rsef899/12_Cypress_LineFollowingRobot/Robert/Hardware_Task1.cydsn/Hardware_Task1_timing.html

# Static Timing Analysis

Project : | Hardware_Task1
Build Time : | 08/04/23 16:27:02
Device : | CY8C5888LTI-LP097
Temperature : | -40C - 85/125C
VDDA : | 5.00
VDDABUF : | 5.00
VDDD : | 5.00
VDDIO0 : | 5.00
VDDIO1 : | 5.00
VDDIO2 : | 5.00
VDDIO3 : | 5.00
VUSB : | 5.00
Voltage : | 5.0

Expand All | Collapse All | Show All Paths | Hide All Paths

+ Timing Violation Section

Note: If your design will only ever run at typical room temperatures, selecting the narrower temperature range in the system DWR for your application helps the tool to find timing-compliant routing solutions.

Violation | Source Clock | Destination Clock | Slack(ns)
Async
| ClockBlock/dclk_glb_ff_3 | ADC_IntClock

+ Clock Summary Section

Clock | Domain | Nominal Frequency | Required Frequency | Maximum Frequency | Violation
ADC_IntClock(routed) | ADC_IntClock(routed) | 2.857 MHz | 2.857 MHz | N/A
ClockBlock/dclk_glb_ff_2 | ClockBlock/dclk_glb_ff_2 | UNKNOWN | UNKNOWN | N/A
ClockBlock/dclk_glb_ff_3 | ClockBlock/dclk_glb_ff_3 | UNKNOWN | UNKNOWN | N/A
CyILO | CyILO | 100.000 kHz | 100.000 kHz | N/A
CyIMO | CyIMO | 24.000 MHz | 24.000 MHz | N/A
CyMASTER_CLK | CyMASTER_CLK | 60.000 MHz | 60.000 MHz | N/A
CyBUS_CLK | CyMASTER_CLK | 60.000 MHz | 60.000 MHz | 65.087 MHz
Clock_QENC | CyMASTER_CLK | 12.000 MHz | 12.000 MHz | 30.466 MHz
ADC_IntClock | CyMASTER_CLK | 2.857 MHz | 2.857 MHz | 24.925 MHz
Clock_PWM | CyMASTER_CLK | 1.000 MHz | 1.000 MHz | N/A
UART_IntClock | CyMASTER_CLK | 461.538 kHz | 461.538 kHz | 52.260 MHz
Clock2 | CyMASTER_CLK | 500.000 kHz | 500.000 kHz | N/A
CyPLL_OUT | CyPLL_OUT | 60.000 MHz | 60.000 MHz | N/A

+ Register to Register Section

+ Setup Subsection

+ Source Clock : ADC_IntClock : Positive edge(Required Frequency 2.85714 MHz)

+ Destination Clock : ADC_IntClock : Positive edge(Required Frequency 2.85714 MHz)

Path Delay Requirement : 350ns(2.85714 MHz)

Source | Destination | FMax | Delay (ns) | Slack (ns) | Violation
\ADC:AMuxHw_2_Decoder_old_id_0\/q | \ADC:AMuxHw_2_Decoder_one_hot_7\/main_0 | 24.925 MHz | 40.121 | 309.879

Type | Location | Fanout | Instance/Net | Source | Dest | Delay (ns)
macrocell74 | U(1,5) | 1 | \ADC:AMuxHw_2_Decoder_old_id_0\ | \ADC:AMuxHw_2_Decoder_old_id_0\/clock_0 | \ADC:AMuxHw_2_Decoder_old_id_0\/q | 1.250
Route | | 1 | \ADC:AMuxHw_2_Decoder_old_id_0\ | \ADC:AMuxHw_2_Decoder_old_id_0\/q | \ADC:AMuxHw_2_Decoder_is_active_split\/main_10 | 10.051
macrocell46 | U(1,1) | 1 | \ADC:AMuxHw_2_Decoder_is_active_split\ | \ADC:AMuxHw_2_Decoder_is_active_split\/main_10 | \ADC:AMuxHw_2_Decoder_is_active_split\/q | 3.350
Route | | 1 | \ADC:AMuxHw_2_Decoder_is_active_split\ | \ADC:AMuxHw_2_Decoder_is_active_split\/q | \ADC:AMuxHw_2_Decoder_is_active\/main_8 | 4.399
macrocell18 | U(1,4) | 1 | \ADC:AMuxHw_2_Decoder_is_active\ | \ADC:AMuxHw_2_Decoder_is_active\/main_8 | \ADC:AMuxHw_2_Decoder_is_active\/q | 3.350
Route | | 1 | \ADC:AMuxHw_2_Decoder_is_active\ | \ADC:AMuxHw_2_Decoder_is_active\/q | \ADC:AMuxHw_2_Decoder_one_hot_7\/main_0 | 14.211
macrocell82 | U(3,1) | 1 | \ADC:AMuxHw_2_Decoder_one_hot_7\ | | SETUP | 3.510
Clock | | | | | Skew | 0.000
\ADC:AMuxHw_2_Decoder_old_id_0\/q | \ADC:AMuxHw_2_Decoder_one_hot_17\/main_0 | 24.925 MHz | 40.121 | 309.879

Type | Location | Fanout | Instance/Net | Source | Dest | Delay (ns)
macrocell74 | U(1,5) | 1 | \ADC:AMuxHw_2_Decoder_old_id_0\ | \ADC:AMuxHw_2_Decoder_old_id_0\/clock_0 | \ADC:AMuxHw_2_Decoder_old_id_0\/q | 1.250
Route | | 1 | \ADC:AMuxHw_2_Decoder_old_id_0\ | \ADC:AMuxHw_2_Decoder_old_id_0\/q | \ADC:AMuxHw_2_Decoder_is_active_split\/main_10 | 10.051
macrocell46 | U(1,1) | 1 | \ADC:AMuxHw_2_Decoder_is_active_split\ | \ADC:AMuxHw_2_Decoder_is_active_split\/main_10 | \ADC:AMuxHw_2_Decoder_is_active_split\/q | 3.350
Route | | 1 | \ADC:AMuxHw_2_Decoder_is_active_split\ | \ADC:AMuxHw_2_Decoder_is_active_split\/q | \ADC:AMuxHw_2_Decoder_is_active\/main_8 | 4.399
macrocell18 | U(1,4) | 1 | \ADC:AMuxHw_2_Decoder_is_active\ | \ADC:AMuxHw_2_Decoder_is_active\/main_8 | \ADC:AMuxHw_2_Decoder_is_active\/q | 3.350
Route | | 1 | \ADC:AMuxHw_2_Decoder_is_active\ | \ADC:AMuxHw_2_Decoder_is_active\/q | \ADC:AMuxHw_2_Decoder_one_hot_17\/main_0 | 14.211
macrocell92 | U(3,1) | 1 | \ADC:AMuxHw_2_Decoder_one_hot_17\ | | SETUP | 3.510
Clock | | | | | Skew | 0.000
\ADC:AMuxHw_2_Decoder_old_id_0\/q | \ADC:AMuxHw_2_Decoder_one_hot_32\/main_0 | 24.925 MHz | 40.121 | 309.879

Type | Location | Fanout | Instance/Net | Source | Dest | Delay (ns)
macrocell74 | U(1,5) | 1 | \ADC:AMuxHw_2_Decoder_old_id_0\ | \ADC:AMuxHw_2_Decoder_old_id_0\/clock_0 | \ADC:AMuxHw_2_Decoder_old_id_0\/q | 1.250
Route | | 1 | \ADC:AMuxHw_2_Decoder_old_id_0\ | \ADC:AMuxHw_2_Decoder_old_id_0\/q | \ADC:AMuxHw_2_Decoder_is_active_split\/main_10 | 10.051
macrocell46 | U(1,1) | 1 | \ADC:AMuxHw_2_Decoder_is_active_split\ | \ADC:AMuxHw_2_Decoder_is_active_split\/main_10 | \ADC:AMuxHw_2_Decoder_is_active_split\/q | 3.350
Route | | 1 | \ADC:AMuxHw_2_Decoder_is_active_split\ | \ADC:AMuxHw_2_Decoder_is_active_split\/q | \ADC:AMuxHw_2_Decoder_is_active\/main_8 | 4.399
macrocell18 | U(1,4) | 1 | \ADC:AMuxHw_2_Decoder_is_active\ | \ADC:AMuxHw_2_Decoder_is_active\/main_8 | \ADC:AMuxHw_2_Decoder_is_active\/q | 3.350
Route | | 1 | \ADC:AMuxHw_2_Decoder_is_active\ | \ADC:AMuxHw_2_Decoder_is_active\/q | \ADC:AMuxHw_2_Decoder_one_hot_32\/main_0 | 14.211
macrocell107 | U(3,1) | 1 | \ADC:AMuxHw_2_Decoder_one_hot_32\ | | SETUP | 3.510
Clock | | | | | Skew | 0.000
\ADC:AMuxHw_2_Decoder_old_id_0\/q | \ADC:AMuxHw_2_Decoder_one_hot_4\/main_0 | 24.936 MHz | 40.102 | 309.898

Type | Location | Fanout | Instance/Net | Source | Dest | Delay (ns)
macrocell74 | U(1,5) | 1 | \ADC:AMuxHw_2_Decoder_old_id_0\ | \ADC:AMuxHw_2_Decoder_old_id_0\/clock_0 | \ADC:AMuxHw_2_Decoder_old_id_0\/q | 1.250
Route | | 1 | \ADC:AMuxHw_2_Decoder_old_id_0\ | \ADC:AMuxHw_2_Decoder_old_id_0\/q | \ADC:AMuxHw_2_Decoder_is_active_split\/main_10 | 10.051
macrocell46 | U(1,1) | 1 | \ADC:AMuxHw_2_Decoder_is_active_split\ | \ADC:AMuxHw_2_Decoder_is_active_split\/main_10 | \ADC:AMuxHw_2_Decoder_is_active_split\/q | 3.350
Route | | 1 | \ADC:AMuxHw_2_Decoder_is_active_split\ | \ADC:AMuxHw_2_Decoder_is_active_split\/q | \ADC:AMuxHw_2_Decoder_is_active\/main_8 | 4.399
macrocell18 | U(1,4) | 1 | \ADC:AMuxHw_2_Decoder_is_active\ | \ADC:AMuxHw_2_Decoder_is_active\/main_8 | \ADC:AMuxHw_2_Decoder_is_active\/q | 3.350
Route | | 1 | \ADC:AMuxHw_2_Decoder_is_active\ | \ADC:AMuxHw_2_Decoder_is_active\/q | \ADC:AMuxHw_2_Decoder_one_hot_4\/main_0 | 14.192
macrocell79 | U(3,1) | 1 | \ADC:AMuxHw_2_Decoder_one_hot_4\ | | SETUP | 3.510
Clock | | | | | Skew | 0.000
\ADC:AMuxHw_2_Decoder_old_id_0\/q | \ADC:AMuxHw_2_Decoder_one_hot_13\/main_0 | 24.936 MHz | 40.102 | 309.898

Type | Location | Fanout | Instance/Net | Source | Dest | Delay (ns)
macrocell74 | U(1,5) | 1 | \ADC:AMuxHw_2_Decoder_old_id_0\ | \ADC:AMuxHw_2_Decoder_old_id_0\/clock_0 | \ADC:AMuxHw_2_Decoder_old_id_0\/q | 1.250
Route | | 1 | \ADC:AMuxHw_2_Decoder_old_id_0\ | \ADC:AMuxHw_2_Decoder_old_id_0\/q | \ADC:AMuxHw_2_Decoder_is_active_split\/main_10 | 10.051
macrocell46 | U(1,1) | 1 | \ADC:AMuxHw_2_Decoder_is_active_split\ | \ADC:AMuxHw_2_Decoder_is_active_split\/main_10 | \ADC:AMuxHw_2_Decoder_is_active_split\/q | 3.350
Route | | 1 | \ADC:AMuxHw_2_Decoder_is_active_split\ | \ADC:AMuxHw_2_Decoder_is_active_split\/q | \ADC:AMuxHw_2_Decoder_is_active\/main_8 | 4.399
macrocell18 | U(1,4) | 1 | \ADC:AMuxHw_2_Decoder_is_active\ | \ADC:AMuxHw_2_Decoder_is_active\/main_8 | \ADC:AMuxHw_2_Decoder_is_active\/q | 3.350
Route | | 1 | \ADC:AMuxHw_2_Decoder_is_active\ | \ADC:AMuxHw_2_Decoder_is_active\/q | \ADC:AMuxHw_2_Decoder_one_hot_13\/main_0 | 14.192
macrocell88 | U(3,1) | 1 | \ADC:AMuxHw_2_Decoder_one_hot_13\ | | SETUP | 3.510
Clock | | | | | Skew | 0.000
\ADC:AMuxHw_2_Decoder_old_id_0\/q | \ADC:AMuxHw_2_Decoder_one_hot_28\/main_0 | 24.936 MHz | 40.102 | 309.898

Type | Location | Fanout | Instance/Net | Source | Dest | Delay (ns)
macrocell74 | U(1,5) | 1 | \ADC:AMuxHw_2_Decoder_old_id_0\ | \ADC:AMuxHw_2_Decoder_old_id_0\/clock_0 | \ADC:AMuxHw_2_Decoder_old_id_0\/q | 1.250
Route | | 1 | \ADC:AMuxHw_2_Decoder_old_id_0\ | \ADC:AMuxHw_2_Decoder_old_id_0\/q | \ADC:AMuxHw_2_Decoder_is_active_split\/main_10 | 10.051
macrocell46 | U(1,1) | 1 | \ADC:AMuxHw_2_Decoder_is_active_split\ | \ADC:AMuxHw_2_Decoder_is_active_split\/main_10 | \ADC:AMuxHw_2_Decoder_is_active_split\/q | 3.350
Route | | 1 | \ADC:AMuxHw_2_Decoder_is_active_split\ | \ADC:AMuxHw_2_Decoder_is_active_split\/q | \ADC:AMuxHw_2_Decoder_is_active\/main_8 | 4.399
macrocell18 | U(1,4) | 1 | \ADC:AMuxHw_2_Decoder_is_active\ | \ADC:AMuxHw_2_Decoder_is_active\/main_8 | \ADC:AMuxHw_2_Decoder_is_active\/q | 3.350
Route | | 1 | \ADC:AMuxHw_2_Decoder_is_active\ | \ADC:AMuxHw_2_Decoder_is_active\/q | \ADC:AMuxHw_2_Decoder_one_hot_28\/main_0 | 14.192
macrocell103 | U(3,1) | 1 | \ADC:AMuxHw_2_Decoder_one_hot_28\ | | SETUP | 3.510
Clock | | | | | Skew | 0.000
\ADC:AMuxHw_2_Decoder_old_id_0\/q | \ADC:AMuxHw_2_Decoder_one_hot_38\/main_0 | 24.936 MHz | 40.102 | 309.898

Type | Location | Fanout | Instance/Net | Source | Dest | Delay (ns)
macrocell74 | U(1,5) | 1 | \ADC:AMuxHw_2_Decoder_old_id_0\ | \ADC:AMuxHw_2_Decoder_old_id_0\/clock_0 | \ADC:AMuxHw_2_Decoder_old_id_0\/q | 1.250
Route | | 1 | \ADC:AMuxHw_2_Decoder_old_id_0\ | \ADC:AMuxHw_2_Decoder_old_id_0\/q | \ADC:AMuxHw_2_Decoder_is_active_split\/main_10 | 10.051
macrocell46 | U(1,1) | 1 | \ADC:AMuxHw_2_Decoder_is_active_split\ | \ADC:AMuxHw_2_Decoder_is_active_split\/main_10 | \ADC:AMuxHw_2_Decoder_is_active_split\/q | 3.350
Route | | 1 | \ADC:AMuxHw_2_Decoder_is_active_split\ | \ADC:AMuxHw_2_Decoder_is_active_split\/q | \ADC:AMuxHw_2_Decoder_is_active\/main_8 | 4.399
macrocell18 | U(1,4) | 1 | \ADC:AMuxHw_2_Decoder_is_active\ | \ADC:AMuxHw_2_Decoder_is_active\/main_8 | \ADC:AMuxHw_2_Decoder_is_active\/q | 3.350
Route | | 1 | \ADC:AMuxHw_2_Decoder_is_active\ | \ADC:AMuxHw_2_Decoder_is_active\/q | \ADC:AMuxHw_2_Decoder_one_hot_38\/main_0 | 14.192
macrocell113 | U(3,1) | 1 | \ADC:AMuxHw_2_Decoder_one_hot_38\ | | SETUP | 3.510
Clock | | | | | Skew | 0.000
\ADC:AMuxHw_2_Decoder_old_id_3\/q | \ADC:AMuxHw_2_Decoder_one_hot_7\/main_0 | 25.515 MHz | 39.193 | 310.807

Type | Location | Fanout | Instance/Net | Source | Dest | Delay (ns)
macrocell71 | U(1,4) | 1 | \ADC:AMuxHw_2_Decoder_old_id_3\ | \ADC:AMuxHw_2_Decoder_old_id_3\/clock_0 | \ADC:AMuxHw_2_Decoder_old_id_3\/q | 1.250
Route | | 1 | \ADC:AMuxHw_2_Decoder_old_id_3\ | \ADC:AMuxHw_2_Decoder_old_id_3\/q | \ADC:AMuxHw_2_Decoder_is_active_split\/main_4 | 9.123
macrocell46 | U(1,1) | 1 | \ADC:AMuxHw_2_Decoder_is_active_split\ | \ADC:AMuxHw_2_Decoder_is_active_split\/main_4 | \ADC:AMuxHw_2_Decoder_is_active_split\/q | 3.350
Route | | 1 | \ADC:AMuxHw_2_Decoder_is_active_split\ | \ADC:AMuxHw_2_Decoder_is_active_split\/q | \ADC:AMuxHw_2_Decoder_is_active\/main_8 | 4.399
macrocell18 | U(1,4) | 1 | \ADC:AMuxHw_2_Decoder_is_active\ | \ADC:AMuxHw_2_Decoder_is_active\/main_8 | \ADC:AMuxHw_2_Decoder_is_active\/q | 3.350
Route | | 1 | \ADC:AMuxHw_2_Decoder_is_active\ | \ADC:AMuxHw_2_Decoder_is_active\/q | \ADC:AMuxHw_2_Decoder_one_hot_7\/main_0 | 14.211
macrocell82 | U(3,1) | 1 | \ADC:AMuxHw_2_Decoder_one_hot_7\ | | SETUP | 3.510
Clock | | | | | Skew | 0.000
\ADC:AMuxHw_2_Decoder_old_id_3\/q | \ADC:AMuxHw_2_Decoder_one_hot_17\/main_0 | 25.515 MHz | 39.193 | 310.807

Type | Location | Fanout | Instance/Net | Source | Dest | Delay (ns)
macrocell71 | U(1,4) | 1 | \ADC:AMuxHw_2_Decoder_old_id_3\ | \ADC:AMuxHw_2_Decoder_old_id_3\/clock_0 | \ADC:AMuxHw_2_Decoder_old_id_3\/q | 1.250
Route | | 1 | \ADC:AMuxHw_2_Decoder_old_id_3\ | \ADC:AMuxHw_2_Decoder_old_id_3\/q | \ADC:AMuxHw_2_Decoder_is_active_split\/main_4 | 9.123
macrocell46 | U(1,1) | 1 | \ADC:AMuxHw_2_Decoder_is_active_split\ | \ADC:AMuxHw_2_Decoder_is_active_split\/main_4 | \ADC:AMuxHw_2_Decoder_is_active_split\/q | 3.350
Route | | 1 | \ADC:AMuxHw_2_Decoder_is_active_split\ | \ADC:AMuxHw_2_Decoder_is_active_split\/q | \ADC:AMuxHw_2_Decoder_is_active\/main_8 | 4.399
macrocell18 | U(1,4) | 1 | \ADC:AMuxHw_2_Decoder_is_active\ | \ADC:AMuxHw_2_Decoder_is_active\/main_8 | \ADC:AMuxHw_2_Decoder_is_active\/q | 3.350
Route | | 1 | \ADC:AMuxHw_2_Decoder_is_active\ | \ADC:AMuxHw_2_Decoder_is_active\/q | \ADC:AMuxHw_2_Decoder_one_hot_17\/main_0 | 14.211
macrocell92 | U(3,1) | 1 | \ADC:AMuxHw_2_Decoder_one_hot_17\ | | SETUP | 3.510
Clock | | | | | Skew | 0.000
\ADC:AMuxHw_2_Decoder_old_id_3\/q | \ADC:AMuxHw_2_Decoder_one_hot_32\/main_0 | 25.515 MHz | 39.193 | 310.807

Type | Location | Fanout | Instance/Net | Source | Dest | Delay (ns)
macrocell71 | U(1,4) | 1 | \ADC:AMuxHw_2_Decoder_old_id_3\ | \ADC:AMuxHw_2_Decoder_old_id_3\/clock_0 | \ADC:AMuxHw_2_Decoder_old_id_3\/q | 1.250
Route | | 1 | \ADC:AMuxHw_2_Decoder_old_id_3\ | \ADC:AMuxHw_2_Decoder_old_id_3\/q | \ADC:AMuxHw_2_Decoder_is_active_split\/main_4 | 9.123
macrocell46 | U(1,1) | 1 | \ADC:AMuxHw_2_Decoder_is_active_split\ | \ADC:AMuxHw_2_Decoder_is_active_split\/main_4 | \ADC:AMuxHw_2_Decoder_is_active_split\/q | 3.350
Route | | 1 | \ADC:AMuxHw_2_Decoder_is_active_split\ | \ADC:AMuxHw_2_Decoder_is_active_split\/q | \ADC:AMuxHw_2_Decoder_is_active\/main_8 | 4.399
macrocell18 | U(1,4) | 1 | \ADC:AMuxHw_2_Decoder_is_active\ | \ADC:AMuxHw_2_Decoder_is_active\/main_8 | \ADC:AMuxHw_2_Decoder_is_active\/q | 3.350
Route | | 1 | \ADC:AMuxHw_2_Decoder_is_active\ | \ADC:AMuxHw_2_Decoder_is_active\/q | \ADC:AMuxHw_2_Decoder_one_hot_32\/main_0 | 14.211
macrocell107 | U(3,1) | 1 | \ADC:AMuxHw_2_Decoder_one_hot_32\ | | SETUP | 3.510
Clock | | | | | Skew | 0.000

+ Destination Clock : CyBUS_CLK : Positive edge(Required Frequency 60 MHz)

Path Delay Requirement : 16.6667ns(60 MHz)

Affects clock : CyMASTER_CLK

Source | Destination | FMax | Delay (ns) | Slack (ns) | Violation
Net_1497/q | \ADC:bSAR_SEQ:bus_clk_nrq_reg\/main_2 | 126.088 MHz | 7.931 | 8.736

Type | Location | Fanout | Instance/Net | Source | Dest | Delay (ns)
macrocell139 | U(2,2) | 1 | Net_1497 | Net_1497/clock_0 | Net_1497/q | 1.250
Route | | 1 | Net_1497 | Net_1497/q | \ADC:bSAR_SEQ:bus_clk_nrq_reg\/main_2 | 3.171
macrocell140 | U(2,2) | 1 | \ADC:bSAR_SEQ:bus_clk_nrq_reg\ | | SETUP | 3.510
Clock | | | | | Skew | 0.000

+ Source Clock : Clock_QENC : Positive edge(Required Frequency 12 MHz)

+ Destination Clock : Clock_QENC : Positive edge(Required Frequency 12 MHz)

Path Delay Requirement : 83.3333ns(12 MHz)

Source | Destination | FMax | Delay (ns) | Slack (ns) | Violation
\QuadDec_M1:Cnt16:CounterUDB:sC16:counterdp:u0\/z0 | \QuadDec_M1:Cnt16:CounterUDB:sC16:counterdp:u1\/ci | 30.466 MHz | 32.824 | 50.509

Type | Location | Fanout | Instance/Net | Source | Dest | Delay (ns)
datapathcell1 | U(3,1) | 1 | \QuadDec_M1:Cnt16:CounterUDB:sC16:counterdp:u0\ | \QuadDec_M1:Cnt16:CounterUDB:sC16:counterdp:u0\/clock | \QuadDec_M1:Cnt16:CounterUDB:sC16:counterdp:u0\/z0 | 0.760
Route | | 1 | \QuadDec_M1:Cnt16:CounterUDB:sC16:counterdp:u0.z0__sig\ | \QuadDec_M1:Cnt16:CounterUDB:sC16:counterdp:u0\/z0 | \QuadDec_M1:Cnt16:CounterUDB:sC16:counterdp:u1\/z0i | 0.000
datapathcell2 | U(2,1) | 1 | \QuadDec_M1:Cnt16:CounterUDB:sC16:counterdp:u1\ | \QuadDec_M1:Cnt16:CounterUDB:sC16:counterdp:u1\/z0i | \QuadDec_M1:Cnt16:CounterUDB:sC16:counterdp:u1\/z0_comb | 2.740
Route | | 1 | \QuadDec_M1:Cnt16:CounterUDB:status_1\ | \QuadDec_M1:Cnt16:CounterUDB:sC16:counterdp:u1\/z0_comb | \QuadDec_M1:Cnt16:CounterUDB:reload\/main_1 | 8.972
macrocell2 | U(1,0) | 1 | \QuadDec_M1:Cnt16:CounterUDB:reload\ | \QuadDec_M1:Cnt16:CounterUDB:reload\/main_1 | \QuadDec_M1:Cnt16:CounterUDB:reload\/q | 3.350
Route | | 1 | \QuadDec_M1:Cnt16:CounterUDB:reload\ | \QuadDec_M1:Cnt16:CounterUDB:reload\/q | \QuadDec_M1:Cnt16:CounterUDB:sC16:counterdp:u0\/cs_addr_0 | 7.642
datapathcell1 | U(3,1) | 1 | \QuadDec_M1:Cnt16:CounterUDB:sC16:counterdp:u0\ | \QuadDec_M1:Cnt16:CounterUDB:sC16:counterdp:u0\/cs_addr_0 | \QuadDec_M1:Cnt16:CounterUDB:sC16:counterdp:u0\/co_msb | 5.130
Route | | 1 | \QuadDec_M1:Cnt16:CounterUDB:sC16:counterdp:u0.co_msb__sig\ | \QuadDec_M1:Cnt16:CounterUDB:sC16:counterdp:u0\/co_msb | \QuadDec_M1:Cnt16:CounterUDB:sC16:counterdp:u1\/ci | 0.000
datapathcell2 | U(2,1) | 1 | \QuadDec_M1:Cnt16:CounterUDB:sC16:counterdp:u1\ | | SETUP | 4.230
Clock | | | | | Skew | 0.000
\QuadDec_M1:Cnt16:CounterUDB:sC16:counterdp:u1\/z0_comb | \QuadDec_M1:Cnt16:CounterUDB:sC16:counterdp:u1\/ci | 31.632 MHz | 31.614 | 51.719

Type | Location | Fanout | Instance/Net | Source | Dest | Delay (ns)
datapathcell2 | U(2,1) | 1 | \QuadDec_M1:Cnt16:CounterUDB:sC16:counterdp:u1\ | \QuadDec_M1:Cnt16:CounterUDB:sC16:counterdp:u1\/clock | \QuadDec_M1:Cnt16:CounterUDB:sC16:counterdp:u1\/z0_comb | 2.290
Route | | 1 | \QuadDec_M1:Cnt16:CounterUDB:status_1\ | \QuadDec_M1:Cnt16:CounterUDB:sC16:counterdp:u1\/z0_comb | \QuadDec_M1:Cnt16:CounterUDB:reload\/main_1 | 8.972
macrocell2 | U(1,0) | 1 | \QuadDec_M1:Cnt16:CounterUDB:reload\ | \QuadDec_M1:Cnt16:CounterUDB:reload\/main_1 | \QuadDec_M1:Cnt16:CounterUDB:reload\/q | 3.350
Route | | 1 | \QuadDec_M1:Cnt16:CounterUDB:reload\ | \QuadDec_M1:Cnt16:CounterUDB:reload\/q | \QuadDec_M1:Cnt16:CounterUDB:sC16:counterdp:u0\/cs_addr_0 | 7.642
datapathcell1 | U(3,1) | 1 | \QuadDec_M1:Cnt16:CounterUDB:sC16:counterdp:u0\ | \QuadDec_M1:Cnt16:CounterUDB:sC16:counterdp:u0\/cs_addr_0 | \QuadDec_M1:Cnt16:CounterUDB:sC16:counterdp:u0\/co_msb | 5.130
Route | | 1 | \QuadDec_M1:Cnt16:CounterUDB:sC16:counterdp:u0.co_msb__sig\ | \QuadDec_M1:Cnt16:CounterUDB:sC16:counterdp:u0\/co_msb | \QuadDec_M1:Cnt16:CounterUDB:sC16:counterdp:u1\/ci | 0.000
datapathcell2 | U(2,1) | 1 | \QuadDec_M1:Cnt16:CounterUDB:sC16:counterdp:u1\ | | SETUP | 4.230
Clock | | | | | Skew | 0.000
\QuadDec_M1:Net_1260\/q | \QuadDec_M1:Cnt16:CounterUDB:sC16:counterdp:u1\/ci | 32.602 MHz | 30.673 | 52.660

Type | Location | Fanout | Instance/Net | Source | Dest | Delay (ns)
macrocell51 | U(2,0) | 1 | \QuadDec_M1:Net_1260\ | \QuadDec_M1:Net_1260\/clock_0 | \QuadDec_M1:Net_1260\/q | 1.250
Route | | 1 | \QuadDec_M1:Net_1260\ | \QuadDec_M1:Net_1260\/q | \QuadDec_M1:Cnt16:CounterUDB:reload\/main_0 | 9.071
macrocell2 | U(1,0) | 1 | \QuadDec_M1:Cnt16:CounterUDB:reload\ | \QuadDec_M1:Cnt16:CounterUDB:reload\/main_0 | \QuadDec_M1:Cnt16:CounterUDB:reload\/q | 3.350
Route | | 1 | \QuadDec_M1:Cnt16:CounterUDB:reload\ | \QuadDec_M1:Cnt16:CounterUDB:reload\/q | \QuadDec_M1:Cnt16:CounterUDB:sC16:counterdp:u0\/cs_addr_0 | 7.642
datapathcell1 | U(3,1) | 1 | \QuadDec_M1:Cnt16:CounterUDB:sC16:counterdp:u0\ | \QuadDec_M1:Cnt16:CounterUDB:sC16:counterdp:u0\/cs_addr_0 | \QuadDec_M1:Cnt16:CounterUDB:sC16:counterdp:u0\/co_msb | 5.130
Route | | 1 | \QuadDec_M1:Cnt16:CounterUDB:sC16:counterdp:u0.co_msb__sig\ | \QuadDec_M1:Cnt16:CounterUDB:sC16:counterdp:u0\/co_msb | \QuadDec_M1:Cnt16:CounterUDB:sC16:counterdp:u1\/ci | 0.000
datapathcell2 | U(2,1) | 1 | \QuadDec_M1:Cnt16:CounterUDB:sC16:counterdp:u1\ | | SETUP | 4.230
Clock | | | | | Skew | 0.000
\QuadDec_M1:Cnt16:CounterUDB:sC16:counterdp:u0\/ff0 | \QuadDec_M1:Cnt16:CounterUDB:sC16:counterdp:u1\/ci | 32.638 MHz | 30.639 | 52.694

Type | Location | Fanout | Instance/Net | Source | Dest | Delay (ns)
datapathcell1 | U(3,1) | 1 | \QuadDec_M1:Cnt16:CounterUDB:sC16:counterdp:u0\ | \QuadDec_M1:Cnt16:CounterUDB:sC16:counterdp:u0\/clock | \QuadDec_M1:Cnt16:CounterUDB:sC16:counterdp:u0\/ff0 | 0.670
Route | | 1 | \QuadDec_M1:Cnt16:CounterUDB:sC16:counterdp:u0.ff0__sig\ | \QuadDec_M1:Cnt16:CounterUDB:sC16:counterdp:u0\/ff0 | \QuadDec_M1:Cnt16:CounterUDB:sC16:counterdp:u1\/ff0i | 0.000
datapathcell2 | U(2,1) | 1 | \QuadDec_M1:Cnt16:CounterUDB:sC16:counterdp:u1\ | \QuadDec_M1:Cnt16:CounterUDB:sC16:counterdp:u1\/ff0i | \QuadDec_M1:Cnt16:CounterUDB:sC16:counterdp:u1\/f0_comb | 2.720
Route | | 1 | \QuadDec_M1:Cnt16:CounterUDB:overflow\ | \QuadDec_M1:Cnt16:CounterUDB:sC16:counterdp:u1\/f0_comb | \QuadDec_M1:Cnt16:CounterUDB:reload\/main_2 | 6.897
macrocell2 | U(1,0) | 1 | \QuadDec_M1:Cnt16:CounterUDB:reload\ | \QuadDec_M1:Cnt16:CounterUDB:reload\/main_2 | \QuadDec_M1:Cnt16:CounterUDB:reload\/q | 3.350
Route | | 1 | \QuadDec_M1:Cnt16:CounterUDB:reload\ | \QuadDec_M1:Cnt16:CounterUDB:reload\/q | \QuadDec_M1:Cnt16:CounterUDB:sC16:counterdp:u0\/cs_addr_0 | 7.642
datapathcell1 | U(3,1) | 1 | \QuadDec_M1:Cnt16:CounterUDB:sC16:counterdp:u0\ | \QuadDec_M1:Cnt16:CounterUDB:sC16:counterdp:u0\/cs_addr_0 | \QuadDec_M1:Cnt16:CounterUDB:sC16:counterdp:u0\/co_msb | 5.130
Route | | 1 | \QuadDec_M1:Cnt16:CounterUDB:sC16:counterdp:u0.co_msb__sig\ | \QuadDec_M1:Cnt16:CounterUDB:sC16:counterdp:u0\/co_msb | \QuadDec_M1:Cnt16:CounterUDB:sC16:counterdp:u1\/ci | 0.000
datapathcell2 | U(2,1) | 1 | \QuadDec_M1:Cnt16:CounterUDB:sC16:counterdp:u1\ | | SETUP | 4.230
Clock | | | | | Skew | 0.000
\QuadDec_M1:Cnt16:CounterUDB:sC16:counterdp:u0\/z0 | \QuadDec_M1:Cnt16:CounterUDB:sC16:counterdp:u1\/cs_addr_0 | 33.241 MHz | 30.083 | 53.250

Type | Location | Fanout | Instance/Net | Source | Dest | Delay (ns)
datapathcell1 | U(3,1) | 1 | \QuadDec_M1:Cnt16:CounterUDB:sC16:counterdp:u0\ | \QuadDec_M1:Cnt16:CounterUDB:sC16:counterdp:u0\/clock | \QuadDec_M1:Cnt16:CounterUDB:sC16:counterdp:u0\/z0 | 0.760
Route | | 1 | \QuadDec_M1:Cnt16:CounterUDB:sC16:counterdp:u0.z0__sig\ | \QuadDec_M1:Cnt16:CounterUDB:sC16:counterdp:u0\/z0 | \QuadDec_M1:Cnt16:CounterUDB:sC16:counterdp:u1\/z0i | 0.000
datapathcell2 | U(2,1) | 1 | \QuadDec_M1:Cnt16:CounterUDB:sC16:counterdp:u1\ | \QuadDec_M1:Cnt16:CounterUDB:sC16:counterdp:u1\/z0i | \QuadDec_M1:Cnt16:CounterUDB:sC16:counterdp:u1\/z0_comb | 2.740
Route | | 1 | \QuadDec_M1:Cnt16:CounterUDB:status_1\ | \QuadDec_M1:Cnt16:CounterUDB:sC16:counterdp:u1\/z0_comb | \QuadDec_M1:Cnt16:CounterUDB:reload\/main_1 | 8.972
macrocell2 | U(1,0) | 1 | \QuadDec_M1:Cnt16:CounterUDB:reload\ | \QuadDec_M1:Cnt16:CounterUDB:reload\/main_1 | \QuadDec_M1:Cnt16:CounterUDB:reload\/q | 3.350
Route | | 1 | \QuadDec_M1:Cnt16:CounterUDB:reload\ | \QuadDec_M1:Cnt16:CounterUDB:reload\/q | \QuadDec_M1:Cnt16:CounterUDB:sC16:counterdp:u1\/cs_addr_0 | 8.201
datapathcell2 | U(2,1) | 1 | \QuadDec_M1:Cnt16:CounterUDB:sC16:counterdp:u1\ | | SETUP | 6.060
Clock | | | | | Skew | 0.000
\QuadDec_M1:Cnt16:CounterUDB:sC16:counterdp:u0\/z0 | \QuadDec_M1:Cnt16:CounterUDB:sC16:counterdp:u0\/cs_addr_0 | 33.871 MHz | 29.524 | 53.809

Type | Location | Fanout | Instance/Net | Source | Dest | Delay (ns)
datapathcell1 | U(3,1) | 1 | \QuadDec_M1:Cnt16:CounterUDB:sC16:counterdp:u0\ | \QuadDec_M1:Cnt16:CounterUDB:sC16:counterdp:u0\/clock | \QuadDec_M1:Cnt16:CounterUDB:sC16:counterdp:u0\/z0 | 0.760
Route | | 1 | \QuadDec_M1:Cnt16:CounterUDB:sC16:counterdp:u0.z0__sig\ | \QuadDec_M1:Cnt16:CounterUDB:sC16:counterdp:u0\/z0 | \QuadDec_M1:Cnt16:CounterUDB:sC16:counterdp:u1\/z0i | 0.000
datapathcell2 | U(2,1) | 1 | \QuadDec_M1:Cnt16:CounterUDB:sC16:counterdp:u1\ | \QuadDec_M1:Cnt16:CounterUDB:sC16:counterdp:u1\/z0i | \QuadDec_M1:Cnt16:CounterUDB:sC16:counterdp:u1\/z0_comb | 2.740
Route | | 1 | \QuadDec_M1:Cnt16:CounterUDB:status_1\ | \QuadDec_M1:Cnt16:CounterUDB:sC16:counterdp:u1\/z0_comb | \QuadDec_M1:Cnt16:CounterUDB:reload\/main_1 | 8.972
macrocell2 | U(1,0) | 1 | \QuadDec_M1:Cnt16:CounterUDB:reload\ | \QuadDec_M1:Cnt16:CounterUDB:reload\/main_1 | \QuadDec_M1:Cnt16:CounterUDB:reload\/q | 3.350
Route | | 1 | \QuadDec_M1:Cnt16:CounterUDB:reload\ | \QuadDec_M1:Cnt16:CounterUDB:reload\/q | \QuadDec_M1:Cnt16:CounterUDB:sC16:counterdp:u0\/cs_addr_0 | 7.642
datapathcell1 | U(3,1) | 1 | \QuadDec_M1:Cnt16:CounterUDB:sC16:counterdp:u0\ | | SETUP | 6.060
Clock | | | | | Skew | 0.000
\QuadDec_M1:Cnt16:CounterUDB:sC16:counterdp:u1\/f0_comb | \QuadDec_M1:Cnt16:CounterUDB:sC16:counterdp:u1\/ci | 33.957 MHz | 29.449 | 53.884

Type | Location | Fanout | Instance/Net | Source | Dest | Delay (ns)
datapathcell2 | U(2,1) | 1 | \QuadDec_M1:Cnt16:CounterUDB:sC16:counterdp:u1\ | \QuadDec_M1:Cnt16:CounterUDB:sC16:counterdp:u1\/clock | \QuadDec_M1:Cnt16:CounterUDB:sC16:counterdp:u1\/f0_comb | 2.200
Route | | 1 | \QuadDec_M1:Cnt16:CounterUDB:overflow\ | \QuadDec_M1:Cnt16:CounterUDB:sC16:counterdp:u1\/f0_comb | \QuadDec_M1:Cnt16:CounterUDB:reload\/main_2 | 6.897
macrocell2 | U(1,0) | 1 | \QuadDec_M1:Cnt16:CounterUDB:reload\ | \QuadDec_M1:Cnt16:CounterUDB:reload\/main_2 | \QuadDec_M1:Cnt16:CounterUDB:reload\/q | 3.350
Route | | 1 | \QuadDec_M1:Cnt16:CounterUDB:reload\ | \QuadDec_M1:Cnt16:CounterUDB:reload\/q | \QuadDec_M1:Cnt16:CounterUDB:sC16:counterdp:u0\/cs_addr_0 | 7.642
datapathcell1 | U(3,1) | 1 | \QuadDec_M1:Cnt16:CounterUDB:sC16:counterdp:u0\ | \QuadDec_M1:Cnt16:CounterUDB:sC16:counterdp:u0\/cs_addr_0 | \QuadDec_M1:Cnt16:CounterUDB:sC16:counterdp:u0\/co_msb | 5.130
Route | | 1 | \QuadDec_M1:Cnt16:CounterUDB:sC16:counterdp:u0.co_msb__sig\ | \QuadDec_M1:Cnt16:CounterUDB:sC16:counterdp:u0\/co_msb | \QuadDec_M1:Cnt16:CounterUDB:sC16:counterdp:u1\/ci | 0.000
datapathcell2 | U(2,1) | 1 | \QuadDec_M1:Cnt16:CounterUDB:sC16:counterdp:u1\ | | SETUP | 4.230
Clock | | | | | Skew | 0.000
\QuadDec_M1:Cnt16:CounterUDB:sC16:counterdp:u1\/z0_comb | \QuadDec_M1:Cnt16:CounterUDB:sC16:counterdp:u1\/cs_addr_0 | 34.634 MHz | 28.873 | 54.460

Type | Location | Fanout | Instance/Net | Source | Dest | Delay (ns)
datapathcell2 | U(2,1) | 1 | \QuadDec_M1:Cnt16:CounterUDB:sC16:counterdp:u1\ | \QuadDec_M1:Cnt16:CounterUDB:sC16:counterdp:u1\/clock | \QuadDec_M1:Cnt16:CounterUDB:sC16:counterdp:u1\/z0_comb | 2.290
Route | | 1 | \QuadDec_M1:Cnt16:CounterUDB:status_1\ | \QuadDec_M1:Cnt16:CounterUDB:sC16:counterdp:u1\/z0_comb | \QuadDec_M1:Cnt16:CounterUDB:reload\/main_1 | 8.972
macrocell2 | U(1,0) | 1 | \QuadDec_M1:Cnt16:CounterUDB:reload\ | \QuadDec_M1:Cnt16:CounterUDB:reload\/main_1 | \QuadDec_M1:Cnt16:CounterUDB:reload\/q | 3.350
Route | | 1 | \QuadDec_M1:Cnt16:CounterUDB:reload\ | \QuadDec_M1:Cnt16:CounterUDB:reload\/q | \QuadDec_M1:Cnt16:CounterUDB:sC16:counterdp:u1\/cs_addr_0 | 8.201
datapathcell2 | U(2,1) | 1 | \QuadDec_M1:Cnt16:CounterUDB:sC16:counterdp:u1\ | | SETUP | 6.060
Clock | | | | | Skew | 0.000
\QuadDec_M1:Cnt16:CounterUDB:sC16:counterdp:u1\/z0_comb | \QuadDec_M1:Cnt16:CounterUDB:sC16:counterdp:u0\/cs_addr_0 | 35.318 MHz | 28.314 | 55.019

Type | Location | Fanout | Instance/Net | Source | Dest | Delay (ns)
datapathcell2 | U(2,1) | 1 | \QuadDec_M1:Cnt16:CounterUDB:sC16:counterdp:u1\ | \QuadDec_M1:Cnt16:CounterUDB:sC16:counterdp:u1\/clock | \QuadDec_M1:Cnt16:CounterUDB:sC16:counterdp:u1\/z0_comb | 2.290
Route | | 1 | \QuadDec_M1:Cnt16:CounterUDB:status_1\ | \QuadDec_M1:Cnt16:CounterUDB:sC16:counterdp:u1\/z0_comb | \QuadDec_M1:Cnt16:CounterUDB:reload\/main_1 | 8.972
macrocell2 | U(1,0) | 1 | \QuadDec_M1:Cnt16:CounterUDB:reload\ | \QuadDec_M1:Cnt16:CounterUDB:reload\/main_1 | \QuadDec_M1:Cnt16:CounterUDB:reload\/q | 3.350
Route | | 1 | \QuadDec_M1:Cnt16:CounterUDB:reload\ | \QuadDec_M1:Cnt16:CounterUDB:reload\/q | \QuadDec_M1:Cnt16:CounterUDB:sC16:counterdp:u0\/cs_addr_0 | 7.642
datapathcell1 | U(3,1) | 1 | \QuadDec_M1:Cnt16:CounterUDB:sC16:counterdp:u0\ | | SETUP | 6.060
Clock | | | | | Skew | 0.000
\QuadDec_M1:Net_1260\/q | \QuadDec_M1:Cnt16:CounterUDB:sC16:counterdp:u1\/cs_addr_0 | 35.801 MHz | 27.932 | 55.401

Type | Location | Fanout | Instance/Net | Source | Dest | Delay (ns)
macrocell51 | U(2,0) | 1 | \QuadDec_M1:Net_1260\ | \QuadDec_M1:Net_1260\/clock_0 | \QuadDec_M1:Net_1260\/q | 1.250
Route | | 1 | \QuadDec_M1:Net_1260\ | \QuadDec_M1:Net_1260\/q | \QuadDec_M1:Cnt16:CounterUDB:reload\/main_0 | 9.071
macrocell2 | U(1,0) | 1 | \QuadDec_M1:Cnt16:CounterUDB:reload\ | \QuadDec_M1:Cnt16:CounterUDB:reload\/main_0 | \QuadDec_M1:Cnt16:CounterUDB:reload\/q | 3.350
Route | | 1 | \QuadDec_M1:Cnt16:CounterUDB:reload\ | \QuadDec_M1:Cnt16:CounterUDB:reload\/q | \QuadDec_M1:Cnt16:CounterUDB:sC16:counterdp:u1\/cs_addr_0 | 8.201
datapathcell2 | U(2,1) | 1 | \QuadDec_M1:Cnt16:CounterUDB:sC16:counterdp:u1\ | | SETUP | 6.060
Clock | | | | | Skew | 0.000

+ Source Clock : CyBUS_CLK : Positive edge(Required Frequency 60 MHz)

+ Destination Clock : ADC_IntClock : Positive edge(Required Frequency 2.85714 MHz)

Path Delay Requirement : 16.6667ns(60 MHz)

Affects clock : CyMASTER_CLK

Source | Destination | FMax | Delay (ns) | Slack (ns) | Violation
\ADC:bSAR_SEQ:bus_clk_nrq_reg\/q | Net_1497/main_0 | 135.630 MHz | 7.373 | 9.294

Type | Location | Fanout | Instance/Net | Source | Dest | Delay (ns)
macrocell140 | U(2,2) | 1 | \ADC:bSAR_SEQ:bus_clk_nrq_reg\ | \ADC:bSAR_SEQ:bus_clk_nrq_reg\/clock_0 | \ADC:bSAR_SEQ:bus_clk_nrq_reg\/q | 1.250
Route | | 1 | \ADC:bSAR_SEQ:bus_clk_nrq_reg\ | \ADC:bSAR_SEQ:bus_clk_nrq_reg\/q | Net_1497/main_0 | 2.613
macrocell139 | U(2,2) | 1 | Net_1497 | | SETUP | 3.510
Clock | | | | | Skew | 0.000
\ADC:bSAR_SEQ:bus_clk_nrq_reg\/q | \ADC:bSAR_SEQ:nrq_reg\/main_0 | 135.630 MHz | 7.373 | 9.294

Type | Location | Fanout | Instance/Net | Source | Dest | Delay (ns)
macrocell140 | U(2,2) | 1 | \ADC:bSAR_SEQ:bus_clk_nrq_reg\ | \ADC:bSAR_SEQ:bus_clk_nrq_reg\/clock_0 | \ADC:bSAR_SEQ:bus_clk_nrq_reg\/q | 1.250
Route | | 1 | \ADC:bSAR_SEQ:bus_clk_nrq_reg\ | \ADC:bSAR_SEQ:bus_clk_nrq_reg\/q | \ADC:bSAR_SEQ:nrq_reg\/main_0 | 2.613
macrocell141 | U(2,2) | 1 | \ADC:bSAR_SEQ:nrq_reg\ | | SETUP | 3.510
Clock | | | | | Skew | 0.000

+ Destination Clock : Clock_QENC : Positive edge(Required Frequency 12 MHz)

Path Delay Requirement : 16.6667ns(60 MHz)

Affects clock : CyMASTER_CLK

Source | Destination | FMax | Delay (ns) | Slack (ns) | Violation
M2_QA(0)_SYNC/out | \QuadDec_M2:bQuadDec:quad_A_delayed_0\/main_0 | 146.071 MHz | 6.846 | 9.821

Type | Location | Fanout | Instance/Net | Source | Dest | Delay (ns)
synccell | U(3,3) | 1 | M2_QA(0)_SYNC | M2_QA(0)_SYNC/clock | M2_QA(0)_SYNC/out | 1.020
Route | | 1 | Net_729_SYNCOUT | M2_QA(0)_SYNC/out | \QuadDec_M2:bQuadDec:quad_A_delayed_0\/main_0 | 2.316
macrocell35 | U(3,3) | 1 | \QuadDec_M2:bQuadDec:quad_A_delayed_0\ | | SETUP | 3.510
Clock | | | | | Skew | 0.000
M2_QB(0)_SYNC/out | \QuadDec_M2:bQuadDec:quad_B_delayed_0\/main_0 | 146.263 MHz | 6.837 | 9.830

Type | Location | Fanout | Instance/Net | Source | Dest | Delay (ns)
synccell | U(0,1) | 1 | M2_QB(0)_SYNC | M2_QB(0)_SYNC/clock | M2_QB(0)_SYNC/out | 1.020
Route | | 1 | Net_730_SYNCOUT | M2_QB(0)_SYNC/out | \QuadDec_M2:bQuadDec:quad_B_delayed_0\/main_0 | 2.307
macrocell38 | U(0,1) | 1 | \QuadDec_M2:bQuadDec:quad_B_delayed_0\ | | SETUP | 3.510
Clock | | | | | Skew | 0.000
M1_QB(0)_SYNC/out | \QuadDec_M1:bQuadDec:quad_B_delayed_0\/main_0 | 146.263 MHz | 6.837 | 9.830

Type | Location | Fanout | Instance/Net | Source | Dest | Delay (ns)
synccell | U(3,3) | 1 | M1_QB(0)_SYNC | M1_QB(0)_SYNC/clock | M1_QB(0)_SYNC/out | 1.020
Route | | 1 | Net_725_SYNCOUT | M1_QB(0)_SYNC/out | \QuadDec_M1:bQuadDec:quad_B_delayed_0\/main_0 | 2.307
macrocell32 | U(3,3) | 1 | \QuadDec_M1:bQuadDec:quad_B_delayed_0\ | | SETUP | 3.510
Clock | | | | | Skew | 0.000
M1_QA(0)_SYNC/out | \QuadDec_M1:bQuadDec:quad_A_delayed_0\/main_0 | 147.667 MHz | 6.772 | 9.895

Type | Location | Fanout | Instance/Net | Source | Dest | Delay (ns)
synccell | U(0,0) | 1 | M1_QA(0)_SYNC | M1_QA(0)_SYNC/clock | M1_QA(0)_SYNC/out | 1.020
Route | | 1 | Net_724_SYNCOUT | M1_QA(0)_SYNC/out | \QuadDec_M1:bQuadDec:quad_A_delayed_0\/main_0 | 2.242
macrocell29 | U(1,0) | 1 | \QuadDec_M1:bQuadDec:quad_A_delayed_0\ | | SETUP | 3.510
Clock | | | | | Skew | 0.000

+ Destination Clock : CyBUS_CLK : Positive edge(Required Frequency 60 MHz)

Path Delay Requirement : 16.6667ns(60 MHz)

Source | Destination | FMax | Delay (ns) | Slack (ns) | Violation
\ADC:Sync:genblk1[0]:INST\/out | \ADC:bSAR_SEQ:bus_clk_nrq_reg\/main_1 | 92.790 MHz | 10.777 | 5.890

Type | Location | Fanout | Instance/Net | Source | Dest | Delay (ns)
synccell | U(1,2) | 1 | \ADC:Sync:genblk1[0]:INST\ | \ADC:Sync:genblk1[0]:INST\/clock | \ADC:Sync:genblk1[0]:INST\/out | 1.020
Route | | 1 | \ADC:Net_3935\ | \ADC:Sync:genblk1[0]:INST\/out | \ADC:bSAR_SEQ:bus_clk_nrq_reg\/main_1 | 6.247
macrocell140 | U(2,2) | 1 | \ADC:bSAR_SEQ:bus_clk_nrq_reg\ | | SETUP | 3.510
Clock | | | | | Skew | 0.000
\ADC:bSAR_SEQ:bus_clk_nrq_reg\/q | \ADC:bSAR_SEQ:bus_clk_nrq_reg\/main_0 | 135.667 MHz | 7.371 | 9.296

Type | Location | Fanout | Instance/Net | Source | Dest | Delay (ns)
macrocell140 | U(2,2) | 1 | \ADC:bSAR_SEQ:bus_clk_nrq_reg\ | \ADC:bSAR_SEQ:bus_clk_nrq_reg\/clock_0 | \ADC:bSAR_SEQ:bus_clk_nrq_reg\/q | 1.250
macrocell140 | U(2,2) | 1 | \ADC:bSAR_SEQ:bus_clk_nrq_reg\ | \ADC:bSAR_SEQ:bus_clk_nrq_reg\/q | \ADC:bSAR_SEQ:bus_clk_nrq_reg\/main_0 | 2.611
macrocell140 | U(2,2) | 1 | \ADC:bSAR_SEQ:bus_clk_nrq_reg\ | | SETUP | 3.510
Clock | | | | | Skew | 0.000

+ Destination Clock : UART_IntClock : Positive edge(Required Frequency 461.538 kHz)

Path Delay Requirement : 16.6667ns(60 MHz)

Affects clock : CyMASTER_CLK

Source | Destination | FMax | Delay (ns) | Slack (ns) | Violation
\RF_BT_SELECT:Sync:ctrl_reg\/control_0 | \UART:BUART:rx_state_0\/main_3 | 65.087 MHz | 15.364 | 1.303

Type | Location | Fanout | Instance/Net | Source | Dest | Delay (ns)
controlcell5 | U(0,2) | 1 | \RF_BT_SELECT:Sync:ctrl_reg\ | \RF_BT_SELECT:Sync:ctrl_reg\/busclk | \RF_BT_SELECT:Sync:ctrl_reg\/control_0 | 2.050
Route | | 1 | Net_3437 | \RF_BT_SELECT:Sync:ctrl_reg\/control_0 | \UART:BUART:rx_postpoll\/main_2 | 3.216
macrocell25 | U(0,3) | 1 | \UART:BUART:rx_postpoll\ | \UART:BUART:rx_postpoll\/main_2 | \UART:BUART:rx_postpoll\/q | 3.350
Route | | 1 | \UART:BUART:rx_postpoll\ | \UART:BUART:rx_postpoll\/q | \UART:BUART:rx_state_0\/main_3 | 3.238
macrocell153 | U(0,4) | 1 | \UART:BUART:rx_state_0\ | | SETUP | 3.510
Clock | | | | | Skew | 0.000
\RF_BT_SELECT:Sync:ctrl_reg\/control_0 | \UART:BUART:rx_status_3\/main_3 | 65.087 MHz | 15.364 | 1.303

Type | Location | Fanout | Instance/Net | Source | Dest | Delay (ns)
controlcell5 | U(0,2) | 1 | \RF_BT_SELECT:Sync:ctrl_reg\ | \RF_BT_SELECT:Sync:ctrl_reg\/busclk | \RF_BT_SELECT:Sync:ctrl_reg\/control_0 | 2.050
Route | | 1 | Net_3437 | \RF_BT_SELECT:Sync:ctrl_reg\/control_0 | \UART:BUART:rx_postpoll\/main_2 | 3.216
macrocell25 | U(0,3) | 1 | \UART:BUART:rx_postpoll\ | \UART:BUART:rx_postpoll\/main_2 | \UART:BUART:rx_postpoll\/q | 3.350
Route | | 1 | \UART:BUART:rx_postpoll\ | \UART:BUART:rx_postpoll\/q | \UART:BUART:rx_status_3\/main_3 | 3.238
macrocell162 | U(0,4) | 1 | \UART:BUART:rx_status_3\ | | SETUP | 3.510
Clock | | | | | Skew | 0.000
\RF_BT_SELECT:Sync:ctrl_reg\/control_0 | \UART:BUART:sRX:RxShifter:u0\/route_si | 65.240 MHz | 15.328 | 1.339

Type | Location | Fanout | Instance/Net | Source | Dest | Delay (ns)
controlcell5 | U(0,2) | 1 | \RF_BT_SELECT:Sync:ctrl_reg\ | \RF_BT_SELECT:Sync:ctrl_reg\/busclk | \RF_BT_SELECT:Sync:ctrl_reg\/control_0 | 2.050
Route | | 1 | Net_3437 | \RF_BT_SELECT:Sync:ctrl_reg\/control_0 | \UART:BUART:rx_postpoll\/main_2 | 3.216
macrocell25 | U(0,3) | 1 | \UART:BUART:rx_postpoll\ | \UART:BUART:rx_postpoll\/main_2 | \UART:BUART:rx_postpoll\/q | 3.350
Route | | 1 | \UART:BUART:rx_postpoll\ | \UART:BUART:rx_postpoll\/q | \UART:BUART:sRX:RxShifter:u0\/route_si | 3.242
datapathcell7 | U(1,2) | 1 | \UART:BUART:sRX:RxShifter:u0\ | | SETUP | 3.470
Clock | | | | | Skew | 0.000
Rx_2(0)_SYNC/out | \UART:BUART:rx_state_0\/main_3 | 71.296 MHz | 14.026 | 2.641

Type | Location | Fanout | Instance/Net | Source | Dest | Delay (ns)
synccell | U(0,2) | 1 | Rx_2(0)_SYNC | Rx_2(0)_SYNC/clock | Rx_2(0)_SYNC/out | 1.020
Route | | 1 | Net_3405_SYNCOUT | Rx_2(0)_SYNC/out | \UART:BUART:rx_postpoll\/main_4 | 2.908
macrocell25 | U(0,3) | 1 | \UART:BUART:rx_postpoll\ | \UART:BUART:rx_postpoll\/main_4 | \UART:BUART:rx_postpoll\/q | 3.350
Route | | 1 | \UART:BUART:rx_postpoll\ | \UART:BUART:rx_postpoll\/q | \UART:BUART:rx_state_0\/main_3 | 3.238
macrocell153 | U(0,4) | 1 | \UART:BUART:rx_state_0\ | | SETUP | 3.510
Clock | | | | | Skew | 0.000
Rx_2(0)_SYNC/out | \UART:BUART:rx_status_3\/main_3 | 71.296 MHz | 14.026 | 2.641

Type | Location | Fanout | Instance/Net | Source | Dest | Delay (ns)
synccell | U(0,2) | 1 | Rx_2(0)_SYNC | Rx_2(0)_SYNC/clock | Rx_2(0)_SYNC/out | 1.020
Route | | 1 | Net_3405_SYNCOUT | Rx_2(0)_SYNC/out | \UART:BUART:rx_postpoll\/main_4 | 2.908
macrocell25 | U(0,3) | 1 | \UART:BUART:rx_postpoll\ | \UART:BUART:rx_postpoll\/main_4 | \UART:BUART:rx_postpoll\/q | 3.350
Route | | 1 | \UART:BUART:rx_postpoll\ | \UART:BUART:rx_postpoll\/q | \UART:BUART:rx_status_3\/main_3 | 3.238
macrocell162 | U(0,4) | 1 | \UART:BUART:rx_status_3\ | | SETUP | 3.510
Clock | | | | | Skew | 0.000
Rx_1(0)_SYNC/out | \UART:BUART:rx_state_0\/main_3 | 71.383 MHz | 14.009 | 2.658

Type | Location | Fanout | Instance/Net | Source | Dest | Delay (ns)
synccell | U(0,2) | 1 | Rx_1(0)_SYNC | Rx_1(0)_SYNC/clock | Rx_1(0)_SYNC/out | 1.020
Route | | 1 | Net_3438_SYNCOUT | Rx_1(0)_SYNC/out | \UART:BUART:rx_postpoll\/main_3 | 2.891
macrocell25 | U(0,3) | 1 | \UART:BUART:rx_postpoll\ | \UART:BUART:rx_postpoll\/main_3 | \UART:BUART:rx_postpoll\/q | 3.350
Route | | 1 | \UART:BUART:rx_postpoll\ | \UART:BUART:rx_postpoll\/q | \UART:BUART:rx_state_0\/main_3 | 3.238
macrocell153 | U(0,4) | 1 | \UART:BUART:rx_state_0\ | | SETUP | 3.510
Clock | | | | | Skew | 0.000
Rx_1(0)_SYNC/out | \UART:BUART:rx_status_3\/main_3 | 71.383 MHz | 14.009 | 2.658

Type | Location | Fanout | Instance/Net | Source | Dest | Delay (ns)
synccell | U(0,2) | 1 | Rx_1(0)_SYNC | Rx_1(0)_SYNC/clock | Rx_1(0)_SYNC/out | 1.020
Route | | 1 | Net_3438_SYNCOUT | Rx_1(0)_SYNC/out | \UART:BUART:rx_postpoll\/main_3 | 2.891
macrocell25 | U(0,3) | 1 | \UART:BUART:rx_postpoll\ | \UART:BUART:rx_postpoll\/main_3 | \UART:BUART:rx_postpoll\/q | 3.350
Route | | 1 | \UART:BUART:rx_postpoll\ | \UART:BUART:rx_postpoll\/q | \UART:BUART:rx_status_3\/main_3 | 3.238
macrocell162 | U(0,4) | 1 | \UART:BUART:rx_status_3\ | | SETUP | 3.510
Clock | | | | | Skew | 0.000
Rx_2(0)_SYNC/out | \UART:BUART:sRX:RxShifter:u0\/route_si | 71.480 MHz | 13.990 | 2.677

Type | Location | Fanout | Instance/Net | Source | Dest | Delay (ns)
synccell | U(0,2) | 1 | Rx_2(0)_SYNC | Rx_2(0)_SYNC/clock | Rx_2(0)_SYNC/out | 1.020
Route | | 1 | Net_3405_SYNCOUT | Rx_2(0)_SYNC/out | \UART:BUART:rx_postpoll\/main_4 | 2.908
macrocell25 | U(0,3) | 1 | \UART:BUART:rx_postpoll\ | \UART:BUART:rx_postpoll\/main_4 | \UART:BUART:rx_postpoll\/q | 3.350
Route | | 1 | \UART:BUART:rx_postpoll\ | \UART:BUART:rx_postpoll\/q | \UART:BUART:sRX:RxShifter:u0\/route_si | 3.242
datapathcell7 | U(1,2) | 1 | \UART:BUART:sRX:RxShifter:u0\ | | SETUP | 3.470
Clock | | | | | Skew | 0.000
Rx_1(0)_SYNC/out | \UART:BUART:sRX:RxShifter:u0\/route_si | 71.567 MHz | 13.973 | 2.694

Type | Location | Fanout | Instance/Net | Source | Dest | Delay (ns)
synccell | U(0,2) | 1 | Rx_1(0)_SYNC | Rx_1(0)_SYNC/clock | Rx_1(0)_SYNC/out | 1.020
Route | | 1 | Net_3438_SYNCOUT | Rx_1(0)_SYNC/out | \UART:BUART:rx_postpoll\/main_3 | 2.891
macrocell25 | U(0,3) | 1 | \UART:BUART:rx_postpoll\ | \UART:BUART:rx_postpoll\/main_3 | \UART:BUART:rx_postpoll\/q | 3.350
Route | | 1 | \UART:BUART:rx_postpoll\ | \UART:BUART:rx_postpoll\/q | \UART:BUART:sRX:RxShifter:u0\/route_si | 3.242
datapathcell7 | U(1,2) | 1 | \UART:BUART:sRX:RxShifter:u0\ | | SETUP | 3.470
Clock | | | | | Skew | 0.000
Rx_1(0)_SYNC/out | \UART:BUART:rx_last\/main_1 | 88.191 MHz | 11.339 | 5.328

Type | Location | Fanout | Instance/Net | Source | Dest | Delay (ns)
synccell | U(0,2) | 1 | Rx_1(0)_SYNC | Rx_1(0)_SYNC/clock | Rx_1(0)_SYNC/out | 1.020
Route | | 1 | Net_3438_SYNCOUT | Rx_1(0)_SYNC/out | \UART:BUART:rx_last\/main_1 | 6.809
macrocell163 | U(0,4) | 1 | \UART:BUART:rx_last\ | | SETUP | 3.510
Clock | | | | | Skew | 0.000

+ Source Clock : UART_IntClock : Positive edge(Required Frequency 461.538 kHz)

+ Destination Clock : UART_IntClock : Positive edge(Required Frequency 461.538 kHz)

Path Delay Requirement : 2166.67ns(461.538 kHz)

Source | Destination | FMax | Delay (ns) | Slack (ns) | Violation
\UART:BUART:rx_load_fifo\/q | \UART:BUART:sRX:RxSts\/status_4 | 52.260 MHz | 19.135 | 2147.532

Type | Location | Fanout | Instance/Net | Source | Dest | Delay (ns)
macrocell154 | U(0,5) | 1 | \UART:BUART:rx_load_fifo\ | \UART:BUART:rx_load_fifo\/clock_0 | \UART:BUART:rx_load_fifo\/q | 1.250
Route | | 1 | \UART:BUART:rx_load_fifo\ | \UART:BUART:rx_load_fifo\/q | \UART:BUART:rx_status_4\/main_0 | 10.356
macrocell26 | U(2,2) | 1 | \UART:BUART:rx_status_4\ | \UART:BUART:rx_status_4\/main_0 | \UART:BUART:rx_status_4\/q | 3.350
Route | | 1 | \UART:BUART:rx_status_4\ | \UART:BUART:rx_status_4\/q | \UART:BUART:sRX:RxSts\/status_4 | 3.679
statusicell6 | U(3,4) | 1 | \UART:BUART:sRX:RxSts\ | | SETUP | 0.500
Clock | | | | | Skew | 0.000
\UART:BUART:tx_state_1\/q | \UART:BUART:sTX:sCLOCK:TxBitClkGen\/cs_addr_0 | 52.826 MHz | 18.930 | 2147.737

Type | Location | Fanout | Instance/Net | Source | Dest | Delay (ns)
macrocell148 | U(0,2) | 1 | \UART:BUART:tx_state_1\ | \UART:BUART:tx_state_1\/clock_0 | \UART:BUART:tx_state_1\/q | 1.250
Route | | 1 | \UART:BUART:tx_state_1\ | \UART:BUART:tx_state_1\/q | \UART:BUART:counter_load_not\/main_0 | 5.227
macrocell21 | U(0,3) | 1 | \UART:BUART:counter_load_not\ | \UART:BUART:counter_load_not\/main_0 | \UART:BUART:counter_load_not\/q | 3.350
Route | | 1 | \UART:BUART:counter_load_not\ | \UART:BUART:counter_load_not\/q | \UART:BUART:sTX:sCLOCK:TxBitClkGen\/cs_addr_0 | 2.913
datapathcell6 | U(0,2) | 1 | \UART:BUART:sTX:sCLOCK:TxBitClkGen\ | | SETUP | 6.190
Clock | | | | | Skew | 0.000
\UART:BUART:rx_load_fifo\/q | \UART:BUART:sRX:RxShifter:u0\/f0_load | 53.387 MHz | 18.731 | 2147.936

Type | Location | Fanout | Instance/Net | Source | Dest | Delay (ns)
macrocell154 | U(0,5) | 1 | \UART:BUART:rx_load_fifo\ | \UART:BUART:rx_load_fifo\/clock_0 | \UART:BUART:rx_load_fifo\/q | 1.250
Route | | 1 | \UART:BUART:rx_load_fifo\ | \UART:BUART:rx_load_fifo\/q | \UART:BUART:sRX:RxShifter:u0\/f0_load | 14.351
datapathcell7 | U(1,2) | 1 | \UART:BUART:sRX:RxShifter:u0\ | | SETUP | 3.130
Clock | | | | | Skew | 0.000
\UART:BUART:tx_state_2\/q | \UART:BUART:sTX:sCLOCK:TxBitClkGen\/cs_addr_0 | 56.139 MHz | 17.813 | 2148.854

Type | Location | Fanout | Instance/Net | Source | Dest | Delay (ns)
macrocell150 | U(0,2) | 1 | \UART:BUART:tx_state_2\ | \UART:BUART:tx_state_2\/clock_0 | \UART:BUART:tx_state_2\/q | 1.250
Route | | 1 | \UART:BUART:tx_state_2\ | \UART:BUART:tx_state_2\/q | \UART:BUART:counter_load_not\/main_3 | 4.110
macrocell21 | U(0,3) | 1 | \UART:BUART:counter_load_not\ | \UART:BUART:counter_load_not\/main_3 | \UART:BUART:counter_load_not\/q | 3.350
Route | | 1 | \UART:BUART:counter_load_not\ | \UART:BUART:counter_load_not\/q | \UART:BUART:sTX:sCLOCK:TxBitClkGen\/cs_addr_0 | 2.913
datapathcell6 | U(0,2) | 1 | \UART:BUART:sTX:sCLOCK:TxBitClkGen\ | | SETUP | 6.190
Clock | | | | | Skew | 0.000
\UART:BUART:sRX:RxShifter:u0\/f0_blk_stat_comb | \UART:BUART:sRX:RxSts\/status_4 | 57.710 MHz | 17.328 | 2149.339

Type | Location | Fanout | Instance/Net | Source | Dest | Delay (ns)
datapathcell7 | U(1,2) | 1 | \UART:BUART:sRX:RxShifter:u0\ | \UART:BUART:sRX:RxShifter:u0\/clock | \UART:BUART:sRX:RxShifter:u0\/f0_blk_stat_comb | 3.580
Route | | 1 | \UART:BUART:rx_fifofull\ | \UART:BUART:sRX:RxShifter:u0\/f0_blk_stat_comb | \UART:BUART:rx_status_4\/main_1 | 6.219
macrocell26 | U(2,2) | 1 | \UART:BUART:rx_status_4\ | \UART:BUART:rx_status_4\/main_1 | \UART:BUART:rx_status_4\/q | 3.350
Route | | 1 | \UART:BUART:rx_status_4\ | \UART:BUART:rx_status_4\/q | \UART:BUART:sRX:RxSts\/status_4 | 3.679
statusicell6 | U(3,4) | 1 | \UART:BUART:sRX:RxSts\ | | SETUP | 0.500
Clock | | | | | Skew | 0.000
\UART:BUART:tx_state_0\/q | \UART:BUART:sTX:sCLOCK:TxBitClkGen\/cs_addr_0 | 58.123 MHz | 17.205 | 2149.462

Type | Location | Fanout | Instance/Net | Source | Dest | Delay (ns)
macrocell149 | U(0,2) | 1 | \UART:BUART:tx_state_0\ | \UART:BUART:tx_state_0\/clock_0 | \UART:BUART:tx_state_0\/q | 1.250
Route | | 1 | \UART:BUART:tx_state_0\ | \UART:BUART:tx_state_0\/q | \UART:BUART:counter_load_not\/main_1 | 3.502
macrocell21 | U(0,3) | 1 | \UART:BUART:counter_load_not\ | \UART:BUART:counter_load_not\/main_1 | \UART:BUART:counter_load_not\/q | 3.350
Route | | 1 | \UART:BUART:counter_load_not\ | \UART:BUART:counter_load_not\/q | \UART:BUART:sTX:sCLOCK:TxBitClkGen\/cs_addr_0 | 2.913
datapathcell6 | U(0,2) | 1 | \UART:BUART:sTX:sCLOCK:TxBitClkGen\ | | SETUP | 6.190
Clock | | | | | Skew | 0.000
\UART:BUART:sTX:sCLOCK:TxBitClkGen\/ce0_reg | \UART:BUART:sTX:sCLOCK:TxBitClkGen\/cs_addr_0 | 59.168 MHz | 16.901 | 2149.766

Type | Location | Fanout | Instance/Net | Source | Dest | Delay (ns)
datapathcell6 | U(0,2) | 1 | \UART:BUART:sTX:sCLOCK:TxBitClkGen\ | \UART:BUART:sTX:sCLOCK:TxBitClkGen\/clock | \UART:BUART:sTX:sCLOCK:TxBitClkGen\/ce0_reg | 0.190
Route | | 1 | \UART:BUART:tx_bitclk_enable_pre\ | \UART:BUART:sTX:sCLOCK:TxBitClkGen\/ce0_reg | \UART:BUART:counter_load_not\/main_2 | 4.258
macrocell21 | U(0,3) | 1 | \UART:BUART:counter_load_not\ | \UART:BUART:counter_load_not\/main_2 | \UART:BUART:counter_load_not\/q | 3.350
Route | | 1 | \UART:BUART:counter_load_not\ | \UART:BUART:counter_load_not\/q | \UART:BUART:sTX:sCLOCK:TxBitClkGen\/cs_addr_0 | 2.913
datapathcell6 | U(0,2) | 1 | \UART:BUART:sTX:sCLOCK:TxBitClkGen\ | | SETUP | 6.190
Clock | | | | | Skew | 0.000
\UART:BUART:rx_state_2\/q | \UART:BUART:sRX:RxBitCounter\/load | 62.937 MHz | 15.889 | 2150.778

Type | Location | Fanout | Instance/Net | Source | Dest | Delay (ns)
macrocell156 | U(0,5) | 1 | \UART:BUART:rx_state_2\ | \UART:BUART:rx_state_2\/clock_0 | \UART:BUART:rx_state_2\/q | 1.250
Route | | 1 | \UART:BUART:rx_state_2\ | \UART:BUART:rx_state_2\/q | \UART:BUART:rx_counter_load\/main_3 | 3.613
macrocell24 | U(0,5) | 1 | \UART:BUART:rx_counter_load\ | \UART:BUART:rx_counter_load\/main_3 | \UART:BUART:rx_counter_load\/q | 3.350
Route | | 1 | \UART:BUART:rx_counter_load\ | \UART:BUART:rx_counter_load\/q | \UART:BUART:sRX:RxBitCounter\/load | 2.316
count7cell | U(0,5) | 1 | \UART:BUART:sRX:RxBitCounter\ | | SETUP | 5.360
Clock | | | | | Skew | 0.000
\UART:BUART:rx_state_0\/q | \UART:BUART:sRX:RxBitCounter\/load | 63.179 MHz | 15.828 | 2150.839

Type | Location | Fanout | Instance/Net | Source | Dest | Delay (ns)
macrocell153 | U(0,4) | 1 | \UART:BUART:rx_state_0\ | \UART:BUART:rx_state_0\/clock_0 | \UART:BUART:rx_state_0\/q | 1.250
Route | | 1 | \UART:BUART:rx_state_0\ | \UART:BUART:rx_state_0\/q | \UART:BUART:rx_counter_load\/main_1 | 3.552
macrocell24 | U(0,5) | 1 | \UART:BUART:rx_counter_load\ | \UART:BUART:rx_counter_load\/main_1 | \UART:BUART:rx_counter_load\/q | 3.350
Route | | 1 | \UART:BUART:rx_counter_load\ | \UART:BUART:rx_counter_load\/q | \UART:BUART:sRX:RxBitCounter\/load | 2.316
count7cell | U(0,5) | 1 | \UART:BUART:sRX:RxBitCounter\ | | SETUP | 5.360
Clock | | | | | Skew | 0.000
\UART:BUART:rx_bitclk_enable\/q | \UART:BUART:sRX:RxShifter:u0\/cs_addr_0 | 65.428 MHz | 15.284 | 2151.383

Type | Location | Fanout | Instance/Net | Source | Dest | Delay (ns)
macrocell157 | U(0,5) | 1 | \UART:BUART:rx_bitclk_enable\ | \UART:BUART:rx_bitclk_enable\/clock_0 | \UART:BUART:rx_bitclk_enable\/q | 1.250
Route | | 1 | \UART:BUART:rx_bitclk_enable\ | \UART:BUART:rx_bitclk_enable\/q | \UART:BUART:sRX:RxShifter:u0\/cs_addr_0 | 8.024
datapathcell7 | U(1,2) | 1 | \UART:BUART:sRX:RxShifter:u0\ | | SETUP | 6.010
Clock | | | | | Skew | 0.000

+ Hold Subsection

+ Source Clock : ADC_IntClock : Positive edge

+ Destination Clock : ADC_IntClock : Positive edge

Source | Destination | Slack (ns) | Violation
\ADC:bSAR_SEQ:ChannelCounter\/count_1 | \ADC:AMuxHw_2_Decoder_old_id_1\/main_0 | 3.425

Type | Location | Fanout | Instance/Net | Source | Dest | Delay (ns)
count7cell | U(1,1) | 1 | \ADC:bSAR_SEQ:ChannelCounter\ | \ADC:bSAR_SEQ:ChannelCounter\/clock | \ADC:bSAR_SEQ:ChannelCounter\/count_1 | 0.620
Route | | 1 | \ADC:ch_addr_1\ | \ADC:bSAR_SEQ:ChannelCounter\/count_1 | \ADC:AMuxHw_2_Decoder_old_id_1\/main_0 | 2.805
macrocell73 | U(1,1) | 1 | \ADC:AMuxHw_2_Decoder_old_id_1\ | | HOLD | 0.000
Clock | | | | | Skew | 0.000
\ADC:bSAR_SEQ:nrq_reg\/q | Net_1497/main_1 | 3.553

Type | Location | Fanout | Instance/Net | Source | Dest | Delay (ns)
macrocell141 | U(2,2) | 1 | \ADC:bSAR_SEQ:nrq_reg\ | \ADC:bSAR_SEQ:nrq_reg\/clock_0 | \ADC:bSAR_SEQ:nrq_reg\/q | 1.250
Route | | 1 | \ADC:bSAR_SEQ:nrq_reg\ | \ADC:bSAR_SEQ:nrq_reg\/q | Net_1497/main_1 | 2.303
macrocell139 | U(2,2) | 1 | Net_1497 | | HOLD | 0.000
Clock | | | | | Skew | 0.000
\ADC:bSAR_SEQ:soc_reg\/q | \ADC:bSAR_SEQ:soc_in\/main_0 | 3.554

Type | Location | Fanout | Instance/Net | Source | Dest | Delay (ns)
macrocell144 | U(2,1) | 1 | \ADC:bSAR_SEQ:soc_reg\ | \ADC:bSAR_SEQ:soc_reg\/clock_0 | \ADC:bSAR_SEQ:soc_reg\/q | 1.250
Route | | 1 | \ADC:bSAR_SEQ:soc_reg\ | \ADC:bSAR_SEQ:soc_reg\/q | \ADC:bSAR_SEQ:soc_in\/main_0 | 2.304
macrocell142 | U(2,1) | 1 | \ADC:bSAR_SEQ:soc_in\ | | HOLD | 0.000
Clock | | | | | Skew | 0.000
\ADC:bSAR_SEQ:state_1\/q | \ADC:soc_out\/main_4 | 3.561

Type | Location | Fanout | Instance/Net | Source | Dest | Delay (ns)
macrocell145 | U(2,1) | 1 | \ADC:bSAR_SEQ:state_1\ | \ADC:bSAR_SEQ:state_1\/clock_0 | \ADC:bSAR_SEQ:state_1\/q | 1.250
Route | | 1 | \ADC:bSAR_SEQ:state_1\ | \ADC:bSAR_SEQ:state_1\/q | \ADC:soc_out\/main_4 | 2.311
macrocell143 | U(2,1) | 1 | \ADC:soc_out\ | | HOLD | 0.000
Clock | | | | | Skew | 0.000
\ADC:bSAR_SEQ:state_1\/q | \ADC:bSAR_SEQ:state_1\/main_3 | 3.561

Type | Location | Fanout | Instance/Net | Source | Dest | Delay (ns)
macrocell145 | U(2,1) | 1 | \ADC:bSAR_SEQ:state_1\ | \ADC:bSAR_SEQ:state_1\/clock_0 | \ADC:bSAR_SEQ:state_1\/q | 1.250
macrocell145 | U(2,1) | 1 | \ADC:bSAR_SEQ:state_1\ | \ADC:bSAR_SEQ:state_1\/q | \ADC:bSAR_SEQ:state_1\/main_3 | 2.311
macrocell145 | U(2,1) | 1 | \ADC:bSAR_SEQ:state_1\ | | HOLD | 0.000
Clock | | | | | Skew | 0.000
\ADC:bSAR_SEQ:soc_in\/q | \ADC:soc_out\/main_3 | 3.571

Type | Location | Fanout | Instance/Net | Source | Dest | Delay (ns)
macrocell142 | U(2,1) | 1 | \ADC:bSAR_SEQ:soc_in\ | \ADC:bSAR_SEQ:soc_in\/clock_0 | \ADC:bSAR_SEQ:soc_in\/q | 1.250
Route | | 1 | \ADC:bSAR_SEQ:soc_in\ | \ADC:bSAR_SEQ:soc_in\/q | \ADC:soc_out\/main_3 | 2.321
macrocell143 | U(2,1) | 1 | \ADC:soc_out\ | | HOLD | 0.000
Clock | | | | | Skew | 0.000
\ADC:AMuxHw_2_Decoder_old_id_0\/q | \ADC:AMuxHw_2_Decoder_one_hot_1\/main_6 | 4.449

Type | Location | Fanout | Instance/Net | Source | Dest | Delay (ns)
macrocell74 | U(1,5) | 1 | \ADC:AMuxHw_2_Decoder_old_id_0\ | \ADC:AMuxHw_2_Decoder_old_id_0\/clock_0 | \ADC:AMuxHw_2_Decoder_old_id_0\/q | 1.250
Route | | 1 | \ADC:AMuxHw_2_Decoder_old_id_0\ | \ADC:AMuxHw_2_Decoder_old_id_0\/q | \ADC:AMuxHw_2_Decoder_one_hot_1\/main_6 | 3.199
macrocell76 | U(1,5) | 1 | \ADC:AMuxHw_2_Decoder_one_hot_1\ | | HOLD | 0.000
Clock | | | | | Skew | 0.000
\ADC:AMuxHw_2_Decoder_old_id_0\/q | \ADC:AMuxHw_2_Decoder_one_hot_19\/main_6 | 4.449

Type | Location | Fanout | Instance/Net | Source | Dest | Delay (ns)
macrocell74 | U(1,5) | 1 | \ADC:AMuxHw_2_Decoder_old_id_0\ | \ADC:AMuxHw_2_Decoder_old_id_0\/clock_0 | \ADC:AMuxHw_2_Decoder_old_id_0\/q | 1.250
Route | | 1 | \ADC:AMuxHw_2_Decoder_old_id_0\ | \ADC:AMuxHw_2_Decoder_old_id_0\/q | \ADC:AMuxHw_2_Decoder_one_hot_19\/main_6 | 3.199
macrocell94 | U(1,5) | 1 | \ADC:AMuxHw_2_Decoder_one_hot_19\ | | HOLD | 0.000
Clock | | | | | Skew | 0.000
\ADC:AMuxHw_2_Decoder_old_id_0\/q | \ADC:AMuxHw_2_Decoder_one_hot_27\/main_6 | 4.449

Type | Location | Fanout | Instance/Net | Source | Dest | Delay (ns)
macrocell74 | U(1,5) | 1 | \ADC:AMuxHw_2_Decoder_old_id_0\ | \ADC:AMuxHw_2_Decoder_old_id_0\/clock_0 | \ADC:AMuxHw_2_Decoder_old_id_0\/q | 1.250
Route | | 1 | \ADC:AMuxHw_2_Decoder_old_id_0\ | \ADC:AMuxHw_2_Decoder_old_id_0\/q | \ADC:AMuxHw_2_Decoder_one_hot_27\/main_6 | 3.199
macrocell102 | U(1,5) | 1 | \ADC:AMuxHw_2_Decoder_one_hot_27\ | | HOLD | 0.000
Clock | | | | | Skew | 0.000
\ADC:AMuxHw_2_Decoder_old_id_0\/q | \ADC:AMuxHw_2_Decoder_one_hot_57\/main_6 | 4.449

Type | Location | Fanout | Instance/Net | Source | Dest | Delay (ns)
macrocell74 | U(1,5) | 1 | \ADC:AMuxHw_2_Decoder_old_id_0\ | \ADC:AMuxHw_2_Decoder_old_id_0\/clock_0 | \ADC:AMuxHw_2_Decoder_old_id_0\/q | 1.250
Route | | 1 | \ADC:AMuxHw_2_Decoder_old_id_0\ | \ADC:AMuxHw_2_Decoder_old_id_0\/q | \ADC:AMuxHw_2_Decoder_one_hot_57\/main_6 | 3.199
macrocell132 | U(1,5) | 1 | \ADC:AMuxHw_2_Decoder_one_hot_57\ | | HOLD | 0.000
Clock | | | | | Skew | 0.000

+ Destination Clock : CyBUS_CLK : Positive edge

Source | Destination | Slack (ns) | Violation
Net_1497/q | \ADC:bSAR_SEQ:bus_clk_nrq_reg\/main_2 | 4.421

Type | Location | Fanout | Instance/Net | Source | Dest | Delay (ns)
macrocell139 | U(2,2) | 1 | Net_1497 | Net_1497/clock_0 | Net_1497/q | 1.250
Route | | 1 | Net_1497 | Net_1497/q | \ADC:bSAR_SEQ:bus_clk_nrq_reg\/main_2 | 3.171
macrocell140 | U(2,2) | 1 | \ADC:bSAR_SEQ:bus_clk_nrq_reg\ | | HOLD | 0.000
Clock | | | | | Skew | 0.000

+ Source Clock : Clock_QENC : Positive edge

+ Destination Clock : Clock_QENC : Positive edge

Source | Destination | Slack (ns) | Violation
\QuadDec_M1:Cnt16:CounterUDB:sC16:counterdp:u0\/co_msb | \QuadDec_M1:Cnt16:CounterUDB:sC16:counterdp:u1\/ci | 2.140

Type | Location | Fanout | Instance/Net | Source | Dest | Delay (ns)
datapathcell1 | U(3,1) | 1 | \QuadDec_M1:Cnt16:CounterUDB:sC16:counterdp:u0\ | \QuadDec_M1:Cnt16:CounterUDB:sC16:counterdp:u0\/clock | \QuadDec_M1:Cnt16:CounterUDB:sC16:counterdp:u0\/co_msb | 2.140
Route | | 1 | \QuadDec_M1:Cnt16:CounterUDB:sC16:counterdp:u0.co_msb__sig\ | \QuadDec_M1:Cnt16:CounterUDB:sC16:counterdp:u0\/co_msb | \QuadDec_M1:Cnt16:CounterUDB:sC16:counterdp:u1\/ci | 0.000
datapathcell2 | U(2,1) | 1 | \QuadDec_M1:Cnt16:CounterUDB:sC16:counterdp:u1\ | | HOLD | 0.000
Clock | | | | | Skew | 0.000
\QuadDec_M2:Cnt16:CounterUDB:sC16:counterdp:u0\/co_msb | \QuadDec_M2:Cnt16:CounterUDB:sC16:counterdp:u1\/ci | 2.140

Type | Location | Fanout | Instance/Net | Source | Dest | Delay (ns)
datapathcell3 | U(3,2) | 1 | \QuadDec_M2:Cnt16:CounterUDB:sC16:counterdp:u0\ | \QuadDec_M2:Cnt16:CounterUDB:sC16:counterdp:u0\/clock | \QuadDec_M2:Cnt16:CounterUDB:sC16:counterdp:u0\/co_msb | 2.140
Route | | 1 | \QuadDec_M2:Cnt16:CounterUDB:sC16:counterdp:u0.co_msb__sig\ | \QuadDec_M2:Cnt16:CounterUDB:sC16:counterdp:u0\/co_msb | \QuadDec_M2:Cnt16:CounterUDB:sC16:counterdp:u1\/ci | 0.000
datapathcell4 | U(2,2) | 1 | \QuadDec_M2:Cnt16:CounterUDB:sC16:counterdp:u1\ | | HOLD | 0.000
Clock | | | | | Skew | 0.000
\QuadDec_M2:bQuadDec:error\/q | \QuadDec_M2:bQuadDec:Stsreg\/status_3 | 3.480

Type | Location | Fanout | Instance/Net | Source | Dest | Delay (ns)
macrocell66 | U(2,4) | 1 | \QuadDec_M2:bQuadDec:error\ | \QuadDec_M2:bQuadDec:error\/clock_0 | \QuadDec_M2:bQuadDec:error\/q | 1.250
Route | | 1 | \QuadDec_M2:bQuadDec:error\ | \QuadDec_M2:bQuadDec:error\/q | \QuadDec_M2:bQuadDec:Stsreg\/status_3 | 4.230
statusicell4 | U(3,5) | 1 | \QuadDec_M2:bQuadDec:Stsreg\ | | HOLD | -2.000
Clock | | | | | Skew | 0.000
\QuadDec_M1:bQuadDec:quad_A_delayed_1\/q | \QuadDec_M1:bQuadDec:quad_A_delayed_2\/main_0 | 3.536

Type | Location | Fanout | Instance/Net | Source | Dest | Delay (ns)
macrocell30 | U(1,4) | 1 | \QuadDec_M1:bQuadDec:quad_A_delayed_1\ | \QuadDec_M1:bQuadDec:quad_A_delayed_1\/clock_0 | \QuadDec_M1:bQuadDec:quad_A_delayed_1\/q | 1.250
Route | | 1 | \QuadDec_M1:bQuadDec:quad_A_delayed_1\ | \QuadDec_M1:bQuadDec:quad_A_delayed_1\/q | \QuadDec_M1:bQuadDec:quad_A_delayed_2\/main_0 | 2.286
macrocell31 | U(1,4) | 1 | \QuadDec_M1:bQuadDec:quad_A_delayed_2\ | | HOLD | 0.000
Clock | | | | | Skew | 0.000
\QuadDec_M2:bQuadDec:quad_A_delayed_1\/q | \QuadDec_M2:bQuadDec:quad_A_delayed_2\/main_0 | 3.536

Type | Location | Fanout | Instance/Net | Source | Dest | Delay (ns)
macrocell36 | U(3,5) | 1 | \QuadDec_M2:bQuadDec:quad_A_delayed_1\ | \QuadDec_M2:bQuadDec:quad_A_delayed_1\/clock_0 | \QuadDec_M2:bQuadDec:quad_A_delayed_1\/q | 1.250
Route | | 1 | \QuadDec_M2:bQuadDec:quad_A_delayed_1\ | \QuadDec_M2:bQuadDec:quad_A_delayed_1\/q | \QuadDec_M2:bQuadDec:quad_A_delayed_2\/main_0 | 2.286
macrocell37 | U(3,5) | 1 | \QuadDec_M2:bQuadDec:quad_A_delayed_2\ | | HOLD | 0.000
Clock | | | | | Skew | 0.000
\QuadDec_M1:bQuadDec:quad_A_delayed_1\/q | \QuadDec_M1:bQuadDec:quad_A_filt\/main_1 | 3.536

Type | Location | Fanout | Instance/Net | Source | Dest | Delay (ns)
macrocell30 | U(1,4) | 1 | \QuadDec_M1:bQuadDec:quad_A_delayed_1\ | \QuadDec_M1:bQuadDec:quad_A_delayed_1\/clock_0 | \QuadDec_M1:bQuadDec:quad_A_delayed_1\/q | 1.250
Route | | 1 | \QuadDec_M1:bQuadDec:quad_A_delayed_1\ | \QuadDec_M1:bQuadDec:quad_A_delayed_1\/q | \QuadDec_M1:bQuadDec:quad_A_filt\/main_1 | 2.286
macrocell49 | U(1,4) | 1 | \QuadDec_M1:bQuadDec:quad_A_filt\ | | HOLD | 0.000
Clock | | | | | Skew | 0.000
\QuadDec_M2:bQuadDec:quad_A_delayed_1\/q | \QuadDec_M2:bQuadDec:quad_A_filt\/main_1 | 3.536

Type | Location | Fanout | Instance/Net | Source | Dest | Delay (ns)
macrocell36 | U(3,5) | 1 | \QuadDec_M2:bQuadDec:quad_A_delayed_1\ | \QuadDec_M2:bQuadDec:quad_A_delayed_1\/clock_0 | \QuadDec_M2:bQuadDec:quad_A_delayed_1\/q | 1.250
Route | | 1 | \QuadDec_M2:bQuadDec:quad_A_delayed_1\ | \QuadDec_M2:bQuadDec:quad_A_delayed_1\/q | \QuadDec_M2:bQuadDec:quad_A_filt\/main_1 | 2.286
macrocell63 | U(3,5) | 1 | \QuadDec_M2:bQuadDec:quad_A_filt\ | | HOLD | 0.000
Clock | | | | | Skew | 0.000
\QuadDec_M1:bQuadDec:quad_A_filt\/q | \QuadDec_M1:bQuadDec:quad_A_filt\/main_3 | 3.543

Type | Location | Fanout | Instance/Net | Source | Dest | Delay (ns)
macrocell49 | U(1,4) | 1 | \QuadDec_M1:bQuadDec:quad_A_filt\ | \QuadDec_M1:bQuadDec:quad_A_filt\/clock_0 | \QuadDec_M1:bQuadDec:quad_A_filt\/q | 1.250
macrocell49 | U(1,4) | 1 | \QuadDec_M1:bQuadDec:quad_A_filt\ | \QuadDec_M1:bQuadDec:quad_A_filt\/q | \QuadDec_M1:bQuadDec:quad_A_filt\/main_3 | 2.293
macrocell49 | U(1,4) | 1 | \QuadDec_M1:bQuadDec:quad_A_filt\ | | HOLD | 0.000
Clock | | | | | Skew | 0.000
\QuadDec_M1:bQuadDec:quad_A_delayed_2\/q | \QuadDec_M1:bQuadDec:quad_A_filt\/main_2 | 3.550

Type | Location | Fanout | Instance/Net | Source | Dest | Delay (ns)
macrocell31 | U(1,4) | 1 | \QuadDec_M1:bQuadDec:quad_A_delayed_2\ | \QuadDec_M1:bQuadDec:quad_A_delayed_2\/clock_0 | \QuadDec_M1:bQuadDec:quad_A_delayed_2\/q | 1.250
Route | | 1 | \QuadDec_M1:bQuadDec:quad_A_delayed_2\ | \QuadDec_M1:bQuadDec:quad_A_delayed_2\/q | \QuadDec_M1:bQuadDec:quad_A_filt\/main_2 | 2.300
macrocell49 | U(1,4) | 1 | \QuadDec_M1:bQuadDec:quad_A_filt\ | | HOLD | 0.000
Clock | | | | | Skew | 0.000
\QuadDec_M2:bQuadDec:quad_A_delayed_2\/q | \QuadDec_M2:bQuadDec:quad_A_filt\/main_2 | 3.550

Type | Location | Fanout | Instance/Net | Source | Dest | Delay (ns)
macrocell37 | U(3,5) | 1 | \QuadDec_M2:bQuadDec:quad_A_delayed_2\ | \QuadDec_M2:bQuadDec:quad_A_delayed_2\/clock_0 | \QuadDec_M2:bQuadDec:quad_A_delayed_2\/q | 1.250
Route | | 1 | \QuadDec_M2:bQuadDec:quad_A_delayed_2\ | \QuadDec_M2:bQuadDec:quad_A_delayed_2\/q | \QuadDec_M2:bQuadDec:quad_A_filt\/main_2 | 2.300
macrocell63 | U(3,5) | 1 | \QuadDec_M2:bQuadDec:quad_A_filt\ | | HOLD | 0.000
Clock | | | | | Skew | 0.000

+ Source Clock : CyBUS_CLK : Positive edge

+ Destination Clock : ADC_IntClock : Positive edge

Source | Destination | Slack (ns) | Violation
\ADC:bSAR_SEQ:bus_clk_nrq_reg\/q | Net_1497/main_0 | 3.863

Type | Location | Fanout | Instance/Net | Source | Dest | Delay (ns)
macrocell140 | U(2,2) | 1 | \ADC:bSAR_SEQ:bus_clk_nrq_reg\ | \ADC:bSAR_SEQ:bus_clk_nrq_reg\/clock_0 | \ADC:bSAR_SEQ:bus_clk_nrq_reg\/q | 1.250
Route | | 1 | \ADC:bSAR_SEQ:bus_clk_nrq_reg\ | \ADC:bSAR_SEQ:bus_clk_nrq_reg\/q | Net_1497/main_0 | 2.613
macrocell139 | U(2,2) | 1 | Net_1497 | | HOLD | 0.000
Clock | | | | | Skew | 0.000
\ADC:bSAR_SEQ:bus_clk_nrq_reg\/q | \ADC:bSAR_SEQ:nrq_reg\/main_0 | 3.863

Type | Location | Fanout | Instance/Net | Source | Dest | Delay (ns)
macrocell140 | U(2,2) | 1 | \ADC:bSAR_SEQ:bus_clk_nrq_reg\ | \ADC:bSAR_SEQ:bus_clk_nrq_reg\/clock_0 | \ADC:bSAR_SEQ:bus_clk_nrq_reg\/q | 1.250
Route | | 1 | \ADC:bSAR_SEQ:bus_clk_nrq_reg\ | \ADC:bSAR_SEQ:bus_clk_nrq_reg\/q | \ADC:bSAR_SEQ:nrq_reg\/main_0 | 2.613
macrocell141 | U(2,2) | 1 | \ADC:bSAR_SEQ:nrq_reg\ | | HOLD | 0.000
Clock | | | | | Skew | 0.000

+ Destination Clock : Clock_QENC : Positive edge

Source | Destination | Slack (ns) | Violation
M1_QA(0)_SYNC/out | \QuadDec_M1:bQuadDec:quad_A_delayed_0\/main_0 | 2.592

Type | Location | Fanout | Instance/Net | Source | Dest | Delay (ns)
synccell | U(0,0) | 1 | M1_QA(0)_SYNC | M1_QA(0)_SYNC/clock | M1_QA(0)_SYNC/out | 0.350
Route | | 1 | Net_724_SYNCOUT | M1_QA(0)_SYNC/out | \QuadDec_M1:bQuadDec:quad_A_delayed_0\/main_0 | 2.242
macrocell29 | U(1,0) | 1 | \QuadDec_M1:bQuadDec:quad_A_delayed_0\ | | HOLD | 0.000
Clock | | | | | Skew | 0.000
M2_QB(0)_SYNC/out | \QuadDec_M2:bQuadDec:quad_B_delayed_0\/main_0 | 2.657

Type | Location | Fanout | Instance/Net | Source | Dest | Delay (ns)
synccell | U(0,1) | 1 | M2_QB(0)_SYNC | M2_QB(0)_SYNC/clock | M2_QB(0)_SYNC/out | 0.350
Route | | 1 | Net_730_SYNCOUT | M2_QB(0)_SYNC/out | \QuadDec_M2:bQuadDec:quad_B_delayed_0\/main_0 | 2.307
macrocell38 | U(0,1) | 1 | \QuadDec_M2:bQuadDec:quad_B_delayed_0\ | | HOLD | 0.000
Clock | | | | | Skew | 0.000
M1_QB(0)_SYNC/out | \QuadDec_M1:bQuadDec:quad_B_delayed_0\/main_0 | 2.657

Type | Location | Fanout | Instance/Net | Source | Dest | Delay (ns)
synccell | U(3,3) | 1 | M1_QB(0)_SYNC | M1_QB(0)_SYNC/clock | M1_QB(0)_SYNC/out | 0.350
Route | | 1 | Net_725_SYNCOUT | M1_QB(0)_SYNC/out | \QuadDec_M1:bQuadDec:quad_B_delayed_0\/main_0 | 2.307
macrocell32 | U(3,3) | 1 | \QuadDec_M1:bQuadDec:quad_B_delayed_0\ | | HOLD | 0.000
Clock | | | | | Skew | 0.000
M2_QA(0)_SYNC/out | \QuadDec_M2:bQuadDec:quad_A_delayed_0\/main_0 | 2.666

Type | Location | Fanout | Instance/Net | Source | Dest | Delay (ns)
synccell | U(3,3) | 1 | M2_QA(0)_SYNC | M2_QA(0)_SYNC/clock | M2_QA(0)_SYNC/out | 0.350
Route | | 1 | Net_729_SYNCOUT | M2_QA(0)_SYNC/out | \QuadDec_M2:bQuadDec:quad_A_delayed_0\/main_0 | 2.316
macrocell35 | U(3,3) | 1 | \QuadDec_M2:bQuadDec:quad_A_delayed_0\ | | HOLD | 0.000
Clock | | | | | Skew | 0.000

+ Destination Clock : CyBUS_CLK : Positive edge

Source | Destination | Slack (ns) | Violation
\ADC:bSAR_SEQ:bus_clk_nrq_reg\/q | \ADC:bSAR_SEQ:bus_clk_nrq_reg\/main_0 | 3.861

Type | Location | Fanout | Instance/Net | Source | Dest | Delay (ns)
macrocell140 | U(2,2) | 1 | \ADC:bSAR_SEQ:bus_clk_nrq_reg\ | \ADC:bSAR_SEQ:bus_clk_nrq_reg\/clock_0 | \ADC:bSAR_SEQ:bus_clk_nrq_reg\/q | 1.250
macrocell140 | U(2,2) | 1 | \ADC:bSAR_SEQ:bus_clk_nrq_reg\ | \ADC:bSAR_SEQ:bus_clk_nrq_reg\/q | \ADC:bSAR_SEQ:bus_clk_nrq_reg\/main_0 | 2.611
macrocell140 | U(2,2) | 1 | \ADC:bSAR_SEQ:bus_clk_nrq_reg\ | | HOLD | 0.000
Clock | | | | | Skew | 0.000
\ADC:Sync:genblk1[0]:INST\/out | \ADC:bSAR_SEQ:bus_clk_nrq_reg\/main_1 | 6.597

Type | Location | Fanout | Instance/Net | Source | Dest | Delay (ns)
synccell | U(1,2) | 1 | \ADC:Sync:genblk1[0]:INST\ | \ADC:Sync:genblk1[0]:INST\/clock | \ADC:Sync:genblk1[0]:INST\/out | 0.350
Route | | 1 | \ADC:Net_3935\ | \ADC:Sync:genblk1[0]:INST\/out | \ADC:bSAR_SEQ:bus_clk_nrq_reg\/main_1 | 6.247
macrocell140 | U(2,2) | 1 | \ADC:bSAR_SEQ:bus_clk_nrq_reg\ | | HOLD | 0.000
Clock | | | | | Skew | 0.000

+ Destination Clock : UART_IntClock : Positive edge

Source | Destination | Slack (ns) | Violation
Rx_2(0)_SYNC/out | \UART:BUART:pollcount_1\/main_6 | 4.316

Type | Location | Fanout | Instance/Net | Source | Dest | Delay (ns)
synccell | U(0,2) | 1 | Rx_2(0)_SYNC | Rx_2(0)_SYNC/clock | Rx_2(0)_SYNC/out | 0.350
Route | | 1 | Net_3405_SYNCOUT | Rx_2(0)_SYNC/out | \UART:BUART:pollcount_1\/main_6 | 3.966
macrocell159 | U(0,4) | 1 | \UART:BUART:pollcount_1\ | | HOLD | 0.000
Clock | | | | | Skew | 0.000
Rx_2(0)_SYNC/out | \UART:BUART:pollcount_0\/main_5 | 4.316

Type | Location | Fanout | Instance/Net | Source | Dest | Delay (ns)
synccell | U(0,2) | 1 | Rx_2(0)_SYNC | Rx_2(0)_SYNC/clock | Rx_2(0)_SYNC/out | 0.350
Route | | 1 | Net_3405_SYNCOUT | Rx_2(0)_SYNC/out | \UART:BUART:pollcount_0\/main_5 | 3.966
macrocell160 | U(0,4) | 1 | \UART:BUART:pollcount_0\ | | HOLD | 0.000
Clock | | | | | Skew | 0.000
Rx_2(0)_SYNC/out | \UART:BUART:rx_last\/main_2 | 4.338

Type | Location | Fanout | Instance/Net | Source | Dest | Delay (ns)
synccell | U(0,2) | 1 | Rx_2(0)_SYNC | Rx_2(0)_SYNC/clock | Rx_2(0)_SYNC/out | 0.350
Route | | 1 | Net_3405_SYNCOUT | Rx_2(0)_SYNC/out | \UART:BUART:rx_last\/main_2 | 3.988
macrocell163 | U(0,4) | 1 | \UART:BUART:rx_last\ | | HOLD | 0.000
Clock | | | | | Skew | 0.000
\RF_BT_SELECT:Sync:ctrl_reg\/control_0 | \UART:BUART:rx_last\/main_0 | 4.595

Type | Location | Fanout | Instance/Net | Source | Dest | Delay (ns)
controlcell5 | U(0,2) | 1 | \RF_BT_SELECT:Sync:ctrl_reg\ | \RF_BT_SELECT:Sync:ctrl_reg\/busclk | \RF_BT_SELECT:Sync:ctrl_reg\/control_0 | 0.620
Route | | 1 | Net_3437 | \RF_BT_SELECT:Sync:ctrl_reg\/control_0 | \UART:BUART:rx_last\/main_0 | 3.975
macrocell163 | U(0,4) | 1 | \UART:BUART:rx_last\ | | HOLD | 0.000
Clock | | | | | Skew | 0.000
\RF_BT_SELECT:Sync:ctrl_reg\/control_0 | \UART:BUART:pollcount_1\/main_4 | 4.740

Type | Location | Fanout | Instance/Net | Source | Dest | Delay (ns)
controlcell5 | U(0,2) | 1 | \RF_BT_SELECT:Sync:ctrl_reg\ | \RF_BT_SELECT:Sync:ctrl_reg\/busclk | \RF_BT_SELECT:Sync:ctrl_reg\/control_0 | 0.620
Route | | 1 | Net_3437 | \RF_BT_SELECT:Sync:ctrl_reg\/control_0 | \UART:BUART:pollcount_1\/main_4 | 4.120
macrocell159 | U(0,4) | 1 | \UART:BUART:pollcount_1\ | | HOLD | 0.000
Clock | | | | | Skew | 0.000
\RF_BT_SELECT:Sync:ctrl_reg\/control_0 | \UART:BUART:pollcount_0\/main_3 | 4.740

Type | Location | Fanout | Instance/Net | Source | Dest | Delay (ns)
controlcell5 | U(0,2) | 1 | \RF_BT_SELECT:Sync:ctrl_reg\ | \RF_BT_SELECT:Sync:ctrl_reg\/busclk | \RF_BT_SELECT:Sync:ctrl_reg\/control_0 | 0.620
Route | | 1 | Net_3437 | \RF_BT_SELECT:Sync:ctrl_reg\/control_0 | \UART:BUART:pollcount_0\/main_3 | 4.120
macrocell160 | U(0,4) | 1 | \UART:BUART:pollcount_0\ | | HOLD | 0.000
Clock | | | | | Skew | 0.000
Rx_2(0)_SYNC/out | \UART:BUART:rx_state_2\/main_11 | 5.232

Type | Location | Fanout | Instance/Net | Source | Dest | Delay (ns)
synccell | U(0,2) | 1 | Rx_2(0)_SYNC | Rx_2(0)_SYNC/clock | Rx_2(0)_SYNC/out | 0.350
Route | | 1 | Net_3405_SYNCOUT | Rx_2(0)_SYNC/out | \UART:BUART:rx_state_2\/main_11 | 4.882
macrocell156 | U(0,5) | 1 | \UART:BUART:rx_state_2\ | | HOLD | 0.000
Clock | | | | | Skew | 0.000
Rx_1(0)_SYNC/out | \UART:BUART:pollcount_1\/main_5 | 5.439

Type | Location | Fanout | Instance/Net | Source | Dest | Delay (ns)
synccell | U(0,2) | 1 | Rx_1(0)_SYNC | Rx_1(0)_SYNC/clock | Rx_1(0)_SYNC/out | 0.350
Route | | 1 | Net_3438_SYNCOUT | Rx_1(0)_SYNC/out | \UART:BUART:pollcount_1\/main_5 | 5.089
macrocell159 | U(0,4) | 1 | \UART:BUART:pollcount_1\ | | HOLD | 0.000
Clock | | | | | Skew | 0.000
Rx_1(0)_SYNC/out | \UART:BUART:pollcount_0\/main_4 | 5.439

Type | Location | Fanout | Instance/Net | Source | Dest | Delay (ns)
synccell | U(0,2) | 1 | Rx_1(0)_SYNC | Rx_1(0)_SYNC/clock | Rx_1(0)_SYNC/out | 0.350
Route | | 1 | Net_3438_SYNCOUT | Rx_1(0)_SYNC/out | \UART:BUART:pollcount_0\/main_4 | 5.089
macrocell160 | U(0,4) | 1 | \UART:BUART:pollcount_0\ | | HOLD | 0.000
Clock | | | | | Skew | 0.000
\RF_BT_SELECT:Sync:ctrl_reg\/control_0 | \UART:BUART:rx_state_2\/main_9 | 5.650

Type | Location | Fanout | Instance/Net | Source | Dest | Delay (ns)
controlcell5 | U(0,2) | 1 | \RF_BT_SELECT:Sync:ctrl_reg\ | \RF_BT_SELECT:Sync:ctrl_reg\/busclk | \RF_BT_SELECT:Sync:ctrl_reg\/control_0 | 0.620
Route | | 1 | Net_3437 | \RF_BT_SELECT:Sync:ctrl_reg\/control_0 | \UART:BUART:rx_state_2\/main_9 | 5.030
macrocell156 | U(0,5) | 1 | \UART:BUART:rx_state_2\ | | HOLD | 0.000
Clock | | | | | Skew | 0.000

+ Source Clock : UART_IntClock : Positive edge

+ Destination Clock : UART_IntClock : Positive edge

Source | Destination | Slack (ns) | Violation
\UART:BUART:sTX:sCLOCK:TxBitClkGen\/ce1_reg | \UART:BUART:tx_state_1\/main_4 | 2.820

Type | Location | Fanout | Instance/Net | Source | Dest | Delay (ns)
datapathcell6 | U(0,2) | 1 | \UART:BUART:sTX:sCLOCK:TxBitClkGen\ | \UART:BUART:sTX:sCLOCK:TxBitClkGen\/clock | \UART:BUART:sTX:sCLOCK:TxBitClkGen\/ce1_reg | 0.190
Route | | 1 | \UART:BUART:tx_counter_dp\ | \UART:BUART:sTX:sCLOCK:TxBitClkGen\/ce1_reg | \UART:BUART:tx_state_1\/main_4 | 2.630
macrocell148 | U(0,2) | 1 | \UART:BUART:tx_state_1\ | | HOLD | 0.000
Clock | | | | | Skew | 0.000
\UART:BUART:sTX:sCLOCK:TxBitClkGen\/ce1_reg | \UART:BUART:tx_state_2\/main_4 | 2.820

Type | Location | Fanout | Instance/Net | Source | Dest | Delay (ns)
datapathcell6 | U(0,2) | 1 | \UART:BUART:sTX:sCLOCK:TxBitClkGen\ | \UART:BUART:sTX:sCLOCK:TxBitClkGen\/clock | \UART:BUART:sTX:sCLOCK:TxBitClkGen\/ce1_reg | 0.190
Route | | 1 | \UART:BUART:tx_counter_dp\ | \UART:BUART:sTX:sCLOCK:TxBitClkGen\/ce1_reg | \UART:BUART:tx_state_2\/main_4 | 2.630
macrocell150 | U(0,2) | 1 | \UART:BUART:tx_state_2\ | | HOLD | 0.000
Clock | | | | | Skew | 0.000
\UART:BUART:sTX:sCLOCK:TxBitClkGen\/ce0_reg | \UART:BUART:tx_state_1\/main_2 | 2.838

Type | Location | Fanout | Instance/Net | Source | Dest | Delay (ns)
datapathcell6 | U(0,2) | 1 | \UART:BUART:sTX:sCLOCK:TxBitClkGen\ | \UART:BUART:sTX:sCLOCK:TxBitClkGen\/clock | \UART:BUART:sTX:sCLOCK:TxBitClkGen\/ce0_reg | 0.190
Route | | 1 | \UART:BUART:tx_bitclk_enable_pre\ | \UART:BUART:sTX:sCLOCK:TxBitClkGen\/ce0_reg | \UART:BUART:tx_state_1\/main_2 | 2.648
macrocell148 | U(0,2) | 1 | \UART:BUART:tx_state_1\ | | HOLD | 0.000
Clock | | | | | Skew | 0.000
\UART:BUART:sTX:sCLOCK:TxBitClkGen\/ce0_reg | \UART:BUART:tx_state_0\/main_2 | 2.838

Type | Location | Fanout | Instance/Net | Source | Dest | Delay (ns)
datapathcell6 | U(0,2) | 1 | \UART:BUART:sTX:sCLOCK:TxBitClkGen\ | \UART:BUART:sTX:sCLOCK:TxBitClkGen\/clock | \UART:BUART:sTX:sCLOCK:TxBitClkGen\/ce0_reg | 0.190
Route | | 1 | \UART:BUART:tx_bitclk_enable_pre\ | \UART:BUART:sTX:sCLOCK:TxBitClkGen\/ce0_reg | \UART:BUART:tx_state_0\/main_2 | 2.648
macrocell149 | U(0,2) | 1 | \UART:BUART:tx_state_0\ | | HOLD | 0.000
Clock | | | | | Skew | 0.000
\UART:BUART:sTX:sCLOCK:TxBitClkGen\/ce0_reg | \UART:BUART:tx_state_2\/main_2 | 2.838

Type | Location | Fanout | Instance/Net | Source | Dest | Delay (ns)
datapathcell6 | U(0,2) | 1 | \UART:BUART:sTX:sCLOCK:TxBitClkGen\ | \UART:BUART:sTX:sCLOCK:TxBitClkGen\/clock | \UART:BUART:sTX:sCLOCK:TxBitClkGen\/ce0_reg | 0.190
Route | | 1 | \UART:BUART:tx_bitclk_enable_pre\ | \UART:BUART:sTX:sCLOCK:TxBitClkGen\/ce0_reg | \UART:BUART:tx_state_2\/main_2 | 2.648
macrocell150 | U(0,2) | 1 | \UART:BUART:tx_state_2\ | | HOLD | 0.000
Clock | | | | | Skew | 0.000
\UART:BUART:sRX:RxBitCounter\/count_2 | \UART:BUART:rx_bitclk_enable\/main_0 | 2.928

Type | Location | Fanout | Instance/Net | Source | Dest | Delay (ns)
count7cell | U(0,5) | 1 | \UART:BUART:sRX:RxBitCounter\ | \UART:BUART:sRX:RxBitCounter\/clock | \UART:BUART:sRX:RxBitCounter\/count_2 | 0.620
Route | | 1 | \UART:BUART:rx_count_2\ | \UART:BUART:sRX:RxBitCounter\/count_2 | \UART:BUART:rx_bitclk_enable\/main_0 | 2.308
macrocell157 | U(0,5) | 1 | \UART:BUART:rx_bitclk_enable\ | | HOLD | 0.000
Clock | | | | | Skew | 0.000
\UART:BUART:sRX:RxBitCounter\/count_1 | \UART:BUART:rx_bitclk_enable\/main_1 | 2.930

Type | Location | Fanout | Instance/Net | Source | Dest | Delay (ns)
count7cell | U(0,5) | 1 | \UART:BUART:sRX:RxBitCounter\ | \UART:BUART:sRX:RxBitCounter\/clock | \UART:BUART:sRX:RxBitCounter\/count_1 | 0.620
Route | | 1 | \UART:BUART:rx_count_1\ | \UART:BUART:sRX:RxBitCounter\/count_1 | \UART:BUART:rx_bitclk_enable\/main_1 | 2.310
macrocell157 | U(0,5) | 1 | \UART:BUART:rx_bitclk_enable\ | | HOLD | 0.000
Clock | | | | | Skew | 0.000
\UART:BUART:sRX:RxBitCounter\/count_0 | \UART:BUART:rx_bitclk_enable\/main_2 | 2.933

Type | Location | Fanout | Instance/Net | Source | Dest | Delay (ns)
count7cell | U(0,5) | 1 | \UART:BUART:sRX:RxBitCounter\ | \UART:BUART:sRX:RxBitCounter\/clock | \UART:BUART:sRX:RxBitCounter\/count_0 | 0.620
Route | | 1 | \UART:BUART:rx_count_0\ | \UART:BUART:sRX:RxBitCounter\/count_0 | \UART:BUART:rx_bitclk_enable\/main_2 | 2.313
macrocell157 | U(0,5) | 1 | \UART:BUART:rx_bitclk_enable\ | | HOLD | 0.000
Clock | | | | | Skew | 0.000
\UART:BUART:sRX:RxBitCounter\/count_4 | \UART:BUART:rx_load_fifo\/main_7 | 2.939

Type | Location | Fanout | Instance/Net | Source | Dest | Delay (ns)
count7cell | U(0,5) | 1 | \UART:BUART:sRX:RxBitCounter\ | \UART:BUART:sRX:RxBitCounter\/clock | \UART:BUART:sRX:RxBitCounter\/count_4 | 0.620
Route | | 1 | \UART:BUART:rx_count_4\ | \UART:BUART:sRX:RxBitCounter\/count_4 | \UART:BUART:rx_load_fifo\/main_7 | 2.319
macrocell154 | U(0,5) | 1 | \UART:BUART:rx_load_fifo\ | | HOLD | 0.000
Clock | | | | | Skew | 0.000
\UART:BUART:sRX:RxBitCounter\/count_4 | \UART:BUART:rx_state_3\/main_7 | 2.939

Type | Location | Fanout | Instance/Net | Source | Dest | Delay (ns)
count7cell | U(0,5) | 1 | \UART:BUART:sRX:RxBitCounter\ | \UART:BUART:sRX:RxBitCounter\/clock | \UART:BUART:sRX:RxBitCounter\/count_4 | 0.620
Route | | 1 | \UART:BUART:rx_count_4\ | \UART:BUART:sRX:RxBitCounter\/count_4 | \UART:BUART:rx_state_3\/main_7 | 2.319
macrocell155 | U(0,5) | 1 | \UART:BUART:rx_state_3\ | | HOLD | 0.000
Clock | | | | | Skew | 0.000

+ Asynchronous Clock Crossing Section

+ Source Clock ClockBlock/dclk_glb_ff_3

+ Destination Clock ADC_IntClock

Source | Destination | Delay (ns)
\Timer_TS:TimerHW\/tc | \ADC:bSAR_SEQ:soc_in\/main_1 | 10.706

Type | Location | Fanout | Instance/Net | Source | Dest | Delay (ns)
timercell | F(Timer,2) | 1 | \Timer_TS:TimerHW\ | \Timer_TS:TimerHW\/clock | \Timer_TS:TimerHW\/tc | 1.000
Route | | 1 | Net_1619 | \Timer_TS:TimerHW\/tc | \ADC:bSAR_SEQ:soc_in\/main_1 | 6.196
macrocell142 | U(2,1) | 1 | \ADC:bSAR_SEQ:soc_in\ | | SETUP | 3.510
Clock | | | | | Skew | 0.000
\Timer_TS:TimerHW\/tc | \ADC:bSAR_SEQ:soc_reg\/main_0 | 10.706

Type | Location | Fanout | Instance/Net | Source | Dest | Delay (ns)
timercell | F(Timer,2) | 1 | \Timer_TS:TimerHW\ | \Timer_TS:TimerHW\/clock | \Timer_TS:TimerHW\/tc | 1.000
Route | | 1 | Net_1619 | \Timer_TS:TimerHW\/tc | \ADC:bSAR_SEQ:soc_reg\/main_0 | 6.196
macrocell144 | U(2,1) | 1 | \ADC:bSAR_SEQ:soc_reg\ | | SETUP | 3.510
Clock | | | | | Skew | 0.000

+ Clock To Output Section

+ ClockBlock/dclk_glb_ff_2

Source | Destination | Delay (ns)
\PWM_1:PWMHW\/cmp | M1_IN2(0)_PAD | 33.356

Type | Location | Fanout | Instance/Net | Source | Dest | Delay (ns)
timercell | F(Timer,0) | 1 | \PWM_1:PWMHW\ | \PWM_1:PWMHW\/clock | \PWM_1:PWMHW\/cmp | 1.000
Route | | 1 | Net_2404 | \PWM_1:PWMHW\/cmp | Net_362/main_0 | 6.619
macrocell10 | U(0,1) | 1 | Net_362 | Net_362/main_0 | Net_362/q | 3.350
Route | | 1 | Net_362 | Net_362/q | M1_IN2(0)/pin_input | 7.400
iocell2 | P3[4] | 1 | M1_IN2(0) | M1_IN2(0)/pin_input | M1_IN2(0)/pad_out | 14.987
Route | | 1 | M1_IN2(0)_PAD | M1_IN2(0)/pad_out | M1_IN2(0)_PAD | 0.000
Clock | | | | | Clock path delay | 0.000
\PWM_2:PWMHW\/cmp | M2_IN2(0)_PAD | 32.432

Type | Location | Fanout | Instance/Net | Source | Dest | Delay (ns)
timercell | F(Timer,1) | 1 | \PWM_2:PWMHW\ | \PWM_2:PWMHW\/clock | \PWM_2:PWMHW\/cmp | 1.000
Route | | 1 | Net_2460 | \PWM_2:PWMHW\/cmp | Net_368/main_0 | 5.308
macrocell9 | U(3,1) | 1 | Net_368 | Net_368/main_0 | Net_368/q | 3.350
Route | | 1 | Net_368 | Net_368/q | M2_IN2(0)/pin_input | 6.578
iocell4 | P12[3] | 1 | M2_IN2(0) | M2_IN2(0)/pin_input | M2_IN2(0)/pad_out | 16.196
Route | | 1 | M2_IN2(0)_PAD | M2_IN2(0)/pad_out | M2_IN2(0)_PAD | 0.000
Clock | | | | | Clock path delay | 0.000
\PWM_1:PWMHW\/cmp | M1_IN1(0)_PAD | 20.187

Type | Location | Fanout | Instance/Net | Source | Dest | Delay (ns)
timercell | F(Timer,0) | 1 | \PWM_1:PWMHW\ | \PWM_1:PWMHW\/clock | \PWM_1:PWMHW\/cmp | 1.000
Route | | 1 | Net_2404 | \PWM_1:PWMHW\/cmp | M1_IN1(0)/pin_input | 3.849
iocell1 | P3[5] | 1 | M1_IN1(0) | M1_IN1(0)/pin_input | M1_IN1(0)/pad_out | 15.338
Route | | 1 | M1_IN1(0)_PAD | M1_IN1(0)/pad_out | M1_IN1(0)_PAD | 0.000
Clock | | | | | Clock path delay | 0.000
\PWM_2:PWMHW\/cmp | M2_IN1(0)_PAD | 20.003

Type | Location | Fanout | Instance/Net | Source | Dest | Delay (ns)
timercell | F(Timer,1) | 1 | \PWM_2:PWMHW\ | \PWM_2:PWMHW\/clock | \PWM_2:PWMHW\/cmp | 1.000
Route | | 1 | Net_2460 | \PWM_2:PWMHW\/cmp | M2_IN1(0)/pin_input | 3.337
iocell3 | P12[2] | 1 | M2_IN1(0) | M2_IN1(0)/pin_input | M2_IN1(0)/pad_out | 15.666
Route | | 1 | M2_IN1(0)_PAD | M2_IN1(0)/pad_out | M2_IN1(0)_PAD | 0.000
Clock | | | | | Clock path delay | 0.000

+ CyBUS_CLK

Source | Destination | Delay (ns)
\CONTROL:Sync:ctrl_reg\/control_1 | M2_D1(0)_PAD | 25.929

Type | Location | Fanout | Instance/Net | Source | Dest | Delay (ns)
controlcell4 | U(2,1) | 1 | \CONTROL:Sync:ctrl_reg\ | \CONTROL:Sync:ctrl_reg\/busclk | \CONTROL:Sync:ctrl_reg\/control_1 | 2.050
Route | | 1 | Net_3236 | \CONTROL:Sync:ctrl_reg\/control_1 | M2_D1(0)/pin_input | 7.264
iocell5 | P12[4] | 1 | M2_D1(0) | M2_D1(0)/pin_input | M2_D1(0)/pad_out | 16.615
Route | | 1 | M2_D1(0)_PAD | M2_D1(0)/pad_out | M2_D1(0)_PAD | 0.000
Clock | | | | | Clock path delay | 0.000
\CONTROL:Sync:ctrl_reg\/control_0 | M1_D1(0)_PAD | 22.203

Type | Location | Fanout | Instance/Net | Source | Dest | Delay (ns)
controlcell4 | U(2,1) | 1 | \CONTROL:Sync:ctrl_reg\ | \CONTROL:Sync:ctrl_reg\/busclk | \CONTROL:Sync:ctrl_reg\/control_0 | 2.050
Route | | 1 | Net_1832 | \CONTROL:Sync:ctrl_reg\/control_0 | M1_D1(0)/pin_input | 5.562
iocell20 | P3[3] | 1 | M1_D1(0) | M1_D1(0)/pin_input | M1_D1(0)/pad_out | 14.591
Route | | 1 | M1_D1(0)_PAD | M1_D1(0)/pad_out | M1_D1(0)_PAD | 0.000
Clock | | | | | Clock path delay | 0.000

+ UART_IntClock

Source | Destination | Delay (ns)
\UART:BUART:txn\/q | Tx_1(0)_PAD | 32.153

Type | Location | Fanout | Instance/Net | Source | Dest | Delay (ns)
macrocell147 | U(0,3) | 1 | \UART:BUART:txn\ | \UART:BUART:txn\/clock_0 | \UART:BUART:txn\/q | 1.250
Route | | 1 | \UART:BUART:txn\ | \UART:BUART:txn\/q | Net_1880/main_0 | 3.979
macrocell20 | U(0,1) | 1 | Net_1880 | Net_1880/main_0 | Net_1880/q | 3.350
Route | | 1 | Net_1880 | Net_1880/q | Tx_1(0)/pin_input | 8.137
iocell22 | P2[3] | 1 | Tx_1(0) | Tx_1(0)/pin_input | Tx_1(0)/pad_out | 15.437
Route | | 1 | Tx_1(0)_PAD | Tx_1(0)/pad_out | Tx_1(0)_PAD | 0.000
Clock | | | | | Clock path delay | 0.000

+ Asynchronous Constraints

+ Recovery

+ Source Clock : Clock_QENC : Positive edge(Required Frequency 12 MHz)

+ Destination Clock : Clock_QENC : Positive edge(Required Frequency 12 MHz)

Path Delay Requirement : 83.3333ns(12 MHz)

Source | Destination | FMax | Delay (ns) | Slack (ns) | Violation
\QuadDec_M2:Net_1260\/q | \QuadDec_M2:Cnt16:CounterUDB:sSTSReg:stsreg\/reset | 100.060 MHz | 9.994 | 73.339

Type | Location | Fanout | Instance/Net | Source | Dest | Delay (ns)
macrocell65 | U(2,0) | 1 | \QuadDec_M2:Net_1260\ | \QuadDec_M2:Net_1260\/clock_0 | \QuadDec_M2:Net_1260\/q | 1.250
Route | | 1 | \QuadDec_M2:Net_1260\ | \QuadDec_M2:Net_1260\/q | \QuadDec_M2:Cnt16:CounterUDB:sSTSReg:stsreg\/reset | 8.744
statusicell3 | U(2,4) | 1 | \QuadDec_M2:Cnt16:CounterUDB:sSTSReg:stsreg\ | | RECOVERY | -0.000
Clock | | | | | Skew | 0.000
\QuadDec_M1:Net_1260\/q | \QuadDec_M1:Cnt16:CounterUDB:sSTSReg:stsreg\/reset | 186.776 MHz | 5.354 | 77.979

Type | Location | Fanout | Instance/Net | Source | Dest | Delay (ns)
macrocell51 | U(2,0) | 1 | \QuadDec_M1:Net_1260\ | \QuadDec_M1:Net_1260\/clock_0 | \QuadDec_M1:Net_1260\/q | 1.250
Route | | 1 | \QuadDec_M1:Net_1260\ | \QuadDec_M1:Net_1260\/q | \QuadDec_M1:Cnt16:CounterUDB:sSTSReg:stsreg\/reset | 4.104
statusicell1 | U(2,0) | 1 | \QuadDec_M1:Cnt16:CounterUDB:sSTSReg:stsreg\ | | RECOVERY | -0.000
Clock | | | | | Skew | 0.000

+ Removal

+ Source Clock : Clock_QENC : Positive edge

+ Destination Clock : Clock_QENC : Positive edge

Source | Destination | Slack (ns) | Violation
\QuadDec_M1:Net_1260\/q | \QuadDec_M1:Cnt16:CounterUDB:sSTSReg:stsreg\/reset | 5.354

Type | Location | Fanout | Instance/Net | Source | Dest | Delay (ns)
macrocell51 | U(2,0) | 1 | \QuadDec_M1:Net_1260\ | \QuadDec_M1:Net_1260\/clock_0 | \QuadDec_M1:Net_1260\/q | 1.250
Route | | 1 | \QuadDec_M1:Net_1260\ | \QuadDec_M1:Net_1260\/q | \QuadDec_M1:Cnt16:CounterUDB:sSTSReg:stsreg\/reset | 4.104
statusicell1 | U(2,0) | 1 | \QuadDec_M1:Cnt16:CounterUDB:sSTSReg:stsreg\ | | REMOVAL | 0.000
Clock | | | | | Skew | 0.000
\QuadDec_M2:Net_1260\/q | \QuadDec_M2:Cnt16:CounterUDB:sSTSReg:stsreg\/reset | 9.994

Type | Location | Fanout | Instance/Net | Source | Dest | Delay (ns)
macrocell65 | U(2,0) | 1 | \QuadDec_M2:Net_1260\ | \QuadDec_M2:Net_1260\/clock_0 | \QuadDec_M2:Net_1260\/q | 1.250
Route | | 1 | \QuadDec_M2:Net_1260\ | \QuadDec_M2:Net_1260\/q | \QuadDec_M2:Cnt16:CounterUDB:sSTSReg:stsreg\/reset | 8.744
statusicell3 | U(2,4) | 1 | \QuadDec_M2:Cnt16:CounterUDB:sSTSReg:stsreg\ | | REMOVAL | 0.000
Clock | | | | | Skew | 0.000
