rsef899/12_Cypress_LineFollowingRobot/Robert/HArdware_Task2/Hardware_Task2.cydsn/Hardware_Task2_timing.html

# Static Timing Analysis

Project : | Hardware_Task2
Build Time : | 10/09/23 11:43:23
Device : | CY8C5888LTI-LP097
Temperature : | -40C - 85/125C
VDDA : | 5.00
VDDABUF : | 5.00
VDDD : | 5.00
VDDIO0 : | 5.00
VDDIO1 : | 5.00
VDDIO2 : | 5.00
VDDIO3 : | 5.00
VUSB : | 5.00
Voltage : | 5.0

Expand All | Collapse All | Show All Paths | Hide All Paths

+ Timing Violation Section

Note: If your design will only ever run at typical room temperatures, selecting the narrower temperature range in the system DWR for your application helps the tool to find timing-compliant routing solutions.

Violation | Source Clock | Destination Clock | Slack(ns)
Async
| ClockBlock/dclk_glb_ff_5 | ADC_IntClock

+ Clock Summary Section

Clock | Domain | Nominal Frequency | Required Frequency | Maximum Frequency | Violation
ADC_IntClock(routed) | ADC_IntClock(routed) | 2.857 MHz | 2.857 MHz | N/A
ClockBlock/dclk_glb_ff_2 | ClockBlock/dclk_glb_ff_2 | UNKNOWN | UNKNOWN | N/A
ClockBlock/dclk_glb_ff_4 | ClockBlock/dclk_glb_ff_4 | UNKNOWN | UNKNOWN | N/A
ClockBlock/dclk_glb_ff_5 | ClockBlock/dclk_glb_ff_5 | UNKNOWN | UNKNOWN | N/A
CyILO | CyILO | 100.000 kHz | 100.000 kHz | N/A
CyIMO | CyIMO | 24.000 MHz | 24.000 MHz | N/A
CyMASTER_CLK | CyMASTER_CLK | 60.000 MHz | 60.000 MHz | N/A
CyBUS_CLK | CyMASTER_CLK | 60.000 MHz | 60.000 MHz | 64.238 MHz
Clock_QENC | CyMASTER_CLK | 12.000 MHz | 12.000 MHz | 32.995 MHz
ADC_IntClock | CyMASTER_CLK | 2.857 MHz | 2.857 MHz | 23.379 MHz
Clock_PWM | CyMASTER_CLK | 1.000 MHz | 1.000 MHz | N/A
UART_IntClock | CyMASTER_CLK | 461.538 kHz | 461.538 kHz | 47.081 MHz
Quad_Timer_clk | CyMASTER_CLK | 1.000 kHz | 1.000 kHz | N/A
Clock2 | CyMASTER_CLK | 1.000 kHz | 1.000 kHz | N/A
CyPLL_OUT | CyPLL_OUT | 60.000 MHz | 60.000 MHz | N/A

+ Register to Register Section

+ Setup Subsection

+ Source Clock : ADC_IntClock : Positive edge(Required Frequency 2.85714 MHz)

+ Destination Clock : ADC_IntClock : Positive edge(Required Frequency 2.85714 MHz)

Path Delay Requirement : 350ns(2.85714 MHz)

Source | Destination | FMax | Delay (ns) | Slack (ns) | Violation
\ADC:AMuxHw_2_Decoder_old_id_1\/q | \ADC:AMuxHw_2_Decoder_one_hot_1\/main_0 | 23.379 MHz | 42.773 | 307.227

Type | Location | Fanout | Instance/Net | Source | Dest | Delay (ns)
macrocell73 | U(3,4) | 1 | \ADC:AMuxHw_2_Decoder_old_id_1\ | \ADC:AMuxHw_2_Decoder_old_id_1\/clock_0 | \ADC:AMuxHw_2_Decoder_old_id_1\/q | 1.250
Route | | 1 | \ADC:AMuxHw_2_Decoder_old_id_1\ | \ADC:AMuxHw_2_Decoder_old_id_1\/q | \ADC:AMuxHw_2_Decoder_is_active_split\/main_8 | 13.729
macrocell46 | U(0,0) | 1 | \ADC:AMuxHw_2_Decoder_is_active_split\ | \ADC:AMuxHw_2_Decoder_is_active_split\/main_8 | \ADC:AMuxHw_2_Decoder_is_active_split\/q | 3.350
Route | | 1 | \ADC:AMuxHw_2_Decoder_is_active_split\ | \ADC:AMuxHw_2_Decoder_is_active_split\/q | \ADC:AMuxHw_2_Decoder_is_active\/main_8 | 2.850
macrocell18 | U(0,1) | 1 | \ADC:AMuxHw_2_Decoder_is_active\ | \ADC:AMuxHw_2_Decoder_is_active\/main_8 | \ADC:AMuxHw_2_Decoder_is_active\/q | 3.350
Route | | 1 | \ADC:AMuxHw_2_Decoder_is_active\ | \ADC:AMuxHw_2_Decoder_is_active\/q | \ADC:AMuxHw_2_Decoder_one_hot_1\/main_0 | 14.734
macrocell76 | U(3,5) | 1 | \ADC:AMuxHw_2_Decoder_one_hot_1\ | | SETUP | 3.510
Clock | | | | | Skew | 0.000
\ADC:AMuxHw_2_Decoder_old_id_1\/q | \ADC:AMuxHw_2_Decoder_one_hot_37\/main_0 | 23.379 MHz | 42.773 | 307.227

Type | Location | Fanout | Instance/Net | Source | Dest | Delay (ns)
macrocell73 | U(3,4) | 1 | \ADC:AMuxHw_2_Decoder_old_id_1\ | \ADC:AMuxHw_2_Decoder_old_id_1\/clock_0 | \ADC:AMuxHw_2_Decoder_old_id_1\/q | 1.250
Route | | 1 | \ADC:AMuxHw_2_Decoder_old_id_1\ | \ADC:AMuxHw_2_Decoder_old_id_1\/q | \ADC:AMuxHw_2_Decoder_is_active_split\/main_8 | 13.729
macrocell46 | U(0,0) | 1 | \ADC:AMuxHw_2_Decoder_is_active_split\ | \ADC:AMuxHw_2_Decoder_is_active_split\/main_8 | \ADC:AMuxHw_2_Decoder_is_active_split\/q | 3.350
Route | | 1 | \ADC:AMuxHw_2_Decoder_is_active_split\ | \ADC:AMuxHw_2_Decoder_is_active_split\/q | \ADC:AMuxHw_2_Decoder_is_active\/main_8 | 2.850
macrocell18 | U(0,1) | 1 | \ADC:AMuxHw_2_Decoder_is_active\ | \ADC:AMuxHw_2_Decoder_is_active\/main_8 | \ADC:AMuxHw_2_Decoder_is_active\/q | 3.350
Route | | 1 | \ADC:AMuxHw_2_Decoder_is_active\ | \ADC:AMuxHw_2_Decoder_is_active\/q | \ADC:AMuxHw_2_Decoder_one_hot_37\/main_0 | 14.734
macrocell112 | U(3,5) | 1 | \ADC:AMuxHw_2_Decoder_one_hot_37\ | | SETUP | 3.510
Clock | | | | | Skew | 0.000
\ADC:AMuxHw_2_Decoder_old_id_1\/q | \ADC:AMuxHw_2_Decoder_one_hot_54\/main_0 | 23.379 MHz | 42.773 | 307.227

Type | Location | Fanout | Instance/Net | Source | Dest | Delay (ns)
macrocell73 | U(3,4) | 1 | \ADC:AMuxHw_2_Decoder_old_id_1\ | \ADC:AMuxHw_2_Decoder_old_id_1\/clock_0 | \ADC:AMuxHw_2_Decoder_old_id_1\/q | 1.250
Route | | 1 | \ADC:AMuxHw_2_Decoder_old_id_1\ | \ADC:AMuxHw_2_Decoder_old_id_1\/q | \ADC:AMuxHw_2_Decoder_is_active_split\/main_8 | 13.729
macrocell46 | U(0,0) | 1 | \ADC:AMuxHw_2_Decoder_is_active_split\ | \ADC:AMuxHw_2_Decoder_is_active_split\/main_8 | \ADC:AMuxHw_2_Decoder_is_active_split\/q | 3.350
Route | | 1 | \ADC:AMuxHw_2_Decoder_is_active_split\ | \ADC:AMuxHw_2_Decoder_is_active_split\/q | \ADC:AMuxHw_2_Decoder_is_active\/main_8 | 2.850
macrocell18 | U(0,1) | 1 | \ADC:AMuxHw_2_Decoder_is_active\ | \ADC:AMuxHw_2_Decoder_is_active\/main_8 | \ADC:AMuxHw_2_Decoder_is_active\/q | 3.350
Route | | 1 | \ADC:AMuxHw_2_Decoder_is_active\ | \ADC:AMuxHw_2_Decoder_is_active\/q | \ADC:AMuxHw_2_Decoder_one_hot_54\/main_0 | 14.734
macrocell129 | U(3,5) | 1 | \ADC:AMuxHw_2_Decoder_one_hot_54\ | | SETUP | 3.510
Clock | | | | | Skew | 0.000
\ADC:AMuxHw_2_Decoder_old_id_1\/q | \ADC:AMuxHw_2_Decoder_one_hot_60\/main_0 | 23.379 MHz | 42.773 | 307.227

Type | Location | Fanout | Instance/Net | Source | Dest | Delay (ns)
macrocell73 | U(3,4) | 1 | \ADC:AMuxHw_2_Decoder_old_id_1\ | \ADC:AMuxHw_2_Decoder_old_id_1\/clock_0 | \ADC:AMuxHw_2_Decoder_old_id_1\/q | 1.250
Route | | 1 | \ADC:AMuxHw_2_Decoder_old_id_1\ | \ADC:AMuxHw_2_Decoder_old_id_1\/q | \ADC:AMuxHw_2_Decoder_is_active_split\/main_8 | 13.729
macrocell46 | U(0,0) | 1 | \ADC:AMuxHw_2_Decoder_is_active_split\ | \ADC:AMuxHw_2_Decoder_is_active_split\/main_8 | \ADC:AMuxHw_2_Decoder_is_active_split\/q | 3.350
Route | | 1 | \ADC:AMuxHw_2_Decoder_is_active_split\ | \ADC:AMuxHw_2_Decoder_is_active_split\/q | \ADC:AMuxHw_2_Decoder_is_active\/main_8 | 2.850
macrocell18 | U(0,1) | 1 | \ADC:AMuxHw_2_Decoder_is_active\ | \ADC:AMuxHw_2_Decoder_is_active\/main_8 | \ADC:AMuxHw_2_Decoder_is_active\/q | 3.350
Route | | 1 | \ADC:AMuxHw_2_Decoder_is_active\ | \ADC:AMuxHw_2_Decoder_is_active\/q | \ADC:AMuxHw_2_Decoder_one_hot_60\/main_0 | 14.734
macrocell135 | U(3,5) | 1 | \ADC:AMuxHw_2_Decoder_one_hot_60\ | | SETUP | 3.510
Clock | | | | | Skew | 0.000
\ADC:AMuxHw_2_Decoder_old_id_1\/q | \ADC:AMuxHw_2_Decoder_one_hot_9\/main_0 | 23.688 MHz | 42.216 | 307.784

Type | Location | Fanout | Instance/Net | Source | Dest | Delay (ns)
macrocell73 | U(3,4) | 1 | \ADC:AMuxHw_2_Decoder_old_id_1\ | \ADC:AMuxHw_2_Decoder_old_id_1\/clock_0 | \ADC:AMuxHw_2_Decoder_old_id_1\/q | 1.250
Route | | 1 | \ADC:AMuxHw_2_Decoder_old_id_1\ | \ADC:AMuxHw_2_Decoder_old_id_1\/q | \ADC:AMuxHw_2_Decoder_is_active_split\/main_8 | 13.729
macrocell46 | U(0,0) | 1 | \ADC:AMuxHw_2_Decoder_is_active_split\ | \ADC:AMuxHw_2_Decoder_is_active_split\/main_8 | \ADC:AMuxHw_2_Decoder_is_active_split\/q | 3.350
Route | | 1 | \ADC:AMuxHw_2_Decoder_is_active_split\ | \ADC:AMuxHw_2_Decoder_is_active_split\/q | \ADC:AMuxHw_2_Decoder_is_active\/main_8 | 2.850
macrocell18 | U(0,1) | 1 | \ADC:AMuxHw_2_Decoder_is_active\ | \ADC:AMuxHw_2_Decoder_is_active\/main_8 | \ADC:AMuxHw_2_Decoder_is_active\/q | 3.350
Route | | 1 | \ADC:AMuxHw_2_Decoder_is_active\ | \ADC:AMuxHw_2_Decoder_is_active\/q | \ADC:AMuxHw_2_Decoder_one_hot_9\/main_0 | 14.177
macrocell84 | U(3,5) | 1 | \ADC:AMuxHw_2_Decoder_one_hot_9\ | | SETUP | 3.510
Clock | | | | | Skew | 0.000
\ADC:AMuxHw_2_Decoder_old_id_1\/q | \ADC:AMuxHw_2_Decoder_one_hot_22\/main_0 | 23.688 MHz | 42.216 | 307.784

Type | Location | Fanout | Instance/Net | Source | Dest | Delay (ns)
macrocell73 | U(3,4) | 1 | \ADC:AMuxHw_2_Decoder_old_id_1\ | \ADC:AMuxHw_2_Decoder_old_id_1\/clock_0 | \ADC:AMuxHw_2_Decoder_old_id_1\/q | 1.250
Route | | 1 | \ADC:AMuxHw_2_Decoder_old_id_1\ | \ADC:AMuxHw_2_Decoder_old_id_1\/q | \ADC:AMuxHw_2_Decoder_is_active_split\/main_8 | 13.729
macrocell46 | U(0,0) | 1 | \ADC:AMuxHw_2_Decoder_is_active_split\ | \ADC:AMuxHw_2_Decoder_is_active_split\/main_8 | \ADC:AMuxHw_2_Decoder_is_active_split\/q | 3.350
Route | | 1 | \ADC:AMuxHw_2_Decoder_is_active_split\ | \ADC:AMuxHw_2_Decoder_is_active_split\/q | \ADC:AMuxHw_2_Decoder_is_active\/main_8 | 2.850
macrocell18 | U(0,1) | 1 | \ADC:AMuxHw_2_Decoder_is_active\ | \ADC:AMuxHw_2_Decoder_is_active\/main_8 | \ADC:AMuxHw_2_Decoder_is_active\/q | 3.350
Route | | 1 | \ADC:AMuxHw_2_Decoder_is_active\ | \ADC:AMuxHw_2_Decoder_is_active\/q | \ADC:AMuxHw_2_Decoder_one_hot_22\/main_0 | 14.177
macrocell97 | U(3,5) | 1 | \ADC:AMuxHw_2_Decoder_one_hot_22\ | | SETUP | 3.510
Clock | | | | | Skew | 0.000
\ADC:AMuxHw_2_Decoder_old_id_1\/q | \ADC:AMuxHw_2_Decoder_one_hot_35\/main_0 | 23.688 MHz | 42.216 | 307.784

Type | Location | Fanout | Instance/Net | Source | Dest | Delay (ns)
macrocell73 | U(3,4) | 1 | \ADC:AMuxHw_2_Decoder_old_id_1\ | \ADC:AMuxHw_2_Decoder_old_id_1\/clock_0 | \ADC:AMuxHw_2_Decoder_old_id_1\/q | 1.250
Route | | 1 | \ADC:AMuxHw_2_Decoder_old_id_1\ | \ADC:AMuxHw_2_Decoder_old_id_1\/q | \ADC:AMuxHw_2_Decoder_is_active_split\/main_8 | 13.729
macrocell46 | U(0,0) | 1 | \ADC:AMuxHw_2_Decoder_is_active_split\ | \ADC:AMuxHw_2_Decoder_is_active_split\/main_8 | \ADC:AMuxHw_2_Decoder_is_active_split\/q | 3.350
Route | | 1 | \ADC:AMuxHw_2_Decoder_is_active_split\ | \ADC:AMuxHw_2_Decoder_is_active_split\/q | \ADC:AMuxHw_2_Decoder_is_active\/main_8 | 2.850
macrocell18 | U(0,1) | 1 | \ADC:AMuxHw_2_Decoder_is_active\ | \ADC:AMuxHw_2_Decoder_is_active\/main_8 | \ADC:AMuxHw_2_Decoder_is_active\/q | 3.350
Route | | 1 | \ADC:AMuxHw_2_Decoder_is_active\ | \ADC:AMuxHw_2_Decoder_is_active\/q | \ADC:AMuxHw_2_Decoder_one_hot_35\/main_0 | 14.177
macrocell110 | U(3,5) | 1 | \ADC:AMuxHw_2_Decoder_one_hot_35\ | | SETUP | 3.510
Clock | | | | | Skew | 0.000
\ADC:AMuxHw_2_Decoder_old_id_1\/q | \ADC:AMuxHw_2_Decoder_one_hot_43\/main_0 | 23.688 MHz | 42.216 | 307.784

Type | Location | Fanout | Instance/Net | Source | Dest | Delay (ns)
macrocell73 | U(3,4) | 1 | \ADC:AMuxHw_2_Decoder_old_id_1\ | \ADC:AMuxHw_2_Decoder_old_id_1\/clock_0 | \ADC:AMuxHw_2_Decoder_old_id_1\/q | 1.250
Route | | 1 | \ADC:AMuxHw_2_Decoder_old_id_1\ | \ADC:AMuxHw_2_Decoder_old_id_1\/q | \ADC:AMuxHw_2_Decoder_is_active_split\/main_8 | 13.729
macrocell46 | U(0,0) | 1 | \ADC:AMuxHw_2_Decoder_is_active_split\ | \ADC:AMuxHw_2_Decoder_is_active_split\/main_8 | \ADC:AMuxHw_2_Decoder_is_active_split\/q | 3.350
Route | | 1 | \ADC:AMuxHw_2_Decoder_is_active_split\ | \ADC:AMuxHw_2_Decoder_is_active_split\/q | \ADC:AMuxHw_2_Decoder_is_active\/main_8 | 2.850
macrocell18 | U(0,1) | 1 | \ADC:AMuxHw_2_Decoder_is_active\ | \ADC:AMuxHw_2_Decoder_is_active\/main_8 | \ADC:AMuxHw_2_Decoder_is_active\/q | 3.350
Route | | 1 | \ADC:AMuxHw_2_Decoder_is_active\ | \ADC:AMuxHw_2_Decoder_is_active\/q | \ADC:AMuxHw_2_Decoder_one_hot_43\/main_0 | 14.177
macrocell118 | U(3,5) | 1 | \ADC:AMuxHw_2_Decoder_one_hot_43\ | | SETUP | 3.510
Clock | | | | | Skew | 0.000
\ADC:AMuxHw_2_Decoder_old_id_1\/q | \ADC:AMuxHw_2_Decoder_one_hot_4\/main_0 | 24.199 MHz | 41.324 | 308.676

Type | Location | Fanout | Instance/Net | Source | Dest | Delay (ns)
macrocell73 | U(3,4) | 1 | \ADC:AMuxHw_2_Decoder_old_id_1\ | \ADC:AMuxHw_2_Decoder_old_id_1\/clock_0 | \ADC:AMuxHw_2_Decoder_old_id_1\/q | 1.250
Route | | 1 | \ADC:AMuxHw_2_Decoder_old_id_1\ | \ADC:AMuxHw_2_Decoder_old_id_1\/q | \ADC:AMuxHw_2_Decoder_is_active_split\/main_8 | 13.729
macrocell46 | U(0,0) | 1 | \ADC:AMuxHw_2_Decoder_is_active_split\ | \ADC:AMuxHw_2_Decoder_is_active_split\/main_8 | \ADC:AMuxHw_2_Decoder_is_active_split\/q | 3.350
Route | | 1 | \ADC:AMuxHw_2_Decoder_is_active_split\ | \ADC:AMuxHw_2_Decoder_is_active_split\/q | \ADC:AMuxHw_2_Decoder_is_active\/main_8 | 2.850
macrocell18 | U(0,1) | 1 | \ADC:AMuxHw_2_Decoder_is_active\ | \ADC:AMuxHw_2_Decoder_is_active\/main_8 | \ADC:AMuxHw_2_Decoder_is_active\/q | 3.350
Route | | 1 | \ADC:AMuxHw_2_Decoder_is_active\ | \ADC:AMuxHw_2_Decoder_is_active\/q | \ADC:AMuxHw_2_Decoder_one_hot_4\/main_0 | 13.285
macrocell79 | U(3,4) | 1 | \ADC:AMuxHw_2_Decoder_one_hot_4\ | | SETUP | 3.510
Clock | | | | | Skew | 0.000
\ADC:AMuxHw_2_Decoder_old_id_1\/q | \ADC:AMuxHw_2_Decoder_one_hot_12\/main_0 | 24.199 MHz | 41.324 | 308.676

Type | Location | Fanout | Instance/Net | Source | Dest | Delay (ns)
macrocell73 | U(3,4) | 1 | \ADC:AMuxHw_2_Decoder_old_id_1\ | \ADC:AMuxHw_2_Decoder_old_id_1\/clock_0 | \ADC:AMuxHw_2_Decoder_old_id_1\/q | 1.250
Route | | 1 | \ADC:AMuxHw_2_Decoder_old_id_1\ | \ADC:AMuxHw_2_Decoder_old_id_1\/q | \ADC:AMuxHw_2_Decoder_is_active_split\/main_8 | 13.729
macrocell46 | U(0,0) | 1 | \ADC:AMuxHw_2_Decoder_is_active_split\ | \ADC:AMuxHw_2_Decoder_is_active_split\/main_8 | \ADC:AMuxHw_2_Decoder_is_active_split\/q | 3.350
Route | | 1 | \ADC:AMuxHw_2_Decoder_is_active_split\ | \ADC:AMuxHw_2_Decoder_is_active_split\/q | \ADC:AMuxHw_2_Decoder_is_active\/main_8 | 2.850
macrocell18 | U(0,1) | 1 | \ADC:AMuxHw_2_Decoder_is_active\ | \ADC:AMuxHw_2_Decoder_is_active\/main_8 | \ADC:AMuxHw_2_Decoder_is_active\/q | 3.350
Route | | 1 | \ADC:AMuxHw_2_Decoder_is_active\ | \ADC:AMuxHw_2_Decoder_is_active\/q | \ADC:AMuxHw_2_Decoder_one_hot_12\/main_0 | 13.285
macrocell87 | U(3,4) | 1 | \ADC:AMuxHw_2_Decoder_one_hot_12\ | | SETUP | 3.510
Clock | | | | | Skew | 0.000

+ Destination Clock : CyBUS_CLK : Positive edge(Required Frequency 60 MHz)

Path Delay Requirement : 16.6667ns(60 MHz)

Affects clock : CyMASTER_CLK

Source | Destination | FMax | Delay (ns) | Slack (ns) | Violation
Net_1497/q | \ADC:bSAR_SEQ:bus_clk_nrq_reg\/main_2 | 141.864 MHz | 7.049 | 9.618

Type | Location | Fanout | Instance/Net | Source | Dest | Delay (ns)
macrocell139 | U(0,2) | 1 | Net_1497 | Net_1497/clock_0 | Net_1497/q | 1.250
Route | | 1 | Net_1497 | Net_1497/q | \ADC:bSAR_SEQ:bus_clk_nrq_reg\/main_2 | 2.289
macrocell140 | U(0,2) | 1 | \ADC:bSAR_SEQ:bus_clk_nrq_reg\ | | SETUP | 3.510
Clock | | | | | Skew | 0.000

+ Source Clock : Clock_QENC : Positive edge(Required Frequency 12 MHz)

+ Destination Clock : Clock_QENC : Positive edge(Required Frequency 12 MHz)

Path Delay Requirement : 83.3333ns(12 MHz)

Source | Destination | FMax | Delay (ns) | Slack (ns) | Violation
\QuadDec_M2:Net_1260\/q | \QuadDec_M2:Cnt16:CounterUDB:sC16:counterdp:u1\/ci | 32.995 MHz | 30.308 | 53.025

Type | Location | Fanout | Instance/Net | Source | Dest | Delay (ns)
macrocell65 | U(3,3) | 1 | \QuadDec_M2:Net_1260\ | \QuadDec_M2:Net_1260\/clock_0 | \QuadDec_M2:Net_1260\/q | 1.250
Route | | 1 | \QuadDec_M2:Net_1260\ | \QuadDec_M2:Net_1260\/q | \QuadDec_M2:Cnt16:CounterUDB:reload\/main_0 | 9.625
macrocell11 | U(1,4) | 1 | \QuadDec_M2:Cnt16:CounterUDB:reload\ | \QuadDec_M2:Cnt16:CounterUDB:reload\/main_0 | \QuadDec_M2:Cnt16:CounterUDB:reload\/q | 3.350
Route | | 1 | \QuadDec_M2:Cnt16:CounterUDB:reload\ | \QuadDec_M2:Cnt16:CounterUDB:reload\/q | \QuadDec_M2:Cnt16:CounterUDB:sC16:counterdp:u0\/cs_addr_0 | 6.723
datapathcell3 | U(3,4) | 1 | \QuadDec_M2:Cnt16:CounterUDB:sC16:counterdp:u0\ | \QuadDec_M2:Cnt16:CounterUDB:sC16:counterdp:u0\/cs_addr_0 | \QuadDec_M2:Cnt16:CounterUDB:sC16:counterdp:u0\/co_msb | 5.130
Route | | 1 | \QuadDec_M2:Cnt16:CounterUDB:sC16:counterdp:u0.co_msb__sig\ | \QuadDec_M2:Cnt16:CounterUDB:sC16:counterdp:u0\/co_msb | \QuadDec_M2:Cnt16:CounterUDB:sC16:counterdp:u1\/ci | 0.000
datapathcell4 | U(2,4) | 1 | \QuadDec_M2:Cnt16:CounterUDB:sC16:counterdp:u1\ | | SETUP | 4.230
Clock | | | | | Skew | 0.000
\QuadDec_M2:Cnt16:CounterUDB:sC16:counterdp:u0\/ff0 | \QuadDec_M2:Cnt16:CounterUDB:sC16:counterdp:u1\/ci | 33.997 MHz | 29.414 | 53.919

Type | Location | Fanout | Instance/Net | Source | Dest | Delay (ns)
datapathcell3 | U(3,4) | 1 | \QuadDec_M2:Cnt16:CounterUDB:sC16:counterdp:u0\ | \QuadDec_M2:Cnt16:CounterUDB:sC16:counterdp:u0\/clock | \QuadDec_M2:Cnt16:CounterUDB:sC16:counterdp:u0\/ff0 | 0.670
Route | | 1 | \QuadDec_M2:Cnt16:CounterUDB:sC16:counterdp:u0.ff0__sig\ | \QuadDec_M2:Cnt16:CounterUDB:sC16:counterdp:u0\/ff0 | \QuadDec_M2:Cnt16:CounterUDB:sC16:counterdp:u1\/ff0i | 0.000
datapathcell4 | U(2,4) | 1 | \QuadDec_M2:Cnt16:CounterUDB:sC16:counterdp:u1\ | \QuadDec_M2:Cnt16:CounterUDB:sC16:counterdp:u1\/ff0i | \QuadDec_M2:Cnt16:CounterUDB:sC16:counterdp:u1\/f0_comb | 2.720
Route | | 1 | \QuadDec_M2:Cnt16:CounterUDB:overflow\ | \QuadDec_M2:Cnt16:CounterUDB:sC16:counterdp:u1\/f0_comb | \QuadDec_M2:Cnt16:CounterUDB:reload\/main_2 | 6.591
macrocell11 | U(1,4) | 1 | \QuadDec_M2:Cnt16:CounterUDB:reload\ | \QuadDec_M2:Cnt16:CounterUDB:reload\/main_2 | \QuadDec_M2:Cnt16:CounterUDB:reload\/q | 3.350
Route | | 1 | \QuadDec_M2:Cnt16:CounterUDB:reload\ | \QuadDec_M2:Cnt16:CounterUDB:reload\/q | \QuadDec_M2:Cnt16:CounterUDB:sC16:counterdp:u0\/cs_addr_0 | 6.723
datapathcell3 | U(3,4) | 1 | \QuadDec_M2:Cnt16:CounterUDB:sC16:counterdp:u0\ | \QuadDec_M2:Cnt16:CounterUDB:sC16:counterdp:u0\/cs_addr_0 | \QuadDec_M2:Cnt16:CounterUDB:sC16:counterdp:u0\/co_msb | 5.130
Route | | 1 | \QuadDec_M2:Cnt16:CounterUDB:sC16:counterdp:u0.co_msb__sig\ | \QuadDec_M2:Cnt16:CounterUDB:sC16:counterdp:u0\/co_msb | \QuadDec_M2:Cnt16:CounterUDB:sC16:counterdp:u1\/ci | 0.000
datapathcell4 | U(2,4) | 1 | \QuadDec_M2:Cnt16:CounterUDB:sC16:counterdp:u1\ | | SETUP | 4.230
Clock | | | | | Skew | 0.000
\QuadDec_M2:Cnt16:CounterUDB:sC16:counterdp:u0\/z0 | \QuadDec_M2:Cnt16:CounterUDB:sC16:counterdp:u1\/ci | 34.263 MHz | 29.186 | 54.147

Type | Location | Fanout | Instance/Net | Source | Dest | Delay (ns)
datapathcell3 | U(3,4) | 1 | \QuadDec_M2:Cnt16:CounterUDB:sC16:counterdp:u0\ | \QuadDec_M2:Cnt16:CounterUDB:sC16:counterdp:u0\/clock | \QuadDec_M2:Cnt16:CounterUDB:sC16:counterdp:u0\/z0 | 0.760
Route | | 1 | \QuadDec_M2:Cnt16:CounterUDB:sC16:counterdp:u0.z0__sig\ | \QuadDec_M2:Cnt16:CounterUDB:sC16:counterdp:u0\/z0 | \QuadDec_M2:Cnt16:CounterUDB:sC16:counterdp:u1\/z0i | 0.000
datapathcell4 | U(2,4) | 1 | \QuadDec_M2:Cnt16:CounterUDB:sC16:counterdp:u1\ | \QuadDec_M2:Cnt16:CounterUDB:sC16:counterdp:u1\/z0i | \QuadDec_M2:Cnt16:CounterUDB:sC16:counterdp:u1\/z0_comb | 2.740
Route | | 1 | \QuadDec_M2:Cnt16:CounterUDB:status_1\ | \QuadDec_M2:Cnt16:CounterUDB:sC16:counterdp:u1\/z0_comb | \QuadDec_M2:Cnt16:CounterUDB:reload\/main_1 | 6.253
macrocell11 | U(1,4) | 1 | \QuadDec_M2:Cnt16:CounterUDB:reload\ | \QuadDec_M2:Cnt16:CounterUDB:reload\/main_1 | \QuadDec_M2:Cnt16:CounterUDB:reload\/q | 3.350
Route | | 1 | \QuadDec_M2:Cnt16:CounterUDB:reload\ | \QuadDec_M2:Cnt16:CounterUDB:reload\/q | \QuadDec_M2:Cnt16:CounterUDB:sC16:counterdp:u0\/cs_addr_0 | 6.723
datapathcell3 | U(3,4) | 1 | \QuadDec_M2:Cnt16:CounterUDB:sC16:counterdp:u0\ | \QuadDec_M2:Cnt16:CounterUDB:sC16:counterdp:u0\/cs_addr_0 | \QuadDec_M2:Cnt16:CounterUDB:sC16:counterdp:u0\/co_msb | 5.130
Route | | 1 | \QuadDec_M2:Cnt16:CounterUDB:sC16:counterdp:u0.co_msb__sig\ | \QuadDec_M2:Cnt16:CounterUDB:sC16:counterdp:u0\/co_msb | \QuadDec_M2:Cnt16:CounterUDB:sC16:counterdp:u1\/ci | 0.000
datapathcell4 | U(2,4) | 1 | \QuadDec_M2:Cnt16:CounterUDB:sC16:counterdp:u1\ | | SETUP | 4.230
Clock | | | | | Skew | 0.000
\QuadDec_M1:Cnt16:CounterUDB:sC16:counterdp:u0\/z0 | \QuadDec_M1:Cnt16:CounterUDB:sC16:counterdp:u1\/ci | 35.249 MHz | 28.370 | 54.963

Type | Location | Fanout | Instance/Net | Source | Dest | Delay (ns)
datapathcell1 | U(2,5) | 1 | \QuadDec_M1:Cnt16:CounterUDB:sC16:counterdp:u0\ | \QuadDec_M1:Cnt16:CounterUDB:sC16:counterdp:u0\/clock | \QuadDec_M1:Cnt16:CounterUDB:sC16:counterdp:u0\/z0 | 0.760
Route | | 1 | \QuadDec_M1:Cnt16:CounterUDB:sC16:counterdp:u0.z0__sig\ | \QuadDec_M1:Cnt16:CounterUDB:sC16:counterdp:u0\/z0 | \QuadDec_M1:Cnt16:CounterUDB:sC16:counterdp:u1\/z0i | 0.000
datapathcell2 | U(3,5) | 1 | \QuadDec_M1:Cnt16:CounterUDB:sC16:counterdp:u1\ | \QuadDec_M1:Cnt16:CounterUDB:sC16:counterdp:u1\/z0i | \QuadDec_M1:Cnt16:CounterUDB:sC16:counterdp:u1\/z0_comb | 2.740
Route | | 1 | \QuadDec_M1:Cnt16:CounterUDB:status_1\ | \QuadDec_M1:Cnt16:CounterUDB:sC16:counterdp:u1\/z0_comb | \QuadDec_M1:Cnt16:CounterUDB:reload\/main_1 | 6.825
macrocell2 | U(3,1) | 1 | \QuadDec_M1:Cnt16:CounterUDB:reload\ | \QuadDec_M1:Cnt16:CounterUDB:reload\/main_1 | \QuadDec_M1:Cnt16:CounterUDB:reload\/q | 3.350
Route | | 1 | \QuadDec_M1:Cnt16:CounterUDB:reload\ | \QuadDec_M1:Cnt16:CounterUDB:reload\/q | \QuadDec_M1:Cnt16:CounterUDB:sC16:counterdp:u0\/cs_addr_0 | 5.335
datapathcell1 | U(2,5) | 1 | \QuadDec_M1:Cnt16:CounterUDB:sC16:counterdp:u0\ | \QuadDec_M1:Cnt16:CounterUDB:sC16:counterdp:u0\/cs_addr_0 | \QuadDec_M1:Cnt16:CounterUDB:sC16:counterdp:u0\/co_msb | 5.130
Route | | 1 | \QuadDec_M1:Cnt16:CounterUDB:sC16:counterdp:u0.co_msb__sig\ | \QuadDec_M1:Cnt16:CounterUDB:sC16:counterdp:u0\/co_msb | \QuadDec_M1:Cnt16:CounterUDB:sC16:counterdp:u1\/ci | 0.000
datapathcell2 | U(3,5) | 1 | \QuadDec_M1:Cnt16:CounterUDB:sC16:counterdp:u1\ | | SETUP | 4.230
Clock | | | | | Skew | 0.000
\QuadDec_M2:Cnt16:CounterUDB:sC16:counterdp:u1\/f0_comb | \QuadDec_M2:Cnt16:CounterUDB:sC16:counterdp:u1\/ci | 35.431 MHz | 28.224 | 55.109

Type | Location | Fanout | Instance/Net | Source | Dest | Delay (ns)
datapathcell4 | U(2,4) | 1 | \QuadDec_M2:Cnt16:CounterUDB:sC16:counterdp:u1\ | \QuadDec_M2:Cnt16:CounterUDB:sC16:counterdp:u1\/clock | \QuadDec_M2:Cnt16:CounterUDB:sC16:counterdp:u1\/f0_comb | 2.200
Route | | 1 | \QuadDec_M2:Cnt16:CounterUDB:overflow\ | \QuadDec_M2:Cnt16:CounterUDB:sC16:counterdp:u1\/f0_comb | \QuadDec_M2:Cnt16:CounterUDB:reload\/main_2 | 6.591
macrocell11 | U(1,4) | 1 | \QuadDec_M2:Cnt16:CounterUDB:reload\ | \QuadDec_M2:Cnt16:CounterUDB:reload\/main_2 | \QuadDec_M2:Cnt16:CounterUDB:reload\/q | 3.350
Route | | 1 | \QuadDec_M2:Cnt16:CounterUDB:reload\ | \QuadDec_M2:Cnt16:CounterUDB:reload\/q | \QuadDec_M2:Cnt16:CounterUDB:sC16:counterdp:u0\/cs_addr_0 | 6.723
datapathcell3 | U(3,4) | 1 | \QuadDec_M2:Cnt16:CounterUDB:sC16:counterdp:u0\ | \QuadDec_M2:Cnt16:CounterUDB:sC16:counterdp:u0\/cs_addr_0 | \QuadDec_M2:Cnt16:CounterUDB:sC16:counterdp:u0\/co_msb | 5.130
Route | | 1 | \QuadDec_M2:Cnt16:CounterUDB:sC16:counterdp:u0.co_msb__sig\ | \QuadDec_M2:Cnt16:CounterUDB:sC16:counterdp:u0\/co_msb | \QuadDec_M2:Cnt16:CounterUDB:sC16:counterdp:u1\/ci | 0.000
datapathcell4 | U(2,4) | 1 | \QuadDec_M2:Cnt16:CounterUDB:sC16:counterdp:u1\ | | SETUP | 4.230
Clock | | | | | Skew | 0.000
\QuadDec_M2:Cnt16:CounterUDB:sC16:counterdp:u1\/z0_comb | \QuadDec_M2:Cnt16:CounterUDB:sC16:counterdp:u1\/ci | 35.745 MHz | 27.976 | 55.357

Type | Location | Fanout | Instance/Net | Source | Dest | Delay (ns)
datapathcell4 | U(2,4) | 1 | \QuadDec_M2:Cnt16:CounterUDB:sC16:counterdp:u1\ | \QuadDec_M2:Cnt16:CounterUDB:sC16:counterdp:u1\/clock | \QuadDec_M2:Cnt16:CounterUDB:sC16:counterdp:u1\/z0_comb | 2.290
Route | | 1 | \QuadDec_M2:Cnt16:CounterUDB:status_1\ | \QuadDec_M2:Cnt16:CounterUDB:sC16:counterdp:u1\/z0_comb | \QuadDec_M2:Cnt16:CounterUDB:reload\/main_1 | 6.253
macrocell11 | U(1,4) | 1 | \QuadDec_M2:Cnt16:CounterUDB:reload\ | \QuadDec_M2:Cnt16:CounterUDB:reload\/main_1 | \QuadDec_M2:Cnt16:CounterUDB:reload\/q | 3.350
Route | | 1 | \QuadDec_M2:Cnt16:CounterUDB:reload\ | \QuadDec_M2:Cnt16:CounterUDB:reload\/q | \QuadDec_M2:Cnt16:CounterUDB:sC16:counterdp:u0\/cs_addr_0 | 6.723
datapathcell3 | U(3,4) | 1 | \QuadDec_M2:Cnt16:CounterUDB:sC16:counterdp:u0\ | \QuadDec_M2:Cnt16:CounterUDB:sC16:counterdp:u0\/cs_addr_0 | \QuadDec_M2:Cnt16:CounterUDB:sC16:counterdp:u0\/co_msb | 5.130
Route | | 1 | \QuadDec_M2:Cnt16:CounterUDB:sC16:counterdp:u0.co_msb__sig\ | \QuadDec_M2:Cnt16:CounterUDB:sC16:counterdp:u0\/co_msb | \QuadDec_M2:Cnt16:CounterUDB:sC16:counterdp:u1\/ci | 0.000
datapathcell4 | U(2,4) | 1 | \QuadDec_M2:Cnt16:CounterUDB:sC16:counterdp:u1\ | | SETUP | 4.230
Clock | | | | | Skew | 0.000
\QuadDec_M1:Cnt16:CounterUDB:sC16:counterdp:u1\/z0_comb | \QuadDec_M1:Cnt16:CounterUDB:sC16:counterdp:u1\/ci | 36.819 MHz | 27.160 | 56.173

Type | Location | Fanout | Instance/Net | Source | Dest | Delay (ns)
datapathcell2 | U(3,5) | 1 | \QuadDec_M1:Cnt16:CounterUDB:sC16:counterdp:u1\ | \QuadDec_M1:Cnt16:CounterUDB:sC16:counterdp:u1\/clock | \QuadDec_M1:Cnt16:CounterUDB:sC16:counterdp:u1\/z0_comb | 2.290
Route | | 1 | \QuadDec_M1:Cnt16:CounterUDB:status_1\ | \QuadDec_M1:Cnt16:CounterUDB:sC16:counterdp:u1\/z0_comb | \QuadDec_M1:Cnt16:CounterUDB:reload\/main_1 | 6.825
macrocell2 | U(3,1) | 1 | \QuadDec_M1:Cnt16:CounterUDB:reload\ | \QuadDec_M1:Cnt16:CounterUDB:reload\/main_1 | \QuadDec_M1:Cnt16:CounterUDB:reload\/q | 3.350
Route | | 1 | \QuadDec_M1:Cnt16:CounterUDB:reload\ | \QuadDec_M1:Cnt16:CounterUDB:reload\/q | \QuadDec_M1:Cnt16:CounterUDB:sC16:counterdp:u0\/cs_addr_0 | 5.335
datapathcell1 | U(2,5) | 1 | \QuadDec_M1:Cnt16:CounterUDB:sC16:counterdp:u0\ | \QuadDec_M1:Cnt16:CounterUDB:sC16:counterdp:u0\/cs_addr_0 | \QuadDec_M1:Cnt16:CounterUDB:sC16:counterdp:u0\/co_msb | 5.130
Route | | 1 | \QuadDec_M1:Cnt16:CounterUDB:sC16:counterdp:u0.co_msb__sig\ | \QuadDec_M1:Cnt16:CounterUDB:sC16:counterdp:u0\/co_msb | \QuadDec_M1:Cnt16:CounterUDB:sC16:counterdp:u1\/ci | 0.000
datapathcell2 | U(3,5) | 1 | \QuadDec_M1:Cnt16:CounterUDB:sC16:counterdp:u1\ | | SETUP | 4.230
Clock | | | | | Skew | 0.000
\QuadDec_M2:Net_1260\/q | \QuadDec_M2:Cnt16:CounterUDB:sC16:counterdp:u0\/cs_addr_0 | 37.026 MHz | 27.008 | 56.325

Type | Location | Fanout | Instance/Net | Source | Dest | Delay (ns)
macrocell65 | U(3,3) | 1 | \QuadDec_M2:Net_1260\ | \QuadDec_M2:Net_1260\/clock_0 | \QuadDec_M2:Net_1260\/q | 1.250
Route | | 1 | \QuadDec_M2:Net_1260\ | \QuadDec_M2:Net_1260\/q | \QuadDec_M2:Cnt16:CounterUDB:reload\/main_0 | 9.625
macrocell11 | U(1,4) | 1 | \QuadDec_M2:Cnt16:CounterUDB:reload\ | \QuadDec_M2:Cnt16:CounterUDB:reload\/main_0 | \QuadDec_M2:Cnt16:CounterUDB:reload\/q | 3.350
Route | | 1 | \QuadDec_M2:Cnt16:CounterUDB:reload\ | \QuadDec_M2:Cnt16:CounterUDB:reload\/q | \QuadDec_M2:Cnt16:CounterUDB:sC16:counterdp:u0\/cs_addr_0 | 6.723
datapathcell3 | U(3,4) | 1 | \QuadDec_M2:Cnt16:CounterUDB:sC16:counterdp:u0\ | | SETUP | 6.060
Clock | | | | | Skew | 0.000
\QuadDec_M2:Net_1260\/q | \QuadDec_M2:Cnt16:CounterUDB:sC16:counterdp:u1\/cs_addr_0 | 37.029 MHz | 27.006 | 56.327

Type | Location | Fanout | Instance/Net | Source | Dest | Delay (ns)
macrocell65 | U(3,3) | 1 | \QuadDec_M2:Net_1260\ | \QuadDec_M2:Net_1260\/clock_0 | \QuadDec_M2:Net_1260\/q | 1.250
Route | | 1 | \QuadDec_M2:Net_1260\ | \QuadDec_M2:Net_1260\/q | \QuadDec_M2:Cnt16:CounterUDB:reload\/main_0 | 9.625
macrocell11 | U(1,4) | 1 | \QuadDec_M2:Cnt16:CounterUDB:reload\ | \QuadDec_M2:Cnt16:CounterUDB:reload\/main_0 | \QuadDec_M2:Cnt16:CounterUDB:reload\/q | 3.350
Route | | 1 | \QuadDec_M2:Cnt16:CounterUDB:reload\ | \QuadDec_M2:Cnt16:CounterUDB:reload\/q | \QuadDec_M2:Cnt16:CounterUDB:sC16:counterdp:u1\/cs_addr_0 | 6.721
datapathcell4 | U(2,4) | 1 | \QuadDec_M2:Cnt16:CounterUDB:sC16:counterdp:u1\ | | SETUP | 6.060
Clock | | | | | Skew | 0.000
\QuadDec_M1:Cnt16:CounterUDB:sC16:counterdp:u0\/ff0 | \QuadDec_M1:Cnt16:CounterUDB:sC16:counterdp:u1\/ci | 37.359 MHz | 26.767 | 56.566

Type | Location | Fanout | Instance/Net | Source | Dest | Delay (ns)
datapathcell1 | U(2,5) | 1 | \QuadDec_M1:Cnt16:CounterUDB:sC16:counterdp:u0\ | \QuadDec_M1:Cnt16:CounterUDB:sC16:counterdp:u0\/clock | \QuadDec_M1:Cnt16:CounterUDB:sC16:counterdp:u0\/ff0 | 0.670
Route | | 1 | \QuadDec_M1:Cnt16:CounterUDB:sC16:counterdp:u0.ff0__sig\ | \QuadDec_M1:Cnt16:CounterUDB:sC16:counterdp:u0\/ff0 | \QuadDec_M1:Cnt16:CounterUDB:sC16:counterdp:u1\/ff0i | 0.000
datapathcell2 | U(3,5) | 1 | \QuadDec_M1:Cnt16:CounterUDB:sC16:counterdp:u1\ | \QuadDec_M1:Cnt16:CounterUDB:sC16:counterdp:u1\/ff0i | \QuadDec_M1:Cnt16:CounterUDB:sC16:counterdp:u1\/f0_comb | 2.720
Route | | 1 | \QuadDec_M1:Cnt16:CounterUDB:overflow\ | \QuadDec_M1:Cnt16:CounterUDB:sC16:counterdp:u1\/f0_comb | \QuadDec_M1:Cnt16:CounterUDB:reload\/main_2 | 5.332
macrocell2 | U(3,1) | 1 | \QuadDec_M1:Cnt16:CounterUDB:reload\ | \QuadDec_M1:Cnt16:CounterUDB:reload\/main_2 | \QuadDec_M1:Cnt16:CounterUDB:reload\/q | 3.350
Route | | 1 | \QuadDec_M1:Cnt16:CounterUDB:reload\ | \QuadDec_M1:Cnt16:CounterUDB:reload\/q | \QuadDec_M1:Cnt16:CounterUDB:sC16:counterdp:u0\/cs_addr_0 | 5.335
datapathcell1 | U(2,5) | 1 | \QuadDec_M1:Cnt16:CounterUDB:sC16:counterdp:u0\ | \QuadDec_M1:Cnt16:CounterUDB:sC16:counterdp:u0\/cs_addr_0 | \QuadDec_M1:Cnt16:CounterUDB:sC16:counterdp:u0\/co_msb | 5.130
Route | | 1 | \QuadDec_M1:Cnt16:CounterUDB:sC16:counterdp:u0.co_msb__sig\ | \QuadDec_M1:Cnt16:CounterUDB:sC16:counterdp:u0\/co_msb | \QuadDec_M1:Cnt16:CounterUDB:sC16:counterdp:u1\/ci | 0.000
datapathcell2 | U(3,5) | 1 | \QuadDec_M1:Cnt16:CounterUDB:sC16:counterdp:u1\ | | SETUP | 4.230
Clock | | | | | Skew | 0.000

+ Source Clock : CyBUS_CLK : Positive edge(Required Frequency 60 MHz)

+ Destination Clock : ADC_IntClock : Positive edge(Required Frequency 2.85714 MHz)

Path Delay Requirement : 16.6667ns(60 MHz)

Affects clock : CyMASTER_CLK

Source | Destination | FMax | Delay (ns) | Slack (ns) | Violation
\ADC:bSAR_SEQ:bus_clk_nrq_reg\/q | Net_1497/main_0 | 119.332 MHz | 8.380 | 8.287

Type | Location | Fanout | Instance/Net | Source | Dest | Delay (ns)
macrocell140 | U(0,2) | 1 | \ADC:bSAR_SEQ:bus_clk_nrq_reg\ | \ADC:bSAR_SEQ:bus_clk_nrq_reg\/clock_0 | \ADC:bSAR_SEQ:bus_clk_nrq_reg\/q | 1.250
Route | | 1 | \ADC:bSAR_SEQ:bus_clk_nrq_reg\ | \ADC:bSAR_SEQ:bus_clk_nrq_reg\/q | Net_1497/main_0 | 3.620
macrocell139 | U(0,2) | 1 | Net_1497 | | SETUP | 3.510
Clock | | | | | Skew | 0.000
\ADC:bSAR_SEQ:bus_clk_nrq_reg\/q | \ADC:bSAR_SEQ:nrq_reg\/main_0 | 119.332 MHz | 8.380 | 8.287

Type | Location | Fanout | Instance/Net | Source | Dest | Delay (ns)
macrocell140 | U(0,2) | 1 | \ADC:bSAR_SEQ:bus_clk_nrq_reg\ | \ADC:bSAR_SEQ:bus_clk_nrq_reg\/clock_0 | \ADC:bSAR_SEQ:bus_clk_nrq_reg\/q | 1.250
Route | | 1 | \ADC:bSAR_SEQ:bus_clk_nrq_reg\ | \ADC:bSAR_SEQ:bus_clk_nrq_reg\/q | \ADC:bSAR_SEQ:nrq_reg\/main_0 | 3.620
macrocell141 | U(0,2) | 1 | \ADC:bSAR_SEQ:nrq_reg\ | | SETUP | 3.510
Clock | | | | | Skew | 0.000

+ Destination Clock : Clock_QENC : Positive edge(Required Frequency 12 MHz)

Path Delay Requirement : 16.6667ns(60 MHz)

Affects clock : CyMASTER_CLK

Source | Destination | FMax | Delay (ns) | Slack (ns) | Violation
M1_QB(0)_SYNC/out | \QuadDec_M1:bQuadDec:quad_A_delayed_0\/main_0 | 134.662 MHz | 7.426 | 9.241

Type | Location | Fanout | Instance/Net | Source | Dest | Delay (ns)
synccell | U(1,2) | 1 | M1_QB(0)_SYNC | M1_QB(0)_SYNC/clock | M1_QB(0)_SYNC/out | 1.020
Route | | 1 | Net_724_SYNCOUT | M1_QB(0)_SYNC/out | \QuadDec_M1:bQuadDec:quad_A_delayed_0\/main_0 | 2.896
macrocell29 | U(1,3) | 1 | \QuadDec_M1:bQuadDec:quad_A_delayed_0\ | | SETUP | 3.510
Clock | | | | | Skew | 0.000
M2_QA(0)_SYNC/out | \QuadDec_M2:bQuadDec:quad_B_delayed_0\/main_0 | 145.794 MHz | 6.859 | 9.808

Type | Location | Fanout | Instance/Net | Source | Dest | Delay (ns)
synccell | U(3,1) | 1 | M2_QA(0)_SYNC | M2_QA(0)_SYNC/clock | M2_QA(0)_SYNC/out | 1.020
Route | | 1 | Net_4544_SYNCOUT | M2_QA(0)_SYNC/out | \QuadDec_M2:bQuadDec:quad_B_delayed_0\/main_0 | 2.329
macrocell38 | U(3,1) | 1 | \QuadDec_M2:bQuadDec:quad_B_delayed_0\ | | SETUP | 3.510
Clock | | | | | Skew | 0.000
M2_QB(0)_SYNC/out | \QuadDec_M2:bQuadDec:quad_A_delayed_0\/main_0 | 146.434 MHz | 6.829 | 9.838

Type | Location | Fanout | Instance/Net | Source | Dest | Delay (ns)
synccell | U(1,2) | 1 | M2_QB(0)_SYNC | M2_QB(0)_SYNC/clock | M2_QB(0)_SYNC/out | 1.020
Route | | 1 | Net_4542_SYNCOUT | M2_QB(0)_SYNC/out | \QuadDec_M2:bQuadDec:quad_A_delayed_0\/main_0 | 2.299
macrocell35 | U(1,2) | 1 | \QuadDec_M2:bQuadDec:quad_A_delayed_0\ | | SETUP | 3.510
Clock | | | | | Skew | 0.000
M1_QA(0)_SYNC/out | \QuadDec_M1:bQuadDec:quad_B_delayed_0\/main_0 | 147.754 MHz | 6.768 | 9.899

Type | Location | Fanout | Instance/Net | Source | Dest | Delay (ns)
synccell | U(3,0) | 1 | M1_QA(0)_SYNC | M1_QA(0)_SYNC/clock | M1_QA(0)_SYNC/out | 1.020
Route | | 1 | Net_725_SYNCOUT | M1_QA(0)_SYNC/out | \QuadDec_M1:bQuadDec:quad_B_delayed_0\/main_0 | 2.238
macrocell32 | U(3,0) | 1 | \QuadDec_M1:bQuadDec:quad_B_delayed_0\ | | SETUP | 3.510
Clock | | | | | Skew | 0.000

+ Destination Clock : CyBUS_CLK : Positive edge(Required Frequency 60 MHz)

Path Delay Requirement : 16.6667ns(60 MHz)

Source | Destination | FMax | Delay (ns) | Slack (ns) | Violation
\ADC:bSAR_SEQ:bus_clk_nrq_reg\/q | \ADC:bSAR_SEQ:bus_clk_nrq_reg\/main_0 | 111.982 MHz | 8.930 | 7.737

Type | Location | Fanout | Instance/Net | Source | Dest | Delay (ns)
macrocell140 | U(0,2) | 1 | \ADC:bSAR_SEQ:bus_clk_nrq_reg\ | \ADC:bSAR_SEQ:bus_clk_nrq_reg\/clock_0 | \ADC:bSAR_SEQ:bus_clk_nrq_reg\/q | 1.250
macrocell140 | U(0,2) | 1 | \ADC:bSAR_SEQ:bus_clk_nrq_reg\ | \ADC:bSAR_SEQ:bus_clk_nrq_reg\/q | \ADC:bSAR_SEQ:bus_clk_nrq_reg\/main_0 | 4.170
macrocell140 | U(0,2) | 1 | \ADC:bSAR_SEQ:bus_clk_nrq_reg\ | | SETUP | 3.510
Clock | | | | | Skew | 0.000
\ADC:Sync:genblk1[0]:INST\/out | \ADC:bSAR_SEQ:bus_clk_nrq_reg\/main_1 | 145.709 MHz | 6.863 | 9.804

Type | Location | Fanout | Instance/Net | Source | Dest | Delay (ns)
synccell | U(1,2) | 1 | \ADC:Sync:genblk1[0]:INST\ | \ADC:Sync:genblk1[0]:INST\/clock | \ADC:Sync:genblk1[0]:INST\/out | 1.020
Route | | 1 | \ADC:Net_3935\ | \ADC:Sync:genblk1[0]:INST\/out | \ADC:bSAR_SEQ:bus_clk_nrq_reg\/main_1 | 2.333
macrocell140 | U(0,2) | 1 | \ADC:bSAR_SEQ:bus_clk_nrq_reg\ | | SETUP | 3.510
Clock | | | | | Skew | 0.000

+ Destination Clock : UART_IntClock : Positive edge(Required Frequency 461.538 kHz)

Path Delay Requirement : 16.6667ns(60 MHz)

Affects clock : CyMASTER_CLK

Source | Destination | FMax | Delay (ns) | Slack (ns) | Violation
\RF_BT_SELECT:Sync:ctrl_reg\/control_0 | \UART:BUART:rx_state_0\/main_3 | 64.238 MHz | 15.567 | 1.100

Type | Location | Fanout | Instance/Net | Source | Dest | Delay (ns)
controlcell5 | U(0,4) | 1 | \RF_BT_SELECT:Sync:ctrl_reg\ | \RF_BT_SELECT:Sync:ctrl_reg\/busclk | \RF_BT_SELECT:Sync:ctrl_reg\/control_0 | 2.050
Route | | 1 | Net_3437 | \RF_BT_SELECT:Sync:ctrl_reg\/control_0 | \UART:BUART:rx_postpoll\/main_2 | 3.739
macrocell25 | U(0,4) | 1 | \UART:BUART:rx_postpoll\ | \UART:BUART:rx_postpoll\/main_2 | \UART:BUART:rx_postpoll\/q | 3.350
Route | | 1 | \UART:BUART:rx_postpoll\ | \UART:BUART:rx_postpoll\/q | \UART:BUART:rx_state_0\/main_3 | 2.918
macrocell153 | U(0,3) | 1 | \UART:BUART:rx_state_0\ | | SETUP | 3.510
Clock | | | | | Skew | 0.000
\RF_BT_SELECT:Sync:ctrl_reg\/control_0 | \UART:BUART:rx_status_3\/main_3 | 64.238 MHz | 15.567 | 1.100

Type | Location | Fanout | Instance/Net | Source | Dest | Delay (ns)
controlcell5 | U(0,4) | 1 | \RF_BT_SELECT:Sync:ctrl_reg\ | \RF_BT_SELECT:Sync:ctrl_reg\/busclk | \RF_BT_SELECT:Sync:ctrl_reg\/control_0 | 2.050
Route | | 1 | Net_3437 | \RF_BT_SELECT:Sync:ctrl_reg\/control_0 | \UART:BUART:rx_postpoll\/main_2 | 3.739
macrocell25 | U(0,4) | 1 | \UART:BUART:rx_postpoll\ | \UART:BUART:rx_postpoll\/main_2 | \UART:BUART:rx_postpoll\/q | 3.350
Route | | 1 | \UART:BUART:rx_postpoll\ | \UART:BUART:rx_postpoll\/q | \UART:BUART:rx_status_3\/main_3 | 2.918
macrocell162 | U(0,3) | 1 | \UART:BUART:rx_status_3\ | | SETUP | 3.510
Clock | | | | | Skew | 0.000
\RF_BT_SELECT:Sync:ctrl_reg\/control_0 | \UART:BUART:sRX:RxShifter:u0\/route_si | 64.371 MHz | 15.535 | 1.132

Type | Location | Fanout | Instance/Net | Source | Dest | Delay (ns)
controlcell5 | U(0,4) | 1 | \RF_BT_SELECT:Sync:ctrl_reg\ | \RF_BT_SELECT:Sync:ctrl_reg\/busclk | \RF_BT_SELECT:Sync:ctrl_reg\/control_0 | 2.050
Route | | 1 | Net_3437 | \RF_BT_SELECT:Sync:ctrl_reg\/control_0 | \UART:BUART:rx_postpoll\/main_2 | 3.739
macrocell25 | U(0,4) | 1 | \UART:BUART:rx_postpoll\ | \UART:BUART:rx_postpoll\/main_2 | \UART:BUART:rx_postpoll\/q | 3.350
Route | | 1 | \UART:BUART:rx_postpoll\ | \UART:BUART:rx_postpoll\/q | \UART:BUART:sRX:RxShifter:u0\/route_si | 2.926
datapathcell7 | U(0,5) | 1 | \UART:BUART:sRX:RxShifter:u0\ | | SETUP | 3.470
Clock | | | | | Skew | 0.000
Rx_1(0)_SYNC/out | \UART:BUART:rx_state_0\/main_3 | 71.927 MHz | 13.903 | 2.764

Type | Location | Fanout | Instance/Net | Source | Dest | Delay (ns)
synccell | U(0,4) | 1 | Rx_1(0)_SYNC | Rx_1(0)_SYNC/clock | Rx_1(0)_SYNC/out | 1.020
Route | | 1 | Net_3438_SYNCOUT | Rx_1(0)_SYNC/out | \UART:BUART:rx_postpoll\/main_3 | 3.105
macrocell25 | U(0,4) | 1 | \UART:BUART:rx_postpoll\ | \UART:BUART:rx_postpoll\/main_3 | \UART:BUART:rx_postpoll\/q | 3.350
Route | | 1 | \UART:BUART:rx_postpoll\ | \UART:BUART:rx_postpoll\/q | \UART:BUART:rx_state_0\/main_3 | 2.918
macrocell153 | U(0,3) | 1 | \UART:BUART:rx_state_0\ | | SETUP | 3.510
Clock | | | | | Skew | 0.000
Rx_1(0)_SYNC/out | \UART:BUART:rx_status_3\/main_3 | 71.927 MHz | 13.903 | 2.764

Type | Location | Fanout | Instance/Net | Source | Dest | Delay (ns)
synccell | U(0,4) | 1 | Rx_1(0)_SYNC | Rx_1(0)_SYNC/clock | Rx_1(0)_SYNC/out | 1.020
Route | | 1 | Net_3438_SYNCOUT | Rx_1(0)_SYNC/out | \UART:BUART:rx_postpoll\/main_3 | 3.105
macrocell25 | U(0,4) | 1 | \UART:BUART:rx_postpoll\ | \UART:BUART:rx_postpoll\/main_3 | \UART:BUART:rx_postpoll\/q | 3.350
Route | | 1 | \UART:BUART:rx_postpoll\ | \UART:BUART:rx_postpoll\/q | \UART:BUART:rx_status_3\/main_3 | 2.918
macrocell162 | U(0,3) | 1 | \UART:BUART:rx_status_3\ | | SETUP | 3.510
Clock | | | | | Skew | 0.000
Rx_1(0)_SYNC/out | \UART:BUART:sRX:RxShifter:u0\/route_si | 72.093 MHz | 13.871 | 2.796

Type | Location | Fanout | Instance/Net | Source | Dest | Delay (ns)
synccell | U(0,4) | 1 | Rx_1(0)_SYNC | Rx_1(0)_SYNC/clock | Rx_1(0)_SYNC/out | 1.020
Route | | 1 | Net_3438_SYNCOUT | Rx_1(0)_SYNC/out | \UART:BUART:rx_postpoll\/main_3 | 3.105
macrocell25 | U(0,4) | 1 | \UART:BUART:rx_postpoll\ | \UART:BUART:rx_postpoll\/main_3 | \UART:BUART:rx_postpoll\/q | 3.350
Route | | 1 | \UART:BUART:rx_postpoll\ | \UART:BUART:rx_postpoll\/q | \UART:BUART:sRX:RxShifter:u0\/route_si | 2.926
datapathcell7 | U(0,5) | 1 | \UART:BUART:sRX:RxShifter:u0\ | | SETUP | 3.470
Clock | | | | | Skew | 0.000
Rx_2(0)_SYNC/out | \UART:BUART:rx_state_0\/main_3 | 74.460 MHz | 13.430 | 3.237

Type | Location | Fanout | Instance/Net | Source | Dest | Delay (ns)
synccell | U(0,4) | 1 | Rx_2(0)_SYNC | Rx_2(0)_SYNC/clock | Rx_2(0)_SYNC/out | 1.020
Route | | 1 | Net_3405_SYNCOUT | Rx_2(0)_SYNC/out | \UART:BUART:rx_postpoll\/main_4 | 2.632
macrocell25 | U(0,4) | 1 | \UART:BUART:rx_postpoll\ | \UART:BUART:rx_postpoll\/main_4 | \UART:BUART:rx_postpoll\/q | 3.350
Route | | 1 | \UART:BUART:rx_postpoll\ | \UART:BUART:rx_postpoll\/q | \UART:BUART:rx_state_0\/main_3 | 2.918
macrocell153 | U(0,3) | 1 | \UART:BUART:rx_state_0\ | | SETUP | 3.510
Clock | | | | | Skew | 0.000
Rx_2(0)_SYNC/out | \UART:BUART:rx_status_3\/main_3 | 74.460 MHz | 13.430 | 3.237

Type | Location | Fanout | Instance/Net | Source | Dest | Delay (ns)
synccell | U(0,4) | 1 | Rx_2(0)_SYNC | Rx_2(0)_SYNC/clock | Rx_2(0)_SYNC/out | 1.020
Route | | 1 | Net_3405_SYNCOUT | Rx_2(0)_SYNC/out | \UART:BUART:rx_postpoll\/main_4 | 2.632
macrocell25 | U(0,4) | 1 | \UART:BUART:rx_postpoll\ | \UART:BUART:rx_postpoll\/main_4 | \UART:BUART:rx_postpoll\/q | 3.350
Route | | 1 | \UART:BUART:rx_postpoll\ | \UART:BUART:rx_postpoll\/q | \UART:BUART:rx_status_3\/main_3 | 2.918
macrocell162 | U(0,3) | 1 | \UART:BUART:rx_status_3\ | | SETUP | 3.510
Clock | | | | | Skew | 0.000
Rx_2(0)_SYNC/out | \UART:BUART:sRX:RxShifter:u0\/route_si | 74.638 MHz | 13.398 | 3.269

Type | Location | Fanout | Instance/Net | Source | Dest | Delay (ns)
synccell | U(0,4) | 1 | Rx_2(0)_SYNC | Rx_2(0)_SYNC/clock | Rx_2(0)_SYNC/out | 1.020
Route | | 1 | Net_3405_SYNCOUT | Rx_2(0)_SYNC/out | \UART:BUART:rx_postpoll\/main_4 | 2.632
macrocell25 | U(0,4) | 1 | \UART:BUART:rx_postpoll\ | \UART:BUART:rx_postpoll\/main_4 | \UART:BUART:rx_postpoll\/q | 3.350
Route | | 1 | \UART:BUART:rx_postpoll\ | \UART:BUART:rx_postpoll\/q | \UART:BUART:sRX:RxShifter:u0\/route_si | 2.926
datapathcell7 | U(0,5) | 1 | \UART:BUART:sRX:RxShifter:u0\ | | SETUP | 3.470
Clock | | | | | Skew | 0.000
\RF_BT_SELECT:Sync:ctrl_reg\/control_0 | \UART:BUART:pollcount_0\/main_3 | 79.821 MHz | 12.528 | 4.139

Type | Location | Fanout | Instance/Net | Source | Dest | Delay (ns)
controlcell5 | U(0,4) | 1 | \RF_BT_SELECT:Sync:ctrl_reg\ | \RF_BT_SELECT:Sync:ctrl_reg\/busclk | \RF_BT_SELECT:Sync:ctrl_reg\/control_0 | 2.050
Route | | 1 | Net_3437 | \RF_BT_SELECT:Sync:ctrl_reg\/control_0 | \UART:BUART:pollcount_0\/main_3 | 6.968
macrocell160 | U(0,5) | 1 | \UART:BUART:pollcount_0\ | | SETUP | 3.510
Clock | | | | | Skew | 0.000

+ Source Clock : UART_IntClock : Positive edge(Required Frequency 461.538 kHz)

+ Destination Clock : UART_IntClock : Positive edge(Required Frequency 461.538 kHz)

Path Delay Requirement : 2166.67ns(461.538 kHz)

Source | Destination | FMax | Delay (ns) | Slack (ns) | Violation
\UART:BUART:tx_state_0\/q | \UART:BUART:sTX:sCLOCK:TxBitClkGen\/cs_addr_0 | 47.081 MHz | 21.240 | 2145.427

Type | Location | Fanout | Instance/Net | Source | Dest | Delay (ns)
macrocell149 | U(0,5) | 1 | \UART:BUART:tx_state_0\ | \UART:BUART:tx_state_0\/clock_0 | \UART:BUART:tx_state_0\/q | 1.250
Route | | 1 | \UART:BUART:tx_state_0\ | \UART:BUART:tx_state_0\/q | \UART:BUART:counter_load_not\/main_1 | 7.526
macrocell21 | U(1,2) | 1 | \UART:BUART:counter_load_not\ | \UART:BUART:counter_load_not\/main_1 | \UART:BUART:counter_load_not\/q | 3.350
Route | | 1 | \UART:BUART:counter_load_not\ | \UART:BUART:counter_load_not\/q | \UART:BUART:sTX:sCLOCK:TxBitClkGen\/cs_addr_0 | 2.924
datapathcell6 | U(1,3) | 1 | \UART:BUART:sTX:sCLOCK:TxBitClkGen\ | | SETUP | 6.190
Clock | | | | | Skew | 0.000
\UART:BUART:tx_state_0\/q | \UART:BUART:sTX:TxSts\/status_0 | 48.347 MHz | 20.684 | 2145.983

Type | Location | Fanout | Instance/Net | Source | Dest | Delay (ns)
macrocell149 | U(0,5) | 1 | \UART:BUART:tx_state_0\ | \UART:BUART:tx_state_0\/clock_0 | \UART:BUART:tx_state_0\/q | 1.250
Route | | 1 | \UART:BUART:tx_state_0\ | \UART:BUART:tx_state_0\/q | \UART:BUART:tx_status_0\/main_1 | 9.368
macrocell22 | U(1,1) | 1 | \UART:BUART:tx_status_0\ | \UART:BUART:tx_status_0\/main_1 | \UART:BUART:tx_status_0\/q | 3.350
Route | | 1 | \UART:BUART:tx_status_0\ | \UART:BUART:tx_status_0\/q | \UART:BUART:sTX:TxSts\/status_0 | 6.216
statusicell5 | U(2,1) | 1 | \UART:BUART:sTX:TxSts\ | | SETUP | 0.500
Clock | | | | | Skew | 0.000
\UART:BUART:sTX:TxShifter:u0\/f0_blk_stat_comb | \UART:BUART:sTX:TxSts\/status_0 | 50.485 MHz | 19.808 | 2146.859

Type | Location | Fanout | Instance/Net | Source | Dest | Delay (ns)
datapathcell5 | U(1,5) | 1 | \UART:BUART:sTX:TxShifter:u0\ | \UART:BUART:sTX:TxShifter:u0\/clock | \UART:BUART:sTX:TxShifter:u0\/f0_blk_stat_comb | 3.580
Route | | 1 | \UART:BUART:tx_fifo_empty\ | \UART:BUART:sTX:TxShifter:u0\/f0_blk_stat_comb | \UART:BUART:tx_status_0\/main_3 | 6.162
macrocell22 | U(1,1) | 1 | \UART:BUART:tx_status_0\ | \UART:BUART:tx_status_0\/main_3 | \UART:BUART:tx_status_0\/q | 3.350
Route | | 1 | \UART:BUART:tx_status_0\ | \UART:BUART:tx_status_0\/q | \UART:BUART:sTX:TxSts\/status_0 | 6.216
statusicell5 | U(2,1) | 1 | \UART:BUART:sTX:TxSts\ | | SETUP | 0.500
Clock | | | | | Skew | 0.000
\UART:BUART:rx_state_2\/q | \UART:BUART:sRX:RxBitCounter\/load | 52.997 MHz | 18.869 | 2147.798

Type | Location | Fanout | Instance/Net | Source | Dest | Delay (ns)
macrocell156 | U(0,4) | 1 | \UART:BUART:rx_state_2\ | \UART:BUART:rx_state_2\/clock_0 | \UART:BUART:rx_state_2\/q | 1.250
Route | | 1 | \UART:BUART:rx_state_2\ | \UART:BUART:rx_state_2\/q | \UART:BUART:rx_counter_load\/main_3 | 5.974
macrocell24 | U(0,2) | 1 | \UART:BUART:rx_counter_load\ | \UART:BUART:rx_counter_load\/main_3 | \UART:BUART:rx_counter_load\/q | 3.350
Route | | 1 | \UART:BUART:rx_counter_load\ | \UART:BUART:rx_counter_load\/q | \UART:BUART:sRX:RxBitCounter\/load | 2.935
count7cell | U(1,3) | 1 | \UART:BUART:sRX:RxBitCounter\ | | SETUP | 5.360
Clock | | | | | Skew | 0.000
\UART:BUART:tx_state_1\/q | \UART:BUART:sTX:sCLOCK:TxBitClkGen\/cs_addr_0 | 58.038 MHz | 17.230 | 2149.437

Type | Location | Fanout | Instance/Net | Source | Dest | Delay (ns)
macrocell148 | U(1,2) | 1 | \UART:BUART:tx_state_1\ | \UART:BUART:tx_state_1\/clock_0 | \UART:BUART:tx_state_1\/q | 1.250
Route | | 1 | \UART:BUART:tx_state_1\ | \UART:BUART:tx_state_1\/q | \UART:BUART:counter_load_not\/main_0 | 3.516
macrocell21 | U(1,2) | 1 | \UART:BUART:counter_load_not\ | \UART:BUART:counter_load_not\/main_0 | \UART:BUART:counter_load_not\/q | 3.350
Route | | 1 | \UART:BUART:counter_load_not\ | \UART:BUART:counter_load_not\/q | \UART:BUART:sTX:sCLOCK:TxBitClkGen\/cs_addr_0 | 2.924
datapathcell6 | U(1,3) | 1 | \UART:BUART:sTX:sCLOCK:TxBitClkGen\ | | SETUP | 6.190
Clock | | | | | Skew | 0.000
\UART:BUART:rx_state_3\/q | \UART:BUART:sRX:RxBitCounter\/load | 58.052 MHz | 17.226 | 2149.441

Type | Location | Fanout | Instance/Net | Source | Dest | Delay (ns)
macrocell155 | U(0,4) | 1 | \UART:BUART:rx_state_3\ | \UART:BUART:rx_state_3\/clock_0 | \UART:BUART:rx_state_3\/q | 1.250
Route | | 1 | \UART:BUART:rx_state_3\ | \UART:BUART:rx_state_3\/q | \UART:BUART:rx_counter_load\/main_2 | 4.331
macrocell24 | U(0,2) | 1 | \UART:BUART:rx_counter_load\ | \UART:BUART:rx_counter_load\/main_2 | \UART:BUART:rx_counter_load\/q | 3.350
Route | | 1 | \UART:BUART:rx_counter_load\ | \UART:BUART:rx_counter_load\/q | \UART:BUART:sRX:RxBitCounter\/load | 2.935
count7cell | U(1,3) | 1 | \UART:BUART:sRX:RxBitCounter\ | | SETUP | 5.360
Clock | | | | | Skew | 0.000
\UART:BUART:rx_state_0\/q | \UART:BUART:sRX:RxBitCounter\/load | 60.824 MHz | 16.441 | 2150.226

Type | Location | Fanout | Instance/Net | Source | Dest | Delay (ns)
macrocell153 | U(0,3) | 1 | \UART:BUART:rx_state_0\ | \UART:BUART:rx_state_0\/clock_0 | \UART:BUART:rx_state_0\/q | 1.250
Route | | 1 | \UART:BUART:rx_state_0\ | \UART:BUART:rx_state_0\/q | \UART:BUART:rx_counter_load\/main_1 | 3.546
macrocell24 | U(0,2) | 1 | \UART:BUART:rx_counter_load\ | \UART:BUART:rx_counter_load\/main_1 | \UART:BUART:rx_counter_load\/q | 3.350
Route | | 1 | \UART:BUART:rx_counter_load\ | \UART:BUART:rx_counter_load\/q | \UART:BUART:sRX:RxBitCounter\/load | 2.935
count7cell | U(1,3) | 1 | \UART:BUART:sRX:RxBitCounter\ | | SETUP | 5.360
Clock | | | | | Skew | 0.000
\UART:BUART:tx_state_2\/q | \UART:BUART:sTX:sCLOCK:TxBitClkGen\/cs_addr_0 | 61.185 MHz | 16.344 | 2150.323

Type | Location | Fanout | Instance/Net | Source | Dest | Delay (ns)
macrocell150 | U(1,2) | 1 | \UART:BUART:tx_state_2\ | \UART:BUART:tx_state_2\/clock_0 | \UART:BUART:tx_state_2\/q | 1.250
Route | | 1 | \UART:BUART:tx_state_2\ | \UART:BUART:tx_state_2\/q | \UART:BUART:counter_load_not\/main_3 | 2.630
macrocell21 | U(1,2) | 1 | \UART:BUART:counter_load_not\ | \UART:BUART:counter_load_not\/main_3 | \UART:BUART:counter_load_not\/q | 3.350
Route | | 1 | \UART:BUART:counter_load_not\ | \UART:BUART:counter_load_not\/q | \UART:BUART:sTX:sCLOCK:TxBitClkGen\/cs_addr_0 | 2.924
datapathcell6 | U(1,3) | 1 | \UART:BUART:sTX:sCLOCK:TxBitClkGen\ | | SETUP | 6.190
Clock | | | | | Skew | 0.000
\UART:BUART:sTX:sCLOCK:TxBitClkGen\/ce0_reg | \UART:BUART:sTX:sCLOCK:TxBitClkGen\/cs_addr_0 | 61.614 MHz | 16.230 | 2150.437

Type | Location | Fanout | Instance/Net | Source | Dest | Delay (ns)
datapathcell6 | U(1,3) | 1 | \UART:BUART:sTX:sCLOCK:TxBitClkGen\ | \UART:BUART:sTX:sCLOCK:TxBitClkGen\/clock | \UART:BUART:sTX:sCLOCK:TxBitClkGen\/ce0_reg | 0.190
Route | | 1 | \UART:BUART:tx_bitclk_enable_pre\ | \UART:BUART:sTX:sCLOCK:TxBitClkGen\/ce0_reg | \UART:BUART:counter_load_not\/main_2 | 3.576
macrocell21 | U(1,2) | 1 | \UART:BUART:counter_load_not\ | \UART:BUART:counter_load_not\/main_2 | \UART:BUART:counter_load_not\/q | 3.350
Route | | 1 | \UART:BUART:counter_load_not\ | \UART:BUART:counter_load_not\/q | \UART:BUART:sTX:sCLOCK:TxBitClkGen\/cs_addr_0 | 2.924
datapathcell6 | U(1,3) | 1 | \UART:BUART:sTX:sCLOCK:TxBitClkGen\ | | SETUP | 6.190
Clock | | | | | Skew | 0.000
\UART:BUART:tx_state_1\/q | \UART:BUART:sTX:TxSts\/status_0 | 62.664 MHz | 15.958 | 2150.709

Type | Location | Fanout | Instance/Net | Source | Dest | Delay (ns)
macrocell148 | U(1,2) | 1 | \UART:BUART:tx_state_1\ | \UART:BUART:tx_state_1\/clock_0 | \UART:BUART:tx_state_1\/q | 1.250
Route | | 1 | \UART:BUART:tx_state_1\ | \UART:BUART:tx_state_1\/q | \UART:BUART:tx_status_0\/main_0 | 4.642
macrocell22 | U(1,1) | 1 | \UART:BUART:tx_status_0\ | \UART:BUART:tx_status_0\/main_0 | \UART:BUART:tx_status_0\/q | 3.350
Route | | 1 | \UART:BUART:tx_status_0\ | \UART:BUART:tx_status_0\/q | \UART:BUART:sTX:TxSts\/status_0 | 6.216
statusicell5 | U(2,1) | 1 | \UART:BUART:sTX:TxSts\ | | SETUP | 0.500
Clock | | | | | Skew | 0.000

+ Hold Subsection

+ Source Clock : ADC_IntClock : Positive edge

+ Destination Clock : ADC_IntClock : Positive edge

Source | Destination | Slack (ns) | Violation
\ADC:bSAR_SEQ:CtrlReg\/control_0 | Net_1497/clk_en | 2.659

Type | Location | Fanout | Instance/Net | Source | Dest | Delay (ns)
controlcell3 | U(0,2) | 1 | \ADC:bSAR_SEQ:CtrlReg\ | \ADC:bSAR_SEQ:CtrlReg\/clock | \ADC:bSAR_SEQ:CtrlReg\/control_0 | 0.360
Route | | 1 | \ADC:bSAR_SEQ:enable\ | \ADC:bSAR_SEQ:CtrlReg\/control_0 | Net_1497/clk_en | 2.299
macrocell139 | U(0,2) | 1 | Net_1497 | | HOLD | 0.000
Clock | | | | | Skew | 0.000
\ADC:bSAR_SEQ:CtrlReg\/control_0 | \ADC:bSAR_SEQ:nrq_reg\/clk_en | 2.659

Type | Location | Fanout | Instance/Net | Source | Dest | Delay (ns)
controlcell3 | U(0,2) | 1 | \ADC:bSAR_SEQ:CtrlReg\ | \ADC:bSAR_SEQ:CtrlReg\/clock | \ADC:bSAR_SEQ:CtrlReg\/control_0 | 0.360
Route | | 1 | \ADC:bSAR_SEQ:enable\ | \ADC:bSAR_SEQ:CtrlReg\/control_0 | \ADC:bSAR_SEQ:nrq_reg\/clk_en | 2.299
macrocell141 | U(0,2) | 1 | \ADC:bSAR_SEQ:nrq_reg\ | | HOLD | 0.000
Clock | | | | | Skew | 0.000
\ADC:bSAR_SEQ:ChannelCounter\/tc | \ADC:soc_out\/main_5 | 2.899

Type | Location | Fanout | Instance/Net | Source | Dest | Delay (ns)
count7cell | U(0,0) | 1 | \ADC:bSAR_SEQ:ChannelCounter\ | \ADC:bSAR_SEQ:ChannelCounter\/clock | \ADC:bSAR_SEQ:ChannelCounter\/tc | 0.650
Route | | 1 | \ADC:bSAR_SEQ:cnt_tc\ | \ADC:bSAR_SEQ:ChannelCounter\/tc | \ADC:soc_out\/main_5 | 2.249
macrocell143 | U(0,0) | 1 | \ADC:soc_out\ | | HOLD | 0.000
Clock | | | | | Skew | 0.000
\ADC:bSAR_SEQ:soc_in\/q | \ADC:soc_out\/main_3 | 3.478

Type | Location | Fanout | Instance/Net | Source | Dest | Delay (ns)
macrocell142 | U(0,0) | 1 | \ADC:bSAR_SEQ:soc_in\ | \ADC:bSAR_SEQ:soc_in\/clock_0 | \ADC:bSAR_SEQ:soc_in\/q | 1.250
Route | | 1 | \ADC:bSAR_SEQ:soc_in\ | \ADC:bSAR_SEQ:soc_in\/q | \ADC:soc_out\/main_3 | 2.228
macrocell143 | U(0,0) | 1 | \ADC:soc_out\ | | HOLD | 0.000
Clock | | | | | Skew | 0.000
\ADC:bSAR_SEQ:soc_reg\/q | \ADC:bSAR_SEQ:soc_in\/main_0 | 3.479

Type | Location | Fanout | Instance/Net | Source | Dest | Delay (ns)
macrocell144 | U(0,0) | 1 | \ADC:bSAR_SEQ:soc_reg\ | \ADC:bSAR_SEQ:soc_reg\/clock_0 | \ADC:bSAR_SEQ:soc_reg\/q | 1.250
Route | | 1 | \ADC:bSAR_SEQ:soc_reg\ | \ADC:bSAR_SEQ:soc_reg\/q | \ADC:bSAR_SEQ:soc_in\/main_0 | 2.229
macrocell142 | U(0,0) | 1 | \ADC:bSAR_SEQ:soc_in\ | | HOLD | 0.000
Clock | | | | | Skew | 0.000
\ADC:bSAR_SEQ:state_1\/q | \ADC:soc_out\/main_4 | 3.496

Type | Location | Fanout | Instance/Net | Source | Dest | Delay (ns)
macrocell145 | U(0,0) | 1 | \ADC:bSAR_SEQ:state_1\ | \ADC:bSAR_SEQ:state_1\/clock_0 | \ADC:bSAR_SEQ:state_1\/q | 1.250
Route | | 1 | \ADC:bSAR_SEQ:state_1\ | \ADC:bSAR_SEQ:state_1\/q | \ADC:soc_out\/main_4 | 2.246
macrocell143 | U(0,0) | 1 | \ADC:soc_out\ | | HOLD | 0.000
Clock | | | | | Skew | 0.000
\ADC:bSAR_SEQ:state_1\/q | \ADC:bSAR_SEQ:state_1\/main_3 | 3.496

Type | Location | Fanout | Instance/Net | Source | Dest | Delay (ns)
macrocell145 | U(0,0) | 1 | \ADC:bSAR_SEQ:state_1\ | \ADC:bSAR_SEQ:state_1\/clock_0 | \ADC:bSAR_SEQ:state_1\/q | 1.250
macrocell145 | U(0,0) | 1 | \ADC:bSAR_SEQ:state_1\ | \ADC:bSAR_SEQ:state_1\/q | \ADC:bSAR_SEQ:state_1\/main_3 | 2.246
macrocell145 | U(0,0) | 1 | \ADC:bSAR_SEQ:state_1\ | | HOLD | 0.000
Clock | | | | | Skew | 0.000
\ADC:bSAR_SEQ:nrq_reg\/q | Net_1497/main_1 | 3.556

Type | Location | Fanout | Instance/Net | Source | Dest | Delay (ns)
macrocell141 | U(0,2) | 1 | \ADC:bSAR_SEQ:nrq_reg\ | \ADC:bSAR_SEQ:nrq_reg\/clock_0 | \ADC:bSAR_SEQ:nrq_reg\/q | 1.250
Route | | 1 | \ADC:bSAR_SEQ:nrq_reg\ | \ADC:bSAR_SEQ:nrq_reg\/q | Net_1497/main_1 | 2.306
macrocell139 | U(0,2) | 1 | Net_1497 | | HOLD | 0.000
Clock | | | | | Skew | 0.000
\ADC:bSAR_SEQ:CtrlReg\/control_0 | \ADC:bSAR_SEQ:EOCSts\/clk_en | 3.586

Type | Location | Fanout | Instance/Net | Source | Dest | Delay (ns)
controlcell3 | U(0,2) | 1 | \ADC:bSAR_SEQ:CtrlReg\ | \ADC:bSAR_SEQ:CtrlReg\/clock | \ADC:bSAR_SEQ:CtrlReg\/control_0 | 0.360
Route | | 1 | \ADC:bSAR_SEQ:enable\ | \ADC:bSAR_SEQ:CtrlReg\/control_0 | \ADC:bSAR_SEQ:EOCSts\/clk_en | 3.226
statuscell1 | U(0,3) | 1 | \ADC:bSAR_SEQ:EOCSts\ | | HOLD | 0.000
Clock | | | | | Skew | 0.000
\ADC:bSAR_SEQ:ChannelCounter\/count_2 | \ADC:AMuxHw_2_Decoder_old_id_2\/main_0 | 3.902

Type | Location | Fanout | Instance/Net | Source | Dest | Delay (ns)
count7cell | U(0,0) | 1 | \ADC:bSAR_SEQ:ChannelCounter\ | \ADC:bSAR_SEQ:ChannelCounter\/clock | \ADC:bSAR_SEQ:ChannelCounter\/count_2 | 0.620
Route | | 1 | \ADC:ch_addr_2\ | \ADC:bSAR_SEQ:ChannelCounter\/count_2 | \ADC:AMuxHw_2_Decoder_old_id_2\/main_0 | 3.282
macrocell72 | U(0,1) | 1 | \ADC:AMuxHw_2_Decoder_old_id_2\ | | HOLD | 0.000
Clock | | | | | Skew | 0.000

+ Destination Clock : CyBUS_CLK : Positive edge

Source | Destination | Slack (ns) | Violation
Net_1497/q | \ADC:bSAR_SEQ:bus_clk_nrq_reg\/main_2 | 3.539

Type | Location | Fanout | Instance/Net | Source | Dest | Delay (ns)
macrocell139 | U(0,2) | 1 | Net_1497 | Net_1497/clock_0 | Net_1497/q | 1.250
Route | | 1 | Net_1497 | Net_1497/q | \ADC:bSAR_SEQ:bus_clk_nrq_reg\/main_2 | 2.289
macrocell140 | U(0,2) | 1 | \ADC:bSAR_SEQ:bus_clk_nrq_reg\ | | HOLD | 0.000
Clock | | | | | Skew | 0.000

+ Source Clock : Clock_QENC : Positive edge

+ Destination Clock : Clock_QENC : Positive edge

Source | Destination | Slack (ns) | Violation
\QuadDec_M1:Cnt16:CounterUDB:sC16:counterdp:u0\/co_msb | \QuadDec_M1:Cnt16:CounterUDB:sC16:counterdp:u1\/ci | 2.140

Type | Location | Fanout | Instance/Net | Source | Dest | Delay (ns)
datapathcell1 | U(2,5) | 1 | \QuadDec_M1:Cnt16:CounterUDB:sC16:counterdp:u0\ | \QuadDec_M1:Cnt16:CounterUDB:sC16:counterdp:u0\/clock | \QuadDec_M1:Cnt16:CounterUDB:sC16:counterdp:u0\/co_msb | 2.140
Route | | 1 | \QuadDec_M1:Cnt16:CounterUDB:sC16:counterdp:u0.co_msb__sig\ | \QuadDec_M1:Cnt16:CounterUDB:sC16:counterdp:u0\/co_msb | \QuadDec_M1:Cnt16:CounterUDB:sC16:counterdp:u1\/ci | 0.000
datapathcell2 | U(3,5) | 1 | \QuadDec_M1:Cnt16:CounterUDB:sC16:counterdp:u1\ | | HOLD | 0.000
Clock | | | | | Skew | 0.000
\QuadDec_M2:Cnt16:CounterUDB:sC16:counterdp:u0\/co_msb | \QuadDec_M2:Cnt16:CounterUDB:sC16:counterdp:u1\/ci | 2.140

Type | Location | Fanout | Instance/Net | Source | Dest | Delay (ns)
datapathcell3 | U(3,4) | 1 | \QuadDec_M2:Cnt16:CounterUDB:sC16:counterdp:u0\ | \QuadDec_M2:Cnt16:CounterUDB:sC16:counterdp:u0\/clock | \QuadDec_M2:Cnt16:CounterUDB:sC16:counterdp:u0\/co_msb | 2.140
Route | | 1 | \QuadDec_M2:Cnt16:CounterUDB:sC16:counterdp:u0.co_msb__sig\ | \QuadDec_M2:Cnt16:CounterUDB:sC16:counterdp:u0\/co_msb | \QuadDec_M2:Cnt16:CounterUDB:sC16:counterdp:u1\/ci | 0.000
datapathcell4 | U(2,4) | 1 | \QuadDec_M2:Cnt16:CounterUDB:sC16:counterdp:u1\ | | HOLD | 0.000
Clock | | | | | Skew | 0.000
\QuadDec_M1:bQuadDec:quad_B_delayed_0\/q | \QuadDec_M1:bQuadDec:quad_B_delayed_1\/main_0 | 3.495

Type | Location | Fanout | Instance/Net | Source | Dest | Delay (ns)
macrocell32 | U(3,0) | 1 | \QuadDec_M1:bQuadDec:quad_B_delayed_0\ | \QuadDec_M1:bQuadDec:quad_B_delayed_0\/clock_0 | \QuadDec_M1:bQuadDec:quad_B_delayed_0\/q | 1.250
Route | | 1 | \QuadDec_M1:bQuadDec:quad_B_delayed_0\ | \QuadDec_M1:bQuadDec:quad_B_delayed_0\/q | \QuadDec_M1:bQuadDec:quad_B_delayed_1\/main_0 | 2.245
macrocell33 | U(2,0) | 1 | \QuadDec_M1:bQuadDec:quad_B_delayed_1\ | | HOLD | 0.000
Clock | | | | | Skew | 0.000
\QuadDec_M2:bQuadDec:quad_A_delayed_0\/q | \QuadDec_M2:bQuadDec:quad_A_delayed_1\/main_0 | 3.545

Type | Location | Fanout | Instance/Net | Source | Dest | Delay (ns)
macrocell35 | U(1,2) | 1 | \QuadDec_M2:bQuadDec:quad_A_delayed_0\ | \QuadDec_M2:bQuadDec:quad_A_delayed_0\/clock_0 | \QuadDec_M2:bQuadDec:quad_A_delayed_0\/q | 1.250
Route | | 1 | \QuadDec_M2:bQuadDec:quad_A_delayed_0\ | \QuadDec_M2:bQuadDec:quad_A_delayed_0\/q | \QuadDec_M2:bQuadDec:quad_A_delayed_1\/main_0 | 2.295
macrocell36 | U(1,2) | 1 | \QuadDec_M2:bQuadDec:quad_A_delayed_1\ | | HOLD | 0.000
Clock | | | | | Skew | 0.000
\QuadDec_M2:bQuadDec:quad_A_delayed_0\/q | \QuadDec_M2:bQuadDec:quad_A_filt\/main_0 | 3.545

Type | Location | Fanout | Instance/Net | Source | Dest | Delay (ns)
macrocell35 | U(1,2) | 1 | \QuadDec_M2:bQuadDec:quad_A_delayed_0\ | \QuadDec_M2:bQuadDec:quad_A_delayed_0\/clock_0 | \QuadDec_M2:bQuadDec:quad_A_delayed_0\/q | 1.250
Route | | 1 | \QuadDec_M2:bQuadDec:quad_A_delayed_0\ | \QuadDec_M2:bQuadDec:quad_A_delayed_0\/q | \QuadDec_M2:bQuadDec:quad_A_filt\/main_0 | 2.295
macrocell63 | U(1,2) | 1 | \QuadDec_M2:bQuadDec:quad_A_filt\ | | HOLD | 0.000
Clock | | | | | Skew | 0.000
\QuadDec_M1:bQuadDec:quad_A_delayed_0\/q | \QuadDec_M1:bQuadDec:quad_A_delayed_1\/main_0 | 3.549

Type | Location | Fanout | Instance/Net | Source | Dest | Delay (ns)
macrocell29 | U(1,3) | 1 | \QuadDec_M1:bQuadDec:quad_A_delayed_0\ | \QuadDec_M1:bQuadDec:quad_A_delayed_0\/clock_0 | \QuadDec_M1:bQuadDec:quad_A_delayed_0\/q | 1.250
Route | | 1 | \QuadDec_M1:bQuadDec:quad_A_delayed_0\ | \QuadDec_M1:bQuadDec:quad_A_delayed_0\/q | \QuadDec_M1:bQuadDec:quad_A_delayed_1\/main_0 | 2.299
macrocell30 | U(1,3) | 1 | \QuadDec_M1:bQuadDec:quad_A_delayed_1\ | | HOLD | 0.000
Clock | | | | | Skew | 0.000
\QuadDec_M2:bQuadDec:quad_A_delayed_1\/q | \QuadDec_M2:bQuadDec:quad_A_delayed_2\/main_0 | 3.549

Type | Location | Fanout | Instance/Net | Source | Dest | Delay (ns)
macrocell36 | U(1,2) | 1 | \QuadDec_M2:bQuadDec:quad_A_delayed_1\ | \QuadDec_M2:bQuadDec:quad_A_delayed_1\/clock_0 | \QuadDec_M2:bQuadDec:quad_A_delayed_1\/q | 1.250
Route | | 1 | \QuadDec_M2:bQuadDec:quad_A_delayed_1\ | \QuadDec_M2:bQuadDec:quad_A_delayed_1\/q | \QuadDec_M2:bQuadDec:quad_A_delayed_2\/main_0 | 2.299
macrocell37 | U(1,2) | 1 | \QuadDec_M2:bQuadDec:quad_A_delayed_2\ | | HOLD | 0.000
Clock | | | | | Skew | 0.000
\QuadDec_M1:bQuadDec:quad_A_delayed_0\/q | \QuadDec_M1:bQuadDec:quad_A_filt\/main_0 | 3.549

Type | Location | Fanout | Instance/Net | Source | Dest | Delay (ns)
macrocell29 | U(1,3) | 1 | \QuadDec_M1:bQuadDec:quad_A_delayed_0\ | \QuadDec_M1:bQuadDec:quad_A_delayed_0\/clock_0 | \QuadDec_M1:bQuadDec:quad_A_delayed_0\/q | 1.250
Route | | 1 | \QuadDec_M1:bQuadDec:quad_A_delayed_0\ | \QuadDec_M1:bQuadDec:quad_A_delayed_0\/q | \QuadDec_M1:bQuadDec:quad_A_filt\/main_0 | 2.299
macrocell49 | U(1,3) | 1 | \QuadDec_M1:bQuadDec:quad_A_filt\ | | HOLD | 0.000
Clock | | | | | Skew | 0.000
\QuadDec_M2:bQuadDec:quad_A_delayed_1\/q | \QuadDec_M2:bQuadDec:quad_A_filt\/main_1 | 3.549

Type | Location | Fanout | Instance/Net | Source | Dest | Delay (ns)
macrocell36 | U(1,2) | 1 | \QuadDec_M2:bQuadDec:quad_A_delayed_1\ | \QuadDec_M2:bQuadDec:quad_A_delayed_1\/clock_0 | \QuadDec_M2:bQuadDec:quad_A_delayed_1\/q | 1.250
Route | | 1 | \QuadDec_M2:bQuadDec:quad_A_delayed_1\ | \QuadDec_M2:bQuadDec:quad_A_delayed_1\/q | \QuadDec_M2:bQuadDec:quad_A_filt\/main_1 | 2.299
macrocell63 | U(1,2) | 1 | \QuadDec_M2:bQuadDec:quad_A_filt\ | | HOLD | 0.000
Clock | | | | | Skew | 0.000
\QuadDec_M1:bQuadDec:quad_A_delayed_2\/q | \QuadDec_M1:bQuadDec:quad_A_filt\/main_2 | 3.550

Type | Location | Fanout | Instance/Net | Source | Dest | Delay (ns)
macrocell31 | U(1,3) | 1 | \QuadDec_M1:bQuadDec:quad_A_delayed_2\ | \QuadDec_M1:bQuadDec:quad_A_delayed_2\/clock_0 | \QuadDec_M1:bQuadDec:quad_A_delayed_2\/q | 1.250
Route | | 1 | \QuadDec_M1:bQuadDec:quad_A_delayed_2\ | \QuadDec_M1:bQuadDec:quad_A_delayed_2\/q | \QuadDec_M1:bQuadDec:quad_A_filt\/main_2 | 2.300
macrocell49 | U(1,3) | 1 | \QuadDec_M1:bQuadDec:quad_A_filt\ | | HOLD | 0.000
Clock | | | | | Skew | 0.000

+ Source Clock : CyBUS_CLK : Positive edge

+ Destination Clock : ADC_IntClock : Positive edge

Source | Destination | Slack (ns) | Violation
\ADC:bSAR_SEQ:bus_clk_nrq_reg\/q | Net_1497/main_0 | 4.870

Type | Location | Fanout | Instance/Net | Source | Dest | Delay (ns)
macrocell140 | U(0,2) | 1 | \ADC:bSAR_SEQ:bus_clk_nrq_reg\ | \ADC:bSAR_SEQ:bus_clk_nrq_reg\/clock_0 | \ADC:bSAR_SEQ:bus_clk_nrq_reg\/q | 1.250
Route | | 1 | \ADC:bSAR_SEQ:bus_clk_nrq_reg\ | \ADC:bSAR_SEQ:bus_clk_nrq_reg\/q | Net_1497/main_0 | 3.620
macrocell139 | U(0,2) | 1 | Net_1497 | | HOLD | 0.000
Clock | | | | | Skew | 0.000
\ADC:bSAR_SEQ:bus_clk_nrq_reg\/q | \ADC:bSAR_SEQ:nrq_reg\/main_0 | 4.870

Type | Location | Fanout | Instance/Net | Source | Dest | Delay (ns)
macrocell140 | U(0,2) | 1 | \ADC:bSAR_SEQ:bus_clk_nrq_reg\ | \ADC:bSAR_SEQ:bus_clk_nrq_reg\/clock_0 | \ADC:bSAR_SEQ:bus_clk_nrq_reg\/q | 1.250
Route | | 1 | \ADC:bSAR_SEQ:bus_clk_nrq_reg\ | \ADC:bSAR_SEQ:bus_clk_nrq_reg\/q | \ADC:bSAR_SEQ:nrq_reg\/main_0 | 3.620
macrocell141 | U(0,2) | 1 | \ADC:bSAR_SEQ:nrq_reg\ | | HOLD | 0.000
Clock | | | | | Skew | 0.000

+ Destination Clock : Clock_QENC : Positive edge

Source | Destination | Slack (ns) | Violation
M1_QA(0)_SYNC/out | \QuadDec_M1:bQuadDec:quad_B_delayed_0\/main_0 | 2.588

Type | Location | Fanout | Instance/Net | Source | Dest | Delay (ns)
synccell | U(3,0) | 1 | M1_QA(0)_SYNC | M1_QA(0)_SYNC/clock | M1_QA(0)_SYNC/out | 0.350
Route | | 1 | Net_725_SYNCOUT | M1_QA(0)_SYNC/out | \QuadDec_M1:bQuadDec:quad_B_delayed_0\/main_0 | 2.238
macrocell32 | U(3,0) | 1 | \QuadDec_M1:bQuadDec:quad_B_delayed_0\ | | HOLD | 0.000
Clock | | | | | Skew | 0.000
M2_QB(0)_SYNC/out | \QuadDec_M2:bQuadDec:quad_A_delayed_0\/main_0 | 2.649

Type | Location | Fanout | Instance/Net | Source | Dest | Delay (ns)
synccell | U(1,2) | 1 | M2_QB(0)_SYNC | M2_QB(0)_SYNC/clock | M2_QB(0)_SYNC/out | 0.350
Route | | 1 | Net_4542_SYNCOUT | M2_QB(0)_SYNC/out | \QuadDec_M2:bQuadDec:quad_A_delayed_0\/main_0 | 2.299
macrocell35 | U(1,2) | 1 | \QuadDec_M2:bQuadDec:quad_A_delayed_0\ | | HOLD | 0.000
Clock | | | | | Skew | 0.000
M2_QA(0)_SYNC/out | \QuadDec_M2:bQuadDec:quad_B_delayed_0\/main_0 | 2.679

Type | Location | Fanout | Instance/Net | Source | Dest | Delay (ns)
synccell | U(3,1) | 1 | M2_QA(0)_SYNC | M2_QA(0)_SYNC/clock | M2_QA(0)_SYNC/out | 0.350
Route | | 1 | Net_4544_SYNCOUT | M2_QA(0)_SYNC/out | \QuadDec_M2:bQuadDec:quad_B_delayed_0\/main_0 | 2.329
macrocell38 | U(3,1) | 1 | \QuadDec_M2:bQuadDec:quad_B_delayed_0\ | | HOLD | 0.000
Clock | | | | | Skew | 0.000
M1_QB(0)_SYNC/out | \QuadDec_M1:bQuadDec:quad_A_delayed_0\/main_0 | 3.246

Type | Location | Fanout | Instance/Net | Source | Dest | Delay (ns)
synccell | U(1,2) | 1 | M1_QB(0)_SYNC | M1_QB(0)_SYNC/clock | M1_QB(0)_SYNC/out | 0.350
Route | | 1 | Net_724_SYNCOUT | M1_QB(0)_SYNC/out | \QuadDec_M1:bQuadDec:quad_A_delayed_0\/main_0 | 2.896
macrocell29 | U(1,3) | 1 | \QuadDec_M1:bQuadDec:quad_A_delayed_0\ | | HOLD | 0.000
Clock | | | | | Skew | 0.000

+ Destination Clock : CyBUS_CLK : Positive edge

Source | Destination | Slack (ns) | Violation
\ADC:Sync:genblk1[0]:INST\/out | \ADC:bSAR_SEQ:bus_clk_nrq_reg\/main_1 | 2.683

Type | Location | Fanout | Instance/Net | Source | Dest | Delay (ns)
synccell | U(1,2) | 1 | \ADC:Sync:genblk1[0]:INST\ | \ADC:Sync:genblk1[0]:INST\/clock | \ADC:Sync:genblk1[0]:INST\/out | 0.350
Route | | 1 | \ADC:Net_3935\ | \ADC:Sync:genblk1[0]:INST\/out | \ADC:bSAR_SEQ:bus_clk_nrq_reg\/main_1 | 2.333
macrocell140 | U(0,2) | 1 | \ADC:bSAR_SEQ:bus_clk_nrq_reg\ | | HOLD | 0.000
Clock | | | | | Skew | 0.000
\ADC:bSAR_SEQ:bus_clk_nrq_reg\/q | \ADC:bSAR_SEQ:bus_clk_nrq_reg\/main_0 | 5.420

Type | Location | Fanout | Instance/Net | Source | Dest | Delay (ns)
macrocell140 | U(0,2) | 1 | \ADC:bSAR_SEQ:bus_clk_nrq_reg\ | \ADC:bSAR_SEQ:bus_clk_nrq_reg\/clock_0 | \ADC:bSAR_SEQ:bus_clk_nrq_reg\/q | 1.250
macrocell140 | U(0,2) | 1 | \ADC:bSAR_SEQ:bus_clk_nrq_reg\ | \ADC:bSAR_SEQ:bus_clk_nrq_reg\/q | \ADC:bSAR_SEQ:bus_clk_nrq_reg\/main_0 | 4.170
macrocell140 | U(0,2) | 1 | \ADC:bSAR_SEQ:bus_clk_nrq_reg\ | | HOLD | 0.000
Clock | | | | | Skew | 0.000

+ Destination Clock : UART_IntClock : Positive edge

Source | Destination | Slack (ns) | Violation
Rx_2(0)_SYNC/out | \UART:BUART:rx_state_2\/main_11 | 2.971

Type | Location | Fanout | Instance/Net | Source | Dest | Delay (ns)
synccell | U(0,4) | 1 | Rx_2(0)_SYNC | Rx_2(0)_SYNC/clock | Rx_2(0)_SYNC/out | 0.350
Route | | 1 | Net_3405_SYNCOUT | Rx_2(0)_SYNC/out | \UART:BUART:rx_state_2\/main_11 | 2.621
macrocell156 | U(0,4) | 1 | \UART:BUART:rx_state_2\ | | HOLD | 0.000
Clock | | | | | Skew | 0.000
Rx_2(0)_SYNC/out | \UART:BUART:pollcount_1\/main_6 | 2.982

Type | Location | Fanout | Instance/Net | Source | Dest | Delay (ns)
synccell | U(0,4) | 1 | Rx_2(0)_SYNC | Rx_2(0)_SYNC/clock | Rx_2(0)_SYNC/out | 0.350
Route | | 1 | Net_3405_SYNCOUT | Rx_2(0)_SYNC/out | \UART:BUART:pollcount_1\/main_6 | 2.632
macrocell159 | U(0,4) | 1 | \UART:BUART:pollcount_1\ | | HOLD | 0.000
Clock | | | | | Skew | 0.000
Rx_1(0)_SYNC/out | \UART:BUART:pollcount_1\/main_5 | 3.455

Type | Location | Fanout | Instance/Net | Source | Dest | Delay (ns)
synccell | U(0,4) | 1 | Rx_1(0)_SYNC | Rx_1(0)_SYNC/clock | Rx_1(0)_SYNC/out | 0.350
Route | | 1 | Net_3438_SYNCOUT | Rx_1(0)_SYNC/out | \UART:BUART:pollcount_1\/main_5 | 3.105
macrocell159 | U(0,4) | 1 | \UART:BUART:pollcount_1\ | | HOLD | 0.000
Clock | | | | | Skew | 0.000
Rx_1(0)_SYNC/out | \UART:BUART:rx_state_2\/main_10 | 3.478

Type | Location | Fanout | Instance/Net | Source | Dest | Delay (ns)
synccell | U(0,4) | 1 | Rx_1(0)_SYNC | Rx_1(0)_SYNC/clock | Rx_1(0)_SYNC/out | 0.350
Route | | 1 | Net_3438_SYNCOUT | Rx_1(0)_SYNC/out | \UART:BUART:rx_state_2\/main_10 | 3.128
macrocell156 | U(0,4) | 1 | \UART:BUART:rx_state_2\ | | HOLD | 0.000
Clock | | | | | Skew | 0.000
Rx_2(0)_SYNC/out | \UART:BUART:pollcount_0\/main_5 | 3.845

Type | Location | Fanout | Instance/Net | Source | Dest | Delay (ns)
synccell | U(0,4) | 1 | Rx_2(0)_SYNC | Rx_2(0)_SYNC/clock | Rx_2(0)_SYNC/out | 0.350
Route | | 1 | Net_3405_SYNCOUT | Rx_2(0)_SYNC/out | \UART:BUART:pollcount_0\/main_5 | 3.495
macrocell160 | U(0,5) | 1 | \UART:BUART:pollcount_0\ | | HOLD | 0.000
Clock | | | | | Skew | 0.000
Rx_2(0)_SYNC/out | \UART:BUART:rx_last\/main_2 | 3.911

Type | Location | Fanout | Instance/Net | Source | Dest | Delay (ns)
synccell | U(0,4) | 1 | Rx_2(0)_SYNC | Rx_2(0)_SYNC/clock | Rx_2(0)_SYNC/out | 0.350
Route | | 1 | Net_3405_SYNCOUT | Rx_2(0)_SYNC/out | \UART:BUART:rx_last\/main_2 | 3.561
macrocell163 | U(0,3) | 1 | \UART:BUART:rx_last\ | | HOLD | 0.000
Clock | | | | | Skew | 0.000
Rx_1(0)_SYNC/out | \UART:BUART:pollcount_0\/main_4 | 4.224

Type | Location | Fanout | Instance/Net | Source | Dest | Delay (ns)
synccell | U(0,4) | 1 | Rx_1(0)_SYNC | Rx_1(0)_SYNC/clock | Rx_1(0)_SYNC/out | 0.350
Route | | 1 | Net_3438_SYNCOUT | Rx_1(0)_SYNC/out | \UART:BUART:pollcount_0\/main_4 | 3.874
macrocell160 | U(0,5) | 1 | \UART:BUART:pollcount_0\ | | HOLD | 0.000
Clock | | | | | Skew | 0.000
\RF_BT_SELECT:Sync:ctrl_reg\/control_0 | \UART:BUART:pollcount_1\/main_4 | 4.359

Type | Location | Fanout | Instance/Net | Source | Dest | Delay (ns)
controlcell5 | U(0,4) | 1 | \RF_BT_SELECT:Sync:ctrl_reg\ | \RF_BT_SELECT:Sync:ctrl_reg\/busclk | \RF_BT_SELECT:Sync:ctrl_reg\/control_0 | 0.620
Route | | 1 | Net_3437 | \RF_BT_SELECT:Sync:ctrl_reg\/control_0 | \UART:BUART:pollcount_1\/main_4 | 3.739
macrocell159 | U(0,4) | 1 | \UART:BUART:pollcount_1\ | | HOLD | 0.000
Clock | | | | | Skew | 0.000
Rx_1(0)_SYNC/out | \UART:BUART:rx_last\/main_1 | 4.411

Type | Location | Fanout | Instance/Net | Source | Dest | Delay (ns)
synccell | U(0,4) | 1 | Rx_1(0)_SYNC | Rx_1(0)_SYNC/clock | Rx_1(0)_SYNC/out | 0.350
Route | | 1 | Net_3438_SYNCOUT | Rx_1(0)_SYNC/out | \UART:BUART:rx_last\/main_1 | 4.061
macrocell163 | U(0,3) | 1 | \UART:BUART:rx_last\ | | HOLD | 0.000
Clock | | | | | Skew | 0.000
\RF_BT_SELECT:Sync:ctrl_reg\/control_0 | \UART:BUART:rx_last\/main_0 | 5.283

Type | Location | Fanout | Instance/Net | Source | Dest | Delay (ns)
controlcell5 | U(0,4) | 1 | \RF_BT_SELECT:Sync:ctrl_reg\ | \RF_BT_SELECT:Sync:ctrl_reg\/busclk | \RF_BT_SELECT:Sync:ctrl_reg\/control_0 | 0.620
Route | | 1 | Net_3437 | \RF_BT_SELECT:Sync:ctrl_reg\/control_0 | \UART:BUART:rx_last\/main_0 | 4.663
macrocell163 | U(0,3) | 1 | \UART:BUART:rx_last\ | | HOLD | 0.000
Clock | | | | | Skew | 0.000

+ Source Clock : UART_IntClock : Positive edge

+ Destination Clock : UART_IntClock : Positive edge

Source | Destination | Slack (ns) | Violation
\UART:BUART:rx_status_3\/q | \UART:BUART:sRX:RxSts\/status_3 | 2.890

Type | Location | Fanout | Instance/Net | Source | Dest | Delay (ns)
macrocell162 | U(0,3) | 1 | \UART:BUART:rx_status_3\ | \UART:BUART:rx_status_3\/clock_0 | \UART:BUART:rx_status_3\/q | 1.250
Route | | 1 | \UART:BUART:rx_status_3\ | \UART:BUART:rx_status_3\/q | \UART:BUART:sRX:RxSts\/status_3 | 3.640
statusicell6 | U(0,1) | 1 | \UART:BUART:sRX:RxSts\ | | HOLD | -2.000
Clock | | | | | Skew | 0.000
\UART:BUART:sRX:RxBitCounter\/count_4 | \UART:BUART:rx_state_0\/main_8 | 2.956

Type | Location | Fanout | Instance/Net | Source | Dest | Delay (ns)
count7cell | U(1,3) | 1 | \UART:BUART:sRX:RxBitCounter\ | \UART:BUART:sRX:RxBitCounter\/clock | \UART:BUART:sRX:RxBitCounter\/count_4 | 0.620
Route | | 1 | \UART:BUART:rx_count_4\ | \UART:BUART:sRX:RxBitCounter\/count_4 | \UART:BUART:rx_state_0\/main_8 | 2.336
macrocell153 | U(0,3) | 1 | \UART:BUART:rx_state_0\ | | HOLD | 0.000
Clock | | | | | Skew | 0.000
\UART:BUART:sTX:sCLOCK:TxBitClkGen\/ce1_reg | \UART:BUART:txn\/main_5 | 3.084

Type | Location | Fanout | Instance/Net | Source | Dest | Delay (ns)
datapathcell6 | U(1,3) | 1 | \UART:BUART:sTX:sCLOCK:TxBitClkGen\ | \UART:BUART:sTX:sCLOCK:TxBitClkGen\/clock | \UART:BUART:sTX:sCLOCK:TxBitClkGen\/ce1_reg | 0.190
Route | | 1 | \UART:BUART:tx_counter_dp\ | \UART:BUART:sTX:sCLOCK:TxBitClkGen\/ce1_reg | \UART:BUART:txn\/main_5 | 2.894
macrocell147 | U(1,4) | 1 | \UART:BUART:txn\ | | HOLD | 0.000
Clock | | | | | Skew | 0.000
\UART:BUART:sTX:sCLOCK:TxBitClkGen\/ce1_reg | \UART:BUART:tx_state_1\/main_4 | 3.132

Type | Location | Fanout | Instance/Net | Source | Dest | Delay (ns)
datapathcell6 | U(1,3) | 1 | \UART:BUART:sTX:sCLOCK:TxBitClkGen\ | \UART:BUART:sTX:sCLOCK:TxBitClkGen\/clock | \UART:BUART:sTX:sCLOCK:TxBitClkGen\/ce1_reg | 0.190
Route | | 1 | \UART:BUART:tx_counter_dp\ | \UART:BUART:sTX:sCLOCK:TxBitClkGen\/ce1_reg | \UART:BUART:tx_state_1\/main_4 | 2.942
macrocell148 | U(1,2) | 1 | \UART:BUART:tx_state_1\ | | HOLD | 0.000
Clock | | | | | Skew | 0.000
\UART:BUART:sTX:sCLOCK:TxBitClkGen\/ce1_reg | \UART:BUART:tx_state_2\/main_4 | 3.132

Type | Location | Fanout | Instance/Net | Source | Dest | Delay (ns)
datapathcell6 | U(1,3) | 1 | \UART:BUART:sTX:sCLOCK:TxBitClkGen\ | \UART:BUART:sTX:sCLOCK:TxBitClkGen\/clock | \UART:BUART:sTX:sCLOCK:TxBitClkGen\/ce1_reg | 0.190
Route | | 1 | \UART:BUART:tx_counter_dp\ | \UART:BUART:sTX:sCLOCK:TxBitClkGen\/ce1_reg | \UART:BUART:tx_state_2\/main_4 | 2.942
macrocell150 | U(1,2) | 1 | \UART:BUART:tx_state_2\ | | HOLD | 0.000
Clock | | | | | Skew | 0.000
\UART:BUART:sRX:RxBitCounter\/count_6 | \UART:BUART:rx_state_0\/main_6 | 3.281

Type | Location | Fanout | Instance/Net | Source | Dest | Delay (ns)
count7cell | U(1,3) | 1 | \UART:BUART:sRX:RxBitCounter\ | \UART:BUART:sRX:RxBitCounter\/clock | \UART:BUART:sRX:RxBitCounter\/count_6 | 0.620
Route | | 1 | \UART:BUART:rx_count_6\ | \UART:BUART:sRX:RxBitCounter\/count_6 | \UART:BUART:rx_state_0\/main_6 | 2.661
macrocell153 | U(0,3) | 1 | \UART:BUART:rx_state_0\ | | HOLD | 0.000
Clock | | | | | Skew | 0.000
\UART:BUART:sRX:RxBitCounter\/count_5 | \UART:BUART:rx_state_0\/main_7 | 3.288

Type | Location | Fanout | Instance/Net | Source | Dest | Delay (ns)
count7cell | U(1,3) | 1 | \UART:BUART:sRX:RxBitCounter\ | \UART:BUART:sRX:RxBitCounter\/clock | \UART:BUART:sRX:RxBitCounter\/count_5 | 0.620
Route | | 1 | \UART:BUART:rx_count_5\ | \UART:BUART:sRX:RxBitCounter\/count_5 | \UART:BUART:rx_state_0\/main_7 | 2.668
macrocell153 | U(0,3) | 1 | \UART:BUART:rx_state_0\ | | HOLD | 0.000
Clock | | | | | Skew | 0.000
\UART:BUART:pollcount_0\/q | \UART:BUART:pollcount_0\/main_2 | 3.539

Type | Location | Fanout | Instance/Net | Source | Dest | Delay (ns)
macrocell160 | U(0,5) | 1 | \UART:BUART:pollcount_0\ | \UART:BUART:pollcount_0\/clock_0 | \UART:BUART:pollcount_0\/q | 1.250
macrocell160 | U(0,5) | 1 | \UART:BUART:pollcount_0\ | \UART:BUART:pollcount_0\/q | \UART:BUART:pollcount_0\/main_2 | 2.289
macrocell160 | U(0,5) | 1 | \UART:BUART:pollcount_0\ | | HOLD | 0.000
Clock | | | | | Skew | 0.000
\UART:BUART:txn\/q | \UART:BUART:txn\/main_0 | 3.544

Type | Location | Fanout | Instance/Net | Source | Dest | Delay (ns)
macrocell147 | U(1,4) | 1 | \UART:BUART:txn\ | \UART:BUART:txn\/clock_0 | \UART:BUART:txn\/q | 1.250
macrocell147 | U(1,4) | 1 | \UART:BUART:txn\ | \UART:BUART:txn\/q | \UART:BUART:txn\/main_0 | 2.294
macrocell147 | U(1,4) | 1 | \UART:BUART:txn\ | | HOLD | 0.000
Clock | | | | | Skew | 0.000
\UART:BUART:pollcount_1\/q | \UART:BUART:pollcount_1\/main_2 | 3.552

Type | Location | Fanout | Instance/Net | Source | Dest | Delay (ns)
macrocell159 | U(0,4) | 1 | \UART:BUART:pollcount_1\ | \UART:BUART:pollcount_1\/clock_0 | \UART:BUART:pollcount_1\/q | 1.250
macrocell159 | U(0,4) | 1 | \UART:BUART:pollcount_1\ | \UART:BUART:pollcount_1\/q | \UART:BUART:pollcount_1\/main_2 | 2.302
macrocell159 | U(0,4) | 1 | \UART:BUART:pollcount_1\ | | HOLD | 0.000
Clock | | | | | Skew | 0.000

+ Asynchronous Clock Crossing Section

+ Source Clock ClockBlock/dclk_glb_ff_5

+ Destination Clock ADC_IntClock

Source | Destination | Delay (ns)
\Timer_TS:TimerHW\/tc | \ADC:bSAR_SEQ:soc_in\/main_1 | 12.717

Type | Location | Fanout | Instance/Net | Source | Dest | Delay (ns)
timercell | F(Timer,3) | 1 | \Timer_TS:TimerHW\ | \Timer_TS:TimerHW\/clock | \Timer_TS:TimerHW\/tc | 1.000
Route | | 1 | Net_1619 | \Timer_TS:TimerHW\/tc | \ADC:bSAR_SEQ:soc_in\/main_1 | 8.207
macrocell142 | U(0,0) | 1 | \ADC:bSAR_SEQ:soc_in\ | | SETUP | 3.510
Clock | | | | | Skew | 0.000
\Timer_TS:TimerHW\/tc | \ADC:bSAR_SEQ:soc_reg\/main_0 | 12.717

Type | Location | Fanout | Instance/Net | Source | Dest | Delay (ns)
timercell | F(Timer,3) | 1 | \Timer_TS:TimerHW\ | \Timer_TS:TimerHW\/clock | \Timer_TS:TimerHW\/tc | 1.000
Route | | 1 | Net_1619 | \Timer_TS:TimerHW\/tc | \ADC:bSAR_SEQ:soc_reg\/main_0 | 8.207
macrocell144 | U(0,0) | 1 | \ADC:bSAR_SEQ:soc_reg\ | | SETUP | 3.510
Clock | | | | | Skew | 0.000

+ Input To Output Section

Source | Destination | Delay (ns)
Q1(0)_PAD | D16(0)_PAD | 23.689

Type | Location | Fanout | Instance/Net | Source | Dest | Delay (ns)
Hardware_Task2 | | 1 | Q1(0)_PAD | Q1(0)_PAD | Q1(0)_PAD | 0.000
Route | | 1 | Q1(0)_PAD | Q1(0)_PAD | Q1(0)/pad_in | 0.000
iocell26 | P3[0] | 1 | Q1(0) | Q1(0)/pad_in | Q1(0)/fb | 6.324
Route | | 1 | Net_4548 | Q1(0)/fb | D16(0)/pin_input | 2.936
iocell33 | P15[1] | 1 | D16(0) | D16(0)/pin_input | D16(0)/pad_out | 14.429
Route | | 1 | D16(0)_PAD | D16(0)/pad_out | D16(0)_PAD | 0.000
Q2(0)_PAD | D11(0)_PAD | 24.312

Type | Location | Fanout | Instance/Net | Source | Dest | Delay (ns)
Hardware_Task2 | | 1 | Q2(0)_PAD | Q2(0)_PAD | Q2(0)_PAD | 0.000
Route | | 1 | Q2(0)_PAD | Q2(0)_PAD | Q2(0)/pad_in | 0.000
iocell27 | P3[1] | 1 | Q2(0) | Q2(0)/pad_in | Q2(0)/fb | 6.259
Route | | 1 | Net_4549 | Q2(0)/fb | D11(0)/pin_input | 2.949
iocell34 | P15[2] | 1 | D11(0) | D11(0)/pin_input | D11(0)/pad_out | 15.104
Route | | 1 | D11(0)_PAD | D11(0)/pad_out | D11(0)_PAD | 0.000
Q5(0)_PAD | D13(0)_PAD | 26.676

Type | Location | Fanout | Instance/Net | Source | Dest | Delay (ns)
Hardware_Task2 | | 1 | Q5(0)_PAD | Q5(0)_PAD | Q5(0)_PAD | 0.000
Route | | 1 | Q5(0)_PAD | Q5(0)_PAD | Q5(0)/pad_in | 0.000
iocell28 | P0[3] | 1 | Q5(0) | Q5(0)/pad_in | Q5(0)/fb | 7.958
Route | | 1 | Net_4511 | Q5(0)/fb | D13(0)/pin_input | 4.463
iocell35 | P15[0] | 1 | D13(0) | D13(0)/pin_input | D13(0)/pad_out | 14.255
Route | | 1 | D13(0)_PAD | D13(0)/pad_out | D13(0)_PAD | 0.000
Q6(0)_PAD | D17(0)_PAD | 26.269

Type | Location | Fanout | Instance/Net | Source | Dest | Delay (ns)
Hardware_Task2 | | 1 | Q6(0)_PAD | Q6(0)_PAD | Q6(0)_PAD | 0.000
Route | | 1 | Q6(0)_PAD | Q6(0)_PAD | Q6(0)/pad_in | 0.000
iocell30 | P0[7] | 1 | Q6(0) | Q6(0)/pad_in | Q6(0)/fb | 7.644
Route | | 1 | Net_4513 | Q6(0)/fb | D17(0)/pin_input | 2.959
iocell36 | P12[2] | 1 | D17(0) | D17(0)/pin_input | D17(0)/pad_out | 15.666
Route | | 1 | D17(0)_PAD | D17(0)/pad_out | D17(0)_PAD | 0.000
Q7(0)_PAD | D14(0)_PAD | 36.073

Type | Location | Fanout | Instance/Net | Source | Dest | Delay (ns)
Hardware_Task2 | | 1 | Q7(0)_PAD | Q7(0)_PAD | Q7(0)_PAD | 0.000
Route | | 1 | Q7(0)_PAD | Q7(0)_PAD | Q7(0)/pad_in | 0.000
iocell29 | P2[7] | 1 | Q7(0) | Q7(0)/pad_in | Q7(0)/fb | 12.350
Route | | 1 | Net_4512 | Q7(0)/fb | D14(0)/pin_input | 7.868
iocell37 | P12[0] | 1 | D14(0) | D14(0)/pin_input | D14(0)/pad_out | 15.855
Route | | 1 | D14(0)_PAD | D14(0)/pad_out | D14(0)_PAD | 0.000
Q4(0)_PAD | D15(0)_PAD | 31.493

Type | Location | Fanout | Instance/Net | Source | Dest | Delay (ns)
Hardware_Task2 | | 1 | Q4(0)_PAD | Q4(0)_PAD | Q4(0)_PAD | 0.000
Route | | 1 | Q4(0)_PAD | Q4(0)_PAD | Q4(0)/pad_in | 0.000
iocell31 | P1[6] | 1 | Q4(0) | Q4(0)/pad_in | Q4(0)/fb | 7.843
Route | | 1 | Net_4514 | Q4(0)/fb | D15(0)/pin_input | 7.717
iocell38 | P12[1] | 1 | D15(0) | D15(0)/pin_input | D15(0)/pad_out | 15.933
Route | | 1 | D15(0)_PAD | D15(0)/pad_out | D15(0)_PAD | 0.000
Q3(0)_PAD | D12(0)_PAD | 29.709

Type | Location | Fanout | Instance/Net | Source | Dest | Delay (ns)
Hardware_Task2 | | 1 | Q3(0)_PAD | Q3(0)_PAD | Q3(0)_PAD | 0.000
Route | | 1 | Q3(0)_PAD | Q3(0)_PAD | Q3(0)/pad_in | 0.000
iocell32 | P1[7] | 1 | Q3(0) | Q3(0)/pad_in | Q3(0)/fb | 7.089
Route | | 1 | Net_4524 | Q3(0)/fb | D12(0)/pin_input | 7.134
iocell39 | P15[3] | 1 | D12(0) | D12(0)/pin_input | D12(0)/pad_out | 15.486
Route | | 1 | D12(0)_PAD | D12(0)/pad_out | D12(0)_PAD | 0.000

+ Clock To Output Section

+ ClockBlock/dclk_glb_ff_2

Source | Destination | Delay (ns)
\PWM_1:PWMHW\/cmp | M1_IN2(0)_PAD | 32.330

Type | Location | Fanout | Instance/Net | Source | Dest | Delay (ns)
timercell | F(Timer,0) | 1 | \PWM_1:PWMHW\ | \PWM_1:PWMHW\/clock | \PWM_1:PWMHW\/cmp | 1.000
Route | | 1 | Net_2404 | \PWM_1:PWMHW\/cmp | Net_362/main_0 | 6.390
macrocell10 | U(3,0) | 1 | Net_362 | Net_362/main_0 | Net_362/q | 3.350
Route | | 1 | Net_362 | Net_362/q | M1_IN2(0)/pin_input | 6.252
iocell2 | P3[5] | 1 | M1_IN2(0) | M1_IN2(0)/pin_input | M1_IN2(0)/pad_out | 15.338
Route | | 1 | M1_IN2(0)_PAD | M1_IN2(0)/pad_out | M1_IN2(0)_PAD | 0.000
Clock | | | | | Clock path delay | 0.000
\PWM_2:PWMHW\/cmp | M2_IN2(0)_PAD | 31.505

Type | Location | Fanout | Instance/Net | Source | Dest | Delay (ns)
timercell | F(Timer,1) | 1 | \PWM_2:PWMHW\ | \PWM_2:PWMHW\/clock | \PWM_2:PWMHW\/cmp | 1.000
Route | | 1 | Net_2460 | \PWM_2:PWMHW\/cmp | Net_368/main_0 | 6.011
macrocell9 | U(0,2) | 1 | Net_368 | Net_368/main_0 | Net_368/q | 3.350
Route | | 1 | Net_368 | Net_368/q | M2_IN2(0)/pin_input | 5.802
iocell4 | P1[5] | 1 | M2_IN2(0) | M2_IN2(0)/pin_input | M2_IN2(0)/pad_out | 15.342
Route | | 1 | M2_IN2(0)_PAD | M2_IN2(0)/pad_out | M2_IN2(0)_PAD | 0.000
Clock | | | | | Clock path delay | 0.000
\PWM_2:PWMHW\/cmp | M2_IN1(0)_PAD | 24.619

Type | Location | Fanout | Instance/Net | Source | Dest | Delay (ns)
timercell | F(Timer,1) | 1 | \PWM_2:PWMHW\ | \PWM_2:PWMHW\/clock | \PWM_2:PWMHW\/cmp | 1.000
Route | | 1 | Net_2460 | \PWM_2:PWMHW\/cmp | M2_IN1(0)/pin_input | 7.941
iocell3 | P1[4] | 1 | M2_IN1(0) | M2_IN1(0)/pin_input | M2_IN1(0)/pad_out | 15.678
Route | | 1 | M2_IN1(0)_PAD | M2_IN1(0)/pad_out | M2_IN1(0)_PAD | 0.000
Clock | | | | | Clock path delay | 0.000
\PWM_1:PWMHW\/cmp | M1_IN1(0)_PAD | 19.812

Type | Location | Fanout | Instance/Net | Source | Dest | Delay (ns)
timercell | F(Timer,0) | 1 | \PWM_1:PWMHW\ | \PWM_1:PWMHW\/clock | \PWM_1:PWMHW\/cmp | 1.000
Route | | 1 | Net_2404 | \PWM_1:PWMHW\/cmp | M1_IN1(0)/pin_input | 3.825
iocell1 | P3[4] | 1 | M1_IN1(0) | M1_IN1(0)/pin_input | M1_IN1(0)/pad_out | 14.987
Route | | 1 | M1_IN1(0)_PAD | M1_IN1(0)/pad_out | M1_IN1(0)_PAD | 0.000
Clock | | | | | Clock path delay | 0.000

+ ClockBlock/dclk_glb_ff_4

Source | Destination | Delay (ns)
\Quad_TImer:TimerHW\/tc | TestPin(0)_PAD | 19.471

Type | Location | Fanout | Instance/Net | Source | Dest | Delay (ns)
timercell | F(Timer,2) | 1 | \Quad_TImer:TimerHW\ | \Quad_TImer:TimerHW\/clock | \Quad_TImer:TimerHW\/tc | 1.000
Route | | 1 | Net_4476 | \Quad_TImer:TimerHW\/tc | TestPin(0)/pin_input | 3.012
iocell23 | P0[2] | 1 | TestPin(0) | TestPin(0)/pin_input | TestPin(0)/pad_out | 15.459
Route | | 1 | TestPin(0)_PAD | TestPin(0)/pad_out | TestPin(0)_PAD | 0.000
Clock | | | | | Clock path delay | 0.000

+ CyBUS_CLK

Source | Destination | Delay (ns)
\CONTROL:Sync:ctrl_reg\/control_1 | M2_D1(0)_PAD | 25.697

Type | Location | Fanout | Instance/Net | Source | Dest | Delay (ns)
controlcell4 | U(2,3) | 1 | \CONTROL:Sync:ctrl_reg\ | \CONTROL:Sync:ctrl_reg\/busclk | \CONTROL:Sync:ctrl_reg\/control_1 | 2.050
Route | | 1 | Net_3236 | \CONTROL:Sync:ctrl_reg\/control_1 | M2_D1(0)/pin_input | 8.177
iocell5 | P1[2] | 1 | M2_D1(0) | M2_D1(0)/pin_input | M2_D1(0)/pad_out | 15.470
Route | | 1 | M2_D1(0)_PAD | M2_D1(0)/pad_out | M2_D1(0)_PAD | 0.000
Clock | | | | | Clock path delay | 0.000
\CONTROL:Sync:ctrl_reg\/control_0 | M1_D1(0)_PAD | 23.954

Type | Location | Fanout | Instance/Net | Source | Dest | Delay (ns)
controlcell4 | U(2,3) | 1 | \CONTROL:Sync:ctrl_reg\ | \CONTROL:Sync:ctrl_reg\/busclk | \CONTROL:Sync:ctrl_reg\/control_0 | 2.050
Route | | 1 | Net_1832 | \CONTROL:Sync:ctrl_reg\/control_0 | M1_D1(0)/pin_input | 7.313
iocell14 | P3[3] | 1 | M1_D1(0) | M1_D1(0)/pin_input | M1_D1(0)/pad_out | 14.591
Route | | 1 | M1_D1(0)_PAD | M1_D1(0)/pad_out | M1_D1(0)_PAD | 0.000
Clock | | | | | Clock path delay | 0.000

+ UART_IntClock

Source | Destination | Delay (ns)
\UART:BUART:txn\/q | Tx_1(0)_PAD | 27.866

Type | Location | Fanout | Instance/Net | Source | Dest | Delay (ns)
macrocell147 | U(1,4) | 1 | \UART:BUART:txn\ | \UART:BUART:txn\/clock_0 | \UART:BUART:txn\/q | 1.250
Route | | 1 | \UART:BUART:txn\ | \UART:BUART:txn\/q | Net_1880/main_0 | 2.294
macrocell20 | U(1,4) | 1 | Net_1880 | Net_1880/main_0 | Net_1880/q | 3.350
Route | | 1 | Net_1880 | Net_1880/q | Tx_1(0)/pin_input | 5.535
iocell16 | P2[3] | 1 | Tx_1(0) | Tx_1(0)/pin_input | Tx_1(0)/pad_out | 15.437
Route | | 1 | Tx_1(0)_PAD | Tx_1(0)/pad_out | Tx_1(0)_PAD | 0.000
Clock | | | | | Clock path delay | 0.000

+ Asynchronous Constraints

+ Recovery

+ Source Clock : Clock_QENC : Positive edge(Required Frequency 12 MHz)

+ Destination Clock : Clock_QENC : Positive edge(Required Frequency 12 MHz)

Path Delay Requirement : 83.3333ns(12 MHz)

Source | Destination | FMax | Delay (ns) | Slack (ns) | Violation
\QuadDec_M2:Net_1260\/q | \QuadDec_M2:Cnt16:CounterUDB:sSTSReg:stsreg\/reset | 94.438 MHz | 10.589 | 72.744

Type | Location | Fanout | Instance/Net | Source | Dest | Delay (ns)
macrocell65 | U(3,3) | 1 | \QuadDec_M2:Net_1260\ | \QuadDec_M2:Net_1260\/clock_0 | \QuadDec_M2:Net_1260\/q | 1.250
Route | | 1 | \QuadDec_M2:Net_1260\ | \QuadDec_M2:Net_1260\/q | \QuadDec_M2:Cnt16:CounterUDB:sSTSReg:stsreg\/reset | 9.339
statusicell3 | U(2,2) | 1 | \QuadDec_M2:Cnt16:CounterUDB:sSTSReg:stsreg\ | | RECOVERY | -0.000
Clock | | | | | Skew | 0.000
\QuadDec_M1:Net_1260\/q | \QuadDec_M1:Cnt16:CounterUDB:sSTSReg:stsreg\/reset | 115.314 MHz | 8.672 | 74.661

Type | Location | Fanout | Instance/Net | Source | Dest | Delay (ns)
macrocell51 | U(2,2) | 1 | \QuadDec_M1:Net_1260\ | \QuadDec_M1:Net_1260\/clock_0 | \QuadDec_M1:Net_1260\/q | 1.250
Route | | 1 | \QuadDec_M1:Net_1260\ | \QuadDec_M1:Net_1260\/q | \QuadDec_M1:Cnt16:CounterUDB:sSTSReg:stsreg\/reset | 7.422
statusicell1 | U(3,5) | 1 | \QuadDec_M1:Cnt16:CounterUDB:sSTSReg:stsreg\ | | RECOVERY | -0.000
Clock | | | | | Skew | 0.000

+ Removal

+ Source Clock : Clock_QENC : Positive edge

+ Destination Clock : Clock_QENC : Positive edge

Source | Destination | Slack (ns) | Violation
\QuadDec_M1:Net_1260\/q | \QuadDec_M1:Cnt16:CounterUDB:sSTSReg:stsreg\/reset | 8.672

Type | Location | Fanout | Instance/Net | Source | Dest | Delay (ns)
macrocell51 | U(2,2) | 1 | \QuadDec_M1:Net_1260\ | \QuadDec_M1:Net_1260\/clock_0 | \QuadDec_M1:Net_1260\/q | 1.250
Route | | 1 | \QuadDec_M1:Net_1260\ | \QuadDec_M1:Net_1260\/q | \QuadDec_M1:Cnt16:CounterUDB:sSTSReg:stsreg\/reset | 7.422
statusicell1 | U(3,5) | 1 | \QuadDec_M1:Cnt16:CounterUDB:sSTSReg:stsreg\ | | REMOVAL | 0.000
Clock | | | | | Skew | 0.000
\QuadDec_M2:Net_1260\/q | \QuadDec_M2:Cnt16:CounterUDB:sSTSReg:stsreg\/reset | 10.589

Type | Location | Fanout | Instance/Net | Source | Dest | Delay (ns)
macrocell65 | U(3,3) | 1 | \QuadDec_M2:Net_1260\ | \QuadDec_M2:Net_1260\/clock_0 | \QuadDec_M2:Net_1260\/q | 1.250
Route | | 1 | \QuadDec_M2:Net_1260\ | \QuadDec_M2:Net_1260\/q | \QuadDec_M2:Cnt16:CounterUDB:sSTSReg:stsreg\/reset | 9.339
statusicell3 | U(2,2) | 1 | \QuadDec_M2:Cnt16:CounterUDB:sSTSReg:stsreg\ | | REMOVAL | 0.000
Clock | | | | | Skew | 0.000
