rsef899/12_Cypress_LineFollowingRobot/Final_implementation/Team12_PsoC_FinalImplementation.cydsn/ComponentUpdateLog.txt

Last Modified Date & Time: 10/11/2023 11:44:10

Last Modified Date & Time: 10/13/2023 12:49:38
