rsef899/12_Cypress_LineFollowingRobot/Robert/CS301_Class_Copy_01.cydsn/ComponentUpdateLog.txt

Last Modified Date & Time: 08/01/2023 12:16:16

Last Modified Date & Time: 08/01/2023 12:20:06

Last Modified Date & Time: 08/01/2023 12:20:41
