rsef899/12_Cypress_LineFollowingRobot/Robert/HArdware_Task2/Hardware_Task2.cydsn/ComponentUpdateLog.txt

Last Modified Date & Time: 09/19/2023 10:19:51

Last Modified Date & Time: 09/19/2023 13:18:45

Last Modified Date & Time: 09/20/2023 20:17:39

Last Modified Date & Time: 10/03/2023 13:18:19

Last Modified Date & Time: 10/09/2023 11:40:28

Last Modified Date & Time: 10/09/2023 11:41:07
