rsef899/12_Cypress_LineFollowingRobot/student_pack/psoc student pack/lab exercise/psoc_intro/ComponentUpdateLog.txt

Last Modified Date & Time: 07/19/2023 13:11:30

lab1: lab1.cydwr
	cy_boot [v5.82] to [v6.0]
	LIN_Dynamic [v6.0] to [v5.0]

lab2: lab2.cydwr
	cy_boot [v5.82] to [v6.0]
	LIN_Dynamic [v6.0] to [v5.0]

lab3: lab3.cydwr
	cy_boot [v5.82] to [v6.0]
	LIN_Dynamic [v6.0] to [v5.0]

lab3: TopDesign.cysch
	isr_TC [v1.71] to [v1.70]

Last Modified Date & Time: 07/21/2023 14:37:00

lab1: lab1.cydwr
	cy_boot [v6.0] to [v5.82]
	LIN_Dynamic [v5.0] to [v6.0]

lab2: lab2.cydwr
	cy_boot [v6.0] to [v5.82]
	LIN_Dynamic [v5.0] to [v6.0]

lab3: lab3.cydwr
	cy_boot [v6.0] to [v5.82]
	LIN_Dynamic [v5.0] to [v6.0]

lab3: TopDesign.cysch
	isr_TC [v1.70] to [v1.71]

Last Modified Date & Time: 07/21/2023 17:12:11

CS301_Class: CS301_Class.cydwr
	LIN_Dynamic [v5.0] to [v6.0]
