rsef899/12_Cypress_LineFollowingRobot/Final_implementation/Team12_PsoC_benchmark_test.cydsn/Team12_PsoC_benchmark_test_timing.html

# Static Timing Analysis

Project : | Team12_PsoC_benchmark_test
Build Time : | 10/12/23 12:41:46
Device : | CY8C5888LTI-LP097
Temperature : | -40C - 85/125C
VDDA : | 5.00
VDDABUF : | 5.00
VDDD : | 5.00
VDDIO0 : | 5.00
VDDIO1 : | 5.00
VDDIO2 : | 5.00
VDDIO3 : | 5.00
VUSB : | 5.00
Voltage : | 5.0

Expand All | Collapse All | Show All Paths | Hide All Paths

+ Timing Violation Section

Note: If your design will only ever run at typical room temperatures, selecting the narrower temperature range in the system DWR for your application helps the tool to find timing-compliant routing solutions.

Violation | Source Clock | Destination Clock | Slack(ns)
Async
| ClockBlock/dclk_glb_ff_3 | ADC_IntClock

+ Clock Summary Section

Clock | Domain | Nominal Frequency | Required Frequency | Maximum Frequency | Violation
ADC_IntClock(routed) | ADC_IntClock(routed) | 2.857 MHz | 2.857 MHz | N/A
ClockBlock/dclk_glb_ff_2 | ClockBlock/dclk_glb_ff_2 | UNKNOWN | UNKNOWN | N/A
ClockBlock/dclk_glb_ff_3 | ClockBlock/dclk_glb_ff_3 | UNKNOWN | UNKNOWN | N/A
ClockBlock/dclk_glb_ff_5 | ClockBlock/dclk_glb_ff_5 | UNKNOWN | UNKNOWN | N/A
CyILO | CyILO | 100.000 kHz | 100.000 kHz | N/A
CyIMO | CyIMO | 24.000 MHz | 24.000 MHz | N/A
CyMASTER_CLK | CyMASTER_CLK | 60.000 MHz | 60.000 MHz | N/A
CyBUS_CLK | CyMASTER_CLK | 60.000 MHz | 60.000 MHz | 66.525 MHz
Clock_QENC | CyMASTER_CLK | 12.000 MHz | 12.000 MHz | 30.038 MHz
ADC_IntClock | CyMASTER_CLK | 2.857 MHz | 2.857 MHz | 28.247 MHz
Clock_PWM | CyMASTER_CLK | 1.000 MHz | 1.000 MHz | N/A
UART_IntClock | CyMASTER_CLK | 461.538 kHz | 461.538 kHz | 39.200 MHz
Quad_Timer_clk | CyMASTER_CLK | 1.526 Hz | 1.526 Hz | N/A
Clock2 | CyMASTER_CLK | 500.000 kHz | 500.000 kHz | N/A
CyPLL_OUT | CyPLL_OUT | 60.000 MHz | 60.000 MHz | N/A

+ Register to Register Section

+ Setup Subsection

+ Source Clock : ADC_IntClock : Positive edge(Required Frequency 2.85714 MHz)

+ Destination Clock : ADC_IntClock : Positive edge(Required Frequency 2.85714 MHz)

Path Delay Requirement : 350ns(2.85714 MHz)

Source | Destination | FMax | Delay (ns) | Slack (ns) | Violation
\ADC:AMuxHw_2_Decoder_old_id_5\/q | \ADC:AMuxHw_2_Decoder_one_hot_14\/main_0 | 28.247 MHz | 35.402 | 314.598

Type | Location | Fanout | Instance/Net | Source | Dest | Delay (ns)
macrocell69 | U(2,4) | 1 | \ADC:AMuxHw_2_Decoder_old_id_5\ | \ADC:AMuxHw_2_Decoder_old_id_5\/clock_0 | \ADC:AMuxHw_2_Decoder_old_id_5\/q | 1.250
Route | | 1 | \ADC:AMuxHw_2_Decoder_old_id_5\ | \ADC:AMuxHw_2_Decoder_old_id_5\/q | \ADC:AMuxHw_2_Decoder_is_active_split\/main_0 | 8.413
macrocell46 | U(2,2) | 1 | \ADC:AMuxHw_2_Decoder_is_active_split\ | \ADC:AMuxHw_2_Decoder_is_active_split\/main_0 | \ADC:AMuxHw_2_Decoder_is_active_split\/q | 3.350
Route | | 1 | \ADC:AMuxHw_2_Decoder_is_active_split\ | \ADC:AMuxHw_2_Decoder_is_active_split\/q | \ADC:AMuxHw_2_Decoder_is_active\/main_8 | 2.297
macrocell18 | U(2,2) | 1 | \ADC:AMuxHw_2_Decoder_is_active\ | \ADC:AMuxHw_2_Decoder_is_active\/main_8 | \ADC:AMuxHw_2_Decoder_is_active\/q | 3.350
Route | | 1 | \ADC:AMuxHw_2_Decoder_is_active\ | \ADC:AMuxHw_2_Decoder_is_active\/q | \ADC:AMuxHw_2_Decoder_one_hot_14\/main_0 | 13.232
macrocell89 | U(0,4) | 1 | \ADC:AMuxHw_2_Decoder_one_hot_14\ | | SETUP | 3.510
Clock | | | | | Skew | 0.000
\ADC:AMuxHw_2_Decoder_old_id_5\/q | \ADC:AMuxHw_2_Decoder_one_hot_19\/main_0 | 28.247 MHz | 35.402 | 314.598

Type | Location | Fanout | Instance/Net | Source | Dest | Delay (ns)
macrocell69 | U(2,4) | 1 | \ADC:AMuxHw_2_Decoder_old_id_5\ | \ADC:AMuxHw_2_Decoder_old_id_5\/clock_0 | \ADC:AMuxHw_2_Decoder_old_id_5\/q | 1.250
Route | | 1 | \ADC:AMuxHw_2_Decoder_old_id_5\ | \ADC:AMuxHw_2_Decoder_old_id_5\/q | \ADC:AMuxHw_2_Decoder_is_active_split\/main_0 | 8.413
macrocell46 | U(2,2) | 1 | \ADC:AMuxHw_2_Decoder_is_active_split\ | \ADC:AMuxHw_2_Decoder_is_active_split\/main_0 | \ADC:AMuxHw_2_Decoder_is_active_split\/q | 3.350
Route | | 1 | \ADC:AMuxHw_2_Decoder_is_active_split\ | \ADC:AMuxHw_2_Decoder_is_active_split\/q | \ADC:AMuxHw_2_Decoder_is_active\/main_8 | 2.297
macrocell18 | U(2,2) | 1 | \ADC:AMuxHw_2_Decoder_is_active\ | \ADC:AMuxHw_2_Decoder_is_active\/main_8 | \ADC:AMuxHw_2_Decoder_is_active\/q | 3.350
Route | | 1 | \ADC:AMuxHw_2_Decoder_is_active\ | \ADC:AMuxHw_2_Decoder_is_active\/q | \ADC:AMuxHw_2_Decoder_one_hot_19\/main_0 | 13.232
macrocell94 | U(0,4) | 1 | \ADC:AMuxHw_2_Decoder_one_hot_19\ | | SETUP | 3.510
Clock | | | | | Skew | 0.000
\ADC:AMuxHw_2_Decoder_old_id_5\/q | \ADC:AMuxHw_2_Decoder_one_hot_28\/main_0 | 28.247 MHz | 35.402 | 314.598

Type | Location | Fanout | Instance/Net | Source | Dest | Delay (ns)
macrocell69 | U(2,4) | 1 | \ADC:AMuxHw_2_Decoder_old_id_5\ | \ADC:AMuxHw_2_Decoder_old_id_5\/clock_0 | \ADC:AMuxHw_2_Decoder_old_id_5\/q | 1.250
Route | | 1 | \ADC:AMuxHw_2_Decoder_old_id_5\ | \ADC:AMuxHw_2_Decoder_old_id_5\/q | \ADC:AMuxHw_2_Decoder_is_active_split\/main_0 | 8.413
macrocell46 | U(2,2) | 1 | \ADC:AMuxHw_2_Decoder_is_active_split\ | \ADC:AMuxHw_2_Decoder_is_active_split\/main_0 | \ADC:AMuxHw_2_Decoder_is_active_split\/q | 3.350
Route | | 1 | \ADC:AMuxHw_2_Decoder_is_active_split\ | \ADC:AMuxHw_2_Decoder_is_active_split\/q | \ADC:AMuxHw_2_Decoder_is_active\/main_8 | 2.297
macrocell18 | U(2,2) | 1 | \ADC:AMuxHw_2_Decoder_is_active\ | \ADC:AMuxHw_2_Decoder_is_active\/main_8 | \ADC:AMuxHw_2_Decoder_is_active\/q | 3.350
Route | | 1 | \ADC:AMuxHw_2_Decoder_is_active\ | \ADC:AMuxHw_2_Decoder_is_active\/q | \ADC:AMuxHw_2_Decoder_one_hot_28\/main_0 | 13.232
macrocell103 | U(0,4) | 1 | \ADC:AMuxHw_2_Decoder_one_hot_28\ | | SETUP | 3.510
Clock | | | | | Skew | 0.000
\ADC:AMuxHw_2_Decoder_old_id_5\/q | \ADC:AMuxHw_2_Decoder_one_hot_52\/main_0 | 28.247 MHz | 35.402 | 314.598

Type | Location | Fanout | Instance/Net | Source | Dest | Delay (ns)
macrocell69 | U(2,4) | 1 | \ADC:AMuxHw_2_Decoder_old_id_5\ | \ADC:AMuxHw_2_Decoder_old_id_5\/clock_0 | \ADC:AMuxHw_2_Decoder_old_id_5\/q | 1.250
Route | | 1 | \ADC:AMuxHw_2_Decoder_old_id_5\ | \ADC:AMuxHw_2_Decoder_old_id_5\/q | \ADC:AMuxHw_2_Decoder_is_active_split\/main_0 | 8.413
macrocell46 | U(2,2) | 1 | \ADC:AMuxHw_2_Decoder_is_active_split\ | \ADC:AMuxHw_2_Decoder_is_active_split\/main_0 | \ADC:AMuxHw_2_Decoder_is_active_split\/q | 3.350
Route | | 1 | \ADC:AMuxHw_2_Decoder_is_active_split\ | \ADC:AMuxHw_2_Decoder_is_active_split\/q | \ADC:AMuxHw_2_Decoder_is_active\/main_8 | 2.297
macrocell18 | U(2,2) | 1 | \ADC:AMuxHw_2_Decoder_is_active\ | \ADC:AMuxHw_2_Decoder_is_active\/main_8 | \ADC:AMuxHw_2_Decoder_is_active\/q | 3.350
Route | | 1 | \ADC:AMuxHw_2_Decoder_is_active\ | \ADC:AMuxHw_2_Decoder_is_active\/q | \ADC:AMuxHw_2_Decoder_one_hot_52\/main_0 | 13.232
macrocell127 | U(0,4) | 1 | \ADC:AMuxHw_2_Decoder_one_hot_52\ | | SETUP | 3.510
Clock | | | | | Skew | 0.000
\ADC:AMuxHw_2_Decoder_old_id_5\/q | \ADC:AMuxHw_2_Decoder_one_hot_3\/main_0 | 28.293 MHz | 35.344 | 314.656

Type | Location | Fanout | Instance/Net | Source | Dest | Delay (ns)
macrocell69 | U(2,4) | 1 | \ADC:AMuxHw_2_Decoder_old_id_5\ | \ADC:AMuxHw_2_Decoder_old_id_5\/clock_0 | \ADC:AMuxHw_2_Decoder_old_id_5\/q | 1.250
Route | | 1 | \ADC:AMuxHw_2_Decoder_old_id_5\ | \ADC:AMuxHw_2_Decoder_old_id_5\/q | \ADC:AMuxHw_2_Decoder_is_active_split\/main_0 | 8.413
macrocell46 | U(2,2) | 1 | \ADC:AMuxHw_2_Decoder_is_active_split\ | \ADC:AMuxHw_2_Decoder_is_active_split\/main_0 | \ADC:AMuxHw_2_Decoder_is_active_split\/q | 3.350
Route | | 1 | \ADC:AMuxHw_2_Decoder_is_active_split\ | \ADC:AMuxHw_2_Decoder_is_active_split\/q | \ADC:AMuxHw_2_Decoder_is_active\/main_8 | 2.297
macrocell18 | U(2,2) | 1 | \ADC:AMuxHw_2_Decoder_is_active\ | \ADC:AMuxHw_2_Decoder_is_active\/main_8 | \ADC:AMuxHw_2_Decoder_is_active\/q | 3.350
Route | | 1 | \ADC:AMuxHw_2_Decoder_is_active\ | \ADC:AMuxHw_2_Decoder_is_active\/q | \ADC:AMuxHw_2_Decoder_one_hot_3\/main_0 | 13.174
macrocell78 | U(0,5) | 1 | \ADC:AMuxHw_2_Decoder_one_hot_3\ | | SETUP | 3.510
Clock | | | | | Skew | 0.000
\ADC:AMuxHw_2_Decoder_old_id_5\/q | \ADC:AMuxHw_2_Decoder_one_hot_22\/main_0 | 28.293 MHz | 35.344 | 314.656

Type | Location | Fanout | Instance/Net | Source | Dest | Delay (ns)
macrocell69 | U(2,4) | 1 | \ADC:AMuxHw_2_Decoder_old_id_5\ | \ADC:AMuxHw_2_Decoder_old_id_5\/clock_0 | \ADC:AMuxHw_2_Decoder_old_id_5\/q | 1.250
Route | | 1 | \ADC:AMuxHw_2_Decoder_old_id_5\ | \ADC:AMuxHw_2_Decoder_old_id_5\/q | \ADC:AMuxHw_2_Decoder_is_active_split\/main_0 | 8.413
macrocell46 | U(2,2) | 1 | \ADC:AMuxHw_2_Decoder_is_active_split\ | \ADC:AMuxHw_2_Decoder_is_active_split\/main_0 | \ADC:AMuxHw_2_Decoder_is_active_split\/q | 3.350
Route | | 1 | \ADC:AMuxHw_2_Decoder_is_active_split\ | \ADC:AMuxHw_2_Decoder_is_active_split\/q | \ADC:AMuxHw_2_Decoder_is_active\/main_8 | 2.297
macrocell18 | U(2,2) | 1 | \ADC:AMuxHw_2_Decoder_is_active\ | \ADC:AMuxHw_2_Decoder_is_active\/main_8 | \ADC:AMuxHw_2_Decoder_is_active\/q | 3.350
Route | | 1 | \ADC:AMuxHw_2_Decoder_is_active\ | \ADC:AMuxHw_2_Decoder_is_active\/q | \ADC:AMuxHw_2_Decoder_one_hot_22\/main_0 | 13.174
macrocell97 | U(0,5) | 1 | \ADC:AMuxHw_2_Decoder_one_hot_22\ | | SETUP | 3.510
Clock | | | | | Skew | 0.000
\ADC:AMuxHw_2_Decoder_old_id_5\/q | \ADC:AMuxHw_2_Decoder_one_hot_35\/main_0 | 28.293 MHz | 35.344 | 314.656

Type | Location | Fanout | Instance/Net | Source | Dest | Delay (ns)
macrocell69 | U(2,4) | 1 | \ADC:AMuxHw_2_Decoder_old_id_5\ | \ADC:AMuxHw_2_Decoder_old_id_5\/clock_0 | \ADC:AMuxHw_2_Decoder_old_id_5\/q | 1.250
Route | | 1 | \ADC:AMuxHw_2_Decoder_old_id_5\ | \ADC:AMuxHw_2_Decoder_old_id_5\/q | \ADC:AMuxHw_2_Decoder_is_active_split\/main_0 | 8.413
macrocell46 | U(2,2) | 1 | \ADC:AMuxHw_2_Decoder_is_active_split\ | \ADC:AMuxHw_2_Decoder_is_active_split\/main_0 | \ADC:AMuxHw_2_Decoder_is_active_split\/q | 3.350
Route | | 1 | \ADC:AMuxHw_2_Decoder_is_active_split\ | \ADC:AMuxHw_2_Decoder_is_active_split\/q | \ADC:AMuxHw_2_Decoder_is_active\/main_8 | 2.297
macrocell18 | U(2,2) | 1 | \ADC:AMuxHw_2_Decoder_is_active\ | \ADC:AMuxHw_2_Decoder_is_active\/main_8 | \ADC:AMuxHw_2_Decoder_is_active\/q | 3.350
Route | | 1 | \ADC:AMuxHw_2_Decoder_is_active\ | \ADC:AMuxHw_2_Decoder_is_active\/q | \ADC:AMuxHw_2_Decoder_one_hot_35\/main_0 | 13.174
macrocell110 | U(0,5) | 1 | \ADC:AMuxHw_2_Decoder_one_hot_35\ | | SETUP | 3.510
Clock | | | | | Skew | 0.000
\ADC:AMuxHw_2_Decoder_old_id_5\/q | \ADC:AMuxHw_2_Decoder_one_hot_56\/main_0 | 28.293 MHz | 35.344 | 314.656

Type | Location | Fanout | Instance/Net | Source | Dest | Delay (ns)
macrocell69 | U(2,4) | 1 | \ADC:AMuxHw_2_Decoder_old_id_5\ | \ADC:AMuxHw_2_Decoder_old_id_5\/clock_0 | \ADC:AMuxHw_2_Decoder_old_id_5\/q | 1.250
Route | | 1 | \ADC:AMuxHw_2_Decoder_old_id_5\ | \ADC:AMuxHw_2_Decoder_old_id_5\/q | \ADC:AMuxHw_2_Decoder_is_active_split\/main_0 | 8.413
macrocell46 | U(2,2) | 1 | \ADC:AMuxHw_2_Decoder_is_active_split\ | \ADC:AMuxHw_2_Decoder_is_active_split\/main_0 | \ADC:AMuxHw_2_Decoder_is_active_split\/q | 3.350
Route | | 1 | \ADC:AMuxHw_2_Decoder_is_active_split\ | \ADC:AMuxHw_2_Decoder_is_active_split\/q | \ADC:AMuxHw_2_Decoder_is_active\/main_8 | 2.297
macrocell18 | U(2,2) | 1 | \ADC:AMuxHw_2_Decoder_is_active\ | \ADC:AMuxHw_2_Decoder_is_active\/main_8 | \ADC:AMuxHw_2_Decoder_is_active\/q | 3.350
Route | | 1 | \ADC:AMuxHw_2_Decoder_is_active\ | \ADC:AMuxHw_2_Decoder_is_active\/q | \ADC:AMuxHw_2_Decoder_one_hot_56\/main_0 | 13.174
macrocell131 | U(0,5) | 1 | \ADC:AMuxHw_2_Decoder_one_hot_56\ | | SETUP | 3.510
Clock | | | | | Skew | 0.000
\ADC:AMuxHw_2_Decoder_old_id_5\/q | \ADC:AMuxHw_2_Decoder_one_hot_23\/main_0 | 28.696 MHz | 34.848 | 315.152

Type | Location | Fanout | Instance/Net | Source | Dest | Delay (ns)
macrocell69 | U(2,4) | 1 | \ADC:AMuxHw_2_Decoder_old_id_5\ | \ADC:AMuxHw_2_Decoder_old_id_5\/clock_0 | \ADC:AMuxHw_2_Decoder_old_id_5\/q | 1.250
Route | | 1 | \ADC:AMuxHw_2_Decoder_old_id_5\ | \ADC:AMuxHw_2_Decoder_old_id_5\/q | \ADC:AMuxHw_2_Decoder_is_active_split\/main_0 | 8.413
macrocell46 | U(2,2) | 1 | \ADC:AMuxHw_2_Decoder_is_active_split\ | \ADC:AMuxHw_2_Decoder_is_active_split\/main_0 | \ADC:AMuxHw_2_Decoder_is_active_split\/q | 3.350
Route | | 1 | \ADC:AMuxHw_2_Decoder_is_active_split\ | \ADC:AMuxHw_2_Decoder_is_active_split\/q | \ADC:AMuxHw_2_Decoder_is_active\/main_8 | 2.297
macrocell18 | U(2,2) | 1 | \ADC:AMuxHw_2_Decoder_is_active\ | \ADC:AMuxHw_2_Decoder_is_active\/main_8 | \ADC:AMuxHw_2_Decoder_is_active\/q | 3.350
Route | | 1 | \ADC:AMuxHw_2_Decoder_is_active\ | \ADC:AMuxHw_2_Decoder_is_active\/q | \ADC:AMuxHw_2_Decoder_one_hot_23\/main_0 | 12.678
macrocell98 | U(0,4) | 1 | \ADC:AMuxHw_2_Decoder_one_hot_23\ | | SETUP | 3.510
Clock | | | | | Skew | 0.000
\ADC:AMuxHw_2_Decoder_old_id_5\/q | \ADC:AMuxHw_2_Decoder_one_hot_40\/main_0 | 28.696 MHz | 34.848 | 315.152

Type | Location | Fanout | Instance/Net | Source | Dest | Delay (ns)
macrocell69 | U(2,4) | 1 | \ADC:AMuxHw_2_Decoder_old_id_5\ | \ADC:AMuxHw_2_Decoder_old_id_5\/clock_0 | \ADC:AMuxHw_2_Decoder_old_id_5\/q | 1.250
Route | | 1 | \ADC:AMuxHw_2_Decoder_old_id_5\ | \ADC:AMuxHw_2_Decoder_old_id_5\/q | \ADC:AMuxHw_2_Decoder_is_active_split\/main_0 | 8.413
macrocell46 | U(2,2) | 1 | \ADC:AMuxHw_2_Decoder_is_active_split\ | \ADC:AMuxHw_2_Decoder_is_active_split\/main_0 | \ADC:AMuxHw_2_Decoder_is_active_split\/q | 3.350
Route | | 1 | \ADC:AMuxHw_2_Decoder_is_active_split\ | \ADC:AMuxHw_2_Decoder_is_active_split\/q | \ADC:AMuxHw_2_Decoder_is_active\/main_8 | 2.297
macrocell18 | U(2,2) | 1 | \ADC:AMuxHw_2_Decoder_is_active\ | \ADC:AMuxHw_2_Decoder_is_active\/main_8 | \ADC:AMuxHw_2_Decoder_is_active\/q | 3.350
Route | | 1 | \ADC:AMuxHw_2_Decoder_is_active\ | \ADC:AMuxHw_2_Decoder_is_active\/q | \ADC:AMuxHw_2_Decoder_one_hot_40\/main_0 | 12.678
macrocell115 | U(0,4) | 1 | \ADC:AMuxHw_2_Decoder_one_hot_40\ | | SETUP | 3.510
Clock | | | | | Skew | 0.000

+ Destination Clock : CyBUS_CLK : Positive edge(Required Frequency 60 MHz)

Path Delay Requirement : 16.6667ns(60 MHz)

Affects clock : CyMASTER_CLK

Source | Destination | FMax | Delay (ns) | Slack (ns) | Violation
Net_1497/q | \ADC:bSAR_SEQ:bus_clk_nrq_reg\/main_2 | 119.760 MHz | 8.350 | 8.317

Type | Location | Fanout | Instance/Net | Source | Dest | Delay (ns)
macrocell139 | U(1,2) | 1 | Net_1497 | Net_1497/clock_0 | Net_1497/q | 1.250
Route | | 1 | Net_1497 | Net_1497/q | \ADC:bSAR_SEQ:bus_clk_nrq_reg\/main_2 | 3.590
macrocell140 | U(1,2) | 1 | \ADC:bSAR_SEQ:bus_clk_nrq_reg\ | | SETUP | 3.510
Clock | | | | | Skew | 0.000

+ Source Clock : Clock_QENC : Positive edge(Required Frequency 12 MHz)

+ Destination Clock : Clock_QENC : Positive edge(Required Frequency 12 MHz)

Path Delay Requirement : 83.3333ns(12 MHz)

Source | Destination | FMax | Delay (ns) | Slack (ns) | Violation
\QuadDec_M1:Cnt16:CounterUDB:sC16:counterdp:u0\/z0 | \QuadDec_M1:Cnt16:CounterUDB:sC16:counterdp:u1\/ci | 30.038 MHz | 33.291 | 50.042

Type | Location | Fanout | Instance/Net | Source | Dest | Delay (ns)
datapathcell1 | U(2,0) | 1 | \QuadDec_M1:Cnt16:CounterUDB:sC16:counterdp:u0\ | \QuadDec_M1:Cnt16:CounterUDB:sC16:counterdp:u0\/clock | \QuadDec_M1:Cnt16:CounterUDB:sC16:counterdp:u0\/z0 | 0.760
Route | | 1 | \QuadDec_M1:Cnt16:CounterUDB:sC16:counterdp:u0.z0__sig\ | \QuadDec_M1:Cnt16:CounterUDB:sC16:counterdp:u0\/z0 | \QuadDec_M1:Cnt16:CounterUDB:sC16:counterdp:u1\/z0i | 0.000
datapathcell2 | U(3,0) | 1 | \QuadDec_M1:Cnt16:CounterUDB:sC16:counterdp:u1\ | \QuadDec_M1:Cnt16:CounterUDB:sC16:counterdp:u1\/z0i | \QuadDec_M1:Cnt16:CounterUDB:sC16:counterdp:u1\/z0_comb | 2.740
Route | | 1 | \QuadDec_M1:Cnt16:CounterUDB:status_1\ | \QuadDec_M1:Cnt16:CounterUDB:sC16:counterdp:u1\/z0_comb | \QuadDec_M1:Cnt16:CounterUDB:reload\/main_1 | 9.303
macrocell2 | U(1,2) | 1 | \QuadDec_M1:Cnt16:CounterUDB:reload\ | \QuadDec_M1:Cnt16:CounterUDB:reload\/main_1 | \QuadDec_M1:Cnt16:CounterUDB:reload\/q | 3.350
Route | | 1 | \QuadDec_M1:Cnt16:CounterUDB:reload\ | \QuadDec_M1:Cnt16:CounterUDB:reload\/q | \QuadDec_M1:Cnt16:CounterUDB:sC16:counterdp:u0\/cs_addr_0 | 7.778
datapathcell1 | U(2,0) | 1 | \QuadDec_M1:Cnt16:CounterUDB:sC16:counterdp:u0\ | \QuadDec_M1:Cnt16:CounterUDB:sC16:counterdp:u0\/cs_addr_0 | \QuadDec_M1:Cnt16:CounterUDB:sC16:counterdp:u0\/co_msb | 5.130
Route | | 1 | \QuadDec_M1:Cnt16:CounterUDB:sC16:counterdp:u0.co_msb__sig\ | \QuadDec_M1:Cnt16:CounterUDB:sC16:counterdp:u0\/co_msb | \QuadDec_M1:Cnt16:CounterUDB:sC16:counterdp:u1\/ci | 0.000
datapathcell2 | U(3,0) | 1 | \QuadDec_M1:Cnt16:CounterUDB:sC16:counterdp:u1\ | | SETUP | 4.230
Clock | | | | | Skew | 0.000
\QuadDec_M1:Cnt16:CounterUDB:sC16:counterdp:u1\/z0_comb | \QuadDec_M1:Cnt16:CounterUDB:sC16:counterdp:u1\/ci | 31.171 MHz | 32.081 | 51.252

Type | Location | Fanout | Instance/Net | Source | Dest | Delay (ns)
datapathcell2 | U(3,0) | 1 | \QuadDec_M1:Cnt16:CounterUDB:sC16:counterdp:u1\ | \QuadDec_M1:Cnt16:CounterUDB:sC16:counterdp:u1\/clock | \QuadDec_M1:Cnt16:CounterUDB:sC16:counterdp:u1\/z0_comb | 2.290
Route | | 1 | \QuadDec_M1:Cnt16:CounterUDB:status_1\ | \QuadDec_M1:Cnt16:CounterUDB:sC16:counterdp:u1\/z0_comb | \QuadDec_M1:Cnt16:CounterUDB:reload\/main_1 | 9.303
macrocell2 | U(1,2) | 1 | \QuadDec_M1:Cnt16:CounterUDB:reload\ | \QuadDec_M1:Cnt16:CounterUDB:reload\/main_1 | \QuadDec_M1:Cnt16:CounterUDB:reload\/q | 3.350
Route | | 1 | \QuadDec_M1:Cnt16:CounterUDB:reload\ | \QuadDec_M1:Cnt16:CounterUDB:reload\/q | \QuadDec_M1:Cnt16:CounterUDB:sC16:counterdp:u0\/cs_addr_0 | 7.778
datapathcell1 | U(2,0) | 1 | \QuadDec_M1:Cnt16:CounterUDB:sC16:counterdp:u0\ | \QuadDec_M1:Cnt16:CounterUDB:sC16:counterdp:u0\/cs_addr_0 | \QuadDec_M1:Cnt16:CounterUDB:sC16:counterdp:u0\/co_msb | 5.130
Route | | 1 | \QuadDec_M1:Cnt16:CounterUDB:sC16:counterdp:u0.co_msb__sig\ | \QuadDec_M1:Cnt16:CounterUDB:sC16:counterdp:u0\/co_msb | \QuadDec_M1:Cnt16:CounterUDB:sC16:counterdp:u1\/ci | 0.000
datapathcell2 | U(3,0) | 1 | \QuadDec_M1:Cnt16:CounterUDB:sC16:counterdp:u1\ | | SETUP | 4.230
Clock | | | | | Skew | 0.000
\QuadDec_M1:Cnt16:CounterUDB:sC16:counterdp:u0\/ff0 | \QuadDec_M1:Cnt16:CounterUDB:sC16:counterdp:u1\/ci | 31.316 MHz | 31.933 | 51.400

Type | Location | Fanout | Instance/Net | Source | Dest | Delay (ns)
datapathcell1 | U(2,0) | 1 | \QuadDec_M1:Cnt16:CounterUDB:sC16:counterdp:u0\ | \QuadDec_M1:Cnt16:CounterUDB:sC16:counterdp:u0\/clock | \QuadDec_M1:Cnt16:CounterUDB:sC16:counterdp:u0\/ff0 | 0.670
Route | | 1 | \QuadDec_M1:Cnt16:CounterUDB:sC16:counterdp:u0.ff0__sig\ | \QuadDec_M1:Cnt16:CounterUDB:sC16:counterdp:u0\/ff0 | \QuadDec_M1:Cnt16:CounterUDB:sC16:counterdp:u1\/ff0i | 0.000
datapathcell2 | U(3,0) | 1 | \QuadDec_M1:Cnt16:CounterUDB:sC16:counterdp:u1\ | \QuadDec_M1:Cnt16:CounterUDB:sC16:counterdp:u1\/ff0i | \QuadDec_M1:Cnt16:CounterUDB:sC16:counterdp:u1\/f0_comb | 2.720
Route | | 1 | \QuadDec_M1:Cnt16:CounterUDB:overflow\ | \QuadDec_M1:Cnt16:CounterUDB:sC16:counterdp:u1\/f0_comb | \QuadDec_M1:Cnt16:CounterUDB:reload\/main_2 | 8.055
macrocell2 | U(1,2) | 1 | \QuadDec_M1:Cnt16:CounterUDB:reload\ | \QuadDec_M1:Cnt16:CounterUDB:reload\/main_2 | \QuadDec_M1:Cnt16:CounterUDB:reload\/q | 3.350
Route | | 1 | \QuadDec_M1:Cnt16:CounterUDB:reload\ | \QuadDec_M1:Cnt16:CounterUDB:reload\/q | \QuadDec_M1:Cnt16:CounterUDB:sC16:counterdp:u0\/cs_addr_0 | 7.778
datapathcell1 | U(2,0) | 1 | \QuadDec_M1:Cnt16:CounterUDB:sC16:counterdp:u0\ | \QuadDec_M1:Cnt16:CounterUDB:sC16:counterdp:u0\/cs_addr_0 | \QuadDec_M1:Cnt16:CounterUDB:sC16:counterdp:u0\/co_msb | 5.130
Route | | 1 | \QuadDec_M1:Cnt16:CounterUDB:sC16:counterdp:u0.co_msb__sig\ | \QuadDec_M1:Cnt16:CounterUDB:sC16:counterdp:u0\/co_msb | \QuadDec_M1:Cnt16:CounterUDB:sC16:counterdp:u1\/ci | 0.000
datapathcell2 | U(3,0) | 1 | \QuadDec_M1:Cnt16:CounterUDB:sC16:counterdp:u1\ | | SETUP | 4.230
Clock | | | | | Skew | 0.000
\QuadDec_M1:Cnt16:CounterUDB:sC16:counterdp:u1\/f0_comb | \QuadDec_M1:Cnt16:CounterUDB:sC16:counterdp:u1\/ci | 32.528 MHz | 30.743 | 52.590

Type | Location | Fanout | Instance/Net | Source | Dest | Delay (ns)
datapathcell2 | U(3,0) | 1 | \QuadDec_M1:Cnt16:CounterUDB:sC16:counterdp:u1\ | \QuadDec_M1:Cnt16:CounterUDB:sC16:counterdp:u1\/clock | \QuadDec_M1:Cnt16:CounterUDB:sC16:counterdp:u1\/f0_comb | 2.200
Route | | 1 | \QuadDec_M1:Cnt16:CounterUDB:overflow\ | \QuadDec_M1:Cnt16:CounterUDB:sC16:counterdp:u1\/f0_comb | \QuadDec_M1:Cnt16:CounterUDB:reload\/main_2 | 8.055
macrocell2 | U(1,2) | 1 | \QuadDec_M1:Cnt16:CounterUDB:reload\ | \QuadDec_M1:Cnt16:CounterUDB:reload\/main_2 | \QuadDec_M1:Cnt16:CounterUDB:reload\/q | 3.350
Route | | 1 | \QuadDec_M1:Cnt16:CounterUDB:reload\ | \QuadDec_M1:Cnt16:CounterUDB:reload\/q | \QuadDec_M1:Cnt16:CounterUDB:sC16:counterdp:u0\/cs_addr_0 | 7.778
datapathcell1 | U(2,0) | 1 | \QuadDec_M1:Cnt16:CounterUDB:sC16:counterdp:u0\ | \QuadDec_M1:Cnt16:CounterUDB:sC16:counterdp:u0\/cs_addr_0 | \QuadDec_M1:Cnt16:CounterUDB:sC16:counterdp:u0\/co_msb | 5.130
Route | | 1 | \QuadDec_M1:Cnt16:CounterUDB:sC16:counterdp:u0.co_msb__sig\ | \QuadDec_M1:Cnt16:CounterUDB:sC16:counterdp:u0\/co_msb | \QuadDec_M1:Cnt16:CounterUDB:sC16:counterdp:u1\/ci | 0.000
datapathcell2 | U(3,0) | 1 | \QuadDec_M1:Cnt16:CounterUDB:sC16:counterdp:u1\ | | SETUP | 4.230
Clock | | | | | Skew | 0.000
\QuadDec_M1:Cnt16:CounterUDB:sC16:counterdp:u0\/z0 | \QuadDec_M1:Cnt16:CounterUDB:sC16:counterdp:u1\/cs_addr_0 | 33.340 MHz | 29.994 | 53.339

Type | Location | Fanout | Instance/Net | Source | Dest | Delay (ns)
datapathcell1 | U(2,0) | 1 | \QuadDec_M1:Cnt16:CounterUDB:sC16:counterdp:u0\ | \QuadDec_M1:Cnt16:CounterUDB:sC16:counterdp:u0\/clock | \QuadDec_M1:Cnt16:CounterUDB:sC16:counterdp:u0\/z0 | 0.760
Route | | 1 | \QuadDec_M1:Cnt16:CounterUDB:sC16:counterdp:u0.z0__sig\ | \QuadDec_M1:Cnt16:CounterUDB:sC16:counterdp:u0\/z0 | \QuadDec_M1:Cnt16:CounterUDB:sC16:counterdp:u1\/z0i | 0.000
datapathcell2 | U(3,0) | 1 | \QuadDec_M1:Cnt16:CounterUDB:sC16:counterdp:u1\ | \QuadDec_M1:Cnt16:CounterUDB:sC16:counterdp:u1\/z0i | \QuadDec_M1:Cnt16:CounterUDB:sC16:counterdp:u1\/z0_comb | 2.740
Route | | 1 | \QuadDec_M1:Cnt16:CounterUDB:status_1\ | \QuadDec_M1:Cnt16:CounterUDB:sC16:counterdp:u1\/z0_comb | \QuadDec_M1:Cnt16:CounterUDB:reload\/main_1 | 9.303
macrocell2 | U(1,2) | 1 | \QuadDec_M1:Cnt16:CounterUDB:reload\ | \QuadDec_M1:Cnt16:CounterUDB:reload\/main_1 | \QuadDec_M1:Cnt16:CounterUDB:reload\/q | 3.350
Route | | 1 | \QuadDec_M1:Cnt16:CounterUDB:reload\ | \QuadDec_M1:Cnt16:CounterUDB:reload\/q | \QuadDec_M1:Cnt16:CounterUDB:sC16:counterdp:u1\/cs_addr_0 | 7.781
datapathcell2 | U(3,0) | 1 | \QuadDec_M1:Cnt16:CounterUDB:sC16:counterdp:u1\ | | SETUP | 6.060
Clock | | | | | Skew | 0.000
\QuadDec_M1:Cnt16:CounterUDB:sC16:counterdp:u0\/z0 | \QuadDec_M1:Cnt16:CounterUDB:sC16:counterdp:u0\/cs_addr_0 | 33.343 MHz | 29.991 | 53.342

Type | Location | Fanout | Instance/Net | Source | Dest | Delay (ns)
datapathcell1 | U(2,0) | 1 | \QuadDec_M1:Cnt16:CounterUDB:sC16:counterdp:u0\ | \QuadDec_M1:Cnt16:CounterUDB:sC16:counterdp:u0\/clock | \QuadDec_M1:Cnt16:CounterUDB:sC16:counterdp:u0\/z0 | 0.760
Route | | 1 | \QuadDec_M1:Cnt16:CounterUDB:sC16:counterdp:u0.z0__sig\ | \QuadDec_M1:Cnt16:CounterUDB:sC16:counterdp:u0\/z0 | \QuadDec_M1:Cnt16:CounterUDB:sC16:counterdp:u1\/z0i | 0.000
datapathcell2 | U(3,0) | 1 | \QuadDec_M1:Cnt16:CounterUDB:sC16:counterdp:u1\ | \QuadDec_M1:Cnt16:CounterUDB:sC16:counterdp:u1\/z0i | \QuadDec_M1:Cnt16:CounterUDB:sC16:counterdp:u1\/z0_comb | 2.740
Route | | 1 | \QuadDec_M1:Cnt16:CounterUDB:status_1\ | \QuadDec_M1:Cnt16:CounterUDB:sC16:counterdp:u1\/z0_comb | \QuadDec_M1:Cnt16:CounterUDB:reload\/main_1 | 9.303
macrocell2 | U(1,2) | 1 | \QuadDec_M1:Cnt16:CounterUDB:reload\ | \QuadDec_M1:Cnt16:CounterUDB:reload\/main_1 | \QuadDec_M1:Cnt16:CounterUDB:reload\/q | 3.350
Route | | 1 | \QuadDec_M1:Cnt16:CounterUDB:reload\ | \QuadDec_M1:Cnt16:CounterUDB:reload\/q | \QuadDec_M1:Cnt16:CounterUDB:sC16:counterdp:u0\/cs_addr_0 | 7.778
datapathcell1 | U(2,0) | 1 | \QuadDec_M1:Cnt16:CounterUDB:sC16:counterdp:u0\ | | SETUP | 6.060
Clock | | | | | Skew | 0.000
\QuadDec_M1:Cnt16:CounterUDB:sC16:counterdp:u1\/z0_comb | \QuadDec_M1:Cnt16:CounterUDB:sC16:counterdp:u1\/cs_addr_0 | 34.742 MHz | 28.784 | 54.549

Type | Location | Fanout | Instance/Net | Source | Dest | Delay (ns)
datapathcell2 | U(3,0) | 1 | \QuadDec_M1:Cnt16:CounterUDB:sC16:counterdp:u1\ | \QuadDec_M1:Cnt16:CounterUDB:sC16:counterdp:u1\/clock | \QuadDec_M1:Cnt16:CounterUDB:sC16:counterdp:u1\/z0_comb | 2.290
Route | | 1 | \QuadDec_M1:Cnt16:CounterUDB:status_1\ | \QuadDec_M1:Cnt16:CounterUDB:sC16:counterdp:u1\/z0_comb | \QuadDec_M1:Cnt16:CounterUDB:reload\/main_1 | 9.303
macrocell2 | U(1,2) | 1 | \QuadDec_M1:Cnt16:CounterUDB:reload\ | \QuadDec_M1:Cnt16:CounterUDB:reload\/main_1 | \QuadDec_M1:Cnt16:CounterUDB:reload\/q | 3.350
Route | | 1 | \QuadDec_M1:Cnt16:CounterUDB:reload\ | \QuadDec_M1:Cnt16:CounterUDB:reload\/q | \QuadDec_M1:Cnt16:CounterUDB:sC16:counterdp:u1\/cs_addr_0 | 7.781
datapathcell2 | U(3,0) | 1 | \QuadDec_M1:Cnt16:CounterUDB:sC16:counterdp:u1\ | | SETUP | 6.060
Clock | | | | | Skew | 0.000
\QuadDec_M1:Cnt16:CounterUDB:sC16:counterdp:u1\/z0_comb | \QuadDec_M1:Cnt16:CounterUDB:sC16:counterdp:u0\/cs_addr_0 | 34.745 MHz | 28.781 | 54.552

Type | Location | Fanout | Instance/Net | Source | Dest | Delay (ns)
datapathcell2 | U(3,0) | 1 | \QuadDec_M1:Cnt16:CounterUDB:sC16:counterdp:u1\ | \QuadDec_M1:Cnt16:CounterUDB:sC16:counterdp:u1\/clock | \QuadDec_M1:Cnt16:CounterUDB:sC16:counterdp:u1\/z0_comb | 2.290
Route | | 1 | \QuadDec_M1:Cnt16:CounterUDB:status_1\ | \QuadDec_M1:Cnt16:CounterUDB:sC16:counterdp:u1\/z0_comb | \QuadDec_M1:Cnt16:CounterUDB:reload\/main_1 | 9.303
macrocell2 | U(1,2) | 1 | \QuadDec_M1:Cnt16:CounterUDB:reload\ | \QuadDec_M1:Cnt16:CounterUDB:reload\/main_1 | \QuadDec_M1:Cnt16:CounterUDB:reload\/q | 3.350
Route | | 1 | \QuadDec_M1:Cnt16:CounterUDB:reload\ | \QuadDec_M1:Cnt16:CounterUDB:reload\/q | \QuadDec_M1:Cnt16:CounterUDB:sC16:counterdp:u0\/cs_addr_0 | 7.778
datapathcell1 | U(2,0) | 1 | \QuadDec_M1:Cnt16:CounterUDB:sC16:counterdp:u0\ | | SETUP | 6.060
Clock | | | | | Skew | 0.000
\QuadDec_M1:Cnt16:CounterUDB:sC16:counterdp:u0\/ff0 | \QuadDec_M1:Cnt16:CounterUDB:sC16:counterdp:u1\/cs_addr_0 | 34.921 MHz | 28.636 | 54.697

Type | Location | Fanout | Instance/Net | Source | Dest | Delay (ns)
datapathcell1 | U(2,0) | 1 | \QuadDec_M1:Cnt16:CounterUDB:sC16:counterdp:u0\ | \QuadDec_M1:Cnt16:CounterUDB:sC16:counterdp:u0\/clock | \QuadDec_M1:Cnt16:CounterUDB:sC16:counterdp:u0\/ff0 | 0.670
Route | | 1 | \QuadDec_M1:Cnt16:CounterUDB:sC16:counterdp:u0.ff0__sig\ | \QuadDec_M1:Cnt16:CounterUDB:sC16:counterdp:u0\/ff0 | \QuadDec_M1:Cnt16:CounterUDB:sC16:counterdp:u1\/ff0i | 0.000
datapathcell2 | U(3,0) | 1 | \QuadDec_M1:Cnt16:CounterUDB:sC16:counterdp:u1\ | \QuadDec_M1:Cnt16:CounterUDB:sC16:counterdp:u1\/ff0i | \QuadDec_M1:Cnt16:CounterUDB:sC16:counterdp:u1\/f0_comb | 2.720
Route | | 1 | \QuadDec_M1:Cnt16:CounterUDB:overflow\ | \QuadDec_M1:Cnt16:CounterUDB:sC16:counterdp:u1\/f0_comb | \QuadDec_M1:Cnt16:CounterUDB:reload\/main_2 | 8.055
macrocell2 | U(1,2) | 1 | \QuadDec_M1:Cnt16:CounterUDB:reload\ | \QuadDec_M1:Cnt16:CounterUDB:reload\/main_2 | \QuadDec_M1:Cnt16:CounterUDB:reload\/q | 3.350
Route | | 1 | \QuadDec_M1:Cnt16:CounterUDB:reload\ | \QuadDec_M1:Cnt16:CounterUDB:reload\/q | \QuadDec_M1:Cnt16:CounterUDB:sC16:counterdp:u1\/cs_addr_0 | 7.781
datapathcell2 | U(3,0) | 1 | \QuadDec_M1:Cnt16:CounterUDB:sC16:counterdp:u1\ | | SETUP | 6.060
Clock | | | | | Skew | 0.000
\QuadDec_M1:Cnt16:CounterUDB:sC16:counterdp:u0\/ff0 | \QuadDec_M1:Cnt16:CounterUDB:sC16:counterdp:u0\/cs_addr_0 | 34.925 MHz | 28.633 | 54.700

Type | Location | Fanout | Instance/Net | Source | Dest | Delay (ns)
datapathcell1 | U(2,0) | 1 | \QuadDec_M1:Cnt16:CounterUDB:sC16:counterdp:u0\ | \QuadDec_M1:Cnt16:CounterUDB:sC16:counterdp:u0\/clock | \QuadDec_M1:Cnt16:CounterUDB:sC16:counterdp:u0\/ff0 | 0.670
Route | | 1 | \QuadDec_M1:Cnt16:CounterUDB:sC16:counterdp:u0.ff0__sig\ | \QuadDec_M1:Cnt16:CounterUDB:sC16:counterdp:u0\/ff0 | \QuadDec_M1:Cnt16:CounterUDB:sC16:counterdp:u1\/ff0i | 0.000
datapathcell2 | U(3,0) | 1 | \QuadDec_M1:Cnt16:CounterUDB:sC16:counterdp:u1\ | \QuadDec_M1:Cnt16:CounterUDB:sC16:counterdp:u1\/ff0i | \QuadDec_M1:Cnt16:CounterUDB:sC16:counterdp:u1\/f0_comb | 2.720
Route | | 1 | \QuadDec_M1:Cnt16:CounterUDB:overflow\ | \QuadDec_M1:Cnt16:CounterUDB:sC16:counterdp:u1\/f0_comb | \QuadDec_M1:Cnt16:CounterUDB:reload\/main_2 | 8.055
macrocell2 | U(1,2) | 1 | \QuadDec_M1:Cnt16:CounterUDB:reload\ | \QuadDec_M1:Cnt16:CounterUDB:reload\/main_2 | \QuadDec_M1:Cnt16:CounterUDB:reload\/q | 3.350
Route | | 1 | \QuadDec_M1:Cnt16:CounterUDB:reload\ | \QuadDec_M1:Cnt16:CounterUDB:reload\/q | \QuadDec_M1:Cnt16:CounterUDB:sC16:counterdp:u0\/cs_addr_0 | 7.778
datapathcell1 | U(2,0) | 1 | \QuadDec_M1:Cnt16:CounterUDB:sC16:counterdp:u0\ | | SETUP | 6.060
Clock | | | | | Skew | 0.000

+ Source Clock : CyBUS_CLK : Positive edge(Required Frequency 60 MHz)

+ Destination Clock : ADC_IntClock : Positive edge(Required Frequency 2.85714 MHz)

Path Delay Requirement : 16.6667ns(60 MHz)

Affects clock : CyMASTER_CLK

Source | Destination | FMax | Delay (ns) | Slack (ns) | Violation
\ADC:bSAR_SEQ:bus_clk_nrq_reg\/q | Net_1497/main_0 | 132.855 MHz | 7.527 | 9.140

Type | Location | Fanout | Instance/Net | Source | Dest | Delay (ns)
macrocell140 | U(1,2) | 1 | \ADC:bSAR_SEQ:bus_clk_nrq_reg\ | \ADC:bSAR_SEQ:bus_clk_nrq_reg\/clock_0 | \ADC:bSAR_SEQ:bus_clk_nrq_reg\/q | 1.250
Route | | 1 | \ADC:bSAR_SEQ:bus_clk_nrq_reg\ | \ADC:bSAR_SEQ:bus_clk_nrq_reg\/q | Net_1497/main_0 | 2.767
macrocell139 | U(1,2) | 1 | Net_1497 | | SETUP | 3.510
Clock | | | | | Skew | 0.000
\ADC:bSAR_SEQ:bus_clk_nrq_reg\/q | \ADC:bSAR_SEQ:nrq_reg\/main_0 | 132.855 MHz | 7.527 | 9.140

Type | Location | Fanout | Instance/Net | Source | Dest | Delay (ns)
macrocell140 | U(1,2) | 1 | \ADC:bSAR_SEQ:bus_clk_nrq_reg\ | \ADC:bSAR_SEQ:bus_clk_nrq_reg\/clock_0 | \ADC:bSAR_SEQ:bus_clk_nrq_reg\/q | 1.250
Route | | 1 | \ADC:bSAR_SEQ:bus_clk_nrq_reg\ | \ADC:bSAR_SEQ:bus_clk_nrq_reg\/q | \ADC:bSAR_SEQ:nrq_reg\/main_0 | 2.767
macrocell141 | U(1,2) | 1 | \ADC:bSAR_SEQ:nrq_reg\ | | SETUP | 3.510
Clock | | | | | Skew | 0.000

+ Destination Clock : Clock_QENC : Positive edge(Required Frequency 12 MHz)

Path Delay Requirement : 16.6667ns(60 MHz)

Affects clock : CyMASTER_CLK

Source | Destination | FMax | Delay (ns) | Slack (ns) | Violation
M1_QA(0)_SYNC/out | \QuadDec_M1:bQuadDec:quad_A_delayed_0\/main_0 | 134.102 MHz | 7.457 | 9.210

Type | Location | Fanout | Instance/Net | Source | Dest | Delay (ns)
synccell | U(0,2) | 1 | M1_QA(0)_SYNC | M1_QA(0)_SYNC/clock | M1_QA(0)_SYNC/out | 1.020
Route | | 1 | Net_724_SYNCOUT | M1_QA(0)_SYNC/out | \QuadDec_M1:bQuadDec:quad_A_delayed_0\/main_0 | 2.927
macrocell29 | U(0,1) | 1 | \QuadDec_M1:bQuadDec:quad_A_delayed_0\ | | SETUP | 3.510
Clock | | | | | Skew | 0.000
M2_QB(0)_SYNC/out | \QuadDec_M2:bQuadDec:quad_B_delayed_0\/main_0 | 146.263 MHz | 6.837 | 9.830

Type | Location | Fanout | Instance/Net | Source | Dest | Delay (ns)
synccell | U(0,1) | 1 | M2_QB(0)_SYNC | M2_QB(0)_SYNC/clock | M2_QB(0)_SYNC/out | 1.020
Route | | 1 | Net_730_SYNCOUT | M2_QB(0)_SYNC/out | \QuadDec_M2:bQuadDec:quad_B_delayed_0\/main_0 | 2.307
macrocell38 | U(0,1) | 1 | \QuadDec_M2:bQuadDec:quad_B_delayed_0\ | | SETUP | 3.510
Clock | | | | | Skew | 0.000
M2_QA(0)_SYNC/out | \QuadDec_M2:bQuadDec:quad_A_delayed_0\/main_0 | 147.710 MHz | 6.770 | 9.897

Type | Location | Fanout | Instance/Net | Source | Dest | Delay (ns)
synccell | U(1,0) | 1 | M2_QA(0)_SYNC | M2_QA(0)_SYNC/clock | M2_QA(0)_SYNC/out | 1.020
Route | | 1 | Net_729_SYNCOUT | M2_QA(0)_SYNC/out | \QuadDec_M2:bQuadDec:quad_A_delayed_0\/main_0 | 2.240
macrocell35 | U(1,0) | 1 | \QuadDec_M2:bQuadDec:quad_A_delayed_0\ | | SETUP | 3.510
Clock | | | | | Skew | 0.000
M1_QB(0)_SYNC/out | \QuadDec_M1:bQuadDec:quad_B_delayed_0\/main_0 | 147.820 MHz | 6.765 | 9.902

Type | Location | Fanout | Instance/Net | Source | Dest | Delay (ns)
synccell | U(1,0) | 1 | M1_QB(0)_SYNC | M1_QB(0)_SYNC/clock | M1_QB(0)_SYNC/out | 1.020
Route | | 1 | Net_725_SYNCOUT | M1_QB(0)_SYNC/out | \QuadDec_M1:bQuadDec:quad_B_delayed_0\/main_0 | 2.235
macrocell32 | U(1,0) | 1 | \QuadDec_M1:bQuadDec:quad_B_delayed_0\ | | SETUP | 3.510
Clock | | | | | Skew | 0.000

+ Destination Clock : CyBUS_CLK : Positive edge(Required Frequency 60 MHz)

Path Delay Requirement : 16.6667ns(60 MHz)

Source | Destination | FMax | Delay (ns) | Slack (ns) | Violation
\ADC:Sync:genblk1[0]:INST\/out | \ADC:bSAR_SEQ:bus_clk_nrq_reg\/main_1 | 89.190 MHz | 11.212 | 5.455

Type | Location | Fanout | Instance/Net | Source | Dest | Delay (ns)
synccell | U(2,3) | 1 | \ADC:Sync:genblk1[0]:INST\ | \ADC:Sync:genblk1[0]:INST\/clock | \ADC:Sync:genblk1[0]:INST\/out | 1.020
Route | | 1 | \ADC:Net_3935\ | \ADC:Sync:genblk1[0]:INST\/out | \ADC:bSAR_SEQ:bus_clk_nrq_reg\/main_1 | 6.682
macrocell140 | U(1,2) | 1 | \ADC:bSAR_SEQ:bus_clk_nrq_reg\ | | SETUP | 3.510
Clock | | | | | Skew | 0.000
\ADC:bSAR_SEQ:bus_clk_nrq_reg\/q | \ADC:bSAR_SEQ:bus_clk_nrq_reg\/main_0 | 132.328 MHz | 7.557 | 9.110

Type | Location | Fanout | Instance/Net | Source | Dest | Delay (ns)
macrocell140 | U(1,2) | 1 | \ADC:bSAR_SEQ:bus_clk_nrq_reg\ | \ADC:bSAR_SEQ:bus_clk_nrq_reg\/clock_0 | \ADC:bSAR_SEQ:bus_clk_nrq_reg\/q | 1.250
macrocell140 | U(1,2) | 1 | \ADC:bSAR_SEQ:bus_clk_nrq_reg\ | \ADC:bSAR_SEQ:bus_clk_nrq_reg\/q | \ADC:bSAR_SEQ:bus_clk_nrq_reg\/main_0 | 2.797
macrocell140 | U(1,2) | 1 | \ADC:bSAR_SEQ:bus_clk_nrq_reg\ | | SETUP | 3.510
Clock | | | | | Skew | 0.000

+ Destination Clock : UART_IntClock : Positive edge(Required Frequency 461.538 kHz)

Path Delay Requirement : 16.6667ns(60 MHz)

Affects clock : CyMASTER_CLK

Source | Destination | FMax | Delay (ns) | Slack (ns) | Violation
\RF_BT_SELECT:Sync:ctrl_reg\/control_0 | \UART:BUART:rx_state_0\/main_3 | 66.525 MHz | 15.032 | 1.635

Type | Location | Fanout | Instance/Net | Source | Dest | Delay (ns)
controlcell5 | U(1,3) | 1 | \RF_BT_SELECT:Sync:ctrl_reg\ | \RF_BT_SELECT:Sync:ctrl_reg\/busclk | \RF_BT_SELECT:Sync:ctrl_reg\/control_0 | 2.050
Route | | 1 | Net_3437 | \RF_BT_SELECT:Sync:ctrl_reg\/control_0 | \UART:BUART:rx_postpoll\/main_2 | 3.218
macrocell25 | U(1,4) | 1 | \UART:BUART:rx_postpoll\ | \UART:BUART:rx_postpoll\/main_2 | \UART:BUART:rx_postpoll\/q | 3.350
Route | | 1 | \UART:BUART:rx_postpoll\ | \UART:BUART:rx_postpoll\/q | \UART:BUART:rx_state_0\/main_3 | 2.904
macrocell153 | U(1,5) | 1 | \UART:BUART:rx_state_0\ | | SETUP | 3.510
Clock | | | | | Skew | 0.000
\RF_BT_SELECT:Sync:ctrl_reg\/control_0 | \UART:BUART:rx_status_3\/main_3 | 66.525 MHz | 15.032 | 1.635

Type | Location | Fanout | Instance/Net | Source | Dest | Delay (ns)
controlcell5 | U(1,3) | 1 | \RF_BT_SELECT:Sync:ctrl_reg\ | \RF_BT_SELECT:Sync:ctrl_reg\/busclk | \RF_BT_SELECT:Sync:ctrl_reg\/control_0 | 2.050
Route | | 1 | Net_3437 | \RF_BT_SELECT:Sync:ctrl_reg\/control_0 | \UART:BUART:rx_postpoll\/main_2 | 3.218
macrocell25 | U(1,4) | 1 | \UART:BUART:rx_postpoll\ | \UART:BUART:rx_postpoll\/main_2 | \UART:BUART:rx_postpoll\/q | 3.350
Route | | 1 | \UART:BUART:rx_postpoll\ | \UART:BUART:rx_postpoll\/q | \UART:BUART:rx_status_3\/main_3 | 2.904
macrocell162 | U(1,5) | 1 | \UART:BUART:rx_status_3\ | | SETUP | 3.510
Clock | | | | | Skew | 0.000
\RF_BT_SELECT:Sync:ctrl_reg\/control_0 | \UART:BUART:sRX:RxShifter:u0\/route_si | 66.720 MHz | 14.988 | 1.679

Type | Location | Fanout | Instance/Net | Source | Dest | Delay (ns)
controlcell5 | U(1,3) | 1 | \RF_BT_SELECT:Sync:ctrl_reg\ | \RF_BT_SELECT:Sync:ctrl_reg\/busclk | \RF_BT_SELECT:Sync:ctrl_reg\/control_0 | 2.050
Route | | 1 | Net_3437 | \RF_BT_SELECT:Sync:ctrl_reg\/control_0 | \UART:BUART:rx_postpoll\/main_2 | 3.218
macrocell25 | U(1,4) | 1 | \UART:BUART:rx_postpoll\ | \UART:BUART:rx_postpoll\/main_2 | \UART:BUART:rx_postpoll\/q | 3.350
Route | | 1 | \UART:BUART:rx_postpoll\ | \UART:BUART:rx_postpoll\/q | \UART:BUART:sRX:RxShifter:u0\/route_si | 2.900
datapathcell7 | U(1,3) | 1 | \UART:BUART:sRX:RxShifter:u0\ | | SETUP | 3.470
Clock | | | | | Skew | 0.000
Rx_2(0)_SYNC/out | \UART:BUART:rx_state_0\/main_3 | 71.322 MHz | 14.021 | 2.646

Type | Location | Fanout | Instance/Net | Source | Dest | Delay (ns)
synccell | U(0,3) | 1 | Rx_2(0)_SYNC | Rx_2(0)_SYNC/clock | Rx_2(0)_SYNC/out | 1.020
Route | | 1 | Net_3405_SYNCOUT | Rx_2(0)_SYNC/out | \UART:BUART:rx_postpoll\/main_4 | 3.237
macrocell25 | U(1,4) | 1 | \UART:BUART:rx_postpoll\ | \UART:BUART:rx_postpoll\/main_4 | \UART:BUART:rx_postpoll\/q | 3.350
Route | | 1 | \UART:BUART:rx_postpoll\ | \UART:BUART:rx_postpoll\/q | \UART:BUART:rx_state_0\/main_3 | 2.904
macrocell153 | U(1,5) | 1 | \UART:BUART:rx_state_0\ | | SETUP | 3.510
Clock | | | | | Skew | 0.000
Rx_2(0)_SYNC/out | \UART:BUART:rx_status_3\/main_3 | 71.322 MHz | 14.021 | 2.646

Type | Location | Fanout | Instance/Net | Source | Dest | Delay (ns)
synccell | U(0,3) | 1 | Rx_2(0)_SYNC | Rx_2(0)_SYNC/clock | Rx_2(0)_SYNC/out | 1.020
Route | | 1 | Net_3405_SYNCOUT | Rx_2(0)_SYNC/out | \UART:BUART:rx_postpoll\/main_4 | 3.237
macrocell25 | U(1,4) | 1 | \UART:BUART:rx_postpoll\ | \UART:BUART:rx_postpoll\/main_4 | \UART:BUART:rx_postpoll\/q | 3.350
Route | | 1 | \UART:BUART:rx_postpoll\ | \UART:BUART:rx_postpoll\/q | \UART:BUART:rx_status_3\/main_3 | 2.904
macrocell162 | U(1,5) | 1 | \UART:BUART:rx_status_3\ | | SETUP | 3.510
Clock | | | | | Skew | 0.000
Rx_1(0)_SYNC/out | \UART:BUART:rx_state_0\/main_3 | 71.337 MHz | 14.018 | 2.649

Type | Location | Fanout | Instance/Net | Source | Dest | Delay (ns)
synccell | U(0,3) | 1 | Rx_1(0)_SYNC | Rx_1(0)_SYNC/clock | Rx_1(0)_SYNC/out | 1.020
Route | | 1 | Net_3438_SYNCOUT | Rx_1(0)_SYNC/out | \UART:BUART:rx_postpoll\/main_3 | 3.234
macrocell25 | U(1,4) | 1 | \UART:BUART:rx_postpoll\ | \UART:BUART:rx_postpoll\/main_3 | \UART:BUART:rx_postpoll\/q | 3.350
Route | | 1 | \UART:BUART:rx_postpoll\ | \UART:BUART:rx_postpoll\/q | \UART:BUART:rx_state_0\/main_3 | 2.904
macrocell153 | U(1,5) | 1 | \UART:BUART:rx_state_0\ | | SETUP | 3.510
Clock | | | | | Skew | 0.000
Rx_1(0)_SYNC/out | \UART:BUART:rx_status_3\/main_3 | 71.337 MHz | 14.018 | 2.649

Type | Location | Fanout | Instance/Net | Source | Dest | Delay (ns)
synccell | U(0,3) | 1 | Rx_1(0)_SYNC | Rx_1(0)_SYNC/clock | Rx_1(0)_SYNC/out | 1.020
Route | | 1 | Net_3438_SYNCOUT | Rx_1(0)_SYNC/out | \UART:BUART:rx_postpoll\/main_3 | 3.234
macrocell25 | U(1,4) | 1 | \UART:BUART:rx_postpoll\ | \UART:BUART:rx_postpoll\/main_3 | \UART:BUART:rx_postpoll\/q | 3.350
Route | | 1 | \UART:BUART:rx_postpoll\ | \UART:BUART:rx_postpoll\/q | \UART:BUART:rx_status_3\/main_3 | 2.904
macrocell162 | U(1,5) | 1 | \UART:BUART:rx_status_3\ | | SETUP | 3.510
Clock | | | | | Skew | 0.000
Rx_2(0)_SYNC/out | \UART:BUART:sRX:RxShifter:u0\/route_si | 71.546 MHz | 13.977 | 2.690

Type | Location | Fanout | Instance/Net | Source | Dest | Delay (ns)
synccell | U(0,3) | 1 | Rx_2(0)_SYNC | Rx_2(0)_SYNC/clock | Rx_2(0)_SYNC/out | 1.020
Route | | 1 | Net_3405_SYNCOUT | Rx_2(0)_SYNC/out | \UART:BUART:rx_postpoll\/main_4 | 3.237
macrocell25 | U(1,4) | 1 | \UART:BUART:rx_postpoll\ | \UART:BUART:rx_postpoll\/main_4 | \UART:BUART:rx_postpoll\/q | 3.350
Route | | 1 | \UART:BUART:rx_postpoll\ | \UART:BUART:rx_postpoll\/q | \UART:BUART:sRX:RxShifter:u0\/route_si | 2.900
datapathcell7 | U(1,3) | 1 | \UART:BUART:sRX:RxShifter:u0\ | | SETUP | 3.470
Clock | | | | | Skew | 0.000
Rx_1(0)_SYNC/out | \UART:BUART:sRX:RxShifter:u0\/route_si | 71.561 MHz | 13.974 | 2.693

Type | Location | Fanout | Instance/Net | Source | Dest | Delay (ns)
synccell | U(0,3) | 1 | Rx_1(0)_SYNC | Rx_1(0)_SYNC/clock | Rx_1(0)_SYNC/out | 1.020
Route | | 1 | Net_3438_SYNCOUT | Rx_1(0)_SYNC/out | \UART:BUART:rx_postpoll\/main_3 | 3.234
macrocell25 | U(1,4) | 1 | \UART:BUART:rx_postpoll\ | \UART:BUART:rx_postpoll\/main_3 | \UART:BUART:rx_postpoll\/q | 3.350
Route | | 1 | \UART:BUART:rx_postpoll\ | \UART:BUART:rx_postpoll\/q | \UART:BUART:sRX:RxShifter:u0\/route_si | 2.900
datapathcell7 | U(1,3) | 1 | \UART:BUART:sRX:RxShifter:u0\ | | SETUP | 3.470
Clock | | | | | Skew | 0.000
\RF_BT_SELECT:Sync:ctrl_reg\/control_0 | \UART:BUART:rx_last\/main_0 | 101.327 MHz | 9.869 | 6.798

Type | Location | Fanout | Instance/Net | Source | Dest | Delay (ns)
controlcell5 | U(1,3) | 1 | \RF_BT_SELECT:Sync:ctrl_reg\ | \RF_BT_SELECT:Sync:ctrl_reg\/busclk | \RF_BT_SELECT:Sync:ctrl_reg\/control_0 | 2.050
Route | | 1 | Net_3437 | \RF_BT_SELECT:Sync:ctrl_reg\/control_0 | \UART:BUART:rx_last\/main_0 | 4.309
macrocell163 | U(0,5) | 1 | \UART:BUART:rx_last\ | | SETUP | 3.510
Clock | | | | | Skew | 0.000

+ Source Clock : UART_IntClock : Positive edge(Required Frequency 461.538 kHz)

+ Destination Clock : UART_IntClock : Positive edge(Required Frequency 461.538 kHz)

Path Delay Requirement : 2166.67ns(461.538 kHz)

Source | Destination | FMax | Delay (ns) | Slack (ns) | Violation
\UART:BUART:rx_state_0\/q | \UART:BUART:sRX:RxBitCounter\/load | 39.200 MHz | 25.510 | 2141.157

Type | Location | Fanout | Instance/Net | Source | Dest | Delay (ns)
macrocell153 | U(1,5) | 1 | \UART:BUART:rx_state_0\ | \UART:BUART:rx_state_0\/clock_0 | \UART:BUART:rx_state_0\/q | 1.250
Route | | 1 | \UART:BUART:rx_state_0\ | \UART:BUART:rx_state_0\/q | \UART:BUART:rx_counter_load\/main_1 | 11.125
macrocell24 | U(1,2) | 1 | \UART:BUART:rx_counter_load\ | \UART:BUART:rx_counter_load\/main_1 | \UART:BUART:rx_counter_load\/q | 3.350
Route | | 1 | \UART:BUART:rx_counter_load\ | \UART:BUART:rx_counter_load\/q | \UART:BUART:sRX:RxBitCounter\/load | 4.425
count7cell | U(1,5) | 1 | \UART:BUART:sRX:RxBitCounter\ | | SETUP | 5.360
Clock | | | | | Skew | 0.000
\UART:BUART:rx_state_3\/q | \UART:BUART:sRX:RxBitCounter\/load | 47.904 MHz | 20.875 | 2145.792

Type | Location | Fanout | Instance/Net | Source | Dest | Delay (ns)
macrocell155 | U(1,5) | 1 | \UART:BUART:rx_state_3\ | \UART:BUART:rx_state_3\/clock_0 | \UART:BUART:rx_state_3\/q | 1.250
Route | | 1 | \UART:BUART:rx_state_3\ | \UART:BUART:rx_state_3\/q | \UART:BUART:rx_counter_load\/main_2 | 6.490
macrocell24 | U(1,2) | 1 | \UART:BUART:rx_counter_load\ | \UART:BUART:rx_counter_load\/main_2 | \UART:BUART:rx_counter_load\/q | 3.350
Route | | 1 | \UART:BUART:rx_counter_load\ | \UART:BUART:rx_counter_load\/q | \UART:BUART:sRX:RxBitCounter\/load | 4.425
count7cell | U(1,5) | 1 | \UART:BUART:sRX:RxBitCounter\ | | SETUP | 5.360
Clock | | | | | Skew | 0.000
\UART:BUART:rx_state_2\/q | \UART:BUART:sRX:RxBitCounter\/load | 51.377 MHz | 19.464 | 2147.203

Type | Location | Fanout | Instance/Net | Source | Dest | Delay (ns)
macrocell156 | U(1,5) | 1 | \UART:BUART:rx_state_2\ | \UART:BUART:rx_state_2\/clock_0 | \UART:BUART:rx_state_2\/q | 1.250
Route | | 1 | \UART:BUART:rx_state_2\ | \UART:BUART:rx_state_2\/q | \UART:BUART:rx_counter_load\/main_3 | 5.079
macrocell24 | U(1,2) | 1 | \UART:BUART:rx_counter_load\ | \UART:BUART:rx_counter_load\/main_3 | \UART:BUART:rx_counter_load\/q | 3.350
Route | | 1 | \UART:BUART:rx_counter_load\ | \UART:BUART:rx_counter_load\/q | \UART:BUART:sRX:RxBitCounter\/load | 4.425
count7cell | U(1,5) | 1 | \UART:BUART:sRX:RxBitCounter\ | | SETUP | 5.360
Clock | | | | | Skew | 0.000
\UART:BUART:rx_state_0\/q | \UART:BUART:sRX:RxShifter:u0\/cs_addr_1 | 54.277 MHz | 18.424 | 2148.243

Type | Location | Fanout | Instance/Net | Source | Dest | Delay (ns)
macrocell153 | U(1,5) | 1 | \UART:BUART:rx_state_0\ | \UART:BUART:rx_state_0\/clock_0 | \UART:BUART:rx_state_0\/q | 1.250
Route | | 1 | \UART:BUART:rx_state_0\ | \UART:BUART:rx_state_0\/q | \UART:BUART:sRX:RxShifter:u0\/cs_addr_1 | 11.164
datapathcell7 | U(1,3) | 1 | \UART:BUART:sRX:RxShifter:u0\ | | SETUP | 6.010
Clock | | | | | Skew | 0.000
\UART:BUART:tx_ctrl_mark_last\/q | \UART:BUART:sRX:RxBitCounter\/load | 56.931 MHz | 17.565 | 2149.102

Type | Location | Fanout | Instance/Net | Source | Dest | Delay (ns)
macrocell152 | U(0,2) | 1 | \UART:BUART:tx_ctrl_mark_last\ | \UART:BUART:tx_ctrl_mark_last\/clock_0 | \UART:BUART:tx_ctrl_mark_last\/q | 1.250
Route | | 1 | \UART:BUART:tx_ctrl_mark_last\ | \UART:BUART:tx_ctrl_mark_last\/q | \UART:BUART:rx_counter_load\/main_0 | 3.180
macrocell24 | U(1,2) | 1 | \UART:BUART:rx_counter_load\ | \UART:BUART:rx_counter_load\/main_0 | \UART:BUART:rx_counter_load\/q | 3.350
Route | | 1 | \UART:BUART:rx_counter_load\ | \UART:BUART:rx_counter_load\/q | \UART:BUART:sRX:RxBitCounter\/load | 4.425
count7cell | U(1,5) | 1 | \UART:BUART:sRX:RxBitCounter\ | | SETUP | 5.360
Clock | | | | | Skew | 0.000
\UART:BUART:tx_state_2\/q | \UART:BUART:sTX:sCLOCK:TxBitClkGen\/cs_addr_0 | 63.028 MHz | 15.866 | 2150.801

Type | Location | Fanout | Instance/Net | Source | Dest | Delay (ns)
macrocell150 | U(1,3) | 1 | \UART:BUART:tx_state_2\ | \UART:BUART:tx_state_2\/clock_0 | \UART:BUART:tx_state_2\/q | 1.250
Route | | 1 | \UART:BUART:tx_state_2\ | \UART:BUART:tx_state_2\/q | \UART:BUART:counter_load_not\/main_3 | 2.769
macrocell21 | U(1,3) | 1 | \UART:BUART:counter_load_not\ | \UART:BUART:counter_load_not\/main_3 | \UART:BUART:counter_load_not\/q | 3.350
Route | | 1 | \UART:BUART:counter_load_not\ | \UART:BUART:counter_load_not\/q | \UART:BUART:sTX:sCLOCK:TxBitClkGen\/cs_addr_0 | 2.307
datapathcell6 | U(0,3) | 1 | \UART:BUART:sTX:sCLOCK:TxBitClkGen\ | | SETUP | 6.190
Clock | | | | | Skew | 0.000
\UART:BUART:tx_state_1\/q | \UART:BUART:sTX:sCLOCK:TxBitClkGen\/cs_addr_0 | 63.036 MHz | 15.864 | 2150.803

Type | Location | Fanout | Instance/Net | Source | Dest | Delay (ns)
macrocell148 | U(1,3) | 1 | \UART:BUART:tx_state_1\ | \UART:BUART:tx_state_1\/clock_0 | \UART:BUART:tx_state_1\/q | 1.250
Route | | 1 | \UART:BUART:tx_state_1\ | \UART:BUART:tx_state_1\/q | \UART:BUART:counter_load_not\/main_0 | 2.767
macrocell21 | U(1,3) | 1 | \UART:BUART:counter_load_not\ | \UART:BUART:counter_load_not\/main_0 | \UART:BUART:counter_load_not\/q | 3.350
Route | | 1 | \UART:BUART:counter_load_not\ | \UART:BUART:counter_load_not\/q | \UART:BUART:sTX:sCLOCK:TxBitClkGen\/cs_addr_0 | 2.307
datapathcell6 | U(0,3) | 1 | \UART:BUART:sTX:sCLOCK:TxBitClkGen\ | | SETUP | 6.190
Clock | | | | | Skew | 0.000
\UART:BUART:tx_state_0\/q | \UART:BUART:sTX:sCLOCK:TxBitClkGen\/cs_addr_0 | 63.808 MHz | 15.672 | 2150.995

Type | Location | Fanout | Instance/Net | Source | Dest | Delay (ns)
macrocell149 | U(1,3) | 1 | \UART:BUART:tx_state_0\ | \UART:BUART:tx_state_0\/clock_0 | \UART:BUART:tx_state_0\/q | 1.250
Route | | 1 | \UART:BUART:tx_state_0\ | \UART:BUART:tx_state_0\/q | \UART:BUART:counter_load_not\/main_1 | 2.575
macrocell21 | U(1,3) | 1 | \UART:BUART:counter_load_not\ | \UART:BUART:counter_load_not\/main_1 | \UART:BUART:counter_load_not\/q | 3.350
Route | | 1 | \UART:BUART:counter_load_not\ | \UART:BUART:counter_load_not\/q | \UART:BUART:sTX:sCLOCK:TxBitClkGen\/cs_addr_0 | 2.307
datapathcell6 | U(0,3) | 1 | \UART:BUART:sTX:sCLOCK:TxBitClkGen\ | | SETUP | 6.190
Clock | | | | | Skew | 0.000
\UART:BUART:sTX:TxShifter:u0\/f0_blk_stat_comb | \UART:BUART:sTX:TxSts\/status_0 | 64.767 MHz | 15.440 | 2151.227

Type | Location | Fanout | Instance/Net | Source | Dest | Delay (ns)
datapathcell5 | U(1,4) | 1 | \UART:BUART:sTX:TxShifter:u0\ | \UART:BUART:sTX:TxShifter:u0\/clock | \UART:BUART:sTX:TxShifter:u0\/f0_blk_stat_comb | 3.580
Route | | 1 | \UART:BUART:tx_fifo_empty\ | \UART:BUART:sTX:TxShifter:u0\/f0_blk_stat_comb | \UART:BUART:tx_status_0\/main_3 | 5.083
macrocell22 | U(1,3) | 1 | \UART:BUART:tx_status_0\ | \UART:BUART:tx_status_0\/main_3 | \UART:BUART:tx_status_0\/q | 3.350
Route | | 1 | \UART:BUART:tx_status_0\ | \UART:BUART:tx_status_0\/q | \UART:BUART:sTX:TxSts\/status_0 | 2.927
statusicell5 | U(1,4) | 1 | \UART:BUART:sTX:TxSts\ | | SETUP | 0.500
Clock | | | | | Skew | 0.000
\UART:BUART:sTX:sCLOCK:TxBitClkGen\/ce0_reg | \UART:BUART:sTX:sCLOCK:TxBitClkGen\/cs_addr_0 | 66.041 MHz | 15.142 | 2151.525

Type | Location | Fanout | Instance/Net | Source | Dest | Delay (ns)
datapathcell6 | U(0,3) | 1 | \UART:BUART:sTX:sCLOCK:TxBitClkGen\ | \UART:BUART:sTX:sCLOCK:TxBitClkGen\/clock | \UART:BUART:sTX:sCLOCK:TxBitClkGen\/ce0_reg | 0.190
Route | | 1 | \UART:BUART:tx_bitclk_enable_pre\ | \UART:BUART:sTX:sCLOCK:TxBitClkGen\/ce0_reg | \UART:BUART:counter_load_not\/main_2 | 3.105
macrocell21 | U(1,3) | 1 | \UART:BUART:counter_load_not\ | \UART:BUART:counter_load_not\/main_2 | \UART:BUART:counter_load_not\/q | 3.350
Route | | 1 | \UART:BUART:counter_load_not\ | \UART:BUART:counter_load_not\/q | \UART:BUART:sTX:sCLOCK:TxBitClkGen\/cs_addr_0 | 2.307
datapathcell6 | U(0,3) | 1 | \UART:BUART:sTX:sCLOCK:TxBitClkGen\ | | SETUP | 6.190
Clock | | | | | Skew | 0.000

+ Hold Subsection

+ Source Clock : ADC_IntClock : Positive edge

+ Destination Clock : ADC_IntClock : Positive edge

Source | Destination | Slack (ns) | Violation
\ADC:bSAR_SEQ:state_1\/q | \ADC:soc_out\/main_4 | 3.553

Type | Location | Fanout | Instance/Net | Source | Dest | Delay (ns)
macrocell145 | U(2,5) | 1 | \ADC:bSAR_SEQ:state_1\ | \ADC:bSAR_SEQ:state_1\/clock_0 | \ADC:bSAR_SEQ:state_1\/q | 1.250
Route | | 1 | \ADC:bSAR_SEQ:state_1\ | \ADC:bSAR_SEQ:state_1\/q | \ADC:soc_out\/main_4 | 2.303
macrocell143 | U(2,5) | 1 | \ADC:soc_out\ | | HOLD | 0.000
Clock | | | | | Skew | 0.000
\ADC:bSAR_SEQ:state_1\/q | \ADC:bSAR_SEQ:state_1\/main_3 | 3.553

Type | Location | Fanout | Instance/Net | Source | Dest | Delay (ns)
macrocell145 | U(2,5) | 1 | \ADC:bSAR_SEQ:state_1\ | \ADC:bSAR_SEQ:state_1\/clock_0 | \ADC:bSAR_SEQ:state_1\/q | 1.250
macrocell145 | U(2,5) | 1 | \ADC:bSAR_SEQ:state_1\ | \ADC:bSAR_SEQ:state_1\/q | \ADC:bSAR_SEQ:state_1\/main_3 | 2.303
macrocell145 | U(2,5) | 1 | \ADC:bSAR_SEQ:state_1\ | | HOLD | 0.000
Clock | | | | | Skew | 0.000
\ADC:bSAR_SEQ:soc_reg\/q | \ADC:bSAR_SEQ:soc_in\/main_0 | 3.554

Type | Location | Fanout | Instance/Net | Source | Dest | Delay (ns)
macrocell144 | U(2,5) | 1 | \ADC:bSAR_SEQ:soc_reg\ | \ADC:bSAR_SEQ:soc_reg\/clock_0 | \ADC:bSAR_SEQ:soc_reg\/q | 1.250
Route | | 1 | \ADC:bSAR_SEQ:soc_reg\ | \ADC:bSAR_SEQ:soc_reg\/q | \ADC:bSAR_SEQ:soc_in\/main_0 | 2.304
macrocell142 | U(2,5) | 1 | \ADC:bSAR_SEQ:soc_in\ | | HOLD | 0.000
Clock | | | | | Skew | 0.000
\ADC:bSAR_SEQ:soc_in\/q | \ADC:soc_out\/main_3 | 3.558

Type | Location | Fanout | Instance/Net | Source | Dest | Delay (ns)
macrocell142 | U(2,5) | 1 | \ADC:bSAR_SEQ:soc_in\ | \ADC:bSAR_SEQ:soc_in\/clock_0 | \ADC:bSAR_SEQ:soc_in\/q | 1.250
Route | | 1 | \ADC:bSAR_SEQ:soc_in\ | \ADC:bSAR_SEQ:soc_in\/q | \ADC:soc_out\/main_3 | 2.308
macrocell143 | U(2,5) | 1 | \ADC:soc_out\ | | HOLD | 0.000
Clock | | | | | Skew | 0.000
\ADC:bSAR_SEQ:nrq_reg\/q | Net_1497/main_1 | 3.563

Type | Location | Fanout | Instance/Net | Source | Dest | Delay (ns)
macrocell141 | U(1,2) | 1 | \ADC:bSAR_SEQ:nrq_reg\ | \ADC:bSAR_SEQ:nrq_reg\/clock_0 | \ADC:bSAR_SEQ:nrq_reg\/q | 1.250
Route | | 1 | \ADC:bSAR_SEQ:nrq_reg\ | \ADC:bSAR_SEQ:nrq_reg\/q | Net_1497/main_1 | 2.313
macrocell139 | U(1,2) | 1 | Net_1497 | | HOLD | 0.000
Clock | | | | | Skew | 0.000
\ADC:bSAR_SEQ:ChannelCounter\/count_4 | \ADC:AMuxHw_2_Decoder_old_id_4\/main_0 | 3.732

Type | Location | Fanout | Instance/Net | Source | Dest | Delay (ns)
count7cell | U(2,2) | 1 | \ADC:bSAR_SEQ:ChannelCounter\ | \ADC:bSAR_SEQ:ChannelCounter\/clock | \ADC:bSAR_SEQ:ChannelCounter\/count_4 | 0.620
Route | | 1 | \ADC:ch_addr_4\ | \ADC:bSAR_SEQ:ChannelCounter\/count_4 | \ADC:AMuxHw_2_Decoder_old_id_4\/main_0 | 3.112
macrocell70 | U(3,2) | 1 | \ADC:AMuxHw_2_Decoder_old_id_4\ | | HOLD | 0.000
Clock | | | | | Skew | 0.000
\ADC:AMuxHw_2_Decoder_old_id_2\/q | \ADC:AMuxHw_2_Decoder_one_hot_29\/main_4 | 4.093

Type | Location | Fanout | Instance/Net | Source | Dest | Delay (ns)
macrocell72 | U(2,0) | 1 | \ADC:AMuxHw_2_Decoder_old_id_2\ | \ADC:AMuxHw_2_Decoder_old_id_2\/clock_0 | \ADC:AMuxHw_2_Decoder_old_id_2\/q | 1.250
Route | | 1 | \ADC:AMuxHw_2_Decoder_old_id_2\ | \ADC:AMuxHw_2_Decoder_old_id_2\/q | \ADC:AMuxHw_2_Decoder_one_hot_29\/main_4 | 2.843
macrocell104 | U(2,0) | 1 | \ADC:AMuxHw_2_Decoder_one_hot_29\ | | HOLD | 0.000
Clock | | | | | Skew | 0.000
\ADC:AMuxHw_2_Decoder_old_id_2\/q | \ADC:AMuxHw_2_Decoder_one_hot_59\/main_4 | 4.093

Type | Location | Fanout | Instance/Net | Source | Dest | Delay (ns)
macrocell72 | U(2,0) | 1 | \ADC:AMuxHw_2_Decoder_old_id_2\ | \ADC:AMuxHw_2_Decoder_old_id_2\/clock_0 | \ADC:AMuxHw_2_Decoder_old_id_2\/q | 1.250
Route | | 1 | \ADC:AMuxHw_2_Decoder_old_id_2\ | \ADC:AMuxHw_2_Decoder_old_id_2\/q | \ADC:AMuxHw_2_Decoder_one_hot_59\/main_4 | 2.843
macrocell134 | U(2,0) | 1 | \ADC:AMuxHw_2_Decoder_one_hot_59\ | | HOLD | 0.000
Clock | | | | | Skew | 0.000
\ADC:AMuxHw_2_Decoder_old_id_2\/q | \ADC:AMuxHw_2_Decoder_one_hot_60\/main_4 | 4.093

Type | Location | Fanout | Instance/Net | Source | Dest | Delay (ns)
macrocell72 | U(2,0) | 1 | \ADC:AMuxHw_2_Decoder_old_id_2\ | \ADC:AMuxHw_2_Decoder_old_id_2\/clock_0 | \ADC:AMuxHw_2_Decoder_old_id_2\/q | 1.250
Route | | 1 | \ADC:AMuxHw_2_Decoder_old_id_2\ | \ADC:AMuxHw_2_Decoder_old_id_2\/q | \ADC:AMuxHw_2_Decoder_one_hot_60\/main_4 | 2.843
macrocell135 | U(2,0) | 1 | \ADC:AMuxHw_2_Decoder_one_hot_60\ | | HOLD | 0.000
Clock | | | | | Skew | 0.000
\ADC:AMuxHw_2_Decoder_old_id_2\/q | \ADC:AMuxHw_2_Decoder_one_hot_62\/main_4 | 4.093

Type | Location | Fanout | Instance/Net | Source | Dest | Delay (ns)
macrocell72 | U(2,0) | 1 | \ADC:AMuxHw_2_Decoder_old_id_2\ | \ADC:AMuxHw_2_Decoder_old_id_2\/clock_0 | \ADC:AMuxHw_2_Decoder_old_id_2\/q | 1.250
Route | | 1 | \ADC:AMuxHw_2_Decoder_old_id_2\ | \ADC:AMuxHw_2_Decoder_old_id_2\/q | \ADC:AMuxHw_2_Decoder_one_hot_62\/main_4 | 2.843
macrocell137 | U(2,0) | 1 | \ADC:AMuxHw_2_Decoder_one_hot_62\ | | HOLD | 0.000
Clock | | | | | Skew | 0.000

+ Destination Clock : CyBUS_CLK : Positive edge

Source | Destination | Slack (ns) | Violation
Net_1497/q | \ADC:bSAR_SEQ:bus_clk_nrq_reg\/main_2 | 4.840

Type | Location | Fanout | Instance/Net | Source | Dest | Delay (ns)
macrocell139 | U(1,2) | 1 | Net_1497 | Net_1497/clock_0 | Net_1497/q | 1.250
Route | | 1 | Net_1497 | Net_1497/q | \ADC:bSAR_SEQ:bus_clk_nrq_reg\/main_2 | 3.590
macrocell140 | U(1,2) | 1 | \ADC:bSAR_SEQ:bus_clk_nrq_reg\ | | HOLD | 0.000
Clock | | | | | Skew | 0.000

+ Source Clock : Clock_QENC : Positive edge

+ Destination Clock : Clock_QENC : Positive edge

Source | Destination | Slack (ns) | Violation
\QuadDec_M1:Cnt16:CounterUDB:sC16:counterdp:u0\/co_msb | \QuadDec_M1:Cnt16:CounterUDB:sC16:counterdp:u1\/ci | 2.140

Type | Location | Fanout | Instance/Net | Source | Dest | Delay (ns)
datapathcell1 | U(2,0) | 1 | \QuadDec_M1:Cnt16:CounterUDB:sC16:counterdp:u0\ | \QuadDec_M1:Cnt16:CounterUDB:sC16:counterdp:u0\/clock | \QuadDec_M1:Cnt16:CounterUDB:sC16:counterdp:u0\/co_msb | 2.140
Route | | 1 | \QuadDec_M1:Cnt16:CounterUDB:sC16:counterdp:u0.co_msb__sig\ | \QuadDec_M1:Cnt16:CounterUDB:sC16:counterdp:u0\/co_msb | \QuadDec_M1:Cnt16:CounterUDB:sC16:counterdp:u1\/ci | 0.000
datapathcell2 | U(3,0) | 1 | \QuadDec_M1:Cnt16:CounterUDB:sC16:counterdp:u1\ | | HOLD | 0.000
Clock | | | | | Skew | 0.000
\QuadDec_M2:Cnt16:CounterUDB:sC16:counterdp:u0\/co_msb | \QuadDec_M2:Cnt16:CounterUDB:sC16:counterdp:u1\/ci | 2.140

Type | Location | Fanout | Instance/Net | Source | Dest | Delay (ns)
datapathcell3 | U(2,3) | 1 | \QuadDec_M2:Cnt16:CounterUDB:sC16:counterdp:u0\ | \QuadDec_M2:Cnt16:CounterUDB:sC16:counterdp:u0\/clock | \QuadDec_M2:Cnt16:CounterUDB:sC16:counterdp:u0\/co_msb | 2.140
Route | | 1 | \QuadDec_M2:Cnt16:CounterUDB:sC16:counterdp:u0.co_msb__sig\ | \QuadDec_M2:Cnt16:CounterUDB:sC16:counterdp:u0\/co_msb | \QuadDec_M2:Cnt16:CounterUDB:sC16:counterdp:u1\/ci | 0.000
datapathcell4 | U(3,3) | 1 | \QuadDec_M2:Cnt16:CounterUDB:sC16:counterdp:u1\ | | HOLD | 0.000
Clock | | | | | Skew | 0.000
\QuadDec_M1:bQuadDec:quad_A_delayed_2\/q | \QuadDec_M1:bQuadDec:quad_A_filt\/main_2 | 3.484

Type | Location | Fanout | Instance/Net | Source | Dest | Delay (ns)
macrocell31 | U(0,0) | 1 | \QuadDec_M1:bQuadDec:quad_A_delayed_2\ | \QuadDec_M1:bQuadDec:quad_A_delayed_2\/clock_0 | \QuadDec_M1:bQuadDec:quad_A_delayed_2\/q | 1.250
Route | | 1 | \QuadDec_M1:bQuadDec:quad_A_delayed_2\ | \QuadDec_M1:bQuadDec:quad_A_delayed_2\/q | \QuadDec_M1:bQuadDec:quad_A_filt\/main_2 | 2.234
macrocell49 | U(0,0) | 1 | \QuadDec_M1:bQuadDec:quad_A_filt\ | | HOLD | 0.000
Clock | | | | | Skew | 0.000
\QuadDec_M2:bQuadDec:quad_A_delayed_0\/q | \QuadDec_M2:bQuadDec:quad_A_delayed_1\/main_0 | 3.485

Type | Location | Fanout | Instance/Net | Source | Dest | Delay (ns)
macrocell35 | U(1,0) | 1 | \QuadDec_M2:bQuadDec:quad_A_delayed_0\ | \QuadDec_M2:bQuadDec:quad_A_delayed_0\/clock_0 | \QuadDec_M2:bQuadDec:quad_A_delayed_0\/q | 1.250
Route | | 1 | \QuadDec_M2:bQuadDec:quad_A_delayed_0\ | \QuadDec_M2:bQuadDec:quad_A_delayed_0\/q | \QuadDec_M2:bQuadDec:quad_A_delayed_1\/main_0 | 2.235
macrocell36 | U(0,0) | 1 | \QuadDec_M2:bQuadDec:quad_A_delayed_1\ | | HOLD | 0.000
Clock | | | | | Skew | 0.000
\QuadDec_M2:bQuadDec:quad_A_delayed_0\/q | \QuadDec_M2:bQuadDec:quad_A_filt\/main_0 | 3.485

Type | Location | Fanout | Instance/Net | Source | Dest | Delay (ns)
macrocell35 | U(1,0) | 1 | \QuadDec_M2:bQuadDec:quad_A_delayed_0\ | \QuadDec_M2:bQuadDec:quad_A_delayed_0\/clock_0 | \QuadDec_M2:bQuadDec:quad_A_delayed_0\/q | 1.250
Route | | 1 | \QuadDec_M2:bQuadDec:quad_A_delayed_0\ | \QuadDec_M2:bQuadDec:quad_A_delayed_0\/q | \QuadDec_M2:bQuadDec:quad_A_filt\/main_0 | 2.235
macrocell63 | U(0,0) | 1 | \QuadDec_M2:bQuadDec:quad_A_filt\ | | HOLD | 0.000
Clock | | | | | Skew | 0.000
\QuadDec_M1:bQuadDec:quad_A_delayed_1\/q | \QuadDec_M1:bQuadDec:quad_A_delayed_2\/main_0 | 3.488

Type | Location | Fanout | Instance/Net | Source | Dest | Delay (ns)
macrocell30 | U(0,0) | 1 | \QuadDec_M1:bQuadDec:quad_A_delayed_1\ | \QuadDec_M1:bQuadDec:quad_A_delayed_1\/clock_0 | \QuadDec_M1:bQuadDec:quad_A_delayed_1\/q | 1.250
Route | | 1 | \QuadDec_M1:bQuadDec:quad_A_delayed_1\ | \QuadDec_M1:bQuadDec:quad_A_delayed_1\/q | \QuadDec_M1:bQuadDec:quad_A_delayed_2\/main_0 | 2.238
macrocell31 | U(0,0) | 1 | \QuadDec_M1:bQuadDec:quad_A_delayed_2\ | | HOLD | 0.000
Clock | | | | | Skew | 0.000
\QuadDec_M1:bQuadDec:quad_A_delayed_1\/q | \QuadDec_M1:bQuadDec:quad_A_filt\/main_1 | 3.488

Type | Location | Fanout | Instance/Net | Source | Dest | Delay (ns)
macrocell30 | U(0,0) | 1 | \QuadDec_M1:bQuadDec:quad_A_delayed_1\ | \QuadDec_M1:bQuadDec:quad_A_delayed_1\/clock_0 | \QuadDec_M1:bQuadDec:quad_A_delayed_1\/q | 1.250
Route | | 1 | \QuadDec_M1:bQuadDec:quad_A_delayed_1\ | \QuadDec_M1:bQuadDec:quad_A_delayed_1\/q | \QuadDec_M1:bQuadDec:quad_A_filt\/main_1 | 2.238
macrocell49 | U(0,0) | 1 | \QuadDec_M1:bQuadDec:quad_A_filt\ | | HOLD | 0.000
Clock | | | | | Skew | 0.000
\QuadDec_M2:Net_1260\/q | \QuadDec_M2:bQuadDec:Stsreg\/status_2 | 3.498

Type | Location | Fanout | Instance/Net | Source | Dest | Delay (ns)
macrocell65 | U(3,4) | 1 | \QuadDec_M2:Net_1260\ | \QuadDec_M2:Net_1260\/clock_0 | \QuadDec_M2:Net_1260\/q | 1.250
Route | | 1 | \QuadDec_M2:Net_1260\ | \QuadDec_M2:Net_1260\/q | \QuadDec_M2:bQuadDec:Stsreg\/status_2 | 4.248
statusicell4 | U(3,4) | 1 | \QuadDec_M2:bQuadDec:Stsreg\ | | HOLD | -2.000
Clock | | | | | Skew | 0.000
\QuadDec_M2:bQuadDec:quad_B_delayed_1\/q | \QuadDec_M2:bQuadDec:quad_B_delayed_2\/main_0 | 3.546

Type | Location | Fanout | Instance/Net | Source | Dest | Delay (ns)
macrocell39 | U(0,1) | 1 | \QuadDec_M2:bQuadDec:quad_B_delayed_1\ | \QuadDec_M2:bQuadDec:quad_B_delayed_1\/clock_0 | \QuadDec_M2:bQuadDec:quad_B_delayed_1\/q | 1.250
Route | | 1 | \QuadDec_M2:bQuadDec:quad_B_delayed_1\ | \QuadDec_M2:bQuadDec:quad_B_delayed_1\/q | \QuadDec_M2:bQuadDec:quad_B_delayed_2\/main_0 | 2.296
macrocell40 | U(0,1) | 1 | \QuadDec_M2:bQuadDec:quad_B_delayed_2\ | | HOLD | 0.000
Clock | | | | | Skew | 0.000
\QuadDec_M2:bQuadDec:quad_B_delayed_1\/q | \QuadDec_M2:bQuadDec:quad_B_filt\/main_1 | 3.546

Type | Location | Fanout | Instance/Net | Source | Dest | Delay (ns)
macrocell39 | U(0,1) | 1 | \QuadDec_M2:bQuadDec:quad_B_delayed_1\ | \QuadDec_M2:bQuadDec:quad_B_delayed_1\/clock_0 | \QuadDec_M2:bQuadDec:quad_B_delayed_1\/q | 1.250
Route | | 1 | \QuadDec_M2:bQuadDec:quad_B_delayed_1\ | \QuadDec_M2:bQuadDec:quad_B_delayed_1\/q | \QuadDec_M2:bQuadDec:quad_B_filt\/main_1 | 2.296
macrocell64 | U(0,1) | 1 | \QuadDec_M2:bQuadDec:quad_B_filt\ | | HOLD | 0.000
Clock | | | | | Skew | 0.000

+ Source Clock : CyBUS_CLK : Positive edge

+ Destination Clock : ADC_IntClock : Positive edge

Source | Destination | Slack (ns) | Violation
\ADC:bSAR_SEQ:bus_clk_nrq_reg\/q | Net_1497/main_0 | 4.017

Type | Location | Fanout | Instance/Net | Source | Dest | Delay (ns)
macrocell140 | U(1,2) | 1 | \ADC:bSAR_SEQ:bus_clk_nrq_reg\ | \ADC:bSAR_SEQ:bus_clk_nrq_reg\/clock_0 | \ADC:bSAR_SEQ:bus_clk_nrq_reg\/q | 1.250
Route | | 1 | \ADC:bSAR_SEQ:bus_clk_nrq_reg\ | \ADC:bSAR_SEQ:bus_clk_nrq_reg\/q | Net_1497/main_0 | 2.767
macrocell139 | U(1,2) | 1 | Net_1497 | | HOLD | 0.000
Clock | | | | | Skew | 0.000
\ADC:bSAR_SEQ:bus_clk_nrq_reg\/q | \ADC:bSAR_SEQ:nrq_reg\/main_0 | 4.017

Type | Location | Fanout | Instance/Net | Source | Dest | Delay (ns)
macrocell140 | U(1,2) | 1 | \ADC:bSAR_SEQ:bus_clk_nrq_reg\ | \ADC:bSAR_SEQ:bus_clk_nrq_reg\/clock_0 | \ADC:bSAR_SEQ:bus_clk_nrq_reg\/q | 1.250
Route | | 1 | \ADC:bSAR_SEQ:bus_clk_nrq_reg\ | \ADC:bSAR_SEQ:bus_clk_nrq_reg\/q | \ADC:bSAR_SEQ:nrq_reg\/main_0 | 2.767
macrocell141 | U(1,2) | 1 | \ADC:bSAR_SEQ:nrq_reg\ | | HOLD | 0.000
Clock | | | | | Skew | 0.000

+ Destination Clock : Clock_QENC : Positive edge

Source | Destination | Slack (ns) | Violation
M1_QB(0)_SYNC/out | \QuadDec_M1:bQuadDec:quad_B_delayed_0\/main_0 | 2.585

Type | Location | Fanout | Instance/Net | Source | Dest | Delay (ns)
synccell | U(1,0) | 1 | M1_QB(0)_SYNC | M1_QB(0)_SYNC/clock | M1_QB(0)_SYNC/out | 0.350
Route | | 1 | Net_725_SYNCOUT | M1_QB(0)_SYNC/out | \QuadDec_M1:bQuadDec:quad_B_delayed_0\/main_0 | 2.235
macrocell32 | U(1,0) | 1 | \QuadDec_M1:bQuadDec:quad_B_delayed_0\ | | HOLD | 0.000
Clock | | | | | Skew | 0.000
M2_QA(0)_SYNC/out | \QuadDec_M2:bQuadDec:quad_A_delayed_0\/main_0 | 2.590

Type | Location | Fanout | Instance/Net | Source | Dest | Delay (ns)
synccell | U(1,0) | 1 | M2_QA(0)_SYNC | M2_QA(0)_SYNC/clock | M2_QA(0)_SYNC/out | 0.350
Route | | 1 | Net_729_SYNCOUT | M2_QA(0)_SYNC/out | \QuadDec_M2:bQuadDec:quad_A_delayed_0\/main_0 | 2.240
macrocell35 | U(1,0) | 1 | \QuadDec_M2:bQuadDec:quad_A_delayed_0\ | | HOLD | 0.000
Clock | | | | | Skew | 0.000
M2_QB(0)_SYNC/out | \QuadDec_M2:bQuadDec:quad_B_delayed_0\/main_0 | 2.657

Type | Location | Fanout | Instance/Net | Source | Dest | Delay (ns)
synccell | U(0,1) | 1 | M2_QB(0)_SYNC | M2_QB(0)_SYNC/clock | M2_QB(0)_SYNC/out | 0.350
Route | | 1 | Net_730_SYNCOUT | M2_QB(0)_SYNC/out | \QuadDec_M2:bQuadDec:quad_B_delayed_0\/main_0 | 2.307
macrocell38 | U(0,1) | 1 | \QuadDec_M2:bQuadDec:quad_B_delayed_0\ | | HOLD | 0.000
Clock | | | | | Skew | 0.000
M1_QA(0)_SYNC/out | \QuadDec_M1:bQuadDec:quad_A_delayed_0\/main_0 | 3.277

Type | Location | Fanout | Instance/Net | Source | Dest | Delay (ns)
synccell | U(0,2) | 1 | M1_QA(0)_SYNC | M1_QA(0)_SYNC/clock | M1_QA(0)_SYNC/out | 0.350
Route | | 1 | Net_724_SYNCOUT | M1_QA(0)_SYNC/out | \QuadDec_M1:bQuadDec:quad_A_delayed_0\/main_0 | 2.927
macrocell29 | U(0,1) | 1 | \QuadDec_M1:bQuadDec:quad_A_delayed_0\ | | HOLD | 0.000
Clock | | | | | Skew | 0.000

+ Destination Clock : CyBUS_CLK : Positive edge

Source | Destination | Slack (ns) | Violation
\ADC:bSAR_SEQ:bus_clk_nrq_reg\/q | \ADC:bSAR_SEQ:bus_clk_nrq_reg\/main_0 | 4.047

Type | Location | Fanout | Instance/Net | Source | Dest | Delay (ns)
macrocell140 | U(1,2) | 1 | \ADC:bSAR_SEQ:bus_clk_nrq_reg\ | \ADC:bSAR_SEQ:bus_clk_nrq_reg\/clock_0 | \ADC:bSAR_SEQ:bus_clk_nrq_reg\/q | 1.250
macrocell140 | U(1,2) | 1 | \ADC:bSAR_SEQ:bus_clk_nrq_reg\ | \ADC:bSAR_SEQ:bus_clk_nrq_reg\/q | \ADC:bSAR_SEQ:bus_clk_nrq_reg\/main_0 | 2.797
macrocell140 | U(1,2) | 1 | \ADC:bSAR_SEQ:bus_clk_nrq_reg\ | | HOLD | 0.000
Clock | | | | | Skew | 0.000
\ADC:Sync:genblk1[0]:INST\/out | \ADC:bSAR_SEQ:bus_clk_nrq_reg\/main_1 | 7.032

Type | Location | Fanout | Instance/Net | Source | Dest | Delay (ns)
synccell | U(2,3) | 1 | \ADC:Sync:genblk1[0]:INST\ | \ADC:Sync:genblk1[0]:INST\/clock | \ADC:Sync:genblk1[0]:INST\/out | 0.350
Route | | 1 | \ADC:Net_3935\ | \ADC:Sync:genblk1[0]:INST\/out | \ADC:bSAR_SEQ:bus_clk_nrq_reg\/main_1 | 6.682
macrocell140 | U(1,2) | 1 | \ADC:bSAR_SEQ:bus_clk_nrq_reg\ | | HOLD | 0.000
Clock | | | | | Skew | 0.000

+ Destination Clock : UART_IntClock : Positive edge

Source | Destination | Slack (ns) | Violation
Rx_2(0)_SYNC/out | \UART:BUART:pollcount_1\/main_6 | 3.563

Type | Location | Fanout | Instance/Net | Source | Dest | Delay (ns)
synccell | U(0,3) | 1 | Rx_2(0)_SYNC | Rx_2(0)_SYNC/clock | Rx_2(0)_SYNC/out | 0.350
Route | | 1 | Net_3405_SYNCOUT | Rx_2(0)_SYNC/out | \UART:BUART:pollcount_1\/main_6 | 3.213
macrocell159 | U(1,4) | 1 | \UART:BUART:pollcount_1\ | | HOLD | 0.000
Clock | | | | | Skew | 0.000
Rx_2(0)_SYNC/out | \UART:BUART:pollcount_0\/main_5 | 3.563

Type | Location | Fanout | Instance/Net | Source | Dest | Delay (ns)
synccell | U(0,3) | 1 | Rx_2(0)_SYNC | Rx_2(0)_SYNC/clock | Rx_2(0)_SYNC/out | 0.350
Route | | 1 | Net_3405_SYNCOUT | Rx_2(0)_SYNC/out | \UART:BUART:pollcount_0\/main_5 | 3.213
macrocell160 | U(1,4) | 1 | \UART:BUART:pollcount_0\ | | HOLD | 0.000
Clock | | | | | Skew | 0.000
Rx_1(0)_SYNC/out | \UART:BUART:pollcount_1\/main_5 | 3.576

Type | Location | Fanout | Instance/Net | Source | Dest | Delay (ns)
synccell | U(0,3) | 1 | Rx_1(0)_SYNC | Rx_1(0)_SYNC/clock | Rx_1(0)_SYNC/out | 0.350
Route | | 1 | Net_3438_SYNCOUT | Rx_1(0)_SYNC/out | \UART:BUART:pollcount_1\/main_5 | 3.226
macrocell159 | U(1,4) | 1 | \UART:BUART:pollcount_1\ | | HOLD | 0.000
Clock | | | | | Skew | 0.000
Rx_1(0)_SYNC/out | \UART:BUART:pollcount_0\/main_4 | 3.576

Type | Location | Fanout | Instance/Net | Source | Dest | Delay (ns)
synccell | U(0,3) | 1 | Rx_1(0)_SYNC | Rx_1(0)_SYNC/clock | Rx_1(0)_SYNC/out | 0.350
Route | | 1 | Net_3438_SYNCOUT | Rx_1(0)_SYNC/out | \UART:BUART:pollcount_0\/main_4 | 3.226
macrocell160 | U(1,4) | 1 | \UART:BUART:pollcount_0\ | | HOLD | 0.000
Clock | | | | | Skew | 0.000
\RF_BT_SELECT:Sync:ctrl_reg\/control_0 | \UART:BUART:pollcount_1\/main_4 | 3.841

Type | Location | Fanout | Instance/Net | Source | Dest | Delay (ns)
controlcell5 | U(1,3) | 1 | \RF_BT_SELECT:Sync:ctrl_reg\ | \RF_BT_SELECT:Sync:ctrl_reg\/busclk | \RF_BT_SELECT:Sync:ctrl_reg\/control_0 | 0.620
Route | | 1 | Net_3437 | \RF_BT_SELECT:Sync:ctrl_reg\/control_0 | \UART:BUART:pollcount_1\/main_4 | 3.221
macrocell159 | U(1,4) | 1 | \UART:BUART:pollcount_1\ | | HOLD | 0.000
Clock | | | | | Skew | 0.000
\RF_BT_SELECT:Sync:ctrl_reg\/control_0 | \UART:BUART:pollcount_0\/main_3 | 3.841

Type | Location | Fanout | Instance/Net | Source | Dest | Delay (ns)
controlcell5 | U(1,3) | 1 | \RF_BT_SELECT:Sync:ctrl_reg\ | \RF_BT_SELECT:Sync:ctrl_reg\/busclk | \RF_BT_SELECT:Sync:ctrl_reg\/control_0 | 0.620
Route | | 1 | Net_3437 | \RF_BT_SELECT:Sync:ctrl_reg\/control_0 | \UART:BUART:pollcount_0\/main_3 | 3.221
macrocell160 | U(1,4) | 1 | \UART:BUART:pollcount_0\ | | HOLD | 0.000
Clock | | | | | Skew | 0.000
Rx_2(0)_SYNC/out | \UART:BUART:rx_state_2\/main_11 | 4.471

Type | Location | Fanout | Instance/Net | Source | Dest | Delay (ns)
synccell | U(0,3) | 1 | Rx_2(0)_SYNC | Rx_2(0)_SYNC/clock | Rx_2(0)_SYNC/out | 0.350
Route | | 1 | Net_3405_SYNCOUT | Rx_2(0)_SYNC/out | \UART:BUART:rx_state_2\/main_11 | 4.121
macrocell156 | U(1,5) | 1 | \UART:BUART:rx_state_2\ | | HOLD | 0.000
Clock | | | | | Skew | 0.000
Rx_2(0)_SYNC/out | \UART:BUART:rx_last\/main_2 | 4.504

Type | Location | Fanout | Instance/Net | Source | Dest | Delay (ns)
synccell | U(0,3) | 1 | Rx_2(0)_SYNC | Rx_2(0)_SYNC/clock | Rx_2(0)_SYNC/out | 0.350
Route | | 1 | Net_3405_SYNCOUT | Rx_2(0)_SYNC/out | \UART:BUART:rx_last\/main_2 | 4.154
macrocell163 | U(0,5) | 1 | \UART:BUART:rx_last\ | | HOLD | 0.000
Clock | | | | | Skew | 0.000
Rx_1(0)_SYNC/out | \UART:BUART:rx_state_2\/main_10 | 4.648

Type | Location | Fanout | Instance/Net | Source | Dest | Delay (ns)
synccell | U(0,3) | 1 | Rx_1(0)_SYNC | Rx_1(0)_SYNC/clock | Rx_1(0)_SYNC/out | 0.350
Route | | 1 | Net_3438_SYNCOUT | Rx_1(0)_SYNC/out | \UART:BUART:rx_state_2\/main_10 | 4.298
macrocell156 | U(1,5) | 1 | \UART:BUART:rx_state_2\ | | HOLD | 0.000
Clock | | | | | Skew | 0.000
Rx_1(0)_SYNC/out | \UART:BUART:rx_last\/main_1 | 4.661

Type | Location | Fanout | Instance/Net | Source | Dest | Delay (ns)
synccell | U(0,3) | 1 | Rx_1(0)_SYNC | Rx_1(0)_SYNC/clock | Rx_1(0)_SYNC/out | 0.350
Route | | 1 | Net_3438_SYNCOUT | Rx_1(0)_SYNC/out | \UART:BUART:rx_last\/main_1 | 4.311
macrocell163 | U(0,5) | 1 | \UART:BUART:rx_last\ | | HOLD | 0.000
Clock | | | | | Skew | 0.000

+ Source Clock : UART_IntClock : Positive edge

+ Destination Clock : UART_IntClock : Positive edge

Source | Destination | Slack (ns) | Violation
\UART:BUART:sTX:sCLOCK:TxBitClkGen\/ce1_reg | \UART:BUART:tx_state_1\/main_4 | 2.502

Type | Location | Fanout | Instance/Net | Source | Dest | Delay (ns)
datapathcell6 | U(0,3) | 1 | \UART:BUART:sTX:sCLOCK:TxBitClkGen\ | \UART:BUART:sTX:sCLOCK:TxBitClkGen\/clock | \UART:BUART:sTX:sCLOCK:TxBitClkGen\/ce1_reg | 0.190
Route | | 1 | \UART:BUART:tx_counter_dp\ | \UART:BUART:sTX:sCLOCK:TxBitClkGen\/ce1_reg | \UART:BUART:tx_state_1\/main_4 | 2.312
macrocell148 | U(1,3) | 1 | \UART:BUART:tx_state_1\ | | HOLD | 0.000
Clock | | | | | Skew | 0.000
\UART:BUART:sTX:sCLOCK:TxBitClkGen\/ce1_reg | \UART:BUART:tx_state_2\/main_4 | 2.502

Type | Location | Fanout | Instance/Net | Source | Dest | Delay (ns)
datapathcell6 | U(0,3) | 1 | \UART:BUART:sTX:sCLOCK:TxBitClkGen\ | \UART:BUART:sTX:sCLOCK:TxBitClkGen\/clock | \UART:BUART:sTX:sCLOCK:TxBitClkGen\/ce1_reg | 0.190
Route | | 1 | \UART:BUART:tx_counter_dp\ | \UART:BUART:sTX:sCLOCK:TxBitClkGen\/ce1_reg | \UART:BUART:tx_state_2\/main_4 | 2.312
macrocell150 | U(1,3) | 1 | \UART:BUART:tx_state_2\ | | HOLD | 0.000
Clock | | | | | Skew | 0.000
\UART:BUART:sRX:RxBitCounter\/count_1 | \UART:BUART:rx_bitclk_enable\/main_1 | 2.924

Type | Location | Fanout | Instance/Net | Source | Dest | Delay (ns)
count7cell | U(1,5) | 1 | \UART:BUART:sRX:RxBitCounter\ | \UART:BUART:sRX:RxBitCounter\/clock | \UART:BUART:sRX:RxBitCounter\/count_1 | 0.620
Route | | 1 | \UART:BUART:rx_count_1\ | \UART:BUART:sRX:RxBitCounter\/count_1 | \UART:BUART:rx_bitclk_enable\/main_1 | 2.304
macrocell157 | U(1,5) | 1 | \UART:BUART:rx_bitclk_enable\ | | HOLD | 0.000
Clock | | | | | Skew | 0.000
\UART:BUART:sRX:RxBitCounter\/count_2 | \UART:BUART:rx_bitclk_enable\/main_0 | 2.924

Type | Location | Fanout | Instance/Net | Source | Dest | Delay (ns)
count7cell | U(1,5) | 1 | \UART:BUART:sRX:RxBitCounter\ | \UART:BUART:sRX:RxBitCounter\/clock | \UART:BUART:sRX:RxBitCounter\/count_2 | 0.620
Route | | 1 | \UART:BUART:rx_count_2\ | \UART:BUART:sRX:RxBitCounter\/count_2 | \UART:BUART:rx_bitclk_enable\/main_0 | 2.304
macrocell157 | U(1,5) | 1 | \UART:BUART:rx_bitclk_enable\ | | HOLD | 0.000
Clock | | | | | Skew | 0.000
\UART:BUART:sRX:RxBitCounter\/count_0 | \UART:BUART:rx_bitclk_enable\/main_2 | 2.927

Type | Location | Fanout | Instance/Net | Source | Dest | Delay (ns)
count7cell | U(1,5) | 1 | \UART:BUART:sRX:RxBitCounter\ | \UART:BUART:sRX:RxBitCounter\/clock | \UART:BUART:sRX:RxBitCounter\/count_0 | 0.620
Route | | 1 | \UART:BUART:rx_count_0\ | \UART:BUART:sRX:RxBitCounter\/count_0 | \UART:BUART:rx_bitclk_enable\/main_2 | 2.307
macrocell157 | U(1,5) | 1 | \UART:BUART:rx_bitclk_enable\ | | HOLD | 0.000
Clock | | | | | Skew | 0.000
\UART:BUART:sTX:sCLOCK:TxBitClkGen\/ce0_reg | \UART:BUART:tx_state_0\/main_2 | 3.295

Type | Location | Fanout | Instance/Net | Source | Dest | Delay (ns)
datapathcell6 | U(0,3) | 1 | \UART:BUART:sTX:sCLOCK:TxBitClkGen\ | \UART:BUART:sTX:sCLOCK:TxBitClkGen\/clock | \UART:BUART:sTX:sCLOCK:TxBitClkGen\/ce0_reg | 0.190
Route | | 1 | \UART:BUART:tx_bitclk_enable_pre\ | \UART:BUART:sTX:sCLOCK:TxBitClkGen\/ce0_reg | \UART:BUART:tx_state_0\/main_2 | 3.105
macrocell149 | U(1,3) | 1 | \UART:BUART:tx_state_0\ | | HOLD | 0.000
Clock | | | | | Skew | 0.000
\UART:BUART:sTX:sCLOCK:TxBitClkGen\/ce1_reg | \UART:BUART:txn\/main_5 | 3.393

Type | Location | Fanout | Instance/Net | Source | Dest | Delay (ns)
datapathcell6 | U(0,3) | 1 | \UART:BUART:sTX:sCLOCK:TxBitClkGen\ | \UART:BUART:sTX:sCLOCK:TxBitClkGen\/clock | \UART:BUART:sTX:sCLOCK:TxBitClkGen\/ce1_reg | 0.190
Route | | 1 | \UART:BUART:tx_counter_dp\ | \UART:BUART:sTX:sCLOCK:TxBitClkGen\/ce1_reg | \UART:BUART:txn\/main_5 | 3.203
macrocell147 | U(1,4) | 1 | \UART:BUART:txn\ | | HOLD | 0.000
Clock | | | | | Skew | 0.000
\UART:BUART:sRX:RxBitCounter\/count_6 | \UART:BUART:rx_state_0\/main_6 | 3.411

Type | Location | Fanout | Instance/Net | Source | Dest | Delay (ns)
count7cell | U(1,5) | 1 | \UART:BUART:sRX:RxBitCounter\ | \UART:BUART:sRX:RxBitCounter\/clock | \UART:BUART:sRX:RxBitCounter\/count_6 | 0.620
Route | | 1 | \UART:BUART:rx_count_6\ | \UART:BUART:sRX:RxBitCounter\/count_6 | \UART:BUART:rx_state_0\/main_6 | 2.791
macrocell153 | U(1,5) | 1 | \UART:BUART:rx_state_0\ | | HOLD | 0.000
Clock | | | | | Skew | 0.000
\UART:BUART:sRX:RxBitCounter\/count_6 | \UART:BUART:rx_load_fifo\/main_5 | 3.413

Type | Location | Fanout | Instance/Net | Source | Dest | Delay (ns)
count7cell | U(1,5) | 1 | \UART:BUART:sRX:RxBitCounter\ | \UART:BUART:sRX:RxBitCounter\/clock | \UART:BUART:sRX:RxBitCounter\/count_6 | 0.620
Route | | 1 | \UART:BUART:rx_count_6\ | \UART:BUART:sRX:RxBitCounter\/count_6 | \UART:BUART:rx_load_fifo\/main_5 | 2.793
macrocell154 | U(1,5) | 1 | \UART:BUART:rx_load_fifo\ | | HOLD | 0.000
Clock | | | | | Skew | 0.000
\UART:BUART:sRX:RxBitCounter\/count_6 | \UART:BUART:rx_state_3\/main_5 | 3.413

Type | Location | Fanout | Instance/Net | Source | Dest | Delay (ns)
count7cell | U(1,5) | 1 | \UART:BUART:sRX:RxBitCounter\ | \UART:BUART:sRX:RxBitCounter\/clock | \UART:BUART:sRX:RxBitCounter\/count_6 | 0.620
Route | | 1 | \UART:BUART:rx_count_6\ | \UART:BUART:sRX:RxBitCounter\/count_6 | \UART:BUART:rx_state_3\/main_5 | 2.793
macrocell155 | U(1,5) | 1 | \UART:BUART:rx_state_3\ | | HOLD | 0.000
Clock | | | | | Skew | 0.000

+ Asynchronous Clock Crossing Section

+ Source Clock ClockBlock/dclk_glb_ff_3

+ Destination Clock ADC_IntClock

Source | Destination | Delay (ns)
\Timer_TS:TimerHW\/tc | \ADC:bSAR_SEQ:soc_in\/main_1 | 10.825

Type | Location | Fanout | Instance/Net | Source | Dest | Delay (ns)
timercell | F(Timer,3) | 1 | \Timer_TS:TimerHW\ | \Timer_TS:TimerHW\/clock | \Timer_TS:TimerHW\/tc | 1.000
Route | | 1 | Net_1619 | \Timer_TS:TimerHW\/tc | \ADC:bSAR_SEQ:soc_in\/main_1 | 6.315
macrocell142 | U(2,5) | 1 | \ADC:bSAR_SEQ:soc_in\ | | SETUP | 3.510
Clock | | | | | Skew | 0.000
\Timer_TS:TimerHW\/tc | \ADC:bSAR_SEQ:soc_reg\/main_0 | 10.825

Type | Location | Fanout | Instance/Net | Source | Dest | Delay (ns)
timercell | F(Timer,3) | 1 | \Timer_TS:TimerHW\ | \Timer_TS:TimerHW\/clock | \Timer_TS:TimerHW\/tc | 1.000
Route | | 1 | Net_1619 | \Timer_TS:TimerHW\/tc | \ADC:bSAR_SEQ:soc_reg\/main_0 | 6.315
macrocell144 | U(2,5) | 1 | \ADC:bSAR_SEQ:soc_reg\ | | SETUP | 3.510
Clock | | | | | Skew | 0.000

+ Input To Output Section

Source | Destination | Delay (ns)
Q1(0)_PAD | D16(0)_PAD | 23.696

Type | Location | Fanout | Instance/Net | Source | Dest | Delay (ns)
Team12_PsoC_benchmark_test | | 1 | Q1(0)_PAD | Q1(0)_PAD | Q1(0)_PAD | 0.000
Route | | 1 | Q1(0)_PAD | Q1(0)_PAD | Q1(0)/pad_in | 0.000
iocell32 | P3[0] | 1 | Q1(0) | Q1(0)/pad_in | Q1(0)/fb | 6.324
Route | | 1 | Net_4509 | Q1(0)/fb | D16(0)/pin_input | 2.943
iocell39 | P15[1] | 1 | D16(0) | D16(0)/pin_input | D16(0)/pad_out | 14.429
Route | | 1 | D16(0)_PAD | D16(0)/pad_out | D16(0)_PAD | 0.000
Q2(0)_PAD | D11(0)_PAD | 24.339

Type | Location | Fanout | Instance/Net | Source | Dest | Delay (ns)
Team12_PsoC_benchmark_test | | 1 | Q2(0)_PAD | Q2(0)_PAD | Q2(0)_PAD | 0.000
Route | | 1 | Q2(0)_PAD | Q2(0)_PAD | Q2(0)/pad_in | 0.000
iocell33 | P3[1] | 1 | Q2(0) | Q2(0)/pad_in | Q2(0)/fb | 6.259
Route | | 1 | Net_4510 | Q2(0)/fb | D11(0)/pin_input | 2.976
iocell40 | P15[2] | 1 | D11(0) | D11(0)/pin_input | D11(0)/pad_out | 15.104
Route | | 1 | D11(0)_PAD | D11(0)/pad_out | D11(0)_PAD | 0.000
Q5(0)_PAD | D13(0)_PAD | 26.676

Type | Location | Fanout | Instance/Net | Source | Dest | Delay (ns)
Team12_PsoC_benchmark_test | | 1 | Q5(0)_PAD | Q5(0)_PAD | Q5(0)_PAD | 0.000
Route | | 1 | Q5(0)_PAD | Q5(0)_PAD | Q5(0)/pad_in | 0.000
iocell34 | P0[3] | 1 | Q5(0) | Q5(0)/pad_in | Q5(0)/fb | 7.958
Route | | 1 | Net_4511 | Q5(0)/fb | D13(0)/pin_input | 4.463
iocell41 | P15[0] | 1 | D13(0) | D13(0)/pin_input | D13(0)/pad_out | 14.255
Route | | 1 | D13(0)_PAD | D13(0)/pad_out | D13(0)_PAD | 0.000
Q6(0)_PAD | D17(0)_PAD | 26.269

Type | Location | Fanout | Instance/Net | Source | Dest | Delay (ns)
Team12_PsoC_benchmark_test | | 1 | Q6(0)_PAD | Q6(0)_PAD | Q6(0)_PAD | 0.000
Route | | 1 | Q6(0)_PAD | Q6(0)_PAD | Q6(0)/pad_in | 0.000
iocell36 | P0[7] | 1 | Q6(0) | Q6(0)/pad_in | Q6(0)/fb | 7.644
Route | | 1 | Net_4513 | Q6(0)/fb | D17(0)/pin_input | 2.959
iocell42 | P12[2] | 1 | D17(0) | D17(0)/pin_input | D17(0)/pad_out | 15.666
Route | | 1 | D17(0)_PAD | D17(0)/pad_out | D17(0)_PAD | 0.000
Q7(0)_PAD | D14(0)_PAD | 36.174

Type | Location | Fanout | Instance/Net | Source | Dest | Delay (ns)
Team12_PsoC_benchmark_test | | 1 | Q7(0)_PAD | Q7(0)_PAD | Q7(0)_PAD | 0.000
Route | | 1 | Q7(0)_PAD | Q7(0)_PAD | Q7(0)/pad_in | 0.000
iocell35 | P2[7] | 1 | Q7(0) | Q7(0)/pad_in | Q7(0)/fb | 12.350
Route | | 1 | Net_4512 | Q7(0)/fb | D14(0)/pin_input | 7.969
iocell43 | P12[0] | 1 | D14(0) | D14(0)/pin_input | D14(0)/pad_out | 15.855
Route | | 1 | D14(0)_PAD | D14(0)/pad_out | D14(0)_PAD | 0.000
Q4(0)_PAD | D15(0)_PAD | 31.579

Type | Location | Fanout | Instance/Net | Source | Dest | Delay (ns)
Team12_PsoC_benchmark_test | | 1 | Q4(0)_PAD | Q4(0)_PAD | Q4(0)_PAD | 0.000
Route | | 1 | Q4(0)_PAD | Q4(0)_PAD | Q4(0)/pad_in | 0.000
iocell37 | P1[6] | 1 | Q4(0) | Q4(0)/pad_in | Q4(0)/fb | 7.843
Route | | 1 | Net_4514 | Q4(0)/fb | D15(0)/pin_input | 7.803
iocell44 | P12[1] | 1 | D15(0) | D15(0)/pin_input | D15(0)/pad_out | 15.933
Route | | 1 | D15(0)_PAD | D15(0)/pad_out | D15(0)_PAD | 0.000
Q3(0)_PAD | D12(0)_PAD | 29.710

Type | Location | Fanout | Instance/Net | Source | Dest | Delay (ns)
Team12_PsoC_benchmark_test | | 1 | Q3(0)_PAD | Q3(0)_PAD | Q3(0)_PAD | 0.000
Route | | 1 | Q3(0)_PAD | Q3(0)_PAD | Q3(0)/pad_in | 0.000
iocell38 | P1[7] | 1 | Q3(0) | Q3(0)/pad_in | Q3(0)/fb | 7.089
Route | | 1 | Net_4524 | Q3(0)/fb | D12(0)/pin_input | 7.135
iocell45 | P15[3] | 1 | D12(0) | D12(0)/pin_input | D12(0)/pad_out | 15.486
Route | | 1 | D12(0)_PAD | D12(0)/pad_out | D12(0)_PAD | 0.000

+ Clock To Output Section

+ ClockBlock/dclk_glb_ff_2

Source | Destination | Delay (ns)
\PWM_2:PWMHW\/cmp | M2_IN2(0)_PAD | 33.111

Type | Location | Fanout | Instance/Net | Source | Dest | Delay (ns)
timercell | F(Timer,1) | 1 | \PWM_2:PWMHW\ | \PWM_2:PWMHW\/clock | \PWM_2:PWMHW\/cmp | 1.000
Route | | 1 | Net_2460 | \PWM_2:PWMHW\/cmp | Net_368/main_0 | 7.063
macrocell9 | U(1,1) | 1 | Net_368 | Net_368/main_0 | Net_368/q | 3.350
Route | | 1 | Net_368 | Net_368/q | M2_IN2(0)/pin_input | 6.356
iocell4 | P1[5] | 1 | M2_IN2(0) | M2_IN2(0)/pin_input | M2_IN2(0)/pad_out | 15.342
Route | | 1 | M2_IN2(0)_PAD | M2_IN2(0)/pad_out | M2_IN2(0)_PAD | 0.000
Clock | | | | | Clock path delay | 0.000
\PWM_1:PWMHW\/cmp | M1_IN2(0)_PAD | 31.530

Type | Location | Fanout | Instance/Net | Source | Dest | Delay (ns)
timercell | F(Timer,0) | 1 | \PWM_1:PWMHW\ | \PWM_1:PWMHW\/clock | \PWM_1:PWMHW\/cmp | 1.000
Route | | 1 | Net_2404 | \PWM_1:PWMHW\/cmp | Net_362/main_0 | 6.402
macrocell10 | U(3,0) | 1 | Net_362 | Net_362/main_0 | Net_362/q | 3.350
Route | | 1 | Net_362 | Net_362/q | M1_IN2(0)/pin_input | 5.440
iocell2 | P3[5] | 1 | M1_IN2(0) | M1_IN2(0)/pin_input | M1_IN2(0)/pad_out | 15.338
Route | | 1 | M1_IN2(0)_PAD | M1_IN2(0)/pad_out | M1_IN2(0)_PAD | 0.000
Clock | | | | | Clock path delay | 0.000
\PWM_2:PWMHW\/cmp | M2_IN1(0)_PAD | 25.039

Type | Location | Fanout | Instance/Net | Source | Dest | Delay (ns)
timercell | F(Timer,1) | 1 | \PWM_2:PWMHW\ | \PWM_2:PWMHW\/clock | \PWM_2:PWMHW\/cmp | 1.000
Route | | 1 | Net_2460 | \PWM_2:PWMHW\/cmp | M2_IN1(0)/pin_input | 8.361
iocell3 | P1[4] | 1 | M2_IN1(0) | M2_IN1(0)/pin_input | M2_IN1(0)/pad_out | 15.678
Route | | 1 | M2_IN1(0)_PAD | M2_IN1(0)/pad_out | M2_IN1(0)_PAD | 0.000
Clock | | | | | Clock path delay | 0.000
\PWM_1:PWMHW\/cmp | M1_IN1(0)_PAD | 19.812

Type | Location | Fanout | Instance/Net | Source | Dest | Delay (ns)
timercell | F(Timer,0) | 1 | \PWM_1:PWMHW\ | \PWM_1:PWMHW\/clock | \PWM_1:PWMHW\/cmp | 1.000
Route | | 1 | Net_2404 | \PWM_1:PWMHW\/cmp | M1_IN1(0)/pin_input | 3.825
iocell1 | P3[4] | 1 | M1_IN1(0) | M1_IN1(0)/pin_input | M1_IN1(0)/pad_out | 14.987
Route | | 1 | M1_IN1(0)_PAD | M1_IN1(0)/pad_out | M1_IN1(0)_PAD | 0.000
Clock | | | | | Clock path delay | 0.000

+ ClockBlock/dclk_glb_ff_5

Source | Destination | Delay (ns)
\Quad_TImer:TimerHW\/tc | TestPin(0)_PAD | 19.471

Type | Location | Fanout | Instance/Net | Source | Dest | Delay (ns)
timercell | F(Timer,2) | 1 | \Quad_TImer:TimerHW\ | \Quad_TImer:TimerHW\/clock | \Quad_TImer:TimerHW\/tc | 1.000
Route | | 1 | Net_4516 | \Quad_TImer:TimerHW\/tc | TestPin(0)/pin_input | 3.012
iocell29 | P0[2] | 1 | TestPin(0) | TestPin(0)/pin_input | TestPin(0)/pad_out | 15.459
Route | | 1 | TestPin(0)_PAD | TestPin(0)/pad_out | TestPin(0)_PAD | 0.000
Clock | | | | | Clock path delay | 0.000

+ CyBUS_CLK

Source | Destination | Delay (ns)
\CONTROL:Sync:ctrl_reg\/control_1 | M2_D1(0)_PAD | 23.898

Type | Location | Fanout | Instance/Net | Source | Dest | Delay (ns)
controlcell4 | U(1,0) | 1 | \CONTROL:Sync:ctrl_reg\ | \CONTROL:Sync:ctrl_reg\/busclk | \CONTROL:Sync:ctrl_reg\/control_1 | 2.050
Route | | 1 | Net_3236 | \CONTROL:Sync:ctrl_reg\/control_1 | M2_D1(0)/pin_input | 6.378
iocell5 | P1[2] | 1 | M2_D1(0) | M2_D1(0)/pin_input | M2_D1(0)/pad_out | 15.470
Route | | 1 | M2_D1(0)_PAD | M2_D1(0)/pad_out | M2_D1(0)_PAD | 0.000
Clock | | | | | Clock path delay | 0.000
\CONTROL:Sync:ctrl_reg\/control_0 | M1_D1(0)_PAD | 23.503

Type | Location | Fanout | Instance/Net | Source | Dest | Delay (ns)
controlcell4 | U(1,0) | 1 | \CONTROL:Sync:ctrl_reg\ | \CONTROL:Sync:ctrl_reg\/busclk | \CONTROL:Sync:ctrl_reg\/control_0 | 2.050
Route | | 1 | Net_1832 | \CONTROL:Sync:ctrl_reg\/control_0 | M1_D1(0)/pin_input | 6.862
iocell20 | P3[3] | 1 | M1_D1(0) | M1_D1(0)/pin_input | M1_D1(0)/pad_out | 14.591
Route | | 1 | M1_D1(0)_PAD | M1_D1(0)/pad_out | M1_D1(0)_PAD | 0.000
Clock | | | | | Clock path delay | 0.000

+ UART_IntClock

Source | Destination | Delay (ns)
\UART:BUART:txn\/q | Tx_1(0)_PAD | 31.383

Type | Location | Fanout | Instance/Net | Source | Dest | Delay (ns)
macrocell147 | U(1,4) | 1 | \UART:BUART:txn\ | \UART:BUART:txn\/clock_0 | \UART:BUART:txn\/q | 1.250
Route | | 1 | \UART:BUART:txn\ | \UART:BUART:txn\/q | Net_1880/main_0 | 3.959
macrocell20 | U(1,2) | 1 | Net_1880 | Net_1880/main_0 | Net_1880/q | 3.350
Route | | 1 | Net_1880 | Net_1880/q | Tx_1(0)/pin_input | 7.387
iocell22 | P2[3] | 1 | Tx_1(0) | Tx_1(0)/pin_input | Tx_1(0)/pad_out | 15.437
Route | | 1 | Tx_1(0)_PAD | Tx_1(0)/pad_out | Tx_1(0)_PAD | 0.000
Clock | | | | | Clock path delay | 0.000

+ Asynchronous Constraints

+ Recovery

+ Source Clock : Clock_QENC : Positive edge(Required Frequency 12 MHz)

+ Destination Clock : Clock_QENC : Positive edge(Required Frequency 12 MHz)

Path Delay Requirement : 83.3333ns(12 MHz)

Source | Destination | FMax | Delay (ns) | Slack (ns) | Violation
\QuadDec_M1:Net_1260\/q | \QuadDec_M1:Cnt16:CounterUDB:sSTSReg:stsreg\/reset | 80.483 MHz | 12.425 | 70.908

Type | Location | Fanout | Instance/Net | Source | Dest | Delay (ns)
macrocell51 | U(0,0) | 1 | \QuadDec_M1:Net_1260\ | \QuadDec_M1:Net_1260\/clock_0 | \QuadDec_M1:Net_1260\/q | 1.250
Route | | 1 | \QuadDec_M1:Net_1260\ | \QuadDec_M1:Net_1260\/q | \QuadDec_M1:Cnt16:CounterUDB:sSTSReg:stsreg\/reset | 11.175
statusicell1 | U(3,0) | 1 | \QuadDec_M1:Cnt16:CounterUDB:sSTSReg:stsreg\ | | RECOVERY | -0.000
Clock | | | | | Skew | 0.000
\QuadDec_M2:Net_1260\/q | \QuadDec_M2:Cnt16:CounterUDB:sSTSReg:stsreg\/reset | 129.066 MHz | 7.748 | 75.585

Type | Location | Fanout | Instance/Net | Source | Dest | Delay (ns)
macrocell65 | U(3,4) | 1 | \QuadDec_M2:Net_1260\ | \QuadDec_M2:Net_1260\/clock_0 | \QuadDec_M2:Net_1260\/q | 1.250
Route | | 1 | \QuadDec_M2:Net_1260\ | \QuadDec_M2:Net_1260\/q | \QuadDec_M2:Cnt16:CounterUDB:sSTSReg:stsreg\/reset | 6.498
statusicell3 | U(3,5) | 1 | \QuadDec_M2:Cnt16:CounterUDB:sSTSReg:stsreg\ | | RECOVERY | -0.000
Clock | | | | | Skew | 0.000

+ Removal

+ Source Clock : Clock_QENC : Positive edge

+ Destination Clock : Clock_QENC : Positive edge

Source | Destination | Slack (ns) | Violation
\QuadDec_M2:Net_1260\/q | \QuadDec_M2:Cnt16:CounterUDB:sSTSReg:stsreg\/reset | 7.748

Type | Location | Fanout | Instance/Net | Source | Dest | Delay (ns)
macrocell65 | U(3,4) | 1 | \QuadDec_M2:Net_1260\ | \QuadDec_M2:Net_1260\/clock_0 | \QuadDec_M2:Net_1260\/q | 1.250
Route | | 1 | \QuadDec_M2:Net_1260\ | \QuadDec_M2:Net_1260\/q | \QuadDec_M2:Cnt16:CounterUDB:sSTSReg:stsreg\/reset | 6.498
statusicell3 | U(3,5) | 1 | \QuadDec_M2:Cnt16:CounterUDB:sSTSReg:stsreg\ | | REMOVAL | 0.000
Clock | | | | | Skew | 0.000
\QuadDec_M1:Net_1260\/q | \QuadDec_M1:Cnt16:CounterUDB:sSTSReg:stsreg\/reset | 12.425

Type | Location | Fanout | Instance/Net | Source | Dest | Delay (ns)
macrocell51 | U(0,0) | 1 | \QuadDec_M1:Net_1260\ | \QuadDec_M1:Net_1260\/clock_0 | \QuadDec_M1:Net_1260\/q | 1.250
Route | | 1 | \QuadDec_M1:Net_1260\ | \QuadDec_M1:Net_1260\/q | \QuadDec_M1:Cnt16:CounterUDB:sSTSReg:stsreg\/reset | 11.175
statusicell1 | U(3,0) | 1 | \QuadDec_M1:Cnt16:CounterUDB:sSTSReg:stsreg\ | | REMOVAL | 0.000
Clock | | | | | Skew | 0.000
