rsef899/12_Cypress_LineFollowingRobot/Janith/PSOC/lab3.cydsn/ARM_GCC_541/Debug/LINK_options.txt

-Wl,--start-group -o "H:\\Documents\\12_Cypress_LineFollowingRobot\\Janith\\PSOC\\lab3.cydsn\\ARM_GCC_541\\Debug\\lab3.elf" ".\\ARM_GCC_541\\Debug\\main.o" ".\\ARM_GCC_541\\Debug\\cyfitter_cfg.o" ".\\ARM_GCC_541\\Debug\\cymetadata.o" ".\\ARM_GCC_541\\Debug\\Cm3Start.o" ".\\ARM_GCC_541\\Debug\\lab3.a" "C:\\Program\ Files\ (x86)\\Cypress\\PSoC\ Creator\\4.2\\PSoC\ Creator\\psoc\\content\\cycomponentlibrary\\CyComponentLibrary.cylib\\CortexM3\\ARM_GCC_541\\Debug\\CyComponentLibrary.a" -mcpu=cortex-m3 -mthumb -L "Generated_Source\\PSoC5" "-Wl,-Map,.\\ARM_GCC_541\\Debug/lab3.map" -T "Generated_Source\\PSoC5\\cm3gcc.ld" -specs=nano.specs -Wl,--gc-sections -g -ffunction-sections -Og -ffat-lto-objects -Wl,--end-group
