rsef899/12_Cypress_LineFollowingRobot/Janith/PCB/Altium/Group_12_301_Project.pdf

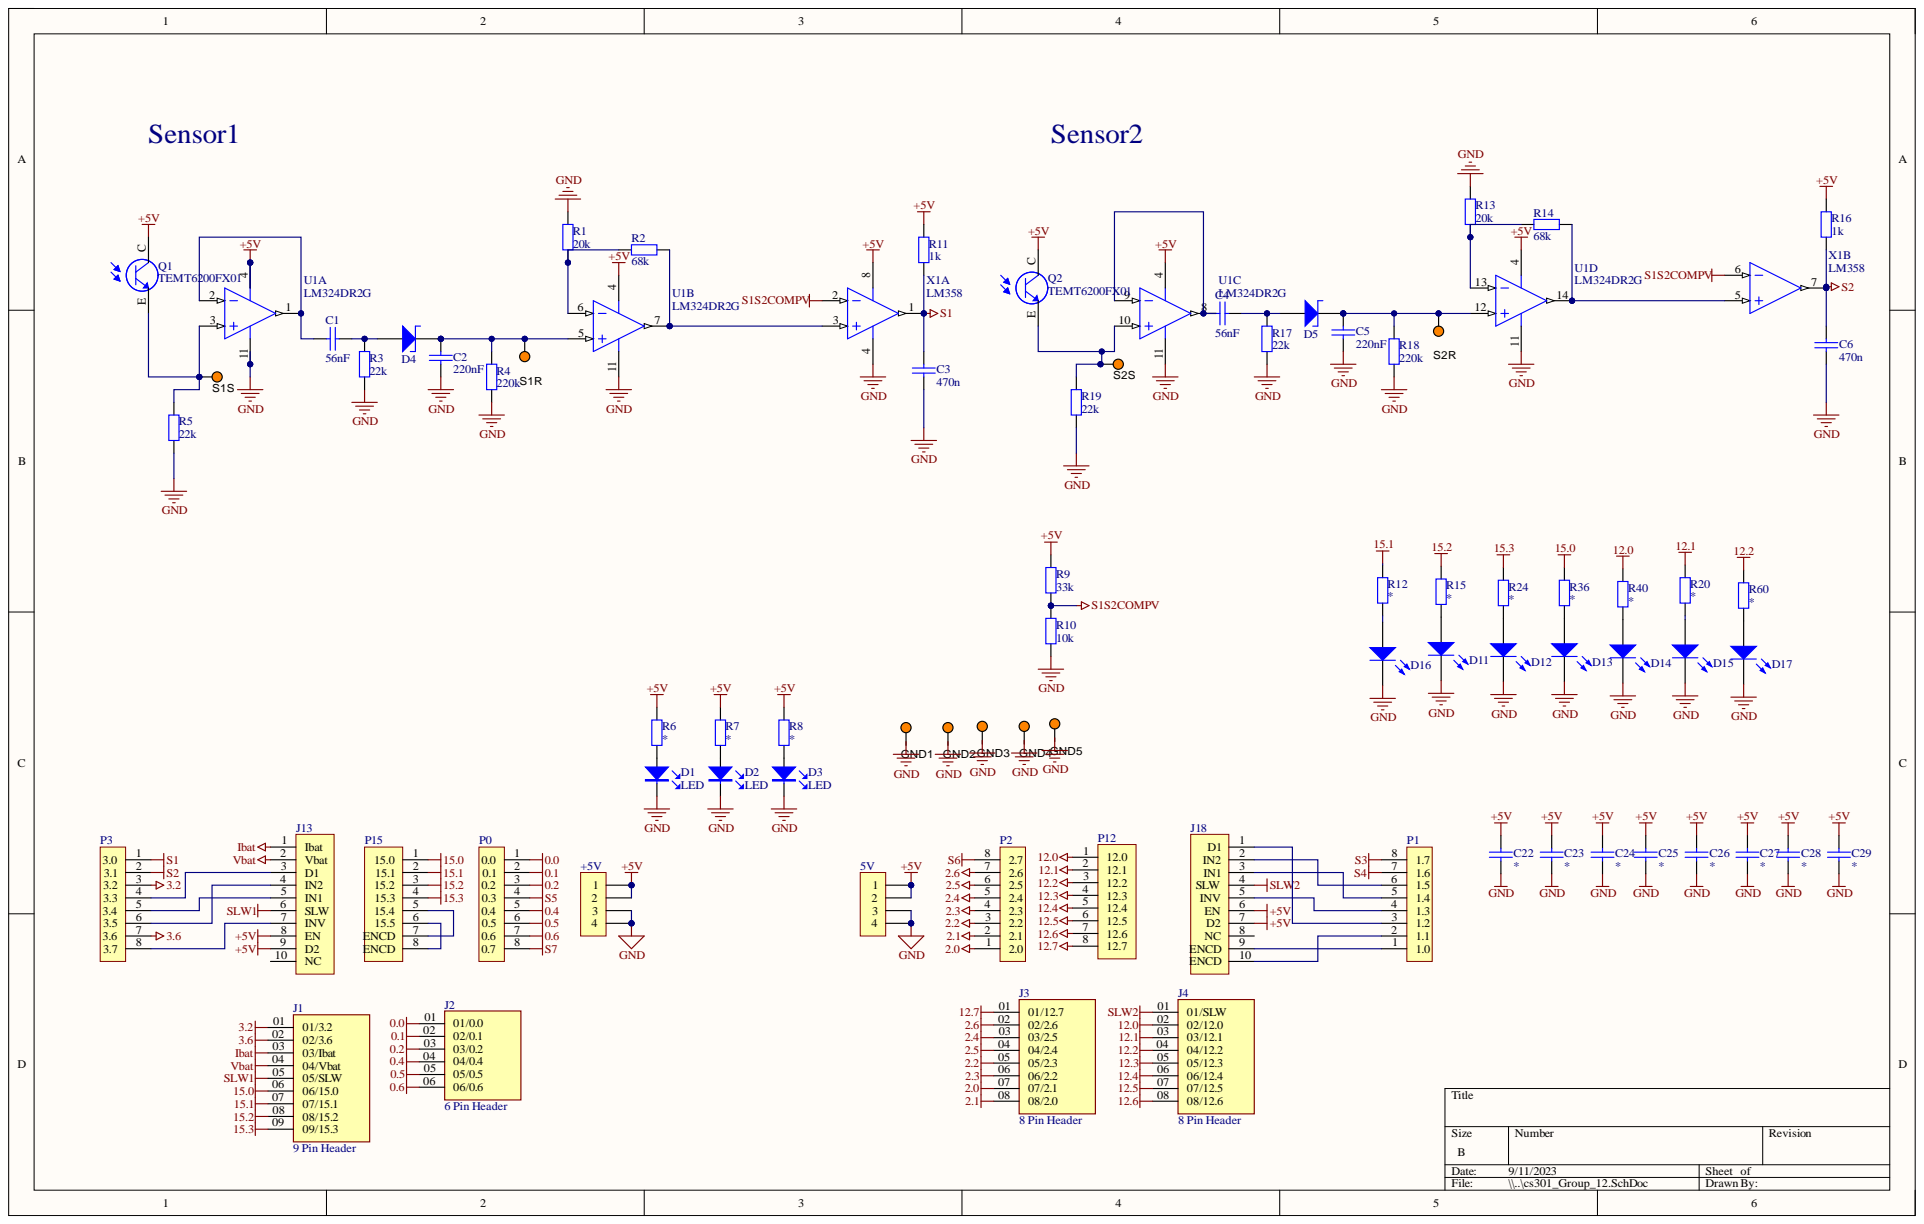
[picture p18: page 1]

Size B | Number | Revision

Date: 9/11/2023 | Sheet of
File: \\..\cs301_Group_12.SchDoc | Drawn By:

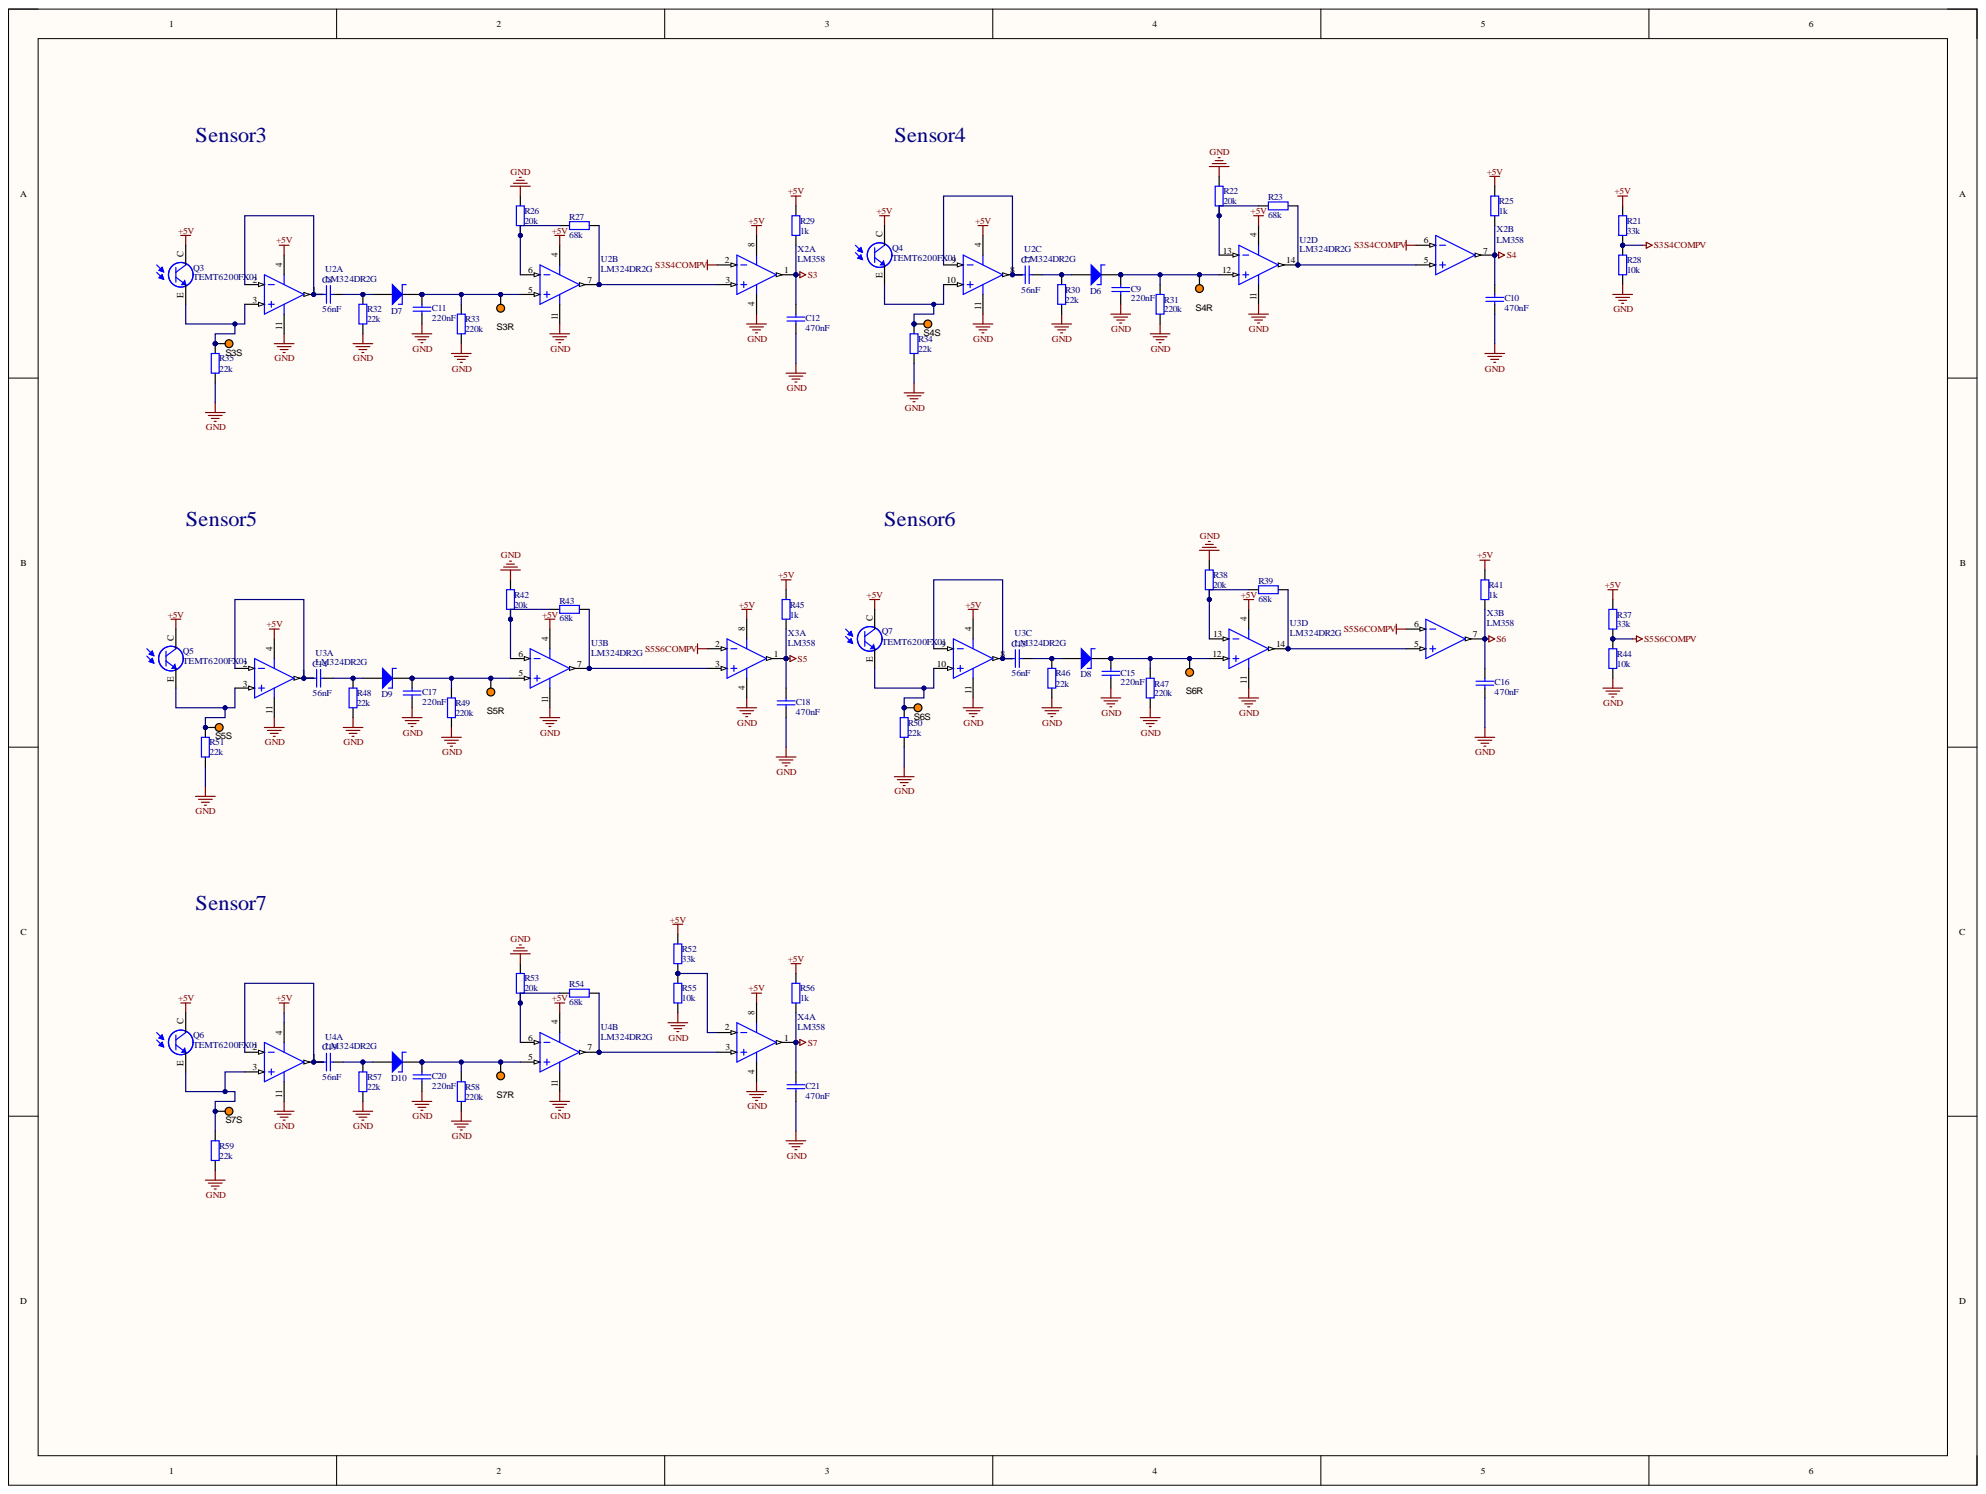
[picture p19: page 2]

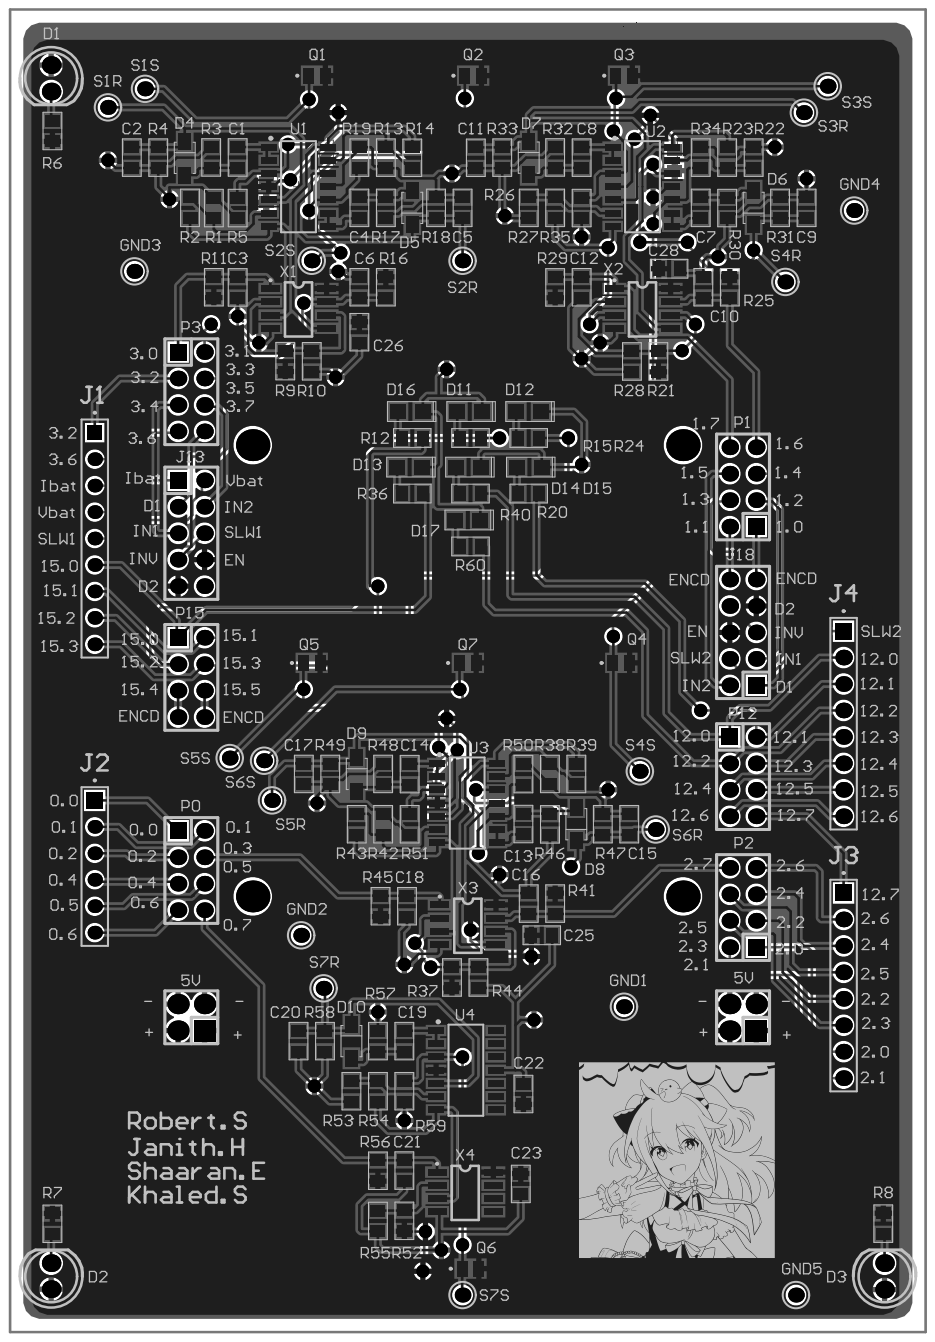
[picture p20: page 3]
