rsef899/12_Cypress_LineFollowingRobot/Janith/PCB/Altium/pog.pdf

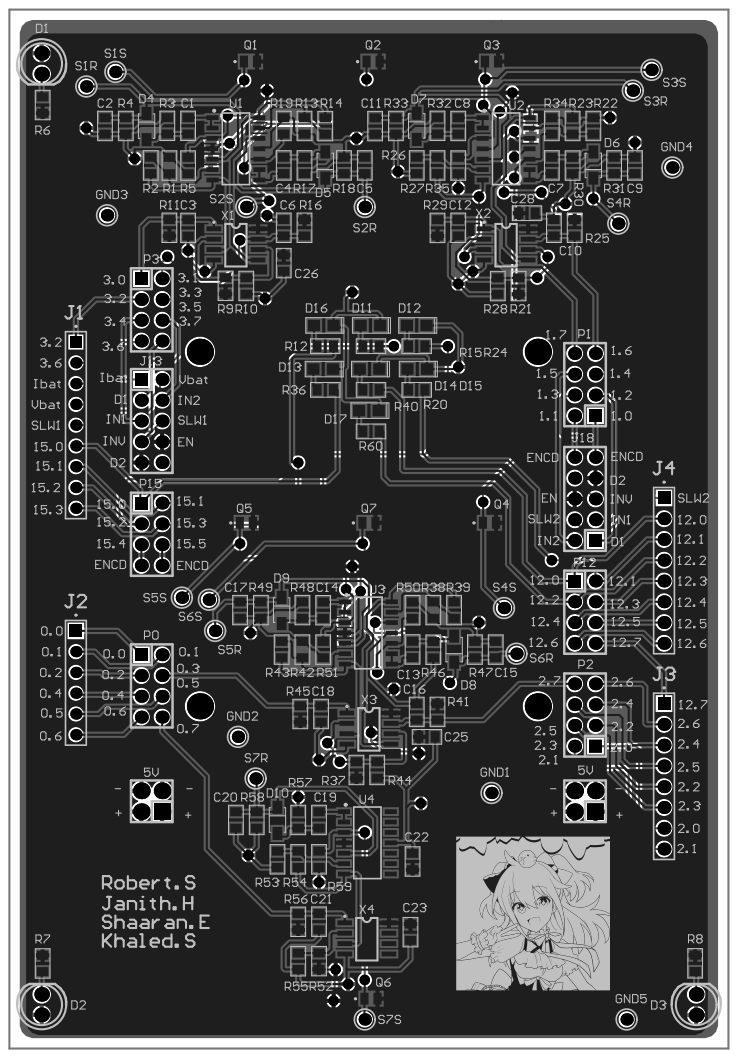
[picture p21: page 1]
