rsef899/12_Cypress_LineFollowingRobot/Hardware Tasks/Task1Schematic.asc

C1: cap; 330n
R1: res; {RA}
R2: res; {RA}
R3: res; 470
V2: voltage; PULSE(0 5 0 0.1n 0.1n 0.5m 1m)
V3: voltage; SINE(2.5 2.5 10000)
Named nets: 0, vmeasure, vfg, vfg2
.param RA=1k
.tran 1.5ms
;.ac dec 100 1 10k
