rsef899/12_Cypress_LineFollowingRobot/(list of files, drawings)

Other design files:
Altium/cs301_Group_12.SchDoc
Altium/cs301_YourGroupNumber--4 holes.PcbDoc
Altium/Group_12_301_Project.PrjPcb
Altium/Sensors.SchDoc
Janith/PCB/Altium/cs301_Group-12-4 holes.PcbDoc
Janith/PCB/Altium/cs301_Group_12.SchDoc
Janith/PCB/Altium/Group_12_301_Project.PrjPcb
Janith/PCB/Altium/Sensors.SchDoc
Janith/PCB/cs301_Group_12.SchDoc
student_pack/psoc student pack/altium/template/cs301_YourGroupNumber--4 holes.PcbDoc
student_pack/psoc student pack/altium/template/cs301_YourGroupNumber---------------.SchDoc
