rsef899/12_Cypress_LineFollowingRobot/Robert/Hardware_Task1.cydsn/main.c

/* ========================================
 * Fully working code: 
 * PWM      : 
 * Encoder  : 
 * ADC      :
 * USB      : port displays speed and position.
 * CMD: "PW xx"
 * Copyright Univ of Auckland, 2016
 * All Rights Reserved
 * UNPUBLISHED, LICENSED SOFTWARE.
 *
 * CONFIDENTIAL AND PROPRIETARY INFORMATION
 * WHICH IS THE PROPERTY OF Univ of Auckland.
 *
 * ========================================
*/
#include <stdio.h>
#include <string.h>
#include <stdlib.h>
#include <project.h>
//* ========================================
#include "defines.h"
#include "vars.h"
//* ========================================
void usbPutString(char *s);
void usbPutChar(char c);
void handle_usb();
//* ========================================
void changeDutyCycle(char* dutyValue);

volatile uint8_t printFlag = 0;
volatile uint16_t buffer[1024];
volatile uint16_t bufferIndex = 0;

//define teh TImer Interuprt
CY_ISR(ADCInterupt){
    //if we are printing pdmt store ADC values
    if(printFlag == 1) return;
    uint16_t ADCReturn = ADC_GetResult16((uint16_t)0);
    //add the result to the buffer
    buffer[bufferIndex++] = ADC_CountsTo_mVolts(ADCReturn);
    //when the buffer is full set the prin flag, start the buffer aggain
    if(bufferIndex == 1024) {
        printFlag = 1;
        bufferIndex = 0;
    }
}


int main(){
    

// --------------------------------    
// ----- INITIALIZATIONS ----------
    CYGlobalIntEnable;

    USBUART_Start(0,USBUART_5V_OPERATION);
    //Default message to see if terminal connection is working
    
    
    //Start the timer and initialise its interupt
    Timer_TS_Start();
    //initialise the ADC timer
    isr_eoc_StartEx(ADCInterupt);
    
    ADC_Start();
    VDAC8_Start();
    
    uint16_t bufferFollow = 1;
    
    for(;;)
    {
        //print the data
        if (printFlag == 1){
            usbPutString("---------------------Sample Start-------------------------------");
            for(uint16_t i = 0; i < 1024; i++) {
                char numBuffer[6];
                
                //COnvert the value in the buffer to a string
                itoa(buffer[i], numBuffer, 10);
                numBuffer[5] = '\0';
                //print the value
                usbPutString(numBuffer);
                usbPutString("\n\r");
            }
            usbPutString("\r\n");
            printFlag = 0;
            bufferFollow = 1;
        } 
          //This will run after the adc takes one sample, **not filing one buffer
        else if (bufferFollow != bufferIndex){
            // Set DAC value
            // (1/16 = Numb bits / total voltage resolution)
            VDAC8_SetValue((buffer[bufferIndex - 1])/16);
            //Sample has been taken, also sample has been converted back, so wait for next conversion
            bufferFollow = bufferIndex;
        }
    }  
}//End main

//* ========================================
void usbPutString(char *s)
{
// !! Assumes that *s is a string with allocated space >=64 chars     
//  Since USB implementation retricts data packets to 64 chars, this function truncates the
//  length to 62 char (63rd char is a '!')

#ifdef USE_USB     
    while (USBUART_CDCIsReady() == 0);
    s[63]='\0';
    s[62]='!';
    USBUART_PutData((uint8*)s,strlen(s));
#endif
}
//* ========================================
void usbPutChar(char c)
{
#ifdef USE_USB     
    while (USBUART_CDCIsReady() == 0);
    USBUART_PutChar(c);
#endif    
}
/* [] END OF FILE */
