rsef899/12_Cypress_LineFollowingRobot/Final_implementation/Team12_PsoC_FinalImplementation.cydsn/states.h

/* ========================================
 *
 * Copyright YOUR COMPANY, THE YEAR
 * All Rights Reserved
 * UNPUBLISHED, LICENSED SOFTWARE.
 *
 * CONFIDENTIAL AND PROPRIETARY INFORMATION
 * WHICH IS THE PROPERTY OF your company.
 *
 * ========================================
*/

#include <project.h>

#ifndef STATES_H
#define STATES_H
    
    extern uint8_t currentState;
 
    #define MODESELECT 0
    #define FREERUNNING 1
    #define SHORTESTMODE 2
    #define CALIBRATING 3
    #define DRIVING 4
    #define TURNING 5
    #define STOPCAR 10
    #define PREPARETURN 6
    #define DIST_DRIVE 7
    
#endif

/* [] END OF FILE */
