rsef899/12_Cypress_LineFollowingRobot/Janith/PSOC/lab2.cydsn/main.c

/* ========================================
 * Laboratory Exercise 2
 *
 * Program timer to flash LED at 1Hz, i.e. 0.5s ON and 0.5s sec OFF
 *
 * Copyright Univ of Auckland, 2016
 * All Rights Reserved
 * UNPUBLISHED, LICENSED SOFTWARE.
 *
 * CONFIDENTIAL AND PROPRIETARY INFORMATION
 * WHICH IS THE PROPERTY OF Univ of Auckland.
 *
 * ========================================
*/
#include <project.h>

int main()
{
    CyGlobalIntEnable; /* Enable global interrupts. */
    
    Timer_1_Start();

    /* Place your initialization/startup code here (e.g. MyInst_Start()) */
    for(;;)
    {
        /* Place your application code here. */
        
        
    }
}

/* [] END OF FILE */
