rsef899/12_Cypress_LineFollowingRobot/Final_implementation/Team12_PsoC_FinalImplementation.cydsn/codegentemp/Sensor_isr.h

/*******************************************************************************
* File Name: Sensor_isr.h
* Version 1.71
*
*  Description:
*   Provides the function definitions for the Interrupt Controller.
*
*
********************************************************************************
* Copyright 2008-2015, Cypress Semiconductor Corporation.  All rights reserved.
* You may use this file only in accordance with the license, terms, conditions, 
* disclaimers, and limitations in the end user license agreement accompanying 
* the software package with which this file was provided.
*******************************************************************************/
#if !defined(CY_ISR_Sensor_isr_H)
#define CY_ISR_Sensor_isr_H


#include <cytypes.h>
#include <cyfitter.h>

/* Interrupt Controller API. */
void Sensor_isr_Start(void);
void Sensor_isr_StartEx(cyisraddress address);
void Sensor_isr_Stop(void);

CY_ISR_PROTO(Sensor_isr_Interrupt);

void Sensor_isr_SetVector(cyisraddress address);
cyisraddress Sensor_isr_GetVector(void);

void Sensor_isr_SetPriority(uint8 priority);
uint8 Sensor_isr_GetPriority(void);

void Sensor_isr_Enable(void);
uint8 Sensor_isr_GetState(void);
void Sensor_isr_Disable(void);

void Sensor_isr_SetPending(void);
void Sensor_isr_ClearPending(void);


/* Interrupt Controller Constants */

/* Address of the INTC.VECT[x] register that contains the Address of the Sensor_isr ISR. */
#define Sensor_isr_INTC_VECTOR            ((reg32 *) Sensor_isr__INTC_VECT)

/* Address of the Sensor_isr ISR priority. */
#define Sensor_isr_INTC_PRIOR             ((reg8 *) Sensor_isr__INTC_PRIOR_REG)

/* Priority of the Sensor_isr interrupt. */
#define Sensor_isr_INTC_PRIOR_NUMBER      Sensor_isr__INTC_PRIOR_NUM

/* Address of the INTC.SET_EN[x] byte to bit enable Sensor_isr interrupt. */
#define Sensor_isr_INTC_SET_EN            ((reg32 *) Sensor_isr__INTC_SET_EN_REG)

/* Address of the INTC.CLR_EN[x] register to bit clear the Sensor_isr interrupt. */
#define Sensor_isr_INTC_CLR_EN            ((reg32 *) Sensor_isr__INTC_CLR_EN_REG)

/* Address of the INTC.SET_PD[x] register to set the Sensor_isr interrupt state to pending. */
#define Sensor_isr_INTC_SET_PD            ((reg32 *) Sensor_isr__INTC_SET_PD_REG)

/* Address of the INTC.CLR_PD[x] register to clear the Sensor_isr interrupt. */
#define Sensor_isr_INTC_CLR_PD            ((reg32 *) Sensor_isr__INTC_CLR_PD_REG)


#endif /* CY_ISR_Sensor_isr_H */


/* [] END OF FILE */
