rsef899/12_Cypress_LineFollowingRobot/Shaaran/DFS Maze/defs.h

#ifndef _MAP_H
#define _MAP_H

#include <stddef.h>
#include <stdint.h>

#define MAX_PATH_SIZE 128
#define MAP_WIDTH 19
#define MAP_HEIGHT 15
#define UPTURN    0
#define DOWNTURN  1
#define LEFTTURN  2
#define RIGHTTURN 3

typedef struct Point {
  uint8_t x, y,direction;
} Point;

typedef struct Stack {
  uint8_t top, cap;
  Point *array;
} Stack;
#endif // _MAP_H
