rsef899/12_Cypress_LineFollowingRobot/(commit log)

2023-07-26 Added the team student pack
    [CS301_Class.sdf, Meeting Log.xlsx, cs301_YourGroupNumber---------------.SchDoc, cs301_YourGroupNumber--4 holes.PcbDoc, lab1.sdf, lab2.sdf, lab3.sdf]
2023-07-28 Added Lab 1 ADC, Robert
    [CS301_Class_Copy_01.sdf]
2023-08-02 Working ADC, sampling at 50us
    [CS301_Class_Copy_01.sdf]
2023-08-02 update(DAC functionality): Implemented the DAC functionality, note that the UART code should be commented out to see a cleaner output
    [CS301_Class_Copy_01.sdf]
2023-08-04 blew fuse, connected pins and code to run motor on high
    [CS301_Class_Copy_01.sdf, Hardware_Task1.sdf]
2023-08-11 added hardware task 2 to folder
    [CS301_Class.sdf, CS301_Class_Copy_01.sdf, HardwareTask2Project.sdf, lab1.sdf]
2023-08-11 hardware task 2 start, TODO: uart usb not working
    [HardwareTask2Project.sdf, Hardware_Task2.sdf]
2023-08-15 PWM is working
    [Hardware_Task2.sdf]
2023-08-23 Altium Changes
    [cs301_YourGroupNumber---------------.SchDoc]
2023-08-23 Altium Project Added
    [cs301_Group_12.SchDoc]
2023-08-24 Created personal folder, imported psoc_intro workspace and created a project for circuit demo
    [CS301_Class.sdf, lab1.sdf, lab2.sdf, lab3.sdf]
2023-08-24 Implemented schematic and code for detecting pulses and toggling leds
    [CS301_Class.sdf, circuit_demo.sdf, lab1.sdf, lab2.sdf, lab3.sdf]
2023-08-25 Code for circuit demo
    [circuit_demo.sdf]
2023-08-25 Fixed Sensors
    [Group_12_301_Project.PrjPcb]
2023-08-26 changed pin layouts
    [Hardware_Task2.sdf]
2023-08-26 initial code for quad encoder
    [Hardware_Task2.sdf]
2023-08-26 INV pin change + test port
    [Hardware_Task2.sdf]
2023-08-26 Updated pins for demo code
    [circuit_demo.sdf]
2023-08-26 File Fixes
    [Group_12_301_Project.PrjPcb, Sensors.SchDoc, cs301_Group_12.SchDoc, cs301_YourGroupNumber--4 holes.PcbDoc]
2023-08-26 Routed components on PCB
    [Group_12_301_Project.PrjPcb, Sensors.SchDoc, cs301_Group-12-4 holes.PcbDoc, cs301_Group_12.SchDoc]
2023-08-27 Routed mapped IO pins
    [Sensors.SchDoc, cs301_Group-12-4 holes.PcbDoc, cs301_Group_12.SchDoc]
2023-08-27 Reworked PCB with vias
    [cs301_Group-12-4 holes.PcbDoc, cs301_Group_12.SchDoc]
2023-08-27 Added Sensor LEDS to PCB
    [Group_12_301_Project.PrjPcb, Sensors.SchDoc, cs301_Group-12-4 holes.PcbDoc, cs301_Group_12.SchDoc]
2023-08-27 PCB with no design violations
    [cs301_Group-12-4 holes.PcbDoc]
2023-08-28 Added decoupling capacitors
    [cs301_Group_12.SchDoc]
2023-09-06 Added component values
    [Sensors.SchDoc, cs301_Group_12.SchDoc]
2023-09-11 added movement header file and some comon macros
    [Team12_PsoC_final.sdf]
2023-09-12 initial statemanchien inplementation: Should drive when started
    [Team12_PsoC_final.sdf]
2023-09-13 added turning functionality
    [Hardware_Task2.sdf, Team12_PsoC_final.sdf]
2023-09-17 Added sensor + motor testing code
    [sensor_motor_demo.sdf]
2023-09-18 leds added
    [Team12_PsoC_final.sdf]
2023-09-18 line correction working
    [Team12_PsoC_benchmark_test.sdf]
2023-09-18 ERROR: not going straight
    [Team12_PsoC_final.sdf]
2023-09-19 made quad encoder stuff
    [CS301_Class.sdf, Hardware_Task2.sdf, sensor_motor_demo.sdf]
2023-09-19 Line following and stopping ocrrect: TODO: readjsut difference between the two motors
    [Group_12_301_Project.PrjPcb, Team12_PsoC_benchmark_test.sdf, cs301_Group_12.SchDoc]
2023-09-20 Finished the quad encoder stuff
    [CS301_Class.sdf, Hardware_Task2.sdf, circuit_demo.sdf, lab1.sdf, lab2.sdf, lab3.sdf, sensor_motor_demo.sdf]
2023-09-25 Fixed turning for demo
    [Team12_PsoC_benchmark_test.sdf]
2023-10-03 Working state machine with Calibration and drving only
    [Team12_PsoC_FinalImplementation.sdf]
2023-10-04 Changed code to measure distance as it moves
    [Hardware_Task2.sdf]
2023-10-11 fixed up .gitignore
    [CS301_Class.sdf, CS301_Class_Copy_01.sdf, Group_12_301_Project.PrjPcb, Hardware_Task1.sdf, Hardware_Task2.sdf, Team12_PsoC_FinalImplementation.sdf, Team12_PsoC_benchmark_test.sdf, Team12_PsoC_final.sdf]
